Cadburies/SisuAssistant/MarineBoard/PCBWay Requirements.png

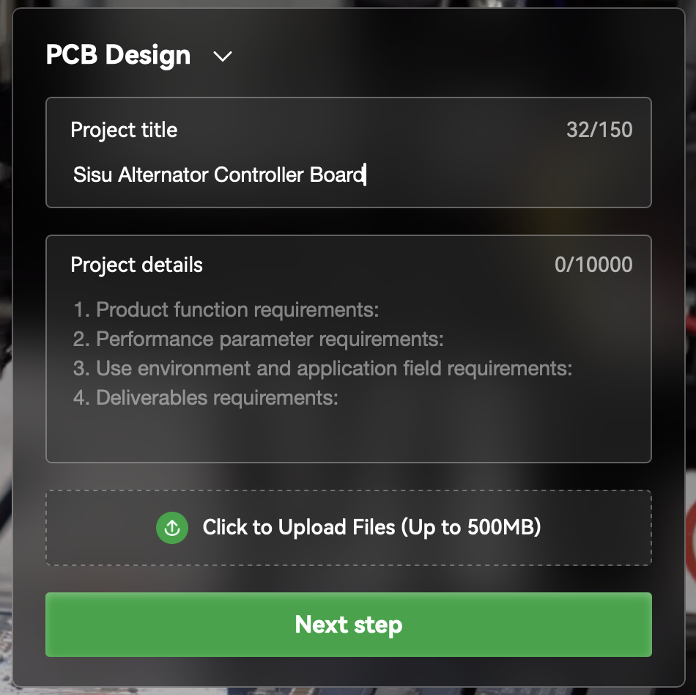
MarineBoard/PCBWay Requirements.png
