Cadburies/SisuAssistant/MarineBoard/Documentation/Freezer/Freezer Model.jpeg

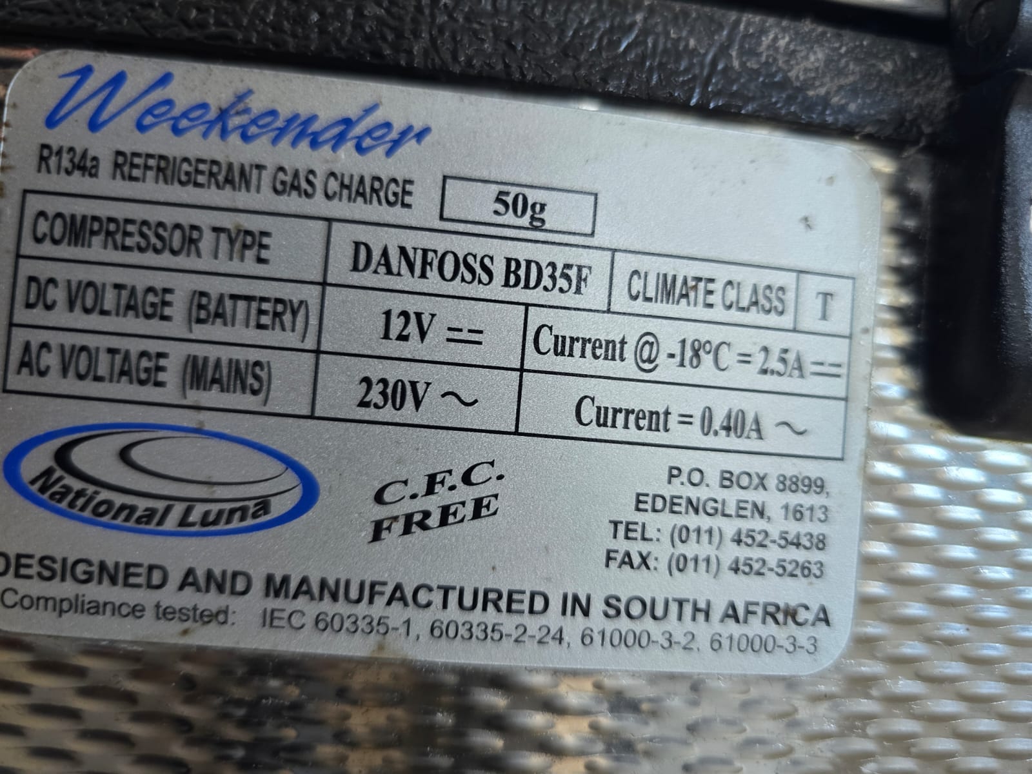
MarineBoard/Documentation/Freezer/Freezer Model.jpeg
