Cadburies/SisuAssistant/sisu-nav/web/src/plugins/ensemble/README.md

# Ensemble plugin — issue #91

ECMWF IFS ENS spaghetti (`ens-ecmwf`) from Open-Meteo Ensemble API, `cell_selection=sea`. Glob-loaded (`slot: panel`). Visibility is the Layers button. Do not edit `App.tsx`.

Clustered default = control + 10 members; Deep = all 51. `ens-aifs` / `ens-gefs` stay grey until #92 / #93.

Internet weather (tier 4), not a twin of instrument TWD.
