Cadburies/SisuAssistant/sisu-nav/web/src/plugins/weather/README.md

# Weather plugin — issue #77

Multi-model Open-Meteo overlay + agreement heatmap. Glob-loaded (`slot: panel`). Visibility is the #85 Layers button (`wx-wind` / `wx-discrepancy` / `wx-particles`). Do not edit `App.tsx`.

Instrument TWD/TWS stay on the windex. This overlay is internet weather (source tier 4).
