Cadburies/SisuAssistant/sisu-nav/web/src/plugins/route/README.md

# Route plugin — issue #78

Isochrone routing with three named modes (ETA / multi-model agreement / ensemble agreement). Glob-loaded (`slot: panel`). Do not edit `App.tsx`.

API: `sisu-nav/api/route`. Polar: `sisu-nav/polar/`. Advisory only.
