Cadburies/SisuAssistant/Technical Specifications.md

# Sisu Marine Automation System — Technical Specifications

**Version:** 2.23  
**Date:** November 2026  
**Status:** Marine Board + HA Green + TerraMaster F8 (live, #6) + Wi‑Fi 7 topology; Sisu Nav at `:8088`, Follow me on `:8443` (#188)  

Vessel **Sisu**: electrical management (dual alternators), tank levels, freezer control, helm N2K instruments, and marine data aggregation via Home Assistant, MQTT, and Signal K.

For fast-changing implementation detail (control-loop constants, current entity list, live setpoints) this file points at the source of truth rather than re-describing it — the source file is authoritative if the two ever disagree.

| Document | Authority |
|---|---|
| **[`NETWORK.md`](NETWORK.md)** | **GL.iNet GL-BE9300** actions, SSIDs, HA Green, F8, routing, secrets, Grafana, helm |
| **[`MarineBoard/`](MarineBoard/)** folder — **[`Technical Specs.md`](MarineBoard/Technical%20Specs.md)** | PCB GPIO, power, connectors; KiCad hardware project |
| **[`MarineBoard/Documentation/Freezer-Replacement-Plan.md`](MarineBoard/Documentation/Freezer-Replacement-Plan.md)** | Weekender freezer: Danfoss 101N0500 stays, Marine Board replaces the failed panel. Firmware #221 is full speed or stop. Eco is later hardware |
| **[`.ai_context/naming.md`](.ai_context/naming.md)** | Entity / SK / N2K naming |
| **[`.ai_context/safety.md`](.ai_context/safety.md)** | Live hard fail-safes, cascaded control loop description, current soft-default table |
| **This file** | System roles, firmware, safety, functional integration |

---

## 1. System Overview

```
Phones on SSID "Sisu" (Wi‑Fi 7)
        │  browser → HA (no need to join Sisu-IoT)
        ▼
┌──────────────────┐   Ethernet    ┌─────────────────────────┐
│ HA Green         │◄─────────────►│ TerraMaster F8 SSD Plus │
│ 192.168.0.20     │               │ 192.168.0.21            │
│ Home Assistant   │               │ Signal K · Grafana      │
│ MQTT kernel      │               │ InfluxDB                │
└────────┬─────────┘               └────────────┬────────────┘
         │ API → 192.168.10.0/24                │ MQTT subscribe
         ▼                                      ▼
┌──────────────────┐                    SK / KIP / trends
│ ESP32 Sisu-IoT   │
│ .41 alt port     │── N2K ──► Raymarine · Veratron OL43 (helm)
│ .42 alt stbd     │
│ .43 levels       │
│ .44 freezer      │
│ .47 freezer disp │
└──────────────────┘
```

F8 commissioned and live (2026-09-16, #6) — Signal K / Grafana / Influx run there (`OPS.md` §7). MQTT kernel stays on HA Green (`core_mosquitto` + `logins:`).

| Function | Hardware | Firmware / notes |
|---|---|---|
| Alternator Port / Starboard | **Sisu Marine Board** (ESP32-S3-WROOM-2-N32R16V) | `alternatorport.yaml` / `alternatorstarboard.yaml` + packages |
| Fresh water levels | **Sisu Marine Board** | `waterlevels.yaml` (INA226 + house VBus) |
| Freezer / fridge | **Marine Board** v1.9.1 (control, pending; manual until fitted) + **LilyGo S3 AMOLED** (display) | `freezer_marineboard.yaml` + `freezer_display.yaml` |
| Home automation + MQTT kernel | **Home Assistant Green** (Ethernet) | HA Core + official `core_mosquitto` (`logins:`) |
| Signal K + graphs | **TerraMaster F8 SSD Plus** (Ethernet, Docker) | See `NETWORK.md` |
| Helm engine/fuel gauges | **Veratron OL43** (or class) on **NMEA 2000** | Not ESP web UI; see `NETWORK.md` §7 |

Marine Board is an **I/O + control node**. Helm glass is **N2K**. Phone UI is **HA on SSID Sisu** with router bridging to Sisu-IoT.

---

## 2. System Requirements

### 2.1 Hardware

#### Microcontrollers / boards

| Role | Platform | Notes |
|---|---|---|
| Alternator + levels | **Sisu Marine Board** — **ESP32-S3-WROOM-2-N32R16V** | 32 MB octal flash, 16 MB octal PSRAM; one board per engine room preferred for alts. Production spin **v1.9.1** (pending); the **v1.00 prototype** was retired after U3 failed — errata (see [MarineBoard/Technical Specs.md](MarineBoard/Technical%20Specs.md) §v1.00 prototype) |
| Freezer / fridge | **Marine Board** (v1.9.1, pending) | DS18B20 on TMP1, compressor on Relay1 NC (full speed or stop, #221), Flash button; screen = LilyGo S3 AMOLED over ESP-NOW |

#### Power and charging plant

- **Victron LiFePO4** 12 V battery bank (BMS NG)
- **Leece-Neville** 12 V ~320 A alternators (Port and Starboard)
- Field excitation driven by Marine Board **PWM1** (GPIO38 → opto → MCP1407 gate driver → MOSFET Q4) — **no MDDS60**

#### Sensors and I/O (Marine Board roles)

| Use | Path on Marine Board |
|-----|---|
| House-bank VBus (every Marine Board node) + alt current | INA226 **U2 @ 0x40** VBus always; **400 A / 75 mV** shunt on alt boards (Kelvin) |
| Tank / level loops (×2) | INA226 **U18 @ 0x41**, **U19 @ 0x45**, 4–20 mA, 3.9 Ω sense, +12 V loop |
| Alternator temperature | DS18B20 on **TMP1 / GPIO15** (1-Wire) |
| Enable (field allow) | Opto **ENBL / GPIO8** |
| RPM (optional) | Opto **RPM / GPIO4** |
| Status | LED **GPIO1**, buzzer **GPIO2** (helpers in `marine_board_base.yaml`) |
| CAN (future N2K / engine) | SN65HVD230, **GPIO43 TX / GPIO44 RX**, 250 kbps |

#### Freezer (Marine Board controller + LilyGo S3 AMOLED display)

- Controller: Marine Board v1.9.1 (pending; the freezer runs on its own thermostat until fitted) — DS18B20 on TMP1, compressor via Relay1, thermostat local (`freezer_marineboard.yaml`)
- Display: LilyGo S3 AMOLED, quad SPI AMOLED + CST816 touch, no I/O (`freezer_display.yaml`)
- Display ↔ controller through the HA API; HA down = display blank, fridge keeps running

#### Communication backbone

Full topology: **`NETWORK.md`**.

- **Sisu-IoT** (2.4 GHz, internet OK): all ESP32s  
- **Sisu** (Wi‑Fi 7 clients): phones/laptops → browser to HA **without** joining IoT SSID (router must route Sisu ↔ LAN ↔ Sisu-IoT)  
- **Sisu-Guest**: isolated  
- HA Green + F8: **Ethernet** to Wi‑Fi 7 router  
- HA API to ESPs; MQTT kernel on HA Green (`core_mosquitto` + `logins:`) → Signal K on F8  
- NMEA 2000 / SeaTalkNG: helm (Veratron), Raymarine; alts/engine gateway paths per `NETWORK.md`

### 2.2 Software

- ESPHome (firmware)
- Home Assistant
- Signal K + plugins (MQTT sensors; optional KIP)
- Official HA Mosquitto add-on (`core_mosquitto` + `logins:` for SK/ingest)
- Docker Compose on F8: Signal K, Influx, Grafana, Sisu Nav (not the kernel broker)
- **Sisu Nav** (`sisu-nav/` `:8088` on F8, Follow me on `:8443`): chart + AIS + windex (#76), weather overlay (#77), isochrone routing (#78), dated tile harvest (#80). Notes = **#79**. Not an HA dashboard and not a Signal K plugin. Live data is browser → SK WebSocket. Own doc set: [`sisu-nav/INSTALLATION.md`](sisu-nav/INSTALLATION.md) / [`USER_GUIDE.md`](sisu-nav/USER_GUIDE.md) / [`DEVELOPER.md`](sisu-nav/DEVELOPER.md) — point there rather than re-describing plugin/API detail here.

---

## 3. Functional Specifications

### 3.1 Alternator control (Marine Board)

**Cascaded control, not one PID loop**: an outer voltage PI (absorption/float target → requested current) feeds an inner current PI (requested current → field PWM), each with conditional-integration + back-calculation anti-windup and field slew-rate limiting. Full logic and current constants: `packages/marine_alternator.yaml` (authoritative); invariants summary: `.ai_context/safety.md`. How to step-test and retune those gains (do not replace the law): [`homeassistant/docs/ALTERNATOR_TUNING.md`](homeassistant/docs/ALTERNATOR_TUNING.md).

- **Charge stages** (VBus = INA226 U2 bus voltage): `bulk` (full current, VBus < float) → `absorption` (linear amp taper toward tail current) → `float` (actively regulates float voltage, does not just terminate) → `off`. Renamed from an earlier `charged` terminal stage — float now actively holds voltage rather than stopping.
- **Hard VBus ceiling**: **14.4 V** (Victron LiFePO4 max) — field off if exceeded, **latched** (see below)
- **Temperature**: DS18B20; continuous linear current-ceiling derate approaching the hard ceiling (not a step); hard trip **&gt; 125 °C**, latched
- **Overcurrent hard trip**: **&gt; 250 A**, checked on both the smoothed value and a fast/near-instant value (sub-second trip path, issue #15) — rated nameplate **320 A** is gauge scale max only, not the clamp
- **Dual-alt shared house current** (issues #16/#62): request clamp so Port+Stbd stay within operator `house_i_budget` (default **300 A** combined → **150 A** per side while the peer board is present). Single-alt (peer offline) uses the full per-alt path. Not a new hard field-cut — policy: `homeassistant/docs/ALTERNATOR_LIMITS.md`
- **RPM / engine-run gate** (issue #13): field forced off with a **non-latching** warning if RPM ≤ setpoint while enabled (belt off / stalled) — self-clears once RPM returns, distinct from the hard faults below
- **Hard faults latch** (issue #14): sensor stale/invalid, or any hard ceiling trip → field stays at 0 even after the condition clears on its own; clears only on an ENBL false→true cycle or the `clear_fault_btn` HA button
- **ENBL gate**: field PWM forced off when enable input is inactive. **Shadow** switch defaults ON and also forces field to 0 (measure-only vs eMax).
- **BMS NG mirror setpoints**: 4 HA numbers (`house_v_charged`, `bms_bank_ah`, `bms_tail_i_pct`, `bms_charged_detect_s`) that must be kept matched to the real Victron BMS NG's own settings — operator-configured, not firmware constants; see `.ai_context/safety.md`
- **Status**: LED patterns + buzzer; warning vs hard-fault use different pitches (`marine_board_base.yaml` helpers). Diagnostics: `fault_trip_count_sensor` / `fault_latched_sensor`
- **Data**: HA entities; HA automation republishes JSON to MQTT for Signal K (port + starboard, MQTT integration wired issue #20)
- **3-layer limits (scale / hard / user SP):** `homeassistant/docs/ALTERNATOR_LIMITS.md`

### 3.2 Hard safety constants (firmware)

Named in `packages/marine_alternator.yaml` control loop — do not raise without electrical review.
**Hard ≠ scale max.** Gauge scale may show 320 A / 14.7 V / 150 °C; clamps use the table below. Full current fail-safe table (NaN, stale sensor, reverse current, RPM gate): `.ai_context/safety.md`.

| Constant | Value | Action |
|---|---|---|
| `CURRENT_HARD_CEILING` / `ALT_I_CEIL` | **250 A** | PWM → 0, latched |
| `TEMP_HARD_CEILING` / `ALT_T_CEIL` | **125 °C** | PWM → 0, latched |
| `VBUS_HARD_CEILING` / `HOUSE_V_CEIL` | **14.4 V** | PWM → 0, latched |

Soft bands: temp hysteresis ±2 °C; voltage band around absorption; stage re-bulk hysteresis below float.

### 3.3 Control algorithm (summary)

| Item | Spec |
|---|---|
| Control structure | Cascaded PI: outer voltage PI → inner current PI, conditional-integration anti-windup, field slew-rate limit |
| Control loop | 1 Hz |
| Field PWM | LEDC **GPIO38**, ~**4 kHz** (opto bandwidth), duty 0–1 |
| LED / status loop | 50 ms |
| Sensor update | ~1–2 s (INA226, DS18B20); fast/near-instant path additionally for overcurrent (#15) |

Exact gains/constants change as the loop is tuned — `packages/marine_alternator.yaml` is authoritative, not this table.

### 3.4 Tank levels (Marine Board)

- Two **4–20 mA** loops (SW-LT100 class or equivalent), +12 V loop supply
- Measurement: INA226 **U18 @ 0x41**, **U19 @ 0x45** → loop mA → tank % (4 mA = 0%, 20 mA = 100%)
- **House Bank Voltage Levels** from **U2 INA226 @ 0x40 VBus** (policy: all Marine Board firmware reports local house voltage for drop diagnostics)
- Firmware: `homeassistant/esphome/waterlevels.yaml`

### 3.5 Freezer / fridge (Marine Board controller + LilyGo display)

- **Controller:** Marine Board v1.9.1 (pending; freezer manual until fitted), `freezer_marineboard.yaml` (device `freezer`, `.44`, same name/IP/entities as the old LilyGo build). Thermostat, probe-missing guard and compressor relay run locally. Flash button: click = COOL/OFF, double-click = freeze/fridge
- **Display:** LilyGo S3 AMOLED, `freezer_display.yaml` (`.47`). Draws temperature, setpoint, mode, compressor, voltage, protection, and the Danfoss fault code from ESP-NOW. Touch sets the setpoint, COOL/OFF, freeze/fridge, and Low/Med/High. If ESP-NOW has been quiet for about 10 seconds and the API is up, the screen uses HA. Otherwise it shows **NO LINK**
- The old combined LilyGo build is retired (`esphome/archive/freezer.yaml`) — never flash it
- Weekender panel replacement (Danfoss BD35F / 101N0500) is **[`MarineBoard/Documentation/Freezer-Replacement-Plan.md`](MarineBoard/Documentation/Freezer-Replacement-Plan.md)**. Firmware #221 matches it for full speed or stop: GPIO7 high opens U12 NC and stops, GPIO7 low runs at 3,500 rpm through 1,523 Ω. Eco is not in this firmware. Wire the Danfoss loop to NC only after this build is flashed. An older image drives the NO contact to run

---

## 4. Software Architecture

### 4.1 ESPHome layout

| File | Role |
|---|---|
| `esphome/packages/marine_board_base.yaml` | Shared Wi‑Fi, I²C, LED, buzzer helpers (`buzz_on` / `sys_buzz`) |
| `esphome/packages/marine_alternator.yaml` | Alternator PID, charge, setpoints |
| `esphome/alternatorport.yaml` / `starboard` | Entrypoints (substitutions + packages) |
| `esphome/waterlevels.yaml` | Levels entrypoint + tank sensors |
| `esphome/freezer_marineboard.yaml` | Freezer controller on Marine Board (`marine_board_base` package) |
| `esphome/freezer_display.yaml` | Freezer display on LilyGo S3 AMOLED (HA mirrors, no I/O) |
| `MarineBoard/Technical Specs.md` | PCB GPIO, power, connectors, CN4 display header, fab |

Alternator base uses **esp-idf**, I²C **GPIO40/41**, INA226 @ **0x40**, one-wire **GPIO15**, PWM **GPIO38**.

### 4.2 Home Assistant

- `configuration.yaml` includes automations / scripts / scenes
- `automations.yaml`: MQTT republish of alternator metrics (port entities → `signalk/electrical/alternators/port`; starboard parity outstanding)
- Secrets: `homeassistant/secrets.yaml` (ESPHome symlink)

### 4.3 Signal K

- Ingest via MQTT topics under `signalk/…` (plugin map in `homeassistant/signalk/plugin-config-data/`)
- Temperature in JSON payload: **Kelvin** (HA/device °C + 273.15 in automation)

### 4.4 Validation

- ESPHome compile / config check per device YAML
- I²C scan: expect **0x40** (battery); **0x41 / 0x45** when levels populated
- Shadow ON until I/V/T check out; then field wire + Shadow OFF (`INSTALLATION.md` §6.4)
- Live: hard cutoffs, ENBL, charge stage, WiFi RSSI diagnostic

---

## 5. Interface Specifications

### 5.1 Alternator MQTT (via HA automation)

**Topics:** `signalk/electrical/alternators/{port|starboard}`  
**Keys (camelCase):** see `.ai_context/naming.md` §10

```json
{
  "current": 0.0,
  "voltage": 0.0,
  "temperature": 0.0,
  "pwmRatio": 0.0,
  "chargeStage": "bulk",
  "currentSetpoint": 150.0,
  "temperatureSetpoint": 0.0,
  "status": "",
  "location": "port"
}
```

`temperature*` in **Kelvin** on the bus.  
House voltage SK: `electrical.batteries.house.voltage.{port|starboard|saloon}`.

### 5.2 Primary HA entities (device-scoped names)

| Type | HA name (on Alternator Port / Starboard device) | ESPHome id |
|---|---|---|
| Sensor | House Voltage | `house_v` |
| Sensor | Alternator Current | `alt_i` |
| Sensor | Alternator Temperature | `alt_t` |
| Sensor | Alternator Field Duty | `alt_field` |
| Sensor | Alternator Charge Stage | `alt_stage` |
| Number | House Float Voltage | `house_v_float` |
| Number | House Absorption Voltage | `house_v_abs` |
| Number | Alternator Current Setpoint | `alt_i_sp` |
| Number | Alternator Temperature Setpoint | `alt_t_sp` |
| Binary | Alternator Enable | `enbl` |
| Text | Alternator Status | `alt_msg` |

Levels device: **House Voltage**, **Fresh Water · Aft**, **Fresh Water · Fwd**.

### 5.3 Marine Board field connectors (summary)

Full table: **MarineBoard** HEADER PINS / Technical Specs.

| Connector | Typical use (alts / levels) |
|---|---|
| CN1 | +12 V battery in |
| CN2 | PWM field / load + +12 V |
| U4 | Shunt sense SH± |
| U5 / U6 | Level loops LVL1 / LVL2 |
| U7 | CAN H/L/GND |
| U13 | ENBL, RPM, TMP1 |
| CN3 | I²C Qwiic expansion |
| CN4 | Optional SPI display header (vertical JST-GH 10P, top side; not base alt firmware) |

---

## 6. Safety and Reliability

### 6.1 Electrical safety (alternator)

- Fail-safe: invalid sensors → field off
- Hard ceilings: current, temp, **VBus 14.4 V** (named constants in firmware)
- Charge regulation never targets above **Absorption** (capped at 14.4 V)
- Opto isolation on ENBL / RPM; ESD on sensor paths
- Test mode simulates current and bypasses ENBL — production must disable

### 6.2 Marine environment

- Engine-room install: metal RF; plan Wi-Fi AP placement or accept local PID with flaky telemetry
- IP65+ enclosures recommended for exposed nodes. The Marine Board has its own printed PA12 box with IP67 panel connectors and a silicone-cord seal: [`MarineBoard/Technical Specs.md`](MarineBoard/Technical%20Specs.md) → *Enclosure*
- Shunt: twisted Kelvin pair only

### 6.3 Software reliability

- Setpoints `restore_value` across reboot
- Fallback Wi-Fi AP per device
- OTA via ESPHome; USB-C on Marine Board for brick recovery

---

## 7. Performance

| Item | Spec |
|---|---|
| Control loop | 1 Hz |
| Field PWM | ~4 kHz, GPIO38 |
| Current (shunt + INA226) | Design for ±1 A class resolution; calibrate on vessel |
| Voltage (VBus) | 0.01 V class display; hard trip 14.4 V |
| Temperature | DS18B20 ~0.1 °C resolution |

---

## 8. Configuration Management

### 8.1 Repository layout (relevant)

```
SisuAssistant/
  Technical Specifications.md          ← this file (system)
  MarineBoard/Technical Specs.md  ← PCB / GPIO
  homeassistant/
    esphome/alternatorport.yaml / alternatorstarboard.yaml
    esphome/packages/marine_*.yaml
    esphome/freezer_marineboard.yaml   ← freezer controller (Marine Board)
    esphome/freezer_display.yaml       ← freezer display (LilyGo AMOLED)
    esphome/waterlevels.yaml           ← legacy; migrate to Marine Board
    automations.yaml
    docker-compose.yml
    secrets.yaml
  sisu-nav/                            ← chart + AIS + windex (#76); :8088
  .ai_context/                         ← agent memory (INDEX, safety, …)
```

### 8.2 Secrets

- Prefer `!secret` / `secrets.yaml`; do not expand new plaintext keys in device YAML

---

## 9. Deployment Roles (summary)

| Location | Hardware | Function |
|---|---|---|
| Nav station / locker (dry) | **HA Green** | Home Assistant |
| Nav station / locker (dry) | **TerraMaster F8 SSD Plus** (`OPS.md` §7) | Signal K, Grafana/Influx, Sisu Nav `:8088`, backups (MQTT kernel stays on Green) |
| Engine Port | Marine Board | Alternator Port PID + charge; N2K later |
| Engine Starboard | Marine Board | Alternator Starboard PID + charge |
| Saloon / tanks | Marine Board | Levels + house voltage sense |
| Aft cockpit | **Marine Board** + LilyGo S3 AMOLED display | Fridge/freezer |
| Helm | **Veratron OL43** (planned) | Daylight N2K gauges (engine, fuel) |

Infrastructure detail: **`NETWORK.md`**.

---

## 10. Compliance and Standards (intent)

- Marine electrical practice: ABYC E-11 / ISO 10133 oriented
- NMEA 2000 / ISO 11898 CAN on Marine Board when gateway enabled
- MQTT 3.x; HA / ESPHome current stable

---

## 11. Reference Documents

| Document | Content |
|---|---|
| **[`MarineBoard/`](MarineBoard/)** folder | KiCad hardware project — schematic, PCB, BOM, backups |
| **[`MarineBoard/Technical Specs.md`](MarineBoard/Technical%20Specs.md)** | PCB power, GPIO map, connectors, CN4 display header, INA addresses, mechanical/fab (83.0 × 67.5 mm, 4-layer, ENIG) |
| **[`MarineBoard/Documentation/`](MarineBoard/Documentation/)** | Schematic-section PNG exports (ESP32, HEADER PINS, CAN, PWM, …) |
| [`homeassistant/esphome/packages/marine_alternator.yaml`](homeassistant/esphome/packages/marine_alternator.yaml) | Live alternator safety + charge logic (authoritative) |
| [`homeassistant/esphome/freezer_marineboard.yaml`](homeassistant/esphome/freezer_marineboard.yaml) | Freezer controller (Marine Board) |
| [`homeassistant/esphome/freezer_display.yaml`](homeassistant/esphome/freezer_display.yaml) | Freezer display (LilyGo) |
| [`homeassistant/automations.yaml`](homeassistant/automations.yaml) | MQTT → Signal K bridge |
| [`.ai_context/safety.md`](.ai_context/safety.md) | Agent-facing hard limits, current cascaded-loop summary |
| [`.ai_context/data_flow.md`](.ai_context/data_flow.md) | Engine N2K data (issue #25), Victron GX MQTT (issue #27) |
| [`OPS.md`](OPS.md) §7 | Interim Mac-hosted Signal K/Grafana/Influx; kernel Mosquitto on Green |
| Victron LiFePO4 / BMS NG docs | Charge voltages, tail current / 100% sync |
| Leece-Neville alternator data | Hardware ratings |

### Explicitly obsolete for alternator path

- LilyGo T7 as primary alternator controller  
- ADS1115 as primary alt current/voltage path  
- Cytron **MDDS60** as field driver  
- Single “voltage setpoint 14.4 only” without float/absorption stages  

---

## 12. Revision History

| Ver | Date | Notes |
|-----|---|---|
| 1.x | 2025 | Initial: LilyGo T7 + ADS1115 + MDDS60 |
| **2.0** | **Jul 2026** | Marine Board for alts + levels; Victron charge stages; freezer LilyGo AMOLED |
| **2.1** | **Jul 2026** | HA Green + F8 topology; Wi‑Fi 7 / Sisu-IoT routing; Veratron helm; Grafana/Influx — see **`NETWORK.md`** |
| **2.2** | **Aug 2026** | Cascaded voltage/current PI control (was single current PID); latched hard faults + RPM/engine-run gate; fast overcurrent trip path; BMS NG mirror setpoints; MQTT integration wired end-to-end; F8 stack interim-hosted on a Mac (`OPS.md` §7) pending hardware; engine N2K data + Victron GX MQTT (issues #25/#27); fixed `MarineBoard/` folder references (were pointing at a nonexistent `MarineBoardSpecs/` path) |
| **2.11** | **Sep 2026** | F8 hardware commissioned and live (#6) — Signal K, Grafana, Influx, Sisu Nav migrated off the interim Mac stack; NMEA confirmed flowing from real YDWG/DataHub gateways |
| **2.12** | **Sep 2026** | Buzzer usage: `buzz_on` / `sys_buzz` in `marine_board_base.yaml`; warning vs hard-fault use different pitches |
| **2.13** | **Sep 2026** | F8 is the live SK/Grafana/Influx/Sisu Nav host (#6); Mac compose is rollback only |
| **2.16** | **Sep 2026** | Freezer role → Marine Board (`freezer_marineboard.yaml`, LilyGo interim); RGB status LED on all Marine Board devices (#180) |
| **2.15** | **Sep 2026** | Marine Board v1.9 spin: RGB status LED (WS2812B-2020 on GPIO1), display header U10 → CN4 vertical JST-GH on the top side, Sisu logo on silk, fab package rebuilt by `MarineBoard/fab_package.py` (#179) — detail in `MarineBoard/Technical Specs.md` v1.9 |
| **2.14** | **Sep 2026** | Marine Board routed for PCBWay: 83.0 × 67.5 mm 4-layer, J3/J2 replaced by U10 SPI display header, F1 2 A / F3 10 A / F4 10 A relay fuse (#178) — detail in `MarineBoard/Technical Specs.md` v1.8 |
| **2.3** | **Aug 2026** | MQTT kernel on HA Green (`core_mosquitto` + `logins:`); F8/Mac keep SK/Grafana/Influx (#51) |
| **2.4** | **Aug 2026** | Dual-alt shared house-current budget (#16) — pointer only; policy in `ALTERNATOR_LIMITS.md` |
| **2.5** | **Aug 2026** | Dual-alt budget default 300 A combined / 150 A per side (#62) |
| **2.6** | **Aug 2026** | Pointer to `docs/ALTERNATOR_TUNING.md` — how to step-test/retune cascaded PI; do not replace the law (#71) |
| **2.7** | **Aug 2026** | Shadow measure-only commission; lab sim/HIL and `test_mode` removed (#73) |
| **2.8** | **Sep 2026** | Sisu Nav planned (`sisu-nav/`, issues #76–#80) |
| **2.9** | **Sep 2026** | Sisu Nav Phase 1 (#76): chart + AIS + windex at `:8088` on the F8/Mac compose |
| **2.10** | **Sep 2026** | Sisu Nav own doc set added — `sisu-nav/INSTALLATION.md` / `USER_GUIDE.md` / `DEVELOPER.md` (#112–#114) |
| **2.17** | **Oct 2026** | Sisu Nav Follow me listens on `:8443` (#188). Detail in `sisu-nav/INSTALLATION.md`. |
| **2.18** | **Oct 2026** | Marine Board enclosure: printed PA12 box, IP67 panel connectors (#194). Detail in `MarineBoard/Technical Specs.md`. |
| **2.19** | **Oct 2026** | Marine Board **v1.00** recorded as the prototype aboard; production spin is v1.9.1 (#216). Errata in `MarineBoard/Technical Specs.md`. |
| **2.20** | **Oct 2026** | Freezer split (#217): Marine Board v1.00 controls (`freezer_marineboard.yaml`), LilyGo S3 AMOLED is display only (`freezer_display.yaml`, `.47`) via HA; combined `freezer.yaml` archived. |
| **2.21** | **Oct 2026** | v1.00 prototype retired after U3 failed (#218). Freezer runs manually until a v1.9.1 Marine Board is fitted; the split stays the target. |
| **2.22** | **Nov 2026** | Weekender freezer plan (#220): `MarineBoard/Documentation/Freezer-Replacement-Plan.md`. Docs point at it. Firmware unchanged (relay still energise-to-run). |
| **2.23** | **Nov 2026** | Freezer firmware #221: full speed or stop. Coil off runs at 3,500 rpm on U12 NC. LilyGo over ESP-NOW. Eco is not in this firmware. |

---

**Sisu Marine Automation — system specification.** Board detail always wins in **[`MarineBoard/Technical Specs.md`](MarineBoard/Technical%20Specs.md)**.
