Cadburies/SisuAssistant/.ai_context/INDEX.md

# INDEX — Sisu AI context

> Only file read in full every session. Keep lean. Non-derivable orientation + router only.
> Runtime contract (issue open → claim → verify → close → push): **`CLAUDE.md`** (also for Grok/Codex).

## NEXT

1. **Open backlog:** `gh issue list --state open` (skip `agent:*`; claim protocol in `CLAUDE.md`). **P1 #175: rotate the shared password + Azure key (human).** Feature Map done + wiki auto-published. Open, all human/vessel-gated: #163 (dashboard ids match area+device+name; confirm when #11/#2/#172 devices register), #165 (Spectra test aboard), #166 (Saloon button intent), #172 (devices offline).
2. **Sisu Nav:** live on F8 `:8088`, Follow me on `https://192.168.0.21:8443` (**#188**). Navionics layers convert in `sisu-nav/api/harvest/navionics.mjs` (**#225**): `lsc/` `.lsd` → Live Sonar PNGs; `T08/` `.nv2`, `T32/` `.s57`, and `MBM/` `.nv2` recorded with no picture. **#187** anchor roses sync as the boat's SisuMate login (no service role, one boat so no `sisu_boat_id`). `GET /api/roses/anchor-spots` status has `boatId`, `lastSyncAt`, `lastSyncError`. SisuMate reads those tables; it does not write them except `wind_rose_uploads`.
3. **Hardware on hand:** saloon display `.45` (live). **No Marine Board aboard:** the v1.00 prototype was retired after U3 burnt (#218). Freezer runs manually. Firmware #221 is full speed or stop (coil off = 3,500 rpm on U12 NC). Eco is later hardware. Do not OTA, and do not flash `archive/freezer.yaml`. NC wiring is for a board flashed with #221. Alt shadow **#11** waits for the v1.9.1 boards. No T8 lab board. GPIO mapping: `bench_marine_board.yaml`. Then **#2** tank cal → **#8** Spectra 95% when a levels board exists.
4. **#6** F8 live — SK/Grafana/Influx/Sisu Nav on `192.168.0.21` (`OPS.md` §7). `docker-compose.mac.yml` is rollback only.
5. Parked / not agent-doable: **#9** Spectra soak, **#19** Alert pin (needs HW rev), **#34** load cell in transit. RPM pulse bench check (from #26) → **#11** commissioning.
6. **#68/#69** still open (Sources split, dep #11). Closed recently: chart coverage **#191**, SK auto-login **#190**, chart bands **#189**, Follow me HTTPS **#188**, zone folders **#186**, chart picker **#185**, Helm ETA **#138**, saloon **#135/#136**, Layers **#87/#92/#93/#119/#120/#121/#125**.

**Rule:** update NEXT before ending a session (≤6 lines). History = `git log` + closed GitHub issues only.

## Product

| Function | Hardware |
|---|---|
| Alternators / levels | **Sisu Marine Board** (ESP32-S3-WROOM-2-N32R16V) on **Sisu-IoT** — production spin v1.9.1 (pending); v1.00 prototype retired (`MarineBoard/v1.00/`) |
| Lab connectivity (optional) | **LilyGo T8-S3** `bench_t8s3` |
| Freezer | Manual until fitted. Control: **Marine Board v1.9.1** (`freezer_marineboard.yaml`, `.44`, full speed or stop, #221); display: **LilyGo S3 AMOLED** (`freezer_display.yaml`, `.47`, ESP-NOW, HA is a client on the boat) |
| Saloon guest display | **Waveshare ESP32-S3-Touch-LCD-4.3B** @ **.45** on **Sisu-IoT** (#63) |
| Watermaker | **Spectra Newport 400c** @ **192.168.0.25** (WS bridge) |
| HA + MQTT kernel (`sisu/v1`) | **HA Green** Ethernet **.20** (`core_mosquitto` + `logins:`) |
| SK / Grafana / Influx | **TerraMaster F8** Ethernet **.21** (live, #6) |
| Helm gauges (planned) | **Veratron OL43** N2K |
| Chart / AIS / windex | **Sisu Nav** Docker on F8 — `sisu-nav/` `:8088` (#76 floor) |

TZ `America/Tortola`. Full network: **`NETWORK.md`**.  
**Limits policy:** `homeassistant/docs/ALTERNATOR_LIMITS.md`.

## Stack

ESP (Sisu-IoT) → HA Green (API + official Mosquitto `sisu/v1`) → Signal K on F8; Influx/Grafana on F8.  
Humans on **Sisu** (Wi‑Fi 7) browse HA without joining IoT SSID (router bridges).  
Spectra is LAN-side on Sisu (`.25`), not IoT ESP.

## Layout map

| Path | Role |
|---|---|
| `homeassistant/configuration.yaml` | HA entry; Lovelace dashboards + `resource_mode: yaml` |
| `homeassistant/ui-lovelace.yaml` | Vessel **Sisu** board (zones + live tiles) |
| `homeassistant/dashboards/*.yaml` | Engine, Alternators, Power, Water, Helm, Weather TWD |
| `homeassistant/automations.yaml` | MQTT republish of alternator metrics |
| `homeassistant/packages/spectra_newport.yaml` | Spectra bridge entities / autorun / auto-stop |
| `homeassistant/python_scripts/spectra_ws.py` | Spectra WebSocket client |
| `homeassistant/packages/source_health.yaml` | Source chips + canonical `sensor.nmea_*` from `sisu/v1` |
| `homeassistant/nmea_wind_daemon/nmea_wind_daemon.py` | Kernel ingest (YDWG+DataHub → `sisu/v1`) |
| `homeassistant/addons/sisu_nmea_ingest/` | Local Supervisor add-on (#57); slug `local_sisu_nmea_ingest` |
| `scripts/ha-kernel-mqtt.sh` | Recreate Green `core_mosquitto` `logins:` + local ingest add-on |
| `homeassistant/python_scripts/nmea_gateways.py` | Shared NMEA 0183 parse (bind-mounted into ingest) |
| `homeassistant/signalk/settings.json` | SK providers incl. YDWG + DataHub TCP |
| `homeassistant/packages/signalk_course.yaml` | Helm route ETA from the Signal K course API (#138) |
| `homeassistant/python_scripts/signalk_course.py` | Poll for that package |
| `homeassistant/docs/ALTERNATOR_LIMITS.md` | **3-layer** scale / hard / user SP (authoritative) |
| `homeassistant/docs/ALTERNATOR_TUNING.md` | How to test/tune cascaded PI (keep the law; #71) |
| `.ai_context/sources.md` | Quantity → source priority + kernel contract (#44) |
| `homeassistant/docs/SpectraControl.md` | Spectra pages, navigation, what each page can return |
| `MarineBoard/Documentation/Spectra-Replacement-Plan.md` | Plan to replace the failing Spectra Connect with a Marine Board + I/O daughter board + own firmware: 400c I/O, limits, sensors, schematic blocks, state machine, phases (#201) |
| `MarineBoard/Documentation/Axiom-Replacement-Plan.md` | Plan for Sisu Nav to take over the Raymarine Axiom: radar via mayara + Signal K Radar API (Freeboard-SK first), 12 V edge box, sonar routes S1 screen capture / S2 own echosounder / S3 decode (#212) |
| `MarineBoard/Documentation/Freezer-Replacement-Plan.md` | Weekender replacement. Firmware #221 is full speed or stop: ESP dead = 3,500 rpm on U12 NC. Eco is later hardware. LilyGo is the only display, over ESP-NOW. HA is a client on the boat |
| `homeassistant/packages/alternator_helpers.yaml` | Combined I/P, board-online, charge summary |
| `homeassistant/packages/trending_influxdb.yaml` | HA → InfluxDB wiring (`influxdb:` integration) |
| `homeassistant/packages/marine_environment.yaml` | Tides (NOAA) + weather/temp fallback (Open-Meteo) — issue #32 |
| `homeassistant/python_scripts/tides_noaa.py` | Nearest NOAA tide station + hilo predictions |
| `homeassistant/packages/sv3c_aft_camera.yaml`, `sv3c_forward_camera.yaml` | SV3C ONVIF cameras (issue #33) — Off/On/Sentry mode, motion → photo-burst; not ESPHome devices |
| `homeassistant/grafana-provisioning/` | Grafana datasource + dashboards (git-tracked, file-provisioned) |
| `homeassistant/influx-tasks/` | Influx Flux tasks: `sisu_raw_mirror`, `sisu_1m` (#47) |
| `homeassistant/esphome/packages/marine_board_base.yaml` | Shared Marine Board package |
| `homeassistant/esphome/packages/marine_alternator.yaml` | Alternator role + hard ceilings |
| `homeassistant/esphome/alternator{port,starboard}.yaml` | Production entrypoints |
| `homeassistant/esphome/waterlevels.yaml` | Levels + house_v |
| `scripts/esphome_web_client.py` | ESPHome web_server REST client |
| `homeassistant/esphome/freezer_marineboard.yaml` | Fridge/freezer controller (Marine Board, full speed or stop) |
| `homeassistant/esphome/freezer_display.yaml` | Fridge/freezer display (LilyGo, ESP-NOW, HA fallback) |
| `homeassistant/esphome/saloon_display.yaml` | Waveshare ESP32-S3-Touch-LCD-4.3B saloon guest display (#63) |
| `scripts/ha-*.sh` / `scripts/scan_secrets.sh` | Agent deploy + secret scan |
| `INSTALLATION.md` | Full install manual |
| `OPS.md` / `NETWORK.md` | Ops + network |
| `CLAUDE.md` | Parallel agents, claim, verify, commit |
| `sisu-nav/` | Chart + AIS + windex cockpit (`:8088`) — issues **#76–#80** |
| `.ai_context/feature_map/` | Feature Map: folder tree = feature tree; one small `<feature>.md` + `<feature>.sh` per feature. Format `DESIGN.md`/`TEMPLATE.md`; grep-only, never session-load (#139 → #140–#160) |

## Read-Next (task → open)

| Task type | Open (≤2) | Source first |
|---|---|---|
| Backlog / pick next work | GitHub Issues only (`gh issue list --state open`) | issue body **Touches** |
| Issue open / claim / close cycle | `skills/do-issue/SKILL.md` + `CLAUDE.md` §Gates | — |
| Parallel agents | `CLAUDE.md` §Parallel agents | — |
| File a new issue | `skills/file-issue/SKILL.md` + `.github/ISSUE_TEMPLATE/task.md` | — |
| Alternator PID / charge / safety | `safety.md`, `risks.md` | `packages/marine_alternator.yaml` + `docs/ALTERNATOR_LIMITS.md` |
| Alternator gauges / setpoints | `safety.md` | `dashboards/alternators.yaml` |
| Levels / tanks | `safety.md` | `esphome/waterlevels.yaml` |
| Spectra / water | `sources.md`, `data_flow.md` | `spectra_ws.py`, `packages/spectra_newport.yaml`, **`docs/SpectraControl.md`** |
| Watermaker controller replacement (Spectra board failing) | **`MarineBoard/Documentation/Spectra-Replacement-Plan.md`** | [MarineBoard/Technical Specs.md](../MarineBoard/Technical%20Specs.md) (board I/O) |
| Weekender freezer panel replacement | **`MarineBoard/Documentation/Freezer-Replacement-Plan.md`** | `esphome/freezer_marineboard.yaml`, `freezer_display.yaml`, [MarineBoard/Technical Specs.md](../MarineBoard/Technical%20Specs.md) (relay, ENBL, TMP1) |
| Radar / sonar / Axiom takeover | **`MarineBoard/Documentation/Axiom-Replacement-Plan.md`** | `homeassistant/signalk/package.json`, `sisu-nav/web/src/plugins/` |
| HA dashboards / Overview | `displays.md` | `configuration.yaml`, `ui-lovelace.yaml` |
| MQTT / Signal K | `data_flow.md`, `risks.md` | `automations.yaml` |
| NMEA / YDWG / DataHub | `sources.md`, `data_flow.md` | `nmea_wind_daemon.py`, `nmea_gateways.py`, `packages/source_health.yaml` |
| New quantity / source / ingest | `sources.md` | do not invent `_live` twins |
| Network / F8 / Grafana | — | `NETWORK.md` |
| Trending / InfluxDB / Grafana dashboards | `data_flow.md` §Trending pipeline | `packages/trending_influxdb.yaml`, `grafana-provisioning/` |
| Agent access / deploy | — | `OPS.md`, `scripts/ha-*.sh` |
| Alternator shadow / PI tune | `safety.md` | `INSTALLATION.md` §6.4, `docs/ALTERNATOR_TUNING.md` |
| Secrets / git hygiene | `secrets.md` | `secrets.yaml.example`, `scripts/scan_secrets.sh` |
| Security / cyber audit (weekly, `--stale`) | **`skills/cyber-check/SKILL.md`** | `scripts/cyber-check.sh` |
| Physical install / wiring | — | **`INSTALLATION.md`** |
| Sisu Nav / weather routing / chart overlays | `displays.md` | `sisu-nav/` + issues **#76–#80** |
| Find / reach / exercise a feature | `grep -ril <word> .ai_context/feature_map` → read that one file | its `<feature>.sh` |
| Bug from backlog | matching issue + `risks.md` | paths in **Touches** |

**Never session-load:** `.ai_context/archive/*`, full long specs, `node_modules`. Open backlog = **GitHub Issues only** — never a markdown backlog under `.ai_context/`.

## Rules (≤5)

1. Session load: INDEX + ≤2 warm files + source. Never auto-load archive/changelog dumps.
2. Alternator hard cutoffs sacred (250 A / 14.4 V / 125 °C); change only with approval + update `ALTERNATOR_LIMITS.md`.
3. Entity/topic renames cascade HA → MQTT → Signal K.
4. Backlog = GitHub Issues only; claim → verify → close cycle in `CLAUDE.md`; delete resolved **risks** rows only.
5. No Tier-C mirrors. Alts+levels+fridge control = Marine Board (fridge display = LilyGo); Spectra = WS bridge. Never commit secrets.

## Warm files

| File | Contents |
|---|---|
| `risks.md` | Open cascade/gotchas only |
| `safety.md` | Electrical invariants + 3-layer limits pointer |
| `data_flow.md` | HA↔MQTT↔SK + Spectra |
| `displays.md` | Tablet paths, dual Overview |
| `secrets.md` | Secret policy (no live values) |
| `naming.md` | ESPHome / HA / SK / N2K naming |
| `sources.md` | Quantity → source priority + kernel (#44) |

Repo runtime contract (issue lifecycle): **`CLAUDE.md`**. Compact hard rules: **`AGENTS.md`**.
