Cadburies/SisuAssistant/.ai_context/data_flow.md

# Data flow synthesis (HA ↔ MQTT ↔ Signal K ↔ Spectra)

Cross-file pipeline only. No full entity inventory — grep source for names.  
**Hosts / SSIDs / F8 / Grafana:** repo root **`NETWORK.md`**.

## Device platforms

| Device | Hardware | Ingress to HA |
|---|---|---|
| Alternator Port/Starboard | **Sisu Marine Board** (prod) | HA API |
| Tank levels | **Sisu Marine Board** | HA: House Voltage + Fresh Water · Aft/Fwd (when online) |
| Freezer / fridge | **Sisu Marine Board** (LilyGo S3 AMOLED = display) | HA: Freezer Temperature / Thermostat |
| Spectra Newport 400c | Spectra controller **192.168.0.25:9000** | HA: `python_scripts/spectra_ws.py` + `packages/spectra_newport.yaml` |
| NMEA 2000 instruments | **YDWG-02** `.10.30` (primary) → **DataHub** `.10.31` (failover) | Kernel ingest → MQTT `sisu/v1`; SK subscribes via `signalk-mqtt-sensors` (#48). SK keeps YDWG TCP for AIS / oil / anything the kernel does not own; DataHub SK pipe is off. |

Naming authority: `.ai_context/naming.md`. Combined helpers: `packages/alternator_helpers.yaml`.

## Primary pipeline (alternators)

```
Marine Board ESPHome (API)
  → Home Assistant entities
  → automation: mqtt.publish JSON   [MQTT integration → HA Green :1883]
  → Mosquitto topic signalk/electrical/alternators/{side}
  → Signal K plugin signalk-mqtt-sensors
  → self.electrical.alternators.* paths
```

| Stage | Authoritative file |
|---|---|
| Device logic & entities | `packages/marine_alternator.yaml` + `alternatorport` / `starboard` |

| Republish trigger & JSON | `homeassistant/automations.yaml` |
| Broker (production) | **HA Green** official `core_mosquitto` + `logins:` (`mqtt_broker` in secrets) |
| Topic → SK path map | `homeassistant/signalk/plugin-config-data/signalk-mqtt-sensors.json` |
| SK server (production) | Docker on **F8**, live; config under `homeassistant/signalk/` |

## MQTT JSON keys (SK-friendly)

`current`, `voltage`, `temperature` (K), `pwmRatio` (0–1), `chargeStage`, `currentSetpoint`, `temperatureSetpoint` (K), `status`, `location`

## Units contract

- Device / HA temperature: **°C**
- MQTT + Signal K temperature: **Kelvin**
- Level HA **%** · SK **0–1** when mapped
- Field duty HA **%** · MQTT **pwmRatio** 0–1

## NMEA 2000 instruments (YDWG primary → DataHub failover)

```
N2K backbone
  → Yacht Devices YDWG-02  192.168.10.30  TCP NMEA0183 :1456   ★ primary
  → PredictWind DataHub    192.168.10.31  TCP NMEA0183 :11102  ★ failover
       │
       ├─ HA Green: kernel ingest (`sisu-nmea-ingest`) → MQTT `sisu/v1`
       │     → `sensor.nmea_*` + `binary_sensor.source_*` (`packages/source_health.yaml`)
       └─ Signal K (Mac / later F8): `signalk-mqtt-sensors` on Green :1883 (`logins:`).
            YDWG TCP kept for AIS/oil; DataHub SK pipe is off.
```

| Stage | Authoritative file |
|---|---|
| Kernel ingest (Green) | local add-on `sisu_nmea_ingest` (`nmea_wind_daemon.py`); recreate `scripts/ha-kernel-mqtt.sh` |
| Parser | `python_scripts/nmea_gateways.py` (bind-mounted into the ingest container) |
| HA entities | `packages/source_health.yaml` (`sensor.nmea_*`, `binary_sensor.source_*`) |
| Helm tiles | `dashboards/helm.yaml` |
| SK MQTT map | `homeassistant/signalk/plugin-config-data/signalk-mqtt-sensors.json` |
| SK leftover TCP | `homeassistant/signalk/settings.json` (`ydwg-nmea0183` on; `datahub-nmea0183` off) |
| Secrets | `mqtt_username` / `mqtt_password`; YDWG/DataHub admin URLs are not used for TCP |

Web admin passwords are **not** used for the NMEA TCP stream.

**Engine data (Yanmar 4JH45 ×2, via YDEG-04 → SeaTalkNG → YDWG-02, confirmed live 2026-08-09, issue #25):** YDWG-02's `$YD…`-wrapped NMEA0183 sentences carry full N2K PGNs (127488/127489/127508), which Signal K's NMEA0183 parser auto-unwraps — no separate raw-N2K plugin needed. Live at `propulsion.{port,starboard}.*`: `revolutions`, `temperature` (K), `oilPressure` (Pa), `alternatorVoltage`, `fuel.rate` (m³/s), `runTime` (s, engine hours), `engineLoad`, `boostPressure`; `electrical.batteries.{0,1}.voltage` (per-engine starter battery); ~24 `notifications.propulsion.{port,starboard}.*` alarm flags each (overTemperature, lowOilPressure, checkEngine, etc).  DataHub does **not** carry any of this (nav/instrument PGNs only) — YDWG-02 is the only source.

**HA-side (issue #25, built):** `signalk-mqtt-bridge` is enabled but publishes in a Victron-VenusOS-style `N/<id>/...` + keepalive protocol that did not yield propulsion data under test (plugin's own topic namespace, separate from the plain-path `signalk-mqtt-sensors` convention) — not pursued further. Went with Signal K's own REST API instead: `python_scripts/signalk_engines.py` logs in fresh each call (`SignalKUser`/`SignalKPwd`, non-expiring token observed but not cached), polls `vessels/self/propulsion` + `electrical/batteries` + `notifications/propulsion`, flattens to display units (RPM, °C, bar, L/h, % , hours). Exposed via `packages/signalk_engines.yaml` (`command_line` JSON sensor + per-field `template` sensors + per-side alarm `binary_sensor`, same pattern as `spectra_status_json`). Dashboard: `dashboards/engine.yaml` "Port Engine"/"Starboard Engine" cards, alarm-first priority order.

**Route ETA (issue #138):** Helm reads the active Signal K course (`navigation.course` + `course-provider` `calcValues`) via `python_scripts/signalk_course.py` and `packages/signalk_course.yaml`. Dashboard: `dashboards/helm.yaml`.
Only **one** logical HA source at a time (`sensor.nmea_active_source`). SK may see both feeds if both online — prefer filtering duplicates in SK UI if needed.

**Policy (issue #44):** quantity priority, kernel target, and “no twin names” live in **`.ai_context/sources.md`**. Liveness = sentences received, not TCP accept (YDWG was SYN-ACK-up and mute; HA then published `unknown` while DataHub was full). HA source chips: `binary_sensor.source_*` from `sisu/v1/meta/<src>/live` (#50, `/lovelace-sources`). One HA name per quantity: `sensor.nmea_*` from `sisu/v1` (#46).

**Pure-sailing polar data logging (issue #132):** `packages/polar_logging.yaml`. Each Yanmar 4JH45 has a YDEG-04 on SeaTalkNG; those go silent when the engine is off. `sensor.sisu_engines_state` is `motoring` if either RPM > 30, `unknown` only if the **YDWG is down** (SeaTalkNG invisible), else `sailing` (including YDEG silent). Polar sensors also require SOG or STW ≥ 1.5 kn so dock/anchor swimming is not logged. Alert on sustained `unknown` (YDWG down), not on silent YDEGs.

## Kernel ingest — YDWG + DataHub → `sisu/v1` (issues #37 / #45 / #49 / #51)

```
YDWG-02 :1456 + DataHub :11102   dual-listen; liveness = sentences, not TCP-open
  → local add-on local_sisu_nmea_ingest on HA Green (host_network, 127.0.0.1:1883, MQTT logins)
      nmea_wind_daemon.py + parse_nmea() from mapped /homeassistant/python_scripts
      per-signal merge (Y if fresh, else D); engines + air temp = YDWG only
  → MQTT sisu/v1/<domain>/<qty>  JSON {value, source, stale_s, value_si}
  → HA mqtt: one sensor.nmea_* + binary_sensor.source_* (source_health.yaml)
  → SK signalk-mqtt-sensors (value_si); Influx via canonical HA names
```

**Why a long-lived daemon** (measured 2026-08-15): the wind instrument is ~2 Hz; a 15 s `command_line` poll that keeps only the last line is blind most of the time and can miss a 1–2 s gust. Ingest samples continuously, tracks gust in memory, publishes ~1 Hz.

**Where it runs:** Supervisor local add-on `local_sisu_nmea_ingest` (`./scripts/ha-kernel-mqtt.sh`). Not a raw `docker run`, not Mac/F8 compose. Green already routes to `192.168.10.30` / `.31`. Recreate/rebuild after changing `nmea_wind_daemon.py` or MQTT secrets.

**Restart:** add-on `boot: auto` + per-socket mute reconnect (`CONNECTION_STALE_SECONDS`) + process exit if both mute (`STALE_RESTART_SECONDS`) + paho reconnect. Logs: Settings → Add-ons → Sisu NMEA ingest → Log (or `ha addons logs local_sisu_nmea_ingest`). Expect `MQTT connected` and `connected to ydwg` / `datahub`.

`expire_after: 30` on the HA mqtt sensors is deliberate: if ingest dies, entities go `unavailable` instead of freezing.

## Trending pipeline (InfluxDB / Grafana)

```
HA entities (canonical names — trending_influxdb.yaml)
  → Influx bucket Sisu          (HA UI entry write target)
  → task sisu_raw_mirror        → Sisu_raw (7d, kernel rate)
  → task sisu_1m                → Sisu_1m
  → Grafana: Sisu_raw ≤30m live; Sisu_1m ≥1h (24h heatmap, 7d roses)
```

**Weather is two dashboards, not one** — `sisu-weather.json` (uid `sisu-weather`, title "WeatherAWA") shows wind relative to the bow (apparent wind angle straight off `sensor.nmea_awa`), meant for underway/sailing use. `sisu-weather-twd.json` (uid `sisu-weather-twd`, title "WeatherTWD") shows true (compass-referenced) wind, for anchor-watch use. Both dashboards otherwise share the same wind-speed/heatmap/atmosphere panels verbatim.

**Correction, 2026-08-15 (self-heal):** WeatherTWD originally computed true wind direction as `(heading_magnetic + awa) mod 360` via a Flux join, believing this boat's NMEA feed had no TWD sentence — wrong. Sampling the raw feed found `$YDMWD` (wind direction True + Magnetic, instrument-computed) already on the wire, plus `$YDHDT` (true heading) and MWV reference "T" (`twa_deg`, true wind angle) already being *parsed* by `nmea_gateways.py` but never exposed as entities. Added parsing for MWD + wired up all three: `sensor.nmea_twd` (True Wind Direction, the one WeatherTWD's panels now query directly, no Flux join), `sensor.nmea_heading_true`, `sensor.nmea_twa`. Cross-checked internally consistent against live values (`twd_true_deg == heading_true_deg + twa_deg` to the decimal; `heading_true_deg == heading_mag_deg - magnetic_variation` from the RMC sentence's own variation field). Real TWD is motion-corrected by the instrument regardless of boat speed — WeatherTWD is no longer anchor-only-accurate, the dashboard split remains a UX choice (bow-relative vs compass-true), not a data-quality one.

**Anchor-spot roses (#187):** `sisu-nav-api` re-reads `Sisu_1m` every 15 min, keeps anchored hours + spots on the F8 (`sisu-nav/state/`, box runtime state), and mirrors them hourly to the **SisuMate** Supabase project (`anchor_rose_hours` / `anchor_spots`, boat-scoped by `accessible_boat_ids()`). Supabase is the share path to SisuMate; Influx stays the only raw source — nothing is written back to Influx.

**Wind rose panels** are Business Charts (`volkovlabs-echarts-panel` 7.2.5, `GF_PLUGINS_PREINSTALL` on the Mac compose file — #35, #36). Grafana 13 core still has no polar panel. Stacked roses join 1-minute means of a direction series + `sensor.nmea_aws_live` (TWS is not used on the rose) via Flux `union`/`pivot` + `|> group()`, then bin in the charts function: 36 petals at 10°, **length = frequency (% of samples)**, **color = kn band** (2–4.9 / 5–6.9 / 7–9.9 / 10–14.9 / 15–19.9 / 20+), `<2 kn` pulled out as center **Calm: X%**. WeatherAWA keeps one AWA+AWS rose (bow-up). WeatherTWD (#36) has four TWD+AWS roses, N-up: last-5 fading trail (petal length = that minute's AWS, newest brightest), last hour, last 24h, last 7 days. The old XY-Chart compass-dot trail is gone (replaced by the last-5 ECharts trail above — the two co-existed only in git history, not live at the same time as either the #37 wind daemon or #40 rewiring below).

Grafana / HA wind panels read canonical `sensor.nmea_*` from `sisu/v1` (#46). Do not reintroduce `*_live` twins (`nmea_wind_live.yaml` is gone).

**24h heatmap / long ranges (#47):** do not query `Sisu_raw` at 1 Hz over ≥1 h — that trips Grafana’s 1000-point cap (~86k points / 24 h). Heatmaps and ≥1 h panels read `Sisu_1m` (2 m window on the heatmap → 720 points). Short live windows stay on `Sisu_raw`.

**XY Chart panels need `"pluginVersion"` set on the panel object, or they silently crash on load** — found live 2026-08-15 debugging exactly this. Grafana's `xyChartMigrationHandler` runs a legacy-schema migration (`migrateOptions()`, reading `panel.options.seriesMapping`/old-shape `series`) whenever `pluginVersion` is missing/empty, *regardless* of whether the panel's `options` are already written in the current schema (`mapping`/`series` as `XYSeriesConfig[]`) — the migration path then does `oldSeries2.map(...)` on a value that's `undefined` in that case, throwing `Cannot read properties of undefined (reading 'map')` and leaving the panel stuck on "Loading plugin panel..." forever. No error is visible anywhere in Grafana's own UI or server logs — only in the browser's JS console (`page.on("pageerror")` via Playwright is how this got caught; there is no image-renderer plugin installed on this instance, so screenshotting requires driving a real browser, not Grafana's own render API). Fix: give every `xychart` panel `"pluginVersion": "13.1.3"` (or whatever `GET /api/health`'s `version` reports) so the handler takes the `return panel.options` branch instead. Source lives inside the running container at `/usr/share/grafana/public/app/plugins/panel/xychart/` (full `.tsx`/`.ts`, not just minified bundles) — `panelcfg.gen.ts` for the real option schema, `migrations.ts` for this exact trap, `utils.ts`/`scatter.ts` for how "auto" series-mapping and rendering actually work. Reading that source (not guessing from memory) is how the schema — `mapping` not `seriesMapping`, `XYSeriesConfig` shaped `{x:{matcher},y:{matcher},...}` — got nailed down correctly.

**XY Chart axis convention is the boring, expected one**: first numeric field in a frame → chart-horizontal, second → chart-vertical (`x`/`y` are just the Flux field names chosen here, not what determines the axis — order does). Confirmed empirically (screenshot + cropped-and-zoomed axis-label read, since uPlot draws axes on `<canvas>`, not as queryable DOM/SVG text) after a false start swapping `sin`/`cos` based on a misread rotated axis-title glyph in a small screenshot — the original formula (`x = r·sin(bearing)` for east/horizontal, `y = r·cos(bearing)` for north/vertical) was correct from the start.

**Grafana's org-wide home dashboard** is WeatherTWD, set two ways that must be kept in sync: `GF_DASHBOARDS_DEFAULT_HOME_DASHBOARD_PATH` in both `docker-compose.mac.yml` and `docker-compose.yml` (the file-provisioned, git-tracked default — survives a container rebuild) and an org preference (`PUT /api/org/preferences {"homeDashboardUID": "sisu-weather-twd"}`, live-only, not git-tracked) which **takes precedence over the env var when both are set** — changing the env var's target dashboard without also re-running the API call leaves the old one showing.

**Multi-measurement Flux joins need an explicit final `|> group()`** before the last `keep`/`sort` — pivoting two unioned streams by `_time` (or any per-row key) leaves the result grouped into one Flux table per row, which the InfluxDB datasource returns as that many separate Grafana frames instead of one. A `timeseries` panel over dozens of 1-row frames technically queries fine but is the wrong shape; caught live 2026-08-15 building the TWD trend panels (57 frames instead of 1) by testing each panel's exact query through Grafana's own `/api/ds/query`, not just raw InfluxDB.

**`include`/`exclude` entity_globs are read once at Core startup, not hot-reloadable** — there's no `influxdb.reload` service (unlike `template:`, which does support `template.reload`). A Core restart is required after editing the include list, same as adding a new package file. Found live 2026-08-15: `sensor.nmea_tws`, `sensor.true_wind_speed_max_6h`, `sensor.sisu_air_temp`, `sensor.sisu_water_temp` were wired in HA but missing from this list since #32 — confirmed absent from the live Influx bucket before the fix, present after + a Core restart.

**New trigger-based `template:` entities can fail to register on the Core restart that should create them, but appear fine after a follow-up `template.reload`** — found live 2026-08-15 (`packages/anchor_watch.yaml`, #53): a fresh package with a `- trigger: ... sensor: ... binary_sensor: ...` block deployed + Core-restarted twice in a row, both times leaving every entity from that block missing (404) while sibling top-level `input_number:`/`input_boolean:` keys in the *same file* loaded fine — no error logged anywhere for the missing block either time. Calling `template.reload` immediately after each restart fixed it completely. Root cause not confirmed (didn't reproduce in isolation — a concurrent package elsewhere had its own real template error at the time, see next paragraph, but the entities came back before that other error was fixed, so it isn't the full explanation). Treat as a standing gotcha: after any Core restart that should create new trigger-based template entities, verify via `/api/states` and follow up with `template.reload` if they're missing, don't assume a clean restart + no error in the log means they registered.

**A dependent trigger-based template reading a sibling's `states()` value can be one firing behind it, not synced** — entities defined in the same `- trigger: ...` block are evaluated from one shared trigger-event snapshot, not chained; a `binary_sensor` template that calls `states('sensor.x')` where `sensor.x` is *also* defined in that same trigger block can read last firing's value, not the value `sensor.x` computes in this same firing (confirmed live, #53: moving `sisu_anchor_distance`'s drop point updated the distance sensor immediately but left `binary_sensor.sisu_anchor_alarm` — which read `states('sensor.sisu_anchor_distance')` — one firing stale, so the alarm never crossed the radius until the *next* unrelated trigger). Fix: compute shared math inline in each dependent entity rather than reading a sibling's state, when both are defined in the same trigger block.

**A `template:` schema error in one package can be silently swallowed rather than surfaced during a restart's own request/response** — `ha core check` (both `scripts/ha-cli.sh core check` and the raw Supervisor API) reported `{"result":"ok","data":{}}` while the *same* restart's container logs showed a real `Invalid config for 'template'` error from another package (`energy_victron_stubs.yaml`, #54 WIP). `ha core check` is not a substitute for reading `docker logs homeassistant` around a restart when a package touches `template:` — it did not catch this.

Single ingress path — do not also enable a Signal K→InfluxDB plugin for the same data (HA already normalizes everything into stable entity_ids). `measurement_attr: entity_id` is set deliberately in the package — HA's influxdb integration defaults that to `unit_of_measurement`, which silently misfiles every unit-bearing sensor into a measurement named after its unit string instead of grouping by entity (see `OPS.md` §7 for the full gotcha writeup). `homeassistant/.env` (generate via `scripts/gen-docker-env.sh` from `secrets.yaml`) feeds the Influx token/org/bucket to both the datasource provisioning YAML and the compose files' Grafana/InfluxDB `environment:` blocks.

**Connection settings live in a UI config entry, not YAML** (HA 2026.9 removed YAML-configured InfluxDB connections) — `trending_influxdb.yaml` only holds `measurement_attr`/`max_retries`/`include`/`exclude` now; host/token/org/bucket were auto-imported on first load, reconfigure via Settings → Devices & services → InfluxDB. See `OPS.md` §7.

## Tides / weather / air+water temp (issue #32)

```
NOAA CO-OPS (api.tidesandcurrents.noaa.gov, free/keyless)
  → python_scripts/tides_noaa.py: nearest-station haversine lookup
    (candidates in USVI/BVI, live GPS from sensor.nmea_latitude/longitude,
    home-position fallback) + hilo predictions in **meters** (units=metric,
    Sisu is a metric boat -- 2026-08-11), 3h on-disk cache
  → sensor.tides_noaa_json → sensor.sisu_tide_station / _next_high / _next_low
    (state is a pre-formatted "HH:MM (in Xh Ym)" string -- 24h local time +
    countdown computed in the template, not a device_class: timestamp;
    height_m kept as an attribute, not a dashboard row)

Open-Meteo Marine API (marine-api.open-meteo.com, free/keyless)
  → python_scripts/weather_openmeteo.py: sea-surface-temp fallback ONLY
    (hourly weather forecast itself is the native weather.forecast_home
    entity, Met.no via default_config: -- already supports forecast_type:
    hourly out of the box, no custom code needed for that part)
  → sensor.weather_open_meteo_json → sensor.sisu_water_temp (NMEA-first)

NMEA 0183 MTA/MTW (nmea_gateways.py parser)
  → sensor.nmea_air_temperature / sensor.nmea_water_temperature (honestly
    `unknown` if the boat's N2K bus doesn't have that sensor fitted --
    water temp confirmed live 2026-08-11, air temp not currently reporting)
  → sensor.sisu_air_temp / sensor.sisu_water_temp prefer these, fall back
    to Met.no / Open-Meteo respectively when unavailable (each exposes a
    `source` attribute saying which it used)
```

All on `ui-lovelace.yaml`'s main "Sisu" board's "Sea & sky" section (depth/temp/wind/tides, all as tile cards — a mixed entities-list card there previously left a visible empty gap next to the tile grids either side of it) + the weather-forecast tile; "Ship zones" nav buttons moved to the bottom of that board (2026-08-11).

**True wind speed** (`sensor.nmea_tws`, MWV sentence with reference "T" — the boat's own instruments compute it, not derived here from AWS+SOG+heading) + a rolling 6h max (`sensor.true_wind_speed_max_6h`, HA's built-in `statistics:` platform, `state_characteristic: value_max`, `max_age: 6h` — reads the source sensor's own recorder history, no extra pipeline). Both confirmed live 2026-08-11 (~9-10kn).

**Barometric pressure + humidity** (`sensor.sisu_barometric_pressure`, `sensor.sisu_humidity`) -- no N2K barometer/hygrometer fitted, so unlike air/water temp there's no NMEA-first fallback pair: both read straight off `weather.forecast_home`'s (Met.no) `pressure`/`humidity` attributes, modeled-only. Confirmed live 2026-08-15 (1016.9 hPa, 82%). If a real barometer ever gets fitted, give it the same NMEA-first pattern as air/water temp above.

No secrets/API keys needed for any of this.

**House bank display bug fixed same pass:** the main board's "House bank" tile/header pointed at `sensor.lab_bench_alts_sim_house_voltage_engine_port` (the alternator sim's local sense point) which reads `unavailable` when the sim isn't running -- displayed as a misleading "0V". Fixed to `sensor.sisu_house_bank` (new, `packages/energy_victron_stubs.yaml`), a combined "13.43 V (92%)" string sourced from the real Victron battery monitor (`sensor.victron_battery_voltage`/`_soc`) -- the actual house bank, not an alternator's sense point. `dashboards/power.yaml` had the same bug, fixed too.

## Spectra pipeline (watermaker)

```
Spectra HTML UI / WS 192.168.0.25:9000  (subprotocol dumb-increment-protocol)
  → spectra_ws.py  status | autorun | stop | cancel_flush
  → command_line sensor.spectra_status_json + shell_command / scripts
  → Water dashboard (/lovelace-water) + optional auto-stop @ 95% (needs tank entities)
```

Operator flow: START → AUTORUN → amount **liters or hours** → OK. Device always FWF after start/stop cycle.

## Other plugins

| Component | State | File |
|---|---|---|
| `signalk-mqtt-sensors` | **enabled** (sample) | `signalk-mqtt-sensors.json` |
| `signalk-mqtt-bridge` | **enabled**, not used for engine data (see engine data note above — REST API used instead) | `signalk-mqtt-bridge.json` |
| Device `mqtt:` on alternator | not used | HA automation bridge only |
| HA MQTT integration | **configured**, interim Mac broker `192.168.0.151:1883` (issue #20, resolved) | `OPS.md` §7 — repoint to F8 `.21` once #6 lands |

Prefer one ingress path to Signal K.

## Non-alternator devices

- **Levels (Marine Board):** HA API; optional MQTT/SK later.  
- **Freezer:** Marine Board controller → HA API (+ local Flash button). LilyGo display ← HA (`platform: homeassistant` mirrors); its taps → HA `climate.*` actions → controller. HA down = display shows NO HA; control unaffected.  
- **Spectra:** WS bridge only — not MQTT.

## When changing the pipeline

1. Change source entity or payload key.  
2. Update `automations.yaml`.  
3. Update `signalk-mqtt-sensors.json` if SK-bound.  
4. Smoke: MQTT Explorer → SK Data Browser.  
5. Spectra: test on device carefully (real pumps).
