Cadburies/SisuAssistant/MarineBoard/Documentation/Axiom-Replacement-Plan.md

# Raymarine Axiom — Sisu Nav takeover plan

**Status:** plan, nothing built. Reviewed 2026-10-19: radar edge box, Freeboard-SK first, and an **MFD-free** principle (sonar F1/D1, Axiom/Garmin phased out). Updated 2026-10-23 with the equipment list from the manuals index. **Date:** 2026-10-19, updated 2026-10-23.
**Why:** Sisu Nav on the F8 already shows Sisu's charts and instruments. To take over from the Raymarine MFD(s) and the Garmin GPSMAP 722xs it needs radar and sonar. Radar can be read with open-source software (mayara). Sisu's sonar imaging is a **Garmin Panoptix PS51-TH on the GPSMAP 722xs**, which is Garmin-locked (§2.4). The manuals index lists **no Raymarine sonar**. So sonar either stays on the Garmin or comes from new, MFD-independent hardware.
**Goal:** make **Sisu Nav the primary chart, instrument, radar and sonar display**, using **mayara-server + the Signal K Radar API + a MapLibre radar layer** for radar, and MFD-independent sonar (§2.4). The Raymarine MFD(s) and the Garmin plotter stay aboard as backups and are **not replaced** when they fail (owner decision 2026-10-19).

**Source:** desk research on 2026-10-19 (links in *Sources*). Nothing has been tested on Sisu yet. **UNVERIFIED** marks anything not confirmed from a primary source or on the boat. **TBD (survey)** marks facts only Sisu's own hardware can answer (§0).

Related: [`NETWORK.md`](../../NETWORK.md) (Sisu LAN, GL-BE9300, F8 at 192.168.0.21), [`sisu-nav/DESIGN.md`](../../sisu-nav/DESIGN.md), [`sisu-nav/web/src/plugins/`](../../sisu-nav/web/src/plugins/) (overlay plugins), [`homeassistant/docker-compose.yml`](../../homeassistant/docker-compose.yml) (Signal K on the F8, `network_mode: host`).

### Review 2026-10-19: what changes

A second research pass changed these points. Details are in the sections named.

1. **Radar on a chart with zero code first.** Freeboard-SK 3.0.1 is already installed on the F8's Signal K and draws the Signal K Radar API (MaYaRa) as an overlay. Use it as the first radar display (new Phase 3b) and build the Sisu Nav layer after that, copying what works (§2.3).
2. **A 12 V radar/sonar edge box instead of a USB NIC on the F8.** A small Linux computer on 12 V with two Ethernet ports sits on RayNet and the Sisu LAN. It runs mayara and the sonar capture and feeds Signal K on the F8. This removes the two biggest unknowns: TOS USB NIC drivers, and radar going dark when the inverter is off (§3.2, §7.4). This is now the recommendation; the F8 USB NIC (option A) stays as the cheaper alternative.
3. **Sonar: MFD-free (owner decision).** The RealVision transducer and the Garmin Panoptix are dead; the depth sounder works. Nothing new may depend on the Axiom or Garmin MFDs, which are phased out as they fail. So (§2.4):
   - **F1, forward-looking:** EchoPilot FLS 3D, whose HDMI output is captured into Sisu Nav.
   - **D1, down/side imaging:** open-data sonar (Cerulean Omniscan 450 SS + S500, or Ping2) drawn by Sisu Nav itself, or skipped. Decision pending.
   - Like-for-like replacements (a RealVision pair, Panoptix) are rejected: they die with their MFD. Capturing the Axiom's sonar page and decoding RayNet sonar are dropped.
   - Radar without an MFD makes the edge box's RayNet DHCP role (Phase 5) a requirement, not an option.
4. **Facts checked on 2026-10-19:**
   - Signal K on the F8 is **2.32.0**, which meets the mayara plugin's ≥ 2.31.0 (§0.6 done).
   - Sisu Nav's MapLibre is now **6.15** (#207). Its worker setup (`setWorkerUrl`) also applies to the radar custom layer (§4.3).
5. **Security from day one (new §8.1):** mayara's GUI (:6502) and go2rtc (:1984) have no login by default. Only the F8 may reach them (admin via SSH tunnel), pin their images by digest, and run cyber-check before going live.

### Update 2026-10-23: equipment from the manuals index

Sisu Engineer read Frik's `5_Inbox/Manuals_index.md`. It changes these points:

1. **No Raymarine sonar is listed.** There is no CP-series module and no Raymarine transducer (RealVision or other). The 2026-10-19 note that "the Axiom's RealVision transducer is dead" conflicts with this. Until Frik confirms, this plan treats **Raymarine sonar as probably not fitted** (§0.4, §6).
2. **Sonar imaging is Garmin:** a **Panoptix PS51-TH** (FrontVü forward-looking, through-hull) on a **GPSMAP 722xs** over the Garmin Marine Network (proprietary Ethernet). The 2026-10-19 note says the Panoptix broke at the last haul-out. §2.4 is rewritten around this.
3. **Depth/speed/temperature come from an Airmar UDST800** (`44-218-1-01`, per the index) NMEA 2000 smart sensor, not from any MFD. It is the working "depth sounder" in §2.4.
4. **So the Raymarine MFD is not the sonar display.** It is needed only as the **RayNet DHCP server and backup radar display**, possibly as the **CAM220IP camera display**, and for Raymarine-only jobs (radar Wi-Fi pairing, software updates). The CAM220IP is an IP camera with documented RTSP, so it can likely be viewed without the MFD (§2.5).
5. **Other listed equipment:** CAM220IP IP camera, Ray60/70 VHF, AIS700 transponder, and **2× Yacht Devices YDEG-04** engine gateways (Yanmar → NMEA 2000). They are added to the roles table (§1.2).
6. **Still unknown:** the Raymarine MFD model (not on file; earlier notes say Axiom and Axiom Pro) and the exact Quantum model.

---

## 0. Do now, before anything else

1. **Read the radar label.** We need the part number. `E70498` / `E70498-B` is the Quantum 2 Doppler Q24D. `T70417` is that radar bundled with 15 m power and data cables. Also record the radar's software version (Axiom: *Settings → Network → Radar*, **UNVERIFIED** menu path).
2. **Identify the chartplotters.** The Raymarine MFD model is **not on file** in the manuals index (earlier notes say Axiom and Axiom Pro). Record the model(s), LightHouse version and how many RayNet ports they have (needed for the radar network until Phase 5). Garmin: **GPSMAP 722xs** (manuals index). Record its software version.
3. **Trace the radar link.** Is the radar wired over RayNet, or linked to the Axiom over Wi-Fi? Photograph the back of the Axiom and every RayNet connector, plus the Quantum's base connector (data and power separate, or through the A80308 Y-adapter).
4. **Confirm the sonar.** The manuals index (2026-10-23) lists **no Raymarine sonar module or transducer**, which conflicts with the 2026-10-19 note of a dead RealVision transducer. Check the hull and the back of the Raymarine MFD for a Raymarine transducer cable. Sonar imaging per the index is the **Garmin Panoptix PS51-TH** on the **GPSMAP 722xs** (reported broken at the last haul-out). Depth/speed/temperature come from the **Airmar UDST800** on NMEA 2000. Record the through-hull positions of every transducer, so dead ones can be removed or blanked at the next haul-out.
5. **List everything else the Raymarine MFD does today:** autopilot control (Evolution?), AIS display (AIS700), DSC/VHF integration (Ray60/70), alarms, the **CAM220IP** camera feed, YachtSense, the Raymarine app. Anything on that list that Sisu Nav does not cover keeps the MFD aboard.
6. ~~Check the Signal K server version on the F8.~~ **Done 2026-10-19:** Signal K **2.32.0** (`GET :3000/signalk`), which meets the plugin's stricter requirement (≥ 2.31.0 on npm, vs ≥ 2.24.0 in its README).
7. **For F1 (EchoPilot):** a bow position for a through-hull, its distance from the depth sounder, and a cable route to the edge box.
8. **For D1 (only if chosen):** the hull at the bilge/keel area: material (solid GRP, cored?), a dry spot inside for a small through-hull or in-hull transducer, and how far that is from the existing depth transducer.

---

## 1. The Axiom setup as built (as far as known)

### 1.1 Today

```
Quantum radome (model TBD) ──RayNet (and/or Wi-Fi)──► Raymarine MFD (model not on file) ◄──RayNet── CAM220IP camera
   │ separate 12 V power                                │
                                                        └──SeaTalkNG / N2K──► backbone ──► YDWG gateway ──► Signal K (F8)
N2K backbone also carries: Airmar UDST800 (depth/speed/temp), AIS700, Ray60/70 VHF (TBD), 2× YDEG-04 (Yanmar engines)
Panoptix PS51-TH ──Garmin Marine Network (proprietary Ethernet)──► Garmin GPSMAP 722xs (also on N2K, TBD)
No Raymarine sonar module or transducer listed (manuals index, 2026-10-23)
Sisu LAN 192.168.0.0/24 (GL-BE9300): F8 192.168.0.21 runs Signal K :3000, Sisu Nav :8088, Grafana, Influx
```

- **RayNet** is 100 Mbit/s Ethernet in a waterproof twist-lock connector. Raymarine runs it as a private network, **198.18.0.0/21** (netmask 255.255.248.0). The Axiom (LightHouse 3/4) acts as DHCP server **and** gives itself an address in **198.18.0.32–198.18.3.255**. Nothing else may take a fixed address in that range. Third-party fixed addresses belong in **198.18.0.2–198.18.0.19**. A third-party DHCP server must hand out **198.18.4.0–198.18.7.254**, and its own address must be exactly 198.18.0.1 (Raymarine 81411; mayara Raymarine guide).
- **Quantum networking:** the Quantum is a DHCP client and stays silent until it gets a lease. Inside the dome, the spinning part talks to the base over 2.4 GHz Wi-Fi even on a wired install, so 2.4 GHz congestion can drop radar image data (mayara guide).
- **Radar traffic is multicast:** discovery on `224.0.0.1:5800` (wired) and `232.1.1.1:5800` (Wi-Fi); reports and image data on `232.1.x.x:2574`. Controls go unicast to the radar's own address. Quantum image data is run-length compressed: **250 spokes per turn, up to 252 samples each, ≈0.06 MB per turn** (mayara networking help; Sailing Exodus measured ~6 kB/s on open water).
- **Sonar:** the manuals index lists **no Raymarine sonar**, so there is probably no Raymarine sonar stream on RayNet (for reference, Sailing Exodus saw Axiom sonar as a proprietary multicast stream, `226.x.x.x:3221`, only while a sonar page was open). Sisu's sonar imaging is the **Garmin Panoptix PS51-TH**: a self-contained multibeam transducer with its own processing that sends its picture to the **GPSMAP 722xs** over the Garmin Marine Network, in Garmin's proprietary format (§2.4).
- **Instruments:** depth, speed through water and water temperature come from the **Airmar UDST800** smart sensor on NMEA 2000. Heading, position, wind, AIS (AIS700) and engine data (2× YDEG-04 from the Yanmars) are on NMEA 2000 → Signal K too, so none of them depend on an MFD.
- **Camera:** the **CAM220IP** is an IP camera (H.264 1080p, RTSP on port 554, DHCP client, 12 V or PoE class 2), on RayNet today (**UNVERIFIED** where it plugs in) (§2.5).

### 1.2 Axiom roles and who takes them over

| MFD role | Sisu Nav replacement | Status | Raymarine MFD still needed? |
|---|---|---|---|
| Charts | Sisu Nav MBTiles (satellite + nautical, 2,215 sets) | **Done** | No |
| Instruments (wind, SOG/COG, heading) | N2K → Signal K → `plugins/instruments` | **Done** | No |
| Depth, speed through water, water temperature | **Airmar UDST800** (N2K smart sensor) → Signal K | **Done** | No |
| Engine data (Yanmar) | **2× Yacht Devices YDEG-04** → N2K → Signal K | Done (engine pages in Sisu Nav **UNVERIFIED**) | No |
| AIS targets | **AIS700** → N2K → Signal K AIS → Sisu Nav (already shown, **UNVERIFIED** for every class) | Mostly done | No |
| AIS700 setup (own-ship data, silent mode) | AIS700's own tools (proAIS-style PC app **UNVERIFIED**) or the MFD | — | Occasionally, **UNVERIFIED** |
| VHF DSC distress / position-poll display | **Ray60/70** on N2K → Signal K (which PGNs it sends is **UNVERIFIED**); the radio itself is the primary DSC interface | TBD | No (the radio works on its own) |
| Camera view | **CAM220IP** RTSP → go2rtc → Sisu Nav panel (§2.5) | Feasible, **UNVERIFIED** on Sisu | No, once viewed directly |
| Radar display + control | mayara-server → Signal K Radar API → `plugins/radar` (new) | **Feasible**, §2.2 | Only if the radar stays on Wi-Fi to the Axiom, or as RayNet DHCP server (§3.2) |
| Doppler colouring, ARPA/MARPA | mayara (Doppler listed for Quantum 24D; ARPA with CPA/TCPA) | Feasible, **UNVERIFIED on Sisu** | No |
| Sonar / fishfinder image | Today: Panoptix PS51-TH on the **Garmin 722xs** (not the Raymarine MFD); no live decoder; Helm mirroring on a phone (§2.4). Future: F1 EchoPilot FLS 3D video · D1 open-data sonar, or skipped | Panoptix reported broken · F1 feasible, new hardware · D1 decision pending | **No** (never was the sonar display, per the manuals index) |
| Autopilot control, alarms | out of scope here | TBD (survey, §0.5) | TBD |
| Radar software updates and Wi-Fi pairing | Raymarine-only | — | **Yes** (occasionally) |

**Honest verdict (updated 2026-10-23):** Sisu Nav can take over **charts, instruments (UDST800, AIS700, YDEG-04 engines) and radar** with existing hardware, and very likely the **CAM220IP camera** over RTSP. The Raymarine MFD is **not the sonar display**: sonar imaging is Garmin (Panoptix on the 722xs), which nothing open can read live. So the Raymarine MFD is needed only as the **RayNet DHCP server and backup radar display** until Phase 5, for the camera until §2.5 is done, and occasionally for Raymarine-only jobs (radar pairing and updates). Once Phase 5 and §2.5 are done, nothing in this plan needs it. **Sonar imaging in Sisu Nav needs new, MFD-independent hardware** (F1, optionally D1). The Garmin stays the sonar display for as long as the Panoptix works.

---

## 2. Each role: how

### 2.1 Charts and instruments
Already live. Nothing to build. One possible extra: Signal K alarms (shallow water, anchor) shown in Sisu Nav, so the Axiom's alarm screens are not the only ones.

### 2.2 Radar: mayara-server (recommended)

- **mayara-server** (Rust, Apache-2.0, by Kees Verruijt, the radar_pi maintainer). Latest is **v3.14.0, 2026-10-09**, and it is under daily development. It turns each brand's proprietary radar protocol into the open **Signal K Radar API**: REST for controls and **WebSocket for spokes (binary protobuf)**. Its built-in GUI runs in a web browser, which shows the stream works in browsers.
- **Raymarine support:** README lists *Quantum, RD series, HD radomes* as "fully supported and tested with real hardware". Its Raymarine guide lists **Quantum 2 Q24D = Doppler: yes**. Since v3.7.0 it wakes a wired Quantum itself, so **no MFD is required on a wired setup, but a DHCP server is**.
- **Wired vs Wi-Fi** (mayara guide):

| Setup | Works | Axiom must stay on |
|---|---|---|
| mayara wired to RayNet, radar wired to RayNet | Yes | No (needs some DHCP server) |
| mayara wired to RayNet, radar on Wi-Fi to the Axiom | Yes, the Axiom bridges it | **Yes** |
| mayara on the Axiom's Wi-Fi (`--allow-wifi`) | Yes | **Yes**. Not recommended: Wi-Fi multicast drops spokes |

- **Deployment:** Docker image `ghcr.io/marineyachtradar/mayara-server` with `--net=host` (needed to receive multicast), or the static `x86_64-unknown-linux-musl` binary. The F8 is an x86_64 Intel i3-N305, so either works. Built-in GUI on port **6502**.
- **OpenCPN radar_pi** is *not* the route. It is a desktop plugin, its last release (v5.5.0-beta) is from March 2023, and in issue #272 (Quantum 2 Q24D + Axiom) the Quantum was only found while the Axiom was on. The same maintainers have moved to mayara.
- **Other decoders:** Sailing Exodus documents the Quantum's spoke format (20-byte header, `0x5c` run-length escape, codec "not fully pinned down"). KAHU `radar_receiver` (Node binding of radar_pi) is dead (radar_pi #278). Neither is needed.

### 2.3 Radar → Signal K → Sisu Nav

- **Signal K Radar API v3.4.0** (in signalk-server). mayara is the reference provider. Endpoints under `/signalk/v2/api/vessels/self/radars`: list, `/{id}/capabilities`, `/{id}/controls/{cid}` GET/PUT, `/{id}/targets`, and **`/{id}/spokes` (WebSocket, binary)**. Control and target updates also arrive on `/signalk/v1/stream`.
- **Plugin:** `@marineyachtradar/signalk-plugin` **v1.8.0 (2026-10-11)**, MIT. It registers mayara as the Radar API provider and forwards spokes through Signal K's `binaryStreamManager`. It can manage the mayara container itself through `signalk-container` (Podman/Docker). On the F8 we would rather run mayara from our own compose file and point the plugin at it. Whether the plugin accepts an external mayara URL is **UNVERIFIED**. Check its config schema.
- **Why go through Signal K and not straight to mayara:** Sisu Nav already authenticates to Signal K (`web/src/app/sk.ts`, `api/signalk-session.mjs`), phones on the Sisu LAN already reach `:3000` through the GL-BE9300 firewall (`NETWORK.md` §4), and Signal K stays the single source. Browsers never talk to mayara directly (§8.1).
- **Existing clients worth copying:** Freeboard-SK (Signal K chart plotter with radar overlay), Binnacle (`NearlCrews/signalk-binnacle`, WebGL Signal K chart plotter with radar), mayara_pi (OpenCPN).
- **Freeboard-SK first (zero code).** Freeboard-SK **3.0.1** is already installed on the F8's Signal K (`homeassistant/signalk/package.json`, served at `http://192.168.0.21:3000/@signalk/freeboard-sk/`). Its help says it "supports the Signal K RADAR API" through MaYaRa, with a radar button that appears once a radar is detected. As soon as mayara and its plugin run (Phase 3), the radar is on a chart in Freeboard-SK, with nothing built. That gives a working display at sea while the Sisu Nav layer is written, plus a reference for how alignment, palettes and controls should behave. Which Freeboard-SK version first added radar is **UNVERIFIED**; its 3.0.1 bundle contains radar code.

### 2.4 Sonar: MFD-free replacement (owner decision 2026-10-19)

**Hardware state (manuals index 2026-10-23, owner notes 2026-10-19):**
- **Raymarine sonar: probably not fitted.** The manuals index lists no Raymarine sonar module or transducer. The owner's 2026-10-19 note of a dead **RealVision** transducer ("left pinging during a haul-out and ran dry") conflicts with that. **Pending Frik's confirmation** (§0.4, §6.4). If there is one, the transducer may have been on the Garmin, not the Raymarine.
- **Garmin sonar: Panoptix PS51-TH** (Garmin 010-01753-00; FrontVü forward view, seabed up to ~90 m ahead, through-hull) on the **GPSMAP 722xs** (7" combo with built-in CHIRP/ClearVü sonar, discontinued). The 722xs is on the PS51-TH compatibility list (Active GPS retailer listing). The owner reports the Panoptix **broken at the last haul-out**. Whether that means the transducer, its cable or the 722xs is **UNVERIFIED**.
- **Depth works: Airmar UDST800** (`44-218-1-01`) NMEA 2000 smart sensor for depth, speed and temperature. Its ~1.1–1.3 m readings since 4 Oct (Influx `sensor.nmea_depth`) are the real depth at the berth. It needs no MFD.

#### Existing Garmin sonar: can Sisu Nav show it?

Researched 2026-10-23. In short: **no live path into Sisu Nav exists. The Garmin stays the Panoptix display.**

| Route | What it gives | Status |
|---|---|---|
| **Decode Garmin Marine Network sonar live** | Panoptix picture in Sisu Nav | **No open decoder found.** mayara lists Garmin *radar* protocols (HD/xHD/Fantom, "awaiting real-hardware validation"), which shows Garmin's network is reversible for radar, but nobody has published Panoptix or Garmin sonar packets. Garmin publishes **no public SDK** for its marine network or sonar (none found; **UNVERIFIED**). |
| **Garmin recordings (.RSD) offline** | Post-processing of recorded sonar | Garmin RSD is documented (Herbert Oppmann's format notes), and the open-source **PINGVerter / PINGMapper** decode Garmin `.RSD` ("Panoptix / LiveScope systems" per PINGMapper). Whether the 722xs records Panoptix to RSD is **UNVERIFIED**. Useful for surveys, not navigation. |
| **ActiveCaptain app "Helm"** | The whole 722xs screen on a phone or tablet over the 722xs's Wi-Fi, with control | The 722xs is listed as "Garmin Helm compatible" (Garmin product page), and Helm was added to the ActiveCaptain app in 722 software 10.00 (Garmin change history). That Helm shows a live **Panoptix page** is **UNVERIFIED**. **Best low-effort option while the Panoptix works**, but outside Sisu Nav. |
| **Garmin OneHelm** | — | Goes the other way: third-party (HTML5) device UIs shown *on* Garmin screens. Not a way to get Garmin sonar out. |
| **NMEA 2000 from the 722xs** | Depth from its sonar as N2K PGNs | Possible on Garmin MFDs, **UNVERIFIED** for the 722xs. Not needed: the UDST800 already gives depth, and two depth sources on N2K need a priority set in Signal K. |
| **Video out / HDMI capture** | 722xs screen as video | The 7" GPSMAP 7x2 has **no video output** that we found (**UNVERIFIED**). So the "capture the MFD's HDMI" idea does not apply. |
| **Repair or replace the Panoptix** (PS51-TH or newer PS22) | Forward view back, on the Garmin | Rejected by the MFD principle (dies with the 722xs), unless Frik wants a cheap interim fix. |

#### Raymarine sonar (if one is found after all)

Decoding RayNet sonar stays unsolved upstream (Sailing Exodus). Capturing an Axiom's sonar page over HDMI only works on an Axiom 2 Pro (micro-HDMI, cable A80723). Both are dropped (see *Dropped*).

**Principle (owner decision):** move away from the Axiom, the Axiom Pro and the Garmin plotter. They stay aboard as backups and are not replaced when they fail. **Nothing new may depend on an MFD.** Every sensor either sends standard data (NMEA 2000 → Signal K) or does its own processing and outputs video or an open data stream that Sisu Nav shows. So the dead units are **not** replaced like for like:
- A RealVision RV-212/RV-220 pair (~$1,500–2,100, retailer listings, e.g. [The GPS Store](https://thegpsstore.com/Marine-Electronics/Transducers/Raymarine-Transducers/Raymarine-RealVision-Transducers)) only works on a RealVision-capable Axiom (and Raymarine sonar is probably not fitted at all).
- A new Panoptix (PS51-TH like for like, or PS22) only works on a Garmin plotter such as the 722xs.

Both would die with their MFD.

#### F1. Forward-looking: EchoPilot FLS 3D (video into Sisu Nav)

- **What:** EchoPilot FLS 3D. A forward-looking sonar built for navigation and obstacle avoidance: 60° horizontal / 90° vertical view, up to 200 m ahead and 100 m depth. A cheaper 30° single-transducer model costs about **£5,000**; the 60° price is **UNVERIFIED**. It has its own processor and an **HDMI/VGA output** to any screen. It also integrates with Raymarine, Simrad, B&G and Lowrance MFDs, so it can show on the Axiom while that still runs.
- **Into Sisu Nav:** HDMI → USB HDMI capture stick (UVC) on the edge box → **go2rtc** turns it into **MSE over WebSocket** (WebRTC media would need UDP/TCP 8555 straight to the browser, which §8.1 blocks) → the Sisu Nav API proxies the WebSocket (new `api/video/` route, authenticated like the rest of `:8088`) → a Sisu Nav panel plugin `plugins/sonar-video/` plays it. Browsers never reach go2rtc directly (§8.1). Latency for a capture stick through go2rtc is **UNVERIFIED**.
- **Control without an MFD:** how range and mode are set when it isn't on a Raymarine/Simrad MFD (own keypad, or a PC app) is **UNVERIFIED**. Confirm with EchoPilot before ordering.
- **Mounting:** a through-hull at the bow, so it needs a haul-out. The installation position follows EchoPilot's guide.
- **Reviews:** EchoPilot "definitely provides the best visuals" but is pricey (Kraken Yachts). In one Practical Boat Owner test, Garmin Panoptix showed a vertical obstacle at 8 m more clearly. Panoptix is ruled out by the MFD principle.
- **FarSounder** (Argos 350/500) has a real SDK, but at $55k+ and aimed at superyachts it's out of scope.

#### Cerulean Omniscan family, evaluated 2026-10-19 (owner likes its detail and range)

| Model | What it measures | As forward-looking (navigation) | As side/down imaging | Price |
|---|---|---|---|---|
| **Omniscan 450 FS** | 450 kHz fan beam, ~0.8° × 50°; range up to 120 m; depth rating 100 m (a 300 m version exists). One channel: each ping is echo strength vs **range only** (`os_mono_profile`) | **Weak:** shows "first echo X m ahead" but not *where* in the 50° fan, so no seabed profile ahead while running straight. **UNVERIFIED**: inferred from the single-channel profile message; ROVs build images by rotating. | Good side-scan-style imaging as the boat moves | **$2,490** (100 m rated) |
| **Omniscan 450 SS** | Same, longer transducer: narrower beam, longer range (~150 m slant per a reseller listing, **UNVERIFIED** with Cerulean) | Same limitation | The classic side-scan picture | ~$5,400 ([RobotShop listing](https://robotshop.com/products/cerulean-omniscan-450-side-scan-sonar-for-marine-exploration-blueboat-bluerov2)) |
| **Omniscan 3D 450 SS** (WetLink penetrator) | **16-channel receive array** that measures the **vertical angle of every echo**: real-time 3D point clouds; one enclosure, one Ethernet | **Possibly strong, UNVERIFIED:** mounted facing forward, the angle per echo would give a true vertical depth profile ahead (like a 2D FLS) as open data, so Sisu Nav could raise **shoal-ahead alarms**. It is sold as side-scan; ask Cerulean whether forward mounting works | 3D seabed and structure maps (anchorage scouting) | **$7,990** |
| **EchoPilot FLS 3D** (for comparison) | 60° × 90° forward volume, 200 m | **Strong, purpose-built** | — | ~£5,000 (30°) |

**Integration (all Omniscan models):** Ethernet, with a **public packet protocol** (Cerulean Ping protocol: `os_ping_params` 2197 starts pinging and sets range and gain; `os_mono_profile` 2198 carries the samples) and a Python library (`ping-python`). Cerulean's **SonarView** runs in Docker on Linux (the edge box), takes **position and heading over NMEA** (Signal K can serve that), and exposes **SonarLink**, an HTTP API for third-party apps. Sisu Nav can either read SonarLink or talk to the sonar itself. The hardware is built for drones and ROVs, so mounting through Sisu's hull is our own engineering (§7).

**Current recommendation:** forward-looking = **EchoPilot FLS 3D** unless Cerulean confirms that the **3D 450 SS** works forward-mounted. If it does, the 3D unit gives open forward data with alarms and could cover F1 on its own. Side and down detail = **Omniscan 3D 450 SS** side-mounted (or 450 SS). Questions for Cerulean are in §6.

#### D1. Down/side imaging: open data, or skip (decision pending)

The depth sounder already covers depth for navigation. Side and down imaging is mostly for seeing the bottom and structure (anchoring, fishing). Two choices:
- **Open data: Cerulean Sonar Omniscan 450 SS (side scan) + S500 (down).** Black boxes with an **open Ethernet interface** (Omniscan: "100Base-T Ethernet with open programming API"; S500: full signal profile for a waterfall). **Sisu Nav draws the picture itself**, so there's no video capture and no MFD.
  - Omniscan 450 SS: 450 kHz, up to 150 m slant range, 10–30 V, **~$5,400**.
  - S500: CHIRP 500 kHz, 5° beam, >100 m; price **UNVERIFIED** ($595 on a 2020 slide).
  - Both are made for survey drones and ROVs, **not proven yacht instruments**. Treat them as an experiment.
- **Cheaper down-only: Blue Robotics Ping2.** 115 kHz, 25° beam, 0.3–100 m, documented open Ping protocol (distance, confidence, ~200-sample profile; Python `brping`).
- **Skip it** for now. Depth plus F1 covers the navigation need.

If D1 goes ahead:
- **Integration:** sensor → small service on the edge box → **Signal K**: depth under its own `$source` with its own transducer offset (the existing N2K depth stays first, `.ai_context/sources.md` rule 11). The image goes as a binary stream to a Sisu Nav **`plugins/sonar/`** panel: a waterfall for down, a scrolling strip for side scan.
- **Mounting:** through-hull fairing blocks (haul-out), or in-hull for the S500/Ping2 on solid laminate (**UNVERIFIED** through Sisu's hull).
- **Interference:** different frequencies from the existing depth sounder; check at the dock with both running.
- **Not a navigation instrument** until its depth has tracked the main sounder for a season.

#### Dropped

- **Capturing the Axiom's sonar page** (earlier draft): the Raymarine MFD probably has no sonar at all (manuals index), and the principle rules out depending on it. The 722xs has no video output we know of. The **video capture pipeline itself is kept for F1.**
- **Decoding Raymarine's RayNet sonar stream:** unsolved upstream, probably no such stream aboard, and pointless once Raymarine is phased out.
- **Decoding the Garmin Panoptix stream:** no open decoder exists, and it would tie Sisu Nav to the 722xs.

#### Haul-out rule (prevents a repeat)

Before every haul-out: **turn off sonar ping** (or the instrument breaker), pull the depth sounder's insert and fit its blanking plug if it has one, and mark the transducer positions for the yard's slings and stands. Proposed for `OPS.md` (owner to confirm). For the UDST800: Airmar's paddlewheel insert can be swapped for its blanking plug (whether Sisu's has one aboard is **UNVERIFIED**).

### 2.5 Camera: CAM220IP (new 2026-10-23)

- **What:** Raymarine CAM220IP, a 1080p H.264/MJPEG IP camera, 12 V DC or PoE (IEEE 802.3af class 2), DHCP client by default. Ports 80 (web UI), **554 (RTSP)**, 2700, 2300 (CAM220IP manual).
- **Viewable without the MFD:** a Raymarine staff answer on their forum gives RTSP paths for third-party players: `rtsp://<camera-ip>:554/h264&basic_auth=<base64 user:password>` (high-res) and `/h264-2` (low-res). It is not ONVIF, so no auto-discovery. Not tested on Sisu (**UNVERIFIED**).
- **Into Sisu Nav:** the same pipeline as F1. **go2rtc** on the edge box pulls the RTSP stream (the edge box is already on RayNet, §3.2 C), and the Sisu Nav API proxies it to a panel (`api/video/` + `plugins/sonar-video/`, which becomes a general `plugins/video/`). No new hardware.
- **Addressing:** the camera gets its address from the RayNet DHCP server (the MFD today, the edge box after Phase 5). Find it in the edge box's ARP/DHCP list.
- **Security:** the default login is **admin / 1234**. Change it before the stream is used, and keep the camera reachable only from the edge box (§8.1).
- If the CAM220IP plugs into the MFD's own port rather than a switch, it moves to the RayNet switch (§7).

---

## 3. Hardware and network

### 3.1 Target architecture

```mermaid
flowchart LR
  subgraph RayNet["RayNet segment 198.18.0.0/21 (own switch, no router)"]
    Q[Quantum, model TBD<br/>DHCP client]
    AX[Raymarine MFD, model TBD<br/>DHCP server + 198.18.0.32-3.255]
    CAM[CAM220IP camera<br/>DHCP client, RTSP :554]
    SW[(Unmanaged switch<br/>12 V)]
    Q -- "A80513 or cut cable" --- SW
    AX -- "A62360 / A80151" --- SW
    CAM -. "location TBD" .- SW
  end
  subgraph F8["TerraMaster F8 (Docker, host network)"]
    NIC2[USB 3 GbE NIC<br/>198.18.0.10/21, no gateway]
    MY[mayara-server :6502]
    SK[Signal K :3000<br/>+ mayara plugin<br/>Radar API v3.4]
    NAV[Sisu Nav API :8088<br/>+ web map]
    ETH0[eth0 10GbE<br/>192.168.0.21/24]
    NIC2 --> MY --> SK --> NAV
    ETH0 --- SK
  end
  SW --- NIC2
  N2K[N2K backbone<br/>UDST800 depth/speed/temp, heading, GPS,<br/>AIS700, Ray60/70, 2x YDEG-04 engines] --> GW[YDWG gateway] --> SK
  PX[Panoptix PS51-TH] -- "Garmin Marine Network<br/>proprietary, not read" --> GM[Garmin GPSMAP 722xs<br/>stays the sonar display]
  ETH0 --- LAN[GL-BE9300 Sisu LAN<br/>192.168.0.0/24]
  LAN --> B[Browsers / phones<br/>Sisu Nav radar layer]
```

With the **edge box (§3.2 option C)**, the `F8` subgraph's NIC2 and `mayara-server` move to the edge box. The edge box's LAN port reaches Signal K on the F8. The F1 capture stick and any D1 sensor plug into the edge box, and its go2rtc also pulls the CAM220IP's RTSP stream from RayNet (§2.5).

### 3.2 Network design

- **Keep RayNet and the Sisu LAN apart.** Plugging RayNet straight into the GL-BE9300 would put two DHCP servers (the Axiom and the router) on one segment, and the radar could end up on the wrong one. RayNet stays its own Layer-2 segment and the F8 joins it through a **second interface**.
- **F8 second interface.** The F8 SSD Plus has **one** RJ-45 10GbE port (eth0, 192.168.0.21/24, checked on the box 2026-10-19) and **three USB 3.2 Gen 2 ports** (2× A, 1× C), with no PCIe slot. Two ways:
  - **A (alternative, cheapest): USB 3 Gigabit Ethernet adapter** dedicated to RayNet. Whether TOS has a driver for common chipsets (RTL8153, AX88179) is **UNVERIFIED**. Test before relying on it. Whether the setting survives TOS updates is **UNVERIFIED**.
  - **B: VLAN** on a managed switch with a tagged sub-interface on eth0. Fewer parts, but IGMP snooping on the managed switch is the most likely cause of "radar found, no image" on 232.x groups, and the GL-BE9300 would need its VLAN set up so it does not route or DHCP that VLAN. Use only if A fails.
  - **C (recommended): a 12 V edge box.** A small Linux computer (Raspberry Pi 5 with a USB 3 GbE adapter, or a fanless N100-class mini PC with two Ethernet ports) on a fused 12 V feed:
    - **NIC 1** on RayNet: 198.18.0.10/21, no gateway, same rules as A.
    - **NIC 2** on the Sisu LAN.
    - It runs **mayara**, **go2rtc** for F1 (the capture stick plugs in here) and the **CAM220IP** stream (§2.5), and the **D1 sonar service** if D1 goes ahead.
    - It feeds Signal K on the F8 over the LAN: the mayara plugin points at the edge box.

    Why it's better than A:
    - no dependency on TOS USB drivers;
    - RayNet multicast never touches the F8;
    - radar and sonar keep running on 12 V with the inverter off (the F8 is AC-powered, §7.4);
    - it can later be the RayNet DHCP server for Phase 5 without touching the NAS.

    Cost: one more box to keep updated (pinned images, cyber-check). Sailing Exodus runs Quantum radar on a ~$150 Raspberry Pi.

    Is a Pi 5's USB NIC fast enough? Quantum is only ~6 kB/s, so yes in principle, but sustained multicast on the Pi's USB NIC is **UNVERIFIED**; the N100 box with two built-in NICs avoids that question.
- **Addressing, with the Axiom staying as DHCP server (recommended):** give the RayNet interface (edge box, or the F8 under option A) a **fixed 198.18.0.10/21** (anything in 198.18.0.2–.19), **no default gateway, no DNS**, so the F8's internet route stays on eth0. Never use 198.18.0.32–198.18.3.255. Pass `-i <raynet-iface>` to mayara so it does not listen on eth0.
- **Addressing, if the radar must work with the Axiom off:** run `dnsmasq` (or isc-dhcp-server) on the RayNet interface of the edge box (option C) or the F8 (option A), server address **198.18.0.1**, pool **198.18.4.0–198.18.7.254**, short lease. **This conflicts with the Axiom's own DHCP server.** Raymarine's options are "Raymarine device as sole DHCP server" or carefully split ranges (81411). Users in radar_pi #272 used short leases and switched their server off before powering the Axiom. Treat this as Phase 5, only after testing at the dock. Turning DHCP off on the Axiom (diagnostics menu) is **UNVERIFIED**.
- **Switch:** a plain unmanaged switch works. The radar_pi maintainer tested a Quantum, an Axiom and a PC on an unmanaged Sitecom switch (radar_pi #272). Unmanaged switches flood multicast, which is harmless at Quantum's ~0.06 MB/turn. Raymarine's own HS5 / RNS-5 switches are **not required**. A switch that runs on 12 V DC is preferred, so it stays up when the inverter is off.
- **Multicast/IGMP:** unmanaged switch, no problem. Managed switch: IGMP snooping must let `224.0.0.1`, `232.1.1.1` and `232.1.x.x` through (source-specific IGMPv3 joins), or turn snooping off on that VLAN.
- **Docker:** mayara needs `network_mode: host`, the same as Signal K on the F8 today.
- **Power-on dependencies:**
  - Radar wired + F8 DHCP: no Axiom needed. Radar wired + Axiom DHCP (recommended start): **Axiom must be on to hand out the lease**. Once the radar has an address it keeps working with the Axiom off until power-cycled or the lease expires (radar_pi #272: the "Axiom may be turned off" observation). The radar sleeps about 12–15 minutes after failing to get an address.
  - Radar on Wi-Fi to the Axiom: Axiom must always be on.

### 3.3 Shopping list

Prices are Raymarine US list prices from raymarine.com, read 2026-10-19. Exact cables depend on §0.3.

| Item | Part | Price | Needed when | Source |
|---|---|---|---|---|
| RayNet (M) → RJ45 (M) adaptor, 100 mm | **A80513** | $22.99 | Fit on the radar data cable's RayNet (F) end where it now plugs into the Axiom, to plug it into the switch | [raymarine.com](https://www.raymarine.com/en-us/our-products/networking-and-accessories/raynet/raynet-to-rj45-male-adaptor-cable) |
| RayNet (F) → RJ45 (M) cable, 1 m | **A62360** | $84.99 | Axiom RayNet port → switch (short run) | [raymarine.com](https://www.raymarine.com/en-us/our-products/networking-and-accessories/raynet/raynet-f-to-rj45-m-cables) |
| RayNet (F) → RJ45 (M) cable, 3 m | **A80151** | $89.99 | Same, longer run | same |
| RayNet (F) → RJ45 (M) cable, 10 m | **A80159** | $144.99 | Same, if the switch is far from the Axiom | same |
| RayNet (F) → RJ45 (M) cable, 30 m | 308-0251-30-00 | $119.99 | Long run (right-angle: 308-0252-30-00, $119.99) | same |
| RayNet (F) → RJ45 (F) adaptor, 100 mm, waterproof gland | A80247 | $84.99 | Probably **not** needed. Joins a plain RJ45 cable onto a RayNet device or switch | [raymarine.com](https://www.raymarine.com/en-us/our-products/networking-and-accessories/raynet/raynet-female-to-rj45-female-adaptor) |
| Unmanaged gigabit switch, 5-port, 12 V DC | any | not priced | Option A or C | — |
| USB 3 gigabit Ethernet adapter | any (RTL8153 / AX88179 class) | not priced | Option A (**UNVERIFIED on TOS**), or option C on a Pi 5 | — |
| Short Cat5e/6 patch cables | — | — | switch ↔ F8 adapter | — |
| 12 V edge box | Raspberry Pi 5 + USB 3 GbE, or fanless N100 mini PC with 2× LAN; 12 V input or a 12 V→5 V/19 V regulated converter | not priced | §3.2 option C | — |
| Forward-looking sonar | **EchoPilot FLS 3D** (30° or 60°) | ~£5,000 (30°); 60° **UNVERIFIED** | F1 | [EchoPilot FLS 3D](https://echopilot.com/products/fls-3d/) |
| USB HDMI capture stick (UVC) | any UVC 1080p class | not priced | F1 | — |
| Down/side imaging (only if D1) | **Cerulean Omniscan 450 SS** + **S500**, or **Ping2** (down only) | Omniscan ~$5,400; S500 $595 (2020 slide, current **UNVERIFIED**); Ping2 not priced | D1 | [Omniscan 450](https://robotshop.com/products/cerulean-omniscan-450-side-scan-sonar-for-marine-exploration-blueboat-bluerov2), [S500](https://www.unmannedsystemstechnology.com/company/cerulean-sonar/sounder-s500/), [Ping2](https://bluerobotics.com/store/sonars/echosounders/ping-sonar-r2-rp/) |
| Through-hull fairing blocks / in-hull tube | to suit the F1/D1 sensors and Sisu's hull | — | F1, D1 | §7 |

Not needed, and listed only to avoid buying the wrong part: **A80229** is a 15 m digital cable for HD/Super HD radars, not the Quantum. The Quantum data cables are A80274/A80275/A80310/A80311 (5/10/15/25 m), its power cables A80309/A80369 (10/15 m), the Y-adapter A80308 and the RayNet joiner A80162 (Raymarine 87342). The radar_pi maintainer says a RayNet cable can be cut and fitted with RJ45 plugs ("only 4 wires are important"). That is cheaper but voids the cable and is **not a Raymarine-approved method**.

---

## 4. Software

### 4.1 mayara on the F8 (or the edge box)
The same service runs on the edge box under option C. Its compose file lives in the repo like the F8's (Mac is the source of truth, rule 12).
- Our own service in `homeassistant/docker-compose.yml` next to Signal K, or a new compose file: `ghcr.io/marineyachtradar/mayara-server:<pinned tag>`, `network_mode: host`, command `mayara-server -i <raynet-iface>`, restart `unless-stopped`. Pin the version. Do not use `:latest` aboard.
- Check it first with mayara's own GUI at `/gui/` on port 6502, through an SSH tunnel (`ssh -L 6502:127.0.0.1:6502 <edge box or F8>`, then `http://localhost:6502/gui/`): radar found, image turning, range/gain controls work, Doppler colours. Port 6502 is not opened on the LAN (§8.1).

### 4.2 Signal K
- Install `@marineyachtradar/signalk-plugin` (Signal K App Store), configured for the external mayara at `http://<edge box LAN IP>:6502` (option C) or `http://127.0.0.1:6502` (option A) (**UNVERIFIED** option name).
- Check `GET /signalk/v2/api/vessels/self/radars` and `/{id}/capabilities` through `:3000`.

### 4.3 Sisu Nav radar layer
The map is MapLibre GL **6.15** + React 18 + Vite (`web/package.json`; upgraded from 5.x in #207, which also set up maplibre's module worker with `setWorkerUrl`; any new web worker, e.g. for spoke or protobuf decoding, needs the same `?url` import so Vite emits it). Plugins are `NavPlugin` objects (`web/src/app/plugin.ts`, slot `map` / `panel`) loaded by `web/src/app/loadPlugins.ts`. The weather plugin already draws its own canvas over the map (`web/src/plugins/weather/particles.ts`).

New files, all in `sisu-nav/web/src/plugins/radar/`:

| File | Does |
|---|---|
| `index.ts` | `NavPlugin` `{ id: 'radar', slot: 'panel' }` |
| `RadarPanel.tsx` | power (standby/transmit), range, gain/sea/rain (auto/manual), Doppler on/off, opacity, guard zone; built from `/capabilities`, not hard-coded |
| `api.ts` | REST to the Signal K Radar API using the existing token from `app/sk.ts` |
| `spokes.ts` | WebSocket `/radars/{id}/spokes`, protobuf decode (mayara `.proto`, path in its repo **UNVERIFIED**; `protobufjs` would be a new dependency), writes each spoke into a polar texture (spokes × samples, R8) |
| `overlay.ts` | MapLibre **custom WebGL layer** (`type: 'custom'`): fragment shader maps each screen pixel to range and bearing from the boat's position (Signal K `navigation.position`), turned by heading (`navigation.headingTrue`), scaled by the current range; Doppler samples coloured from the legend in `/capabilities` |
| `targets.ts` | ARPA targets from `/targets` + `/signalk/v1/stream` as a GeoJSON symbol layer with CPA/TCPA |
| `radar.css`, `README.md` | styles; how the layer works |

Optional: `sisu-nav/api/radar/` + `/api/radar/*` in `api/server.mjs` to proxy the WebSocket, if the browser should only ever talk to `:8088`.

Notes:
- Bandwidth is tiny: Quantum ≈ 0.06 MB per turn. A Wi-Fi browser is fine (unicast WebSocket, not multicast).
- The Signal K spec says a provider may stand the radar down when nobody is subscribed. Keep the WebSocket open only while the layer is on.
- Heading: Quantum's own heading vs Signal K heading is **UNVERIFIED**. Start with Signal K heading and a configurable bearing offset (installation control).

---

## 5. Migration phases

| Phase | What | Exit criterion |
|---|---|---|
| **0 — survey** (can run alongside 1a) | §0: radar label, Axiom model + RayNet ports, radar link (cable/Wi-Fi), dead transducer models and positions, other Axiom roles | §6 questions 1–5 answered, with photos |
| **1a — Wi-Fi proof of concept, no purchase (start now)** | MacBook joins the **Axiom's own Wi-Fi network** (the one the radar paired with); runs the macOS mayara binary (`mayara-server-v3.14.0-universal-apple-darwin`, 16 MB) with `--allow-wifi -i <wifi iface> -vv`; GUI at `http://localhost:6502/gui/` | mayara finds the radar and shows an image; controls work. Expect some missing spokes on Wi-Fi; the Axiom must stay on |
| **1b — wired dock test** | MacBook (USB-C Ethernet) on RayNet with a fixed 198.18.0.10/21 via an RJ45 adapter (A80513) at a RayNet switch or a free Axiom RayNet port; Axiom as DHCP server; mayara `-i <ethernet iface>` | Clean image without missing spokes; Doppler colours seen |
| **2 — hardware + mayara** | Buy §3.3 items; switch on 12 V. **C:** edge box on 12 V, RayNet NIC 198.18.0.10/21, LAN NIC on the Sisu LAN, mayara container. **A:** USB NIC on the F8 at 198.18.0.10/21, mayara container | Radar image in mayara GUI (via SSH tunnel, §8.1) for 4 h, no lost spokes, F8 internet and LAN unaffected, Axiom radar page still normal |
| **3 — Signal K plugin** | Install and configure `@marineyachtradar/signalk-plugin` | `/radars`, `/capabilities`, `/spokes` work through `:3000` |
| **3b — radar in Freeboard-SK** | No code: open Freeboard-SK on `:3000`, turn on the radar overlay | Radar lines up with the chart at the dock; usable at sea while Phase 4 is built |
| **4 — Sisu Nav radar layer** | `web/src/plugins/radar/` (§4.3) | Radar overlay lines up with charts and AIS (check against fixed marks at the dock and a passing boat) |
| **5 — radar without Axiom (required before the Axiom is retired)** | Edge box (option C) or F8 (option A) runs DHCP on RayNet (§3.2), with the Axiom's DHCP handled | Radar comes up from cold with the Axiom off, and the Axiom still works when switched on |
| **5b — CAM220IP in Sisu Nav** | go2rtc on the edge box pulls the camera's RTSP (§2.5); camera password changed; Sisu Nav panel | Camera live in Sisu Nav without the MFD's camera page |
| **6a — F1 forward-looking** | Order EchoPilot FLS 3D (after confirming control without an MFD); bow through-hull at the next haul-out; HDMI → capture stick → go2rtc (MSE) → Sisu Nav API `api/video/` → `plugins/sonar-video/` | Forward view live in Sisu Nav for 4 h without dropping; latency noted; obstacles at known distances seen at the dock |
| **6b — D1 down/side (if chosen)** | Buy and mount Omniscan 450 SS + S500 (or Ping2); service → Signal K depth (own `$source`) + image stream; Sisu Nav `plugins/sonar/` | Its depth tracks the main sounder over a season; waterfall/side-scan show the bottom and anchor-set events |
| **7 — MFDs retired as they fail** | Radar DHCP on the edge box (Phase 5) done first; helm screens are waterproof HDMI touch monitors + small fanless PCs running Sisu Nav; ESP displays for instrument pages | Each failed MFD's role is already covered when it dies |

**Radar transmit safety (Phases 1a, 1b and every dock test):** transmit only with nobody near the radome or at its height (mast, flybridge, a neighbouring boat's deck), keep transmit sessions short at the dock, and return the radar to **standby** when done. Check marina rules on radar transmit.

---

## 6. Open questions (for Frik)

1. **Still unknown (manuals index has only "Quantum"):** exact radar part number (`E70498` / `E70498-B` / bundle `T70417`, or a first-generation Quantum?) and its software version.
2. **Still unknown (not on file in the manuals index):** the Raymarine MFD model(s) (earlier notes: Axiom, Axiom Pro), LightHouse version and number of RayNet ports. Garmin: GPSMAP 722xs (confirmed by the index); its software version?
3. Radar link to the Axiom: RayNet cable, Wi-Fi, or both?
4. **Raymarine sonar:** the manuals index lists none, but the 2026-10-19 note says a RealVision transducer died. Is there a Raymarine transducer aboard at all? Also: is the Panoptix PS51-TH definitely dead (transducer, cable or the 722xs)? Positions of every transducer, for removal or blanking.
5. What else the Raymarine MFD does (autopilot, alarms) that must keep working? Where is the **CAM220IP** shown today, and does it plug into the MFD or a switch? Is the **AIS700** on N2K (and set up from the MFD or its own PC tool)? Which radio is fitted (**Ray60 or Ray70**), and is it on N2K?
6. ~~Is the Axiom staying?~~ **Decided 2026-10-19:** the Raymarine MFD(s) and the Garmin stay only as backups until they fail and are not replaced. (Updated 2026-10-23: the Raymarine MFD is not the sonar display, so after Phase 5 and §2.5 nothing here needs it.)
7. OK to add a USB Ethernet adapter on the F8 (option A), or prefer a VLAN (option B)?
8. Phase 5 (radar with the Axiom off) is now required. **When:** before the Axiom is retired, or sooner?
9. F1: confirm EchoPilot FLS 3D (30° or 60°) and the budget. **How is it controlled without an MFD** (own keypad, PC app)? When is the next haul-out for the bow through-hull?
10. D1: Omniscan 3D 450 SS, 450 SS, Ping2, or skip?
11. **Questions for Cerulean:** can the Omniscan 3D 450 SS be mounted facing forward for a forward depth profile? What is its swath (one or both sides)? Is there a yacht through-hull mounting option? Does SonarView/SonarLink run headless in Docker on an x86 or ARM edge box?
12. Radar proof of concept: which Axiom (Axiom or Axiom Pro) does the radar pair with, and that Axiom's Wi-Fi network name/password (for 1a)? Is the radar's RayNet cable plugged into an Axiom or a RayNet switch (for 1b)?
13. Edge box (§3.2 C) or USB NIC on the F8 (A)?
14. Panoptix: while the 722xs is aboard, is phone mirroring through the ActiveCaptain app (Helm) enough, or is forward-looking sonar in Sisu Nav (F1) wanted?

## 7. For Sisu Engineer (cabling and power)

1. How the RayNet cable runs from the radar to the Axiom, the connector at the Axiom end, and whether the radar data cable can reach a switch location near the F8 (or the switch near the Axiom, with one RJ45 run to the F8).
2. Whether the Quantum's data and power are separate cables or use the A80308 Y-adapter. Radar power is unchanged by this plan.
3. A dry mounting spot for a small unmanaged switch, and **12 V DC power** for it on a fused feed (preferably the nav-electronics breaker, so the radar network is up whenever the radar is).
4. The F8 runs from its own AC adapter (100–240 V AC → 12 V DC barrel jack, 72 W). Radar overlay with the inverter off would need the F8 on 12 V DC (**UNVERIFIED** whether running it directly on boat 12 V is safe; it would need a regulated supply).
5. Whether the Raymarine MFD's RayNet port is free, or already used by the radar or the **CAM220IP**. How the CAM220IP is powered (12 V or PoE) and where its cable runs; it should end up on the RayNet switch.
6. **Sonar mounting:** a bow through-hull position for the EchoPilot (F1) and, if D1 goes ahead, spots for its transducers. Hull material and thickness, distance from the depth transducer, cable routes to the edge box.
7. **Edge box:** a dry spot near the RayNet switch with a fused 12 V feed on the nav-electronics breaker.

## 8. Risks

| Risk | Effect | Mitigation |
|---|---|---|
| Two DHCP servers on RayNet | Radar or Axiom on the wrong address, erratic behaviour that looks like a cable fault | Axiom stays sole DHCP server; F8 fixed at 198.18.0.2–.19 |
| F8 address in 198.18.0.32–3.255 | Clash with the Axiom's self-chosen address | Use 198.18.0.10 only |
| RayNet interface gets a gateway | F8 internet / LAN routing breaks | No gateway, no DNS on that interface |
| TOS lacks USB NIC driver or drops the setting on update (option A only) | No radar on F8 | Use the edge box (§3.2 C), the recommended option; or a VLAN (B) |
| Managed switch IGMP snooping | Radar found, no image | Unmanaged switch |
| Radar on Wi-Fi to the Axiom | Axiom must stay on; 2.4 GHz drops | Wire it (RayNet) |
| mayara is young and fast-moving | Regressions | Pin versions; Axiom stays as backup radar |
| Overlay misalignment (heading, bearing offset) | Wrong target positions on chart | Dock alignment check (Phase 4); configurable offset |
| Relying on Sisu Nav for collision avoidance | Safety | Axiom remains the certified-path radar display until Sisu Nav has a season of use |
| Sonar left pinging during a haul-out | Transducer runs dry and dies (what killed the RealVision) | Haul-out rule in §2.4: ping off, pull inserts, mark positions |
| EchoPilot needs an MFD for control | F1 harder to run MFD-free | Confirm before ordering (§2.4 F1) |
| D1 hardware is drone-grade, not yacht-grade | Reliability unknown | Experiment only; the UDST800 stays the navigation depth source |
| CAM220IP default login (admin / 1234) | Anyone on RayNet (or the LAN, if it leaks) can view or reconfigure the camera | Change the password; reach it only from the edge box (§8.1) |
| Equipment list conflicts (RealVision note vs manuals index) | Plan built on a wrong picture of the sonar | Frik confirms §6.4 before any sonar purchase |

### 8.1 Security (cyber-check)

New services join the boat's attack surface, so they follow the cyber-check rules (`skills/cyber-check/SKILL.md`):
- **mayara** (GUI and control API on `:6502`) and **go2rtc** (`:1984`, RTSP 8554, WebRTC 8555) have **no login by default** (go2rtc can set an API username/password; set it).
- **Who may reach them:**
  - **Option C (edge box):** the edge box's host firewall allows `:6502` **only from the F8 (192.168.0.21)**, for the Signal K plugin. It allows go2rtc's ports only from the F8, for the Sisu Nav API proxy (`api/video/`). Everything else on the LAN is dropped.
  - **Option A (F8):** mayara and go2rtc bind to `127.0.0.1` (plus mayara's RayNet interface for radar traffic). Signal K and the Sisu Nav API reach them locally.
  - **Admin access** to the mayara GUI and the go2rtc UI is only through an SSH tunnel (§4.1), never a LAN or firewall allow.
- **Radar controls** (transmit, range) would otherwise let anyone on the LAN switch the radar to transmit. Control goes only through the authenticated Signal K Radar API.
- **CAM220IP:** change the default password; only the edge box's go2rtc pulls its RTSP stream; the camera's web UI is reached only through an SSH tunnel.
- **D1** (if it goes ahead): its sensors sit on the edge box's own interface only. Their open Ethernet API is never reachable from the LAN (same firewall rule as mayara).
- Pin every image by digest (as in #209). The edge box gets the weekly `cyber-check.sh` sweep like the F8.
- RayNet stays its own segment with no route to the Sisu LAN except through mayara or the edge box.

## Sources

- mayara-server: [repo + README](https://github.com/MarineYachtRadar/mayara-server), [Raymarine setup guide](https://github.com/MarineYachtRadar/mayara-server/blob/main/web/gui/help/raymarine.html), [radar networking](https://github.com/MarineYachtRadar/mayara-server/blob/main/web/gui/help/networking.html), [ENDUSER.md](https://github.com/MarineYachtRadar/mayara-server/blob/main/ENDUSER.md), [DEVELOPER.md](https://github.com/MarineYachtRadar/mayara-server/blob/main/DEVELOPER.md), [releases](https://github.com/MarineYachtRadar/mayara-server/releases) (v3.14.0, 2026-10-09).
- Signal K Radar API v3.4.0: [demo.signalk.org docs](https://demo.signalk.org/documentation/Developing/REST_APIs/Radar_API.html).
- mayara Signal K plugin: [repo](https://github.com/MarineYachtRadar/mayara-server-signalk-plugin), [npm](https://npm.io/package/@marineyachtradar/signalk-plugin) (v1.8.0, 2026-10-11).
- OpenCPN radar_pi: [repo](https://github.com/opencpn-radar-pi/radar_pi), [releases](https://github.com/opencpn-radar-pi/radar_pi/releases), [#272 Quantum 2 Q24D + Axiom](https://github.com/opencpn-radar-pi/radar_pi/issues/272), [#281 Quantum Q24C](https://github.com/opencpn-radar-pi/radar_pi/issues/281), [#278 KAHU / mayara](https://github.com/opencpn-radar-pi/radar_pi/issues/278); [mayara_pi](https://github.com/opencpn-radar-pi/mayara_pi).
- Clients: [Freeboard-SK](https://github.com/SignalK/freeboard-sk), [Binnacle](https://github.com/NearlCrews/signalk-binnacle).
- Raymarine: [Quantum 2 Q24D applicable products (87342)](https://docs.raymarine.com/87342/en-US/latest/ApplicableProducts-3A420983.html), [Quantum accessories (87342)](https://docs.raymarine.com/87342/en-US/latest/QuantumRadarAccessories-D1E52D17.html), [IPv4 networking with third-party products (81411)](https://docs.raymarine.com/81411/en-US/latest/IPNetworkingOfRaymarineDevicesWithT-4639FB01.html), [RayNet (F) → RJ45 (M) cables](https://www.raymarine.com/en-us/our-products/networking-and-accessories/raynet/raynet-f-to-rj45-m-cables), [A80513](https://www.raymarine.com/en-us/our-products/networking-and-accessories/raynet/raynet-to-rj45-male-adaptor-cable), [A80247](https://www.raymarine.com/en-us/our-products/networking-and-accessories/raynet/raynet-female-to-rj45-female-adaptor), [Axiom 2 Pro HDMI (87443)](https://docs.raymarine.com/87443/en-US/latest/ConnectionsOverviewRVMVariantDispla-D4FFB08A.html), [Raymarine app](https://www.raymarine.com/en-us/our-products/apps-integrations/raymarine). Part-number cross-check: [Lusty & Blundell](https://www.lusty-blundell.co.nz/product-group/14842-raymarine-raynet-to-rj45-cable/category/1765-raynet-seatalkhs), [The Boat Warehouse](https://www.theboatwarehouse.com.au/networking-and-adaptor-cables/raymarine-raynet-f-to-rj45-m-cable/), [Citi Marine T70417](https://citimarinestore.com/en/raymarine-radars-pedestals/12876-raymarine-quantum-2-q24d-radar-doppler-w-15m-power-data-cables-t70417.html).
- Reverse engineering, radar + sonar: [Sailing Exodus: open source / decoding radar and sonar](https://sailingexodus.net/open-source), [Raspberry Pi radar video, 2026-10-16](https://www.youtube.com/watch?v=2eYEBF7tb8o).
- Freeboard-SK radar support: [Freeboard-SK help](https://demo.signalk.org/@signalk/freeboard-sk/assets/help/index.html); [MaYaRa](https://github.com/keesverruijt/mayara).
- Forward-looking sonar: [EchoPilot FLS 3D](https://echopilot.com/products/fls-3d/), [PBO test of 5 forward-looking sonars](https://www.pbo.co.uk/gear/5-forward-looking-sonar-tested-29321), [Kraken Yachts on forward-looking sonars](https://krakenyachts.com/forward-looking-sonars/), [FarSounder SDK](https://www.farsounder.com/software-development-kit); streaming [go2rtc](https://github.com/AlexxIT/go2rtc).
- Transducers out of water: [Raymarine forum: cooling and running dry](https://forum.raymarine.com/showthread.php?tid=7672).
- Open side scan: [Cerulean Omniscan 450](https://robotshop.com/products/cerulean-omniscan-450-side-scan-sonar-for-marine-exploration-blueboat-bluerov2), [Omniscan 450 docs](https://docs.ceruleansonar.com/c/omniscan-450), [Omniscan 450 API](https://docs.ceruleansonar.com/c/omniscan-450/application-programming-interface.md), [Omniscan 450 FS](https://ceruleansonar.com/product/omniscan-450fs-100m-rated/), [Omniscan 3D 450 SS](https://ceruleansonar.com/product/omniscan-3d-450-ss-2/), [SonarLink API](https://docs.ceruleansonar.com/c/sonarview/sonarlink.md), [SonarView + NMEA heading/position](https://docs.ceruleansonar.com/c/sonarview/session-configurations/omniscan-+-nmea-heading-position.md).
- mayara: [Raymarine guide](https://github.com/MarineYachtRadar/mayara-server/blob/main/web/gui/help/raymarine.html) (Wi-Fi modes, `--allow-wifi`), [v3.14.0 release](https://github.com/MarineYachtRadar/mayara-server/releases/tag/v3.14.0) (macOS universal, Linux musl x86_64/aarch64, Windows).
- Echosounders: [Cerulean S500](https://www.unmannedsystemstechnology.com/company/cerulean-sonar/sounder-s500/), [Ping2](https://bluerobotics.com/store/sonars/echosounders/ping-sonar-r2-rp/), [Ping1D protocol messages](https://docs.bluerobotics.com/ping-protocol/pingmessage-ping1d/), [brping (PyPI)](https://pypi.org/project/bluerobotics-ping/), [Ping Viewer](https://github.com/bluerobotics/ping-viewer).
- Garmin sonar (added 2026-10-23): [Panoptix PS51-TH compatibility (Active GPS)](https://www.activegps.co.uk/garmin-panoptix-ps51-th-frontvu-transducer.htm), [GPSMAP 722xs product page (Garmin Singapore)](https://www.garmin.com.sg/products/discontinued/gpsmap-722xs/), [GPSMAP 722/922 change history (Helm in ActiveCaptain, v10.00)](https://www8.garmin.com/support/ch.jsp?product=010-01738-00), [ActiveCaptain app](https://apps.apple.com/us/app/activecaptain/id1116089313), [Garmin RSD format (Oppmann)](https://www.memotech.franken.de/FileFormats/Garmin_RSD_Format.pdf), [PINGVerter](https://github.com/CameronBodine/PINGVerter), [PINGMapper](https://cameronbodine.github.io/PINGMapper/docs/gettingstarted/Running.html), [mayara Garmin radar setup](https://github.com/MarineYachtRadar/mayara-server/blob/main/docs/garmin-setup.md).
- CAM220IP (added 2026-10-23): [Raymarine forum: CAM220IP with non-Raymarine MFDs (RTSP URLs)](https://forum.raymarine.com/showthread.php?tid=11432), [CAM220IP installation and operation instructions](https://productimageserver.com/literature/ownersManual/61741OM.pdf).
- Equipment list: Frik's `5_Inbox/Manuals_index.md` (via Sisu Engineer, 2026-10-23): Airmar UDST800 `44-218-1-01`, Garmin GPSMAP 722xs + Panoptix PS51-TH, Raymarine MFD network, Quantum, CAM220IP, Ray60/70, AIS700, 2× Yacht Devices YDEG-04.
- TerraMaster F8 SSD Plus ports: [terra-master.com](https://www.terra-master.com/products/f8-ssd-plus), [TechPowerUp review](https://www.techpowerup.com/review/terramaster-f8-ssd-plus/3.html).
