Cadburies/SisuAssistant/.ai_context/feature_map/ext/sv3c-cameras.md

---
title: SV3C PoE cameras (device)
id: ext/sv3c-cameras
kind: device
tags: sv3c camera poe onvif aft forward device web ui
status: unverified
script: sv3c-cameras.sh
---
Two SV3C PoE cameras (forward `.33`, aft `.34`) controlled by HA over ONVIF. Roles swapped 2026-10-04 (#193): forward is MAC `F0:00:00:40:4E:96`, aft is MAC `F0:00:00:41:BC:CE`.

- **Reach:** Device web UIs `http://192.168.0.33/` (forward) and `http://192.168.0.34/` (aft)
- **Action:** camera settings on the device; modes from HA (Cameras).
- **Needs:** on the boat LAN; PoE switch powered
- **Expect:** Web UI and ONVIF answer. Observed offline 2026-09-26 (#172).
- **Source:** `homeassistant/packages/sv3c_aft_camera.yaml` · `homeassistant/packages/sv3c_forward_camera.yaml`
