Cadburies/SisuAssistant/.ai_context/feature_map/ext/ol43.md

---
title: Veratron OL43 helm display (planned)
id: ext/ol43
kind: device
tags: veratron ol43 helm display gauges nmea 2000 planned
status: planned
script: ol43.sh
---
Planned N2K helm gauge display; primary navigation data stays on N2K.

- **Reach:** At the helm (not yet installed)
- **Action:** none yet.
- **Needs:** N2K backbone; device installed
- **Expect:** Not installed.
- **Source:** `NETWORK.md` (`OL43`)
