Cadburies/SisuAssistant/.ai_context/feature_map/hw/marine-board/field-output.md

---
title: Marine Board › Field PWM output (CN2)
id: hw/marine-board/field-output
kind: hardware
tags: pwm field output cn2 mosfet fuse f3 alternator drive
status: live
script: field-output.sh
image: MarineBoard/Documentation/Schematics/PWM Drivers.png
order: 20
---
Low-side PWM drive for the alternator field on **CN2** (+12V BAT, PWM): MCP1407 gate driver → BUK762R4-60E MOSFET, VS-43CTQ100S freewheel, fused by F3 (10 A), ~10 A continuous (copper-limited).

- **Reach:** Connector **CN2**
- **Action:** wire the field winding between +12V BAT and PWM; add load-side fusing for inductive loads.
- **Needs:** physical access to the board; power off before wiring
- **Expect:** Field duty follows the controller; 0 % in Shadow.
- **Source:** MarineBoard/Technical Specs.md (§PWM output) · `MarineBoard/MarineBoard.kicad_sch`
