Cadburies/SisuAssistant/.ai_context/feature_map/ha/cameras/aft.md

---
title: Cameras › Aft camera (SV3C)
id: ha/cameras/aft
kind: device
tags: aft camera sv3c onvif poe mode off on sentry motion photo burst snapshot reboot reinit
status: live
script: aft.sh
---
SV3C PoE camera (watches the dinghy at the aft cockpit): Off / On / Sentry modes, motion → photo burst, a timed snapshot every 5 min in Sentry, reboot and clock-sync buttons.

- **Reach:** HA → **Sisu** → **Cameras** (mode) or Settings → Devices → **Aft Camera** (reboot / set time) · camera `192.168.0.34` (MAC `F0:00:00:41:BC:CE`, role swapped #193)
- **Action:** choose **Mode**: Off (no stream), On (live stream), Sentry (motion → burst + timed snapshots); **Reinit** after a power cycle reloads ONVIF and sets the clock; **Reboot** restarts the camera; **Set system date and time** syncs its clock.
- **Needs:** camera powered on the PoE switch · on the boat's Sisu Wi-Fi/LAN · HA REST with `ha_token`
- **Expect:** Mode shows the choice; stream live when reachable; last snapshot summary names the trigger and time. While the camera is offline no snapshot is taken and the last-snapshot time does not move. **Reinit** reloads ONVIF, waits until the stream is back, then sets the clock.
- **Source:** `homeassistant/packages/sv3c_aft_camera.yaml` · `homeassistant/ui-lovelace.yaml` (`title: Cameras`)
