Cadburies/SisuAssistant/.ai_context/feature_map/nav/layout/layout-gear.md

---
title: Sisu Nav › Layout gear (panel stack)
id: nav/layout/layout-gear
kind: control
tags: layout gear edit panels order hide show stack right instruments edit mode
status: live
script: layout-gear.sh
order: 20
---
Edit mode for the right-hand panel stack: show/hide and reorder panels; also puts Instruments into drag-and-edit mode.

- **Reach:** Sisu Nav → **Layout** button next to the "Sisu" header (top of the right stack)
- **Action:** tick/untick panels and use ↑/↓ to reorder; click **Layout** again to leave edit mode.
- **Needs:** on the boat's Sisu Wi-Fi/LAN with the F8 running
- **Expect:** Changes apply immediately and are saved per browser/device (phone and laptop can differ).
- **Source:** `sisu-nav/USER_GUIDE.md` (`## Layout gear`) · `sisu-nav/web/src/plugins/layout/`
