Cadburies/SisuAssistant/.ai_context/feature_map/f8/grafana/power-charging.md

---
title: Grafana › Power & Charging
id: f8/grafana/power-charging
kind: dashboard
tags: grafana power & charging trend history chart
status: live
script: power-charging.sh
---
House bank, solar and alternator charging trends (20 panels).

- **Reach:** Grafana → Dashboards → **Power & Charging** · `http://192.168.0.21:3001/d/sisu-power-charging`
- **Action:** pick a time range; hover for values.
- **Needs:** on the boat's Sisu Wi-Fi/LAN; Grafana login
- **Expect:** Panels draw recent data from `Sisu_raw` (short windows) or `Sisu_1m` (≥1 h); gaps or flat lines where the NMEA feed was silent.
- **Source:** `homeassistant/grafana-provisioning/dashboards/``sisu-power-charging.json`
