Cadburies/SisuAssistant/.ai_context/feature_map/ha/alternators/starboard.md

---
title: Alternators › Starboard gauges & setpoints
id: ha/alternators/starboard
kind: control
tags: starboard alternator current voltage temperature gauge setpoint absorption float field duty charge stage enable fault
status: unverified
script: starboard.sh
---
Starboard alternator: current, house voltage and temperature gauges with coloured bands, the user setpoints under each gauge, and a detail list (enable, stage, field duty, power, fault).

- **Reach:** HA → **Alternators** → section **Starboard** · `http://192.168.0.20:8123/lovelace-alternators/overview`
- **Action:** change the number under a gauge (current, absorption/float voltage, temperature) → sends a new **user setpoint** to the Starboard board. It can only lower targets inside the fixed hard limits (250 A / 14.4 V / 125 °C), which no dashboard can change.
- **Needs:** Starboard Marine Board online (#11) · on the boat's Sisu Wi-Fi/LAN · HA REST with `ha_token`
- **Expect:** Gauges fill with live values and band colours; setpoint numbers match the board. Board offline → gauges and numbers `unavailable`; enable/fault rows missing until the board registers them.
- **Source:** `homeassistant/dashboards/alternators.yaml` (`title: Starboard`) · `homeassistant/esphome/packages/marine_alternator.yaml` · `homeassistant/docs/ALTERNATOR_LIMITS.md`
