Cadburies/SisuAssistant/MarineBoard/Documentation/Panasonic OS-CON land pattern.pdf

Conductive Polymer Aluminum Solid Capacitors

### ◇ Recommendable reflow soldering (SMD type)

*1 SXV series：180°C

### ◇ Flow soldering (Radial lead type)

*1：When soldering 2 times, total immersion time should be 10+1 sec. or less.

### ◇ Soldering with a soldering iron

Tip of a soldering iron | ：400 °C±10 °C
Working time | ：5 sec. max.

TL ≥ 230 °C
TL ≥ 220 °C
TL ≥ 217 °C
TL ≥ 200 °C

Reflow soldering

Peak temperature (TP)

1 times | 2 times

Peak temperature 250 °C
lead free soldering profile (SVPG, SVPF, SVF, SVPK, SXV)

Condition A

180 °C

60 seconds max.

ー

50 seconds max.

40 seconds max.

ー

260 °C | 250 °C Peak temperature 250 °C lead free soldering profile

Peak temperature 260 °C
lead free soldering profile

120 seconds max.

150 °C

2 times

30 seconds max.
ー
ー
90 seconds max.

Condition C

250 °C

ー

F12

C6
C65
C8
C10
C10L | 2.1 | 9.1 | 2.5
| | 13.1 | 1.9

6.2
7.4
Time | Flow number
Size code | a | b
10+1 sec. or less | 2 times or less*1 1 time

31-Oct-25

Unit : mm
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
(ambient temperature) Preheating Soldering condition

120 °C or less
260 °C+5 °C or less

Temperature

## Mounting specifications

120 sec. or less

A5
B45

1.0
1.4

## Land Pattern

200 °C*1

Condition B

The cycles of reflow soldering

Preheat
Time (tS) from (Tsmin) to (Tsmax)

Temperature min. (Tsmin)

Temperature max. (Tsmax)

Soldering time (tL)
above
soldering temperature
(TL)

TL ≥ 245 °C

B6 | 1.4 | 7.4

4.3

2.1
2.1
2.1
2.1

4.3

4.3
13.1

13.1

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
11.1
11.1
11.1

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
tS | tL

TP

Tsmax

Tsmin

TL

Time（sec.）

Temperature on the
surface of capacitor
