Cadburies/SisuAssistant/sisu-nav/web/src/plugins/roses/README.md

# Wind roses — issue #86

This boat’s TWD+AWS history from Influx `Sisu_1m`, Grafana WeatherTWD stacked-rose spec. Glob-loaded. Layer id `roses` on the #85 picker. Do not edit `App.tsx`.
