Cadburies/SisuAssistant/OPS.md

# Sisu operations — agent-first HA Green setup

**Audience:** human operator + coding agent (Grok) on this Mac.  
**Goal:** agent does heavy lifting; human only does physical / router / one-time UI steps.

**Source of truth:** this Mac repo, always. Every config/compose/package change is made here first, verified (`§4`), then pushed to HA Green / F8 — never edited live on the box and back-filled later. This keeps the Mac clone a working backup: if Green or F8 is unreachable, the last-known-good config still exists here.

Related: `NETWORK.md`, `AGENTS.md`, **`INSTALLATION.md`** (wiring & commission), `.ai_context/INDEX.md`, `.ai_context/displays.md`.

## Display map (tablets / MFD browsers)

| Screen | Start URL |
|---|---|
| Vessel home (**Sisu** board) | `http://192.168.0.20:8123/lovelace/default_view` |
| Saloon (water) | `…/lovelace-water` |
| Engine room | `…/lovelace-engine` |
| Alternators detail | `…/lovelace-alternators` |
| Power / Victron | `…/lovelace-power` |
| Helm | `…/lovelace-helm` |
| Sisu Nav (chart / AIS / windex) | `http://192.168.0.21:8088` (Follow me: `https://192.168.0.21:8443`) |

Avoid core **Welcome Sisu** Home as tablet start URL (sidebar house Overview).

Use Fully Kiosk / wallpanel **start URL** per display. Veratron OL43 stays on **N2K**, not HA.
---

## 1. Who does what

| Work | Agent (this Mac) | Human (you) |
|---|---|---|
| Edit YAML in repo, deploy to Green | Yes | No |
| SSH to Green, read logs, fix config | Yes | No |
| Install/configure add-ons after Supervisor access | Yes (once unlocked) | One-time unlock (below) |
| Flash ESPHome via USB or OTA | Yes (Mac USB or HA ESPHome) | Plug USB / power boards |
| GL-BE9300 DHCP / firewall | No | Yes — guided checklist |
| Physical Marine Board / engines | No | When hardware ready |
| TNAS F8 Docker (SK/Grafana/Influx) | Partial (compose) | Power + TOS login |
| Create HA long-lived token | No | One UI click |

**No extra Grok “skills” or MCP servers are required** for vessel work. Local tools: SSH key, `scripts/ha-*.sh`, optional ESPHome CLI.

---

## 2. Access model (already set on this Mac)

| Channel | Value |
|---|---|
| HA UI | `http://192.168.0.20:8123` — user **Sisu** |
| SSH | `sisu@192.168.0.20` port **22** (Advanced SSH & Web Terminal) |
| SSH key | `~/.ssh/id_devman` → Green authorized_keys |
| Secrets | `homeassistant/secrets.yaml` (gitignored) |
| Host alias | `ssh HomeAssistant` or `./scripts/ha-ssh.sh` |

Notes:

- Add-on lowercases the SSH username (`Sisu` → **`sisu`**).
- **SFTP is disabled** on the add-on; deploy with `./scripts/ha-deploy-config.sh` (base64 + `sudo`), not plain `scp`.
- `/config` is root-owned; agent deploys use `sudo` on the Green (same password as SSH for now).
- `ha` CLI from SSH returns *unauthorized* until **Protection mode is off** (human step §4).

---

## 3. Repo helpers

```bash
# SSH (key preferred, password fallback)
./scripts/ha-ssh.sh 'ls /config'

# Deploy full vessel HA + ESPHome tree to Green
./scripts/ha-deploy-config.sh

# Deploy one file
./scripts/ha-deploy-config.sh homeassistant/automations.yaml
```

Mac SSH config host: **HomeAssistant** / **ha** → `192.168.0.20`, user `sisu`, port 22.

**This deploy step is mandatory, not optional, whenever a HAOS-side file changes** (`configuration.yaml`, `automations.yaml`, `packages/*`, `python_scripts/*`, `dashboards/*`, etc.) — a git commit only changes this repo, not what Green is actually running. Pass the exact files touched as arguments (the no-arg form only covers a small curated legacy list); follow with `./scripts/ha-cli.sh core check` before telling anyone it's done. `./scripts/verify.sh <files>` prints the exact deploy line (exit 3) when one is owed. Rule: `CLAUDE.md` §Gates; procedure: `skills/do-issue/SKILL.md` step 6.

---

## 4. Human one-time checklist (do these, then agent owns the rest)

### 4.1 Persist SSH public key in the add-on UI (survives restart)

If you **Save** Configuration with `authorized_keys: []`, the Mac key is wiped and only password works until restored.

**Recommended Configuration YAML** (merge with your password):

```yaml
ssh:
  username: Sisu
  password: "CHANGE_ME"   # use ha_ssh_password from secrets.yaml — never commit real password
  authorized_keys:
    - ssh-ed25519 AAAAC3NzaC1lZDI1NTE5AAAAICXjksxgRAeouHhAsez1EYJlueE7DTEAJL4h1uExLyr1 devman_25e392cc
  sftp: false
  compatibility_mode: false
  allow_agent_forwarding: false
  allow_remote_port_forwarding: false
  allow_tcp_forwarding: false
zsh: true
share_sessions: false
packages: []
init_commands: []
```

1. **Settings → Apps → Advanced SSH & Web Terminal → Configuration**
2. Paste the block above (keep your password if different)
3. **Save** → **Restart** add-on  
4. Confirm: `ssh HomeAssistant 'echo OK'`
### 4.2 Turn off Protection mode (enables `ha` CLI + app installs from SSH)

**Not in the Configuration YAML.** It is a switch on the add-on **Info** page:

1. **Settings → Apps → Advanced SSH & Web Terminal**
2. Open the **Info** tab (top of the app page — next to Documentation / Configuration / Log)
3. Scroll to **Protection mode**
4. Turn it **off**
5. Confirm / restart if asked

If you do not see it: some builds hide it until the app is **Running**. Start the app first, then reopen Info.

From Mac after this:

```bash
# Preferred: HA CLI via supervisor container (reliable on Green)
./scripts/ha-cli.sh apps list

# Direct `ha` inside SSH session may still say unauthorized (token not in shell env).
# Use ha-cli.sh or:  sudo docker exec hassio_cli ha apps list
```

If Protection mode is off and Docker works, agent can manage apps without the in-shell `ha` token.### 4.3 Install ESPHome app (or tell agent after §4.2)

**Settings → Apps → Add-on store → ESPHome Device Builder → Install → Start**  
Enable **Start on boot**, **Show in sidebar**.

After §4.2 the agent can install/start this via `ha apps …`.

### 4.4 Long-lived access token (optional but recommended)

The People **profile** screen (name, picture, password) is **not** where tokens live.

1. **Settings → People → Users** (or click your user **Sisu**)
2. Open the **Security** tab / section (not the profile picture area)
3. Scroll to **Long-lived access tokens**
4. **Create token** → name `agent-mac` → **copy immediately** (shown once)
5. Put in `homeassistant/secrets.yaml` as `ha_token: "…"` (never commit)

If there is no Security section: open  
`http://192.168.0.20:8123/profile/security`  
while logged in as Sisu.
### 4.5 GL-BE9300 (router) — required for real ESP devices

Follow **`NETWORK.md` §3–§4**. Minimum:

| Action | Detail |
|---|---|
| Reserve HA | **192.168.0.20** for Green MAC |
| Reserve TNAS | **192.168.0.21** when F8 online |
| SSIDs | **Sisu** = `192.168.0.0/24`; **Sisu-IoT** = `192.168.10.0/24` (2.4 GHz) |
| Firewall | Allow **192.168.0.20 → 192.168.10.0/24** (ESPHome API) |
| Firewall | Allow **192.168.0.0/24 → .20:8123** (phones on Sisu) |
| Production ESPs | `.41`–`.45` as in NETWORK.md |

Without HA→IoT allow, boards can join Wi‑Fi and still show **unavailable** in HA.

---

## 5. Hardware reality (current)

| Role | Production hardware | Now |
|---|---|-----|
| Alternators | **Sisu Marine Board** (ESP32-S3-WROOM-2-N32R16V) | **None on hand:** the v1.00 prototype was retired (#218). Port shadow commission (`INSTALLATION.md` §6.4, #11) waits for the v1.9.1 boards. Stbd not on hand. |
| Levels | **Sisu Marine Board** | Not on hand yet |
| Saloon guest display | Waveshare ESP32-S3-Touch-LCD-4.3B | Live `.45` |
| Freezer | **Marine Board** v1.9.1, pending — manual until fitted (`freezer_marineboard.yaml`, `.44`, full speed or stop, #221) | LilyGo S3 AMOLED is display only in `freezer_display.yaml` (`.47`, ESP-NOW); offline now, still on the combined build; never flash the retired `archive/freezer.yaml` |
| HA | HA Green | Online `.20` |
| MQTT kernel | HA Green `core_mosquitto` | Live `.20:1883` (`logins:`) |
| Signal K / Grafana / Influx | TNAS F8 | Live on F8 `.21` |

Lab GPIO mapping uses **`bench_marine_board.yaml`** on a Marine Board (not a vessel role). Alternator commission is **shadow on the real Marine Board** (`INSTALLATION.md` §6.4).

---

## 6. Agent workflow after human §4 done

**Source of truth = this Mac** (#181, `CLAUDE.md` rule 12). HA Green and the F8 only ever *receive* config: edit here → commit → push → compile/run on the box. Never edit files on a box. If something was changed on a box (HA UI edit to a YAML file, ESPHome add-on / Device Builder, Signal K admin UI), pull it into the Mac, commit, then push. Box runtime state (HA `.storage`/db/logs, camera snapshots, ESPHome builds, Signal K `serverState`/`applicationData`/`appstore-cache`/`security.json`, Influx/Grafana data) stays on the box and is never pushed over.

`./scripts/stack-drift.sh [green|f8|all]` lists what differs (DIFF / MAC-ONLY / BOX-ONLY); exit 0 = in sync. Run it before and after every deploy.

1. Deploy: `./scripts/ha-deploy-config.sh <files you changed>` (HA Green) · `./scripts/f8-deploy.sh` (F8); then `./scripts/stack-drift.sh`
2. Restart Core if needed (UI or `ha core restart`)
3. Ensure ESPHome app running
4. When Marine Boards exist: flash `alternatorport` / `alternatorstarboard` / `waterlevels` in **shadow** first (`INSTALLATION.md` §6.4). Never weaken hard ceilings.
7. When F8 up: SK/Grafana/Influx subscribe to Green `192.168.0.20:1883`; do not move the kernel

---

## 7. Mosquitto / Signal K / Grafana / InfluxDB — live on the F8 (2026-09-16, #6)

**Quick links (F8 `192.168.0.21`, all confirmed live 2026-09-16):**

| Service | URL | Notes |
|---|---|---|
| Signal K (admin + KIP) | http://192.168.0.21:3000 | KIP bundled at `/@mxtommy/kip/`; login required (`allow_readonly: false`) |
| Grafana | http://192.168.0.21:3001 | `GrafanaUser`/`GrafanaPwd` in `secrets.yaml`, forced change on first sign-in if never changed |
| InfluxDB | http://192.168.0.21:8086 | v2 UI; org/bucket/token already provisioned via `.env` |
| MQTT Explorer | http://192.168.0.21:4000 | Point its saved connection at the kernel broker, HA Green `192.168.0.20:1883` |
| Sisu Nav (chart/AIS/windex) | http://192.168.0.21:8088 | Requires Signal K login (#76). Follow me: https://192.168.0.21:8443 |
| tileserver-gl | http://192.168.0.21:8087 | |

**Kernel MQTT + NMEA ingest live on HA Green** (issues **#51** / **#57**). `sisu/v1` is the real-time database; it has to survive the Mac sleeping. Broker is the official Supervisor add-on **`core_mosquitto`**, using its **`logins:`** block for non-HA clients (ingest, Signal K). Ingest is the **local** Supervisor app **`local_sisu_nmea_ingest`** (**Settings → Apps**; HA 2026.2+ renamed Add-ons to Apps), not a raw `docker run`. Credentials: `mqtt_username` / `mqtt_password` in `secrets.yaml`. Apply SK plugin copies with `./scripts/apply-mqtt-creds.sh` (do not commit the password). Recreate Mosquitto options + ingest add-on: `./scripts/ha-kernel-mqtt.sh`.

**F8 now runs Signal K / Grafana / Influx / Sisu Nav** (#6, migrated off the interim Mac stack 2026-09-16). The 2026-08-09 rule “Green stays HA + ESPHome only” applied to a Mosquitto **+ Signal K** experiment that was torn down for headroom; that rule is superseded for the *kernel broker and ingest only*. Do not put SK / Grafana / Influx on Green.

**Issue #6 tracked standing up the real F8 hardware target** — TerraMaster F8 SSD Plus, TOS App Center "Docker Engine" v27.2.1 + "Docker Manager" v2.1.005 (confirmed current; TOS blocks direct `apt`/`git`, so this Mac stays the build/push side via `scripts/f8-deploy.sh`, rsync-only — TOS's sshd `scp`/SFTP subsystem is broken, rsync works). F8 also serves as the vessel's backup file server under `/Volume1/public/` (9.2TB, separately managed by the user) — **never touched by this stack**; the Docker stack lives under `/Volume1/docker/SisuAssistant/`.

**Compose file:** `homeassistant/docker-compose.yml` (F8 SK/Grafana/Influx/Sisu Nav; kernel broker stays on Green's official `core_mosquitto`). Bring up: `./scripts/f8-deploy.sh` (rsync push), then on F8 via `./scripts/f8-ssh.sh`: `cd /Volume1/docker/SisuAssistant/homeassistant && /Volume1/@apps/DockerEngine/dockerd/bin/docker-compose up -d --build` (Docker/Compose binaries aren't on TOS's `$PATH`, use the full path). **SSH:** TOS listens on **9222**; reachable from Sisu LAN (`.0`, e.g. HA Green). TOS does not accept SSH from Sisu-IoT (`.10`) — HTTP on `.21` still works from IoT. `homeassistant/signalk/` is the authoritative Signal K config, real `192.168.10.30`/`.31` IPs (no `host.docker.internal` — that was Mac-only, see historical note below). `homeassistant/{grafana,influxdb,mqtt-explorer}/` are gitignored runtime dirs. The SK MQTT plugins (`signalk-mqtt-bridge`/`signalk-mqtt-sensors`) need the broker password re-injected after a fresh checkout or container rebuild — their git-tracked config is permanently credential-free (`secrets.md` §Signal K plugin-config credentials); run `./scripts/signalk-inject-mqtt-creds.sh` then restart the `signalk` service.

**Four gotchas hit during the F8 bring-up (2026-09-16), all fixed:** Grafana's official image runs as UID 472 internally — `chown -R 472:472 .../grafana` before first start or it crash-loops on `mkdir /var/lib/grafana/plugins: Permission denied`. `sisu-nav-api`'s container runs as non-root (`USER node` in its Dockerfile) and `rsync -a` preserves the source Mac's `600` permission on `secrets.yaml` — `chmod 644` it on F8 or the container crash-loops on `EACCES` opening it. `tileserver-gl` showed Docker `(unhealthy)` — its image's baked-in healthcheck hardcodes `localhost:8080/health`, not this project's `TILESERVER_PORT=8087` — fixed with an explicit `healthcheck:` override in `docker-compose.yml` using node's http module (no curl/wget in the image) against the real port; confirmed `(healthy)` after recreating the container. **Signal K's whole `signalk/` config dir** (not just `secrets.yaml`) was `rsync -a`'d in with Mac UID 501 ownership while `signalk-server`'s container runs as UID 1000 (`node`) — `security.json` was `600`, so the container had zero permission to read *or write* it, silently breaking password changes/new-user creation via the admin UI (also caused KIP's `[SERIES STORAGE] flush failed: attempt to write a readonly database` on unrelated writes under the same tree). Fixed: `chown -R 1000:1000 homeassistant/signalk/` on F8, `chmod 600 security.json` back down after. **When hand-editing `security.json`'s bcrypt hash over SSH, don't interpolate the `$2a$10$...` hash through a shell string** — nested shell layers (local bash → ssh → remote shell) re-interpret `$2a`/`$10`/etc. as positional-parameter expansions and silently corrupt the hash; write the JSON to a local file and `rsync` it across instead. Generate the hash with the container's own `bcryptjs` (`docker exec signalk-server node -e "require('.../bcryptjs').hashSync(pw,10)"`) so the format is guaranteed compatible. `SignalKUser`/`SignalKPwd` in `secrets.yaml` (values in `secrets.yaml`, never in docs) now correctly authenticate (`POST /signalk/v1/auth/login` → 200 + JWT) — confirmed live position/wind reading back with a fresh timestamp from `ydwg-nmea0183.YD`, the definitive proof the F8 NMEA migration (#6) is fully working end-to-end, not just network-reachable.

**Fifth gotcha (2026-09-16, caught by a full post-migration verification sweep): HA's `influxdb:` config entry still pointed at the retired interim Mac (`192.168.0.151:8086`)** — the F8 migration updated Signal K's NMEA hosts but nobody repointed this entry (it's a UI-managed config entry since HA 2026.9, not YAML, so a repo-wide grep for the old IP didn't catch it). State was `setup_retry` / `Host is unreachable`, and the `Sisu` InfluxDB bucket on F8 had **zero measurements** — the entire HA → InfluxDB → Grafana trending pipeline was dead since the migration despite Signal K/NMEA working fine. Fixed by editing `.storage/core.config_entries` directly on HA Green (its `url`/`title` fields only, verified as a 2-field diff against the original) + a Core restart — the supported route is **Settings → Devices & services → InfluxDB → Reconfigure**, but that entry has no REST API equivalent, so a storage-file edit was the practical path. **Note for next time:** HA Green's own sshd also lacks a working SFTP subsystem (same as F8's TOS — `scp` fails with "subsystem request failed"); use `rsync -e ssh` to push files there, same workaround as `scripts/f8-deploy.sh`. Confirmed fixed: config entry `state: loaded`, InfluxDB `schema.measurements()` populated (~50 measurements), a fresh `sensor.nmea_depth` datapoint queryable within 3 minutes of the restart, Grafana's datasource health check green.

**Grafana/InfluxDB wiring is now provisioned, not click-through (2026-08-10):** `homeassistant/grafana-provisioning/` (datasource + 3 dashboards — Power & Charging, Engine & Navigation, Tanks & Watermaker — all file-based, git-tracked, mounted into both compose files' `grafana` service at `/etc/grafana/provisioning`) plus `homeassistant/packages/trending_influxdb.yaml` (HA's `influxdb:` integration, the actual sensor→Influx writer). `homeassistant/.env` (gitignored; template `.env.example`) holds the Influx token/org/bucket + Grafana admin creds the compose files and provisioning YAML need — **generate/refresh it with `./scripts/gen-docker-env.sh`** (reads `secrets.yaml`, the one boat secrets file; never hand-edit `.env`). After changing anything under `grafana-provisioning/` or `.env`, push with `./scripts/f8-deploy.sh` then recreate Grafana on the F8 (`docker compose -f docker-compose.yml up -d grafana`; also `influxdb` if Influx env changed). Provisioning is read at container start, not hot-reloaded. The retired Mac compose (`docker-compose.mac.yml`) is rollback only.

**Gotcha that cost real debugging time — HA's `influxdb:` integration defaults `measurement_attr` to `unit_of_measurement`, not `entity_id`.** Without setting it explicitly, every entity *with* a unit (A, V, W, °C, %, kn…) silently writes into a measurement literally named `"A"`/`"V"`/`"W"`/etc instead of grouping sensibly by entity — only unit-less entities (enum/text sensors, binary_sensors) ever reach `default_measurement`. No error is logged either way (filter mismatch, not an exception) — the only way to catch it is querying InfluxDB directly (`schema.measurements()`) and noticing sensors with units are missing. `trending_influxdb.yaml` sets `measurement_attr: entity_id` deliberately — one InfluxDB measurement per entity_id (e.g. `sensor.victron_solar_power`), field `value`. Keep this if this package is ever rewritten.

**HA 2026.9 removes YAML-configured InfluxDB connections (hit live 2026-08-10, same day as the above).** `trending_influxdb.yaml` no longer sets `api_version`/`host`/`port`/`ssl`/`token`/`organization`/`bucket` — on first load HA auto-imported those into a UI config entry (`Settings → Devices & services → InfluxDB`, reconfigure there, not in YAML) and now warns/errors if any connection key remains in YAML. `measurement_attr`/`max_retries`/`include`/`exclude` stay in YAML per HA's own deprecation notice. **Known loose end:** HA created a `deprecated_yaml` repair-issue registry entry during the restart *before* this fix landed; nothing in the integration's code deletes stale repair entries once the underlying condition clears, so it may still show under Settings → Repairs even though re-triggering it won't happen anymore (confirmed via `.storage/core.config_entries` — the imported entry has the right host/org/bucket/token, and `.storage/repairs.issue_registry` shows the `deprecated_yaml` entry's timestamp unchanged since before the fix, i.e. not re-created). Safe to dismiss by hand in the UI.

**Full module set, on the F8 (`192.168.0.21`) now:**

| Module | Container | Host port | Notes |
|---|---|---|---|
| Mosquitto (kernel) | **core_mosquitto** add-on on HA Green | **192.168.0.20:1883** | official add-on; `logins:` = `mqtt_username` / `mqtt_password` |
| NMEA ingest | **`local_sisu_nmea_ingest`** add-on on **HA Green** | host net | YDWG `.30:1456` + DataHub `.31:11102` → `sisu/v1` |

**Ingest ops:** **Settings → Apps** → Sisu NMEA ingest (or `./scripts/ha-kernel-mqtt.sh` after daemon / MQTT-secret changes). That script copies `nmea_wind_daemon.py` into `/addons/sisu_nmea_ingest`, sets options from secrets, rebuilds/starts the app, and removes any leftover `sisu-nmea-ingest` container. Logs: app Log tab, or `./scripts/ha-cli.sh addons logs local_sisu_nmea_ingest`. Healthy: `MQTT connected to 127.0.0.1:1883` and `connected to ydwg` / `datahub`. Dual-listen / merge / payload: `.ai_context/sources.md`.
| Signal K | `signalk-server` | 3000 | `network_mode: host`; Admin UI + **KIP bundled** at `/@mxtommy/kip/`; piped NMEA providers connect directly to `192.168.10.30`/`.31` (real Linux host, same LAN, no bridge needed) |
| InfluxDB | `influxdb` | 8086 | v2.x |
| Grafana | `grafana` | 3001 | Moved off :3000 since Signal K owns it; provisioned via `grafana-provisioning/` |
| MQTT Explorer | `mqtt-explorer` | 4000 | Debug UI for the Mosquitto broker above |
| Sisu Nav | `sisu-nav-api` | 8088, 8443 | Chart + AIS + windex (#76). SK login required. Follow me is HTTPS `:8443`. tileserver-gl on **8087**. |

**Live NMEA (DataHub/YDWG) → Signal K on F8, direct (no bridge needed).** F8 is a real Linux host with `network_mode: host`, on the same `192.168.0.x` LAN as everything else, and reaches Sisu-IoT (`192.168.10.x`) via the router's `lan⇒iot` forwarding zone — `settings.json`'s two `pipedProviders` entries point straight at `192.168.10.30`/`192.168.10.31`.

**Historical, Mac-only (superseded 2026-09-16, kept for reference in case of a Mac-interim rollback):** `scripts/mac-nmea-relay.sh` was a host-side `socat` relay bridging `192.168.10.x` into Docker Desktop's Mac VM via `host.docker.internal`, since Docker Desktop's Mac VM can't route container traffic into `192.168.10.x` directly (confirmed dead ends: "host networking" beta didn't fix it and once destabilized port publishing; `macvlan` unsupported on Docker Desktop for Mac at all). Not used now that F8 is live — do not resurrect this without also pointing `settings.json` back at `host.docker.internal`.
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
