Cadburies/SisuAssistant/sisu-nav/DEVELOPER.md

# Sisu Nav — Developer Guide

> API routing + plugin architecture, and how to add to either without
> touching `App.tsx`. For deploy, see [INSTALLATION.md](INSTALLATION.md).
> For what the UI does, see [USER_GUIDE.md](USER_GUIDE.md).

## Shape of the app

```
sisu-nav/
  api/            Node API (plain http, no framework) — see §2
    server.mjs    routing + static SPA host
    <feature>/    one dir per API feature (weather, harvest, route, roses, ensemble, marine, ...)
    providers.yaml  tile-harvest provider registry
    Dockerfile
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
