Cadburies/SisuAssistant/.ai_context/feature_map/_img/sisu-nav-app.png

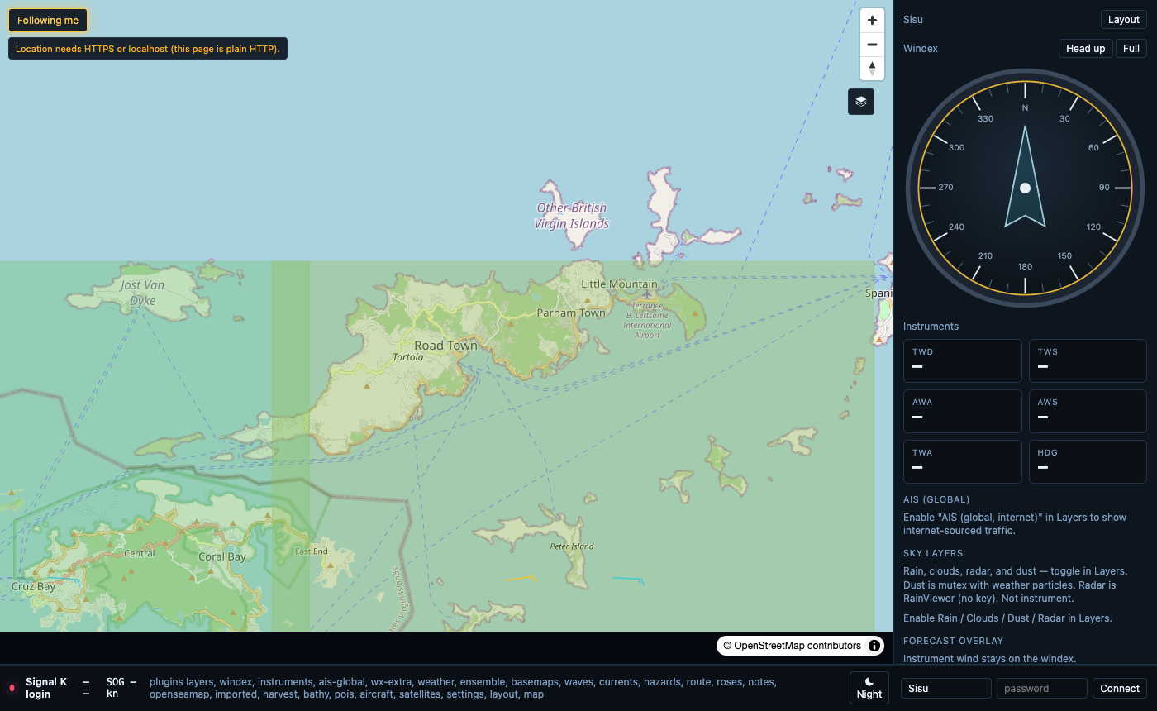
.ai_context/feature_map/_img/sisu-nav-app.png
