Cadburies/SisuAssistant/homeassistant/esphome/images/sisu_guest_wifi.png

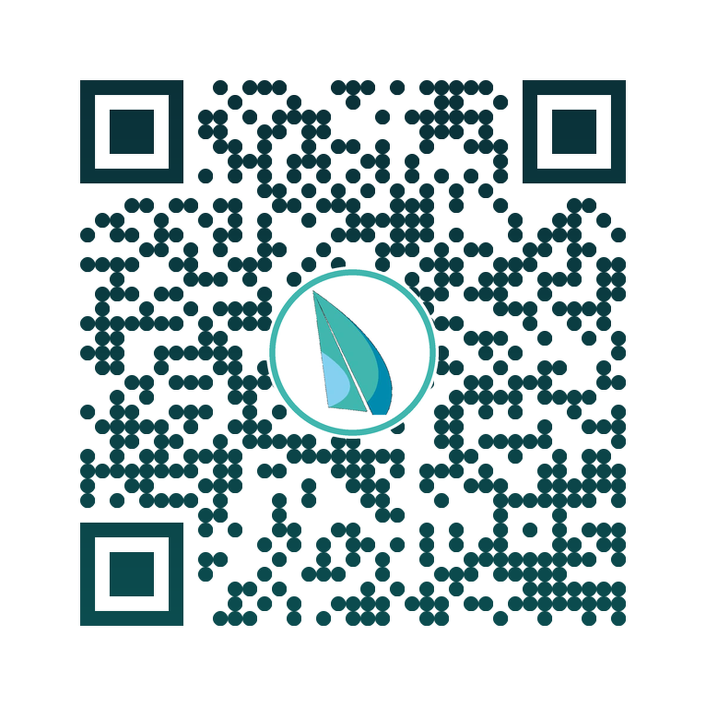
homeassistant/esphome/images/sisu_guest_wifi.png
