Cadburies/SisuAssistant/homeassistant/esphome/images/sisu_sail.png

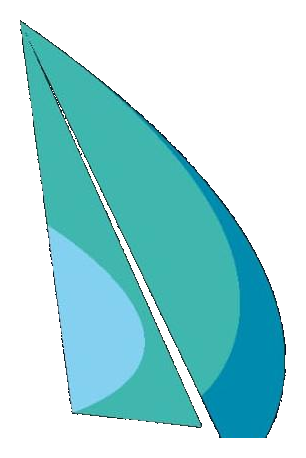
homeassistant/esphome/images/sisu_sail.png
