Cadburies/SisuAssistant/MarineBoard/Documentation/12V BATTERY MONITOR.png

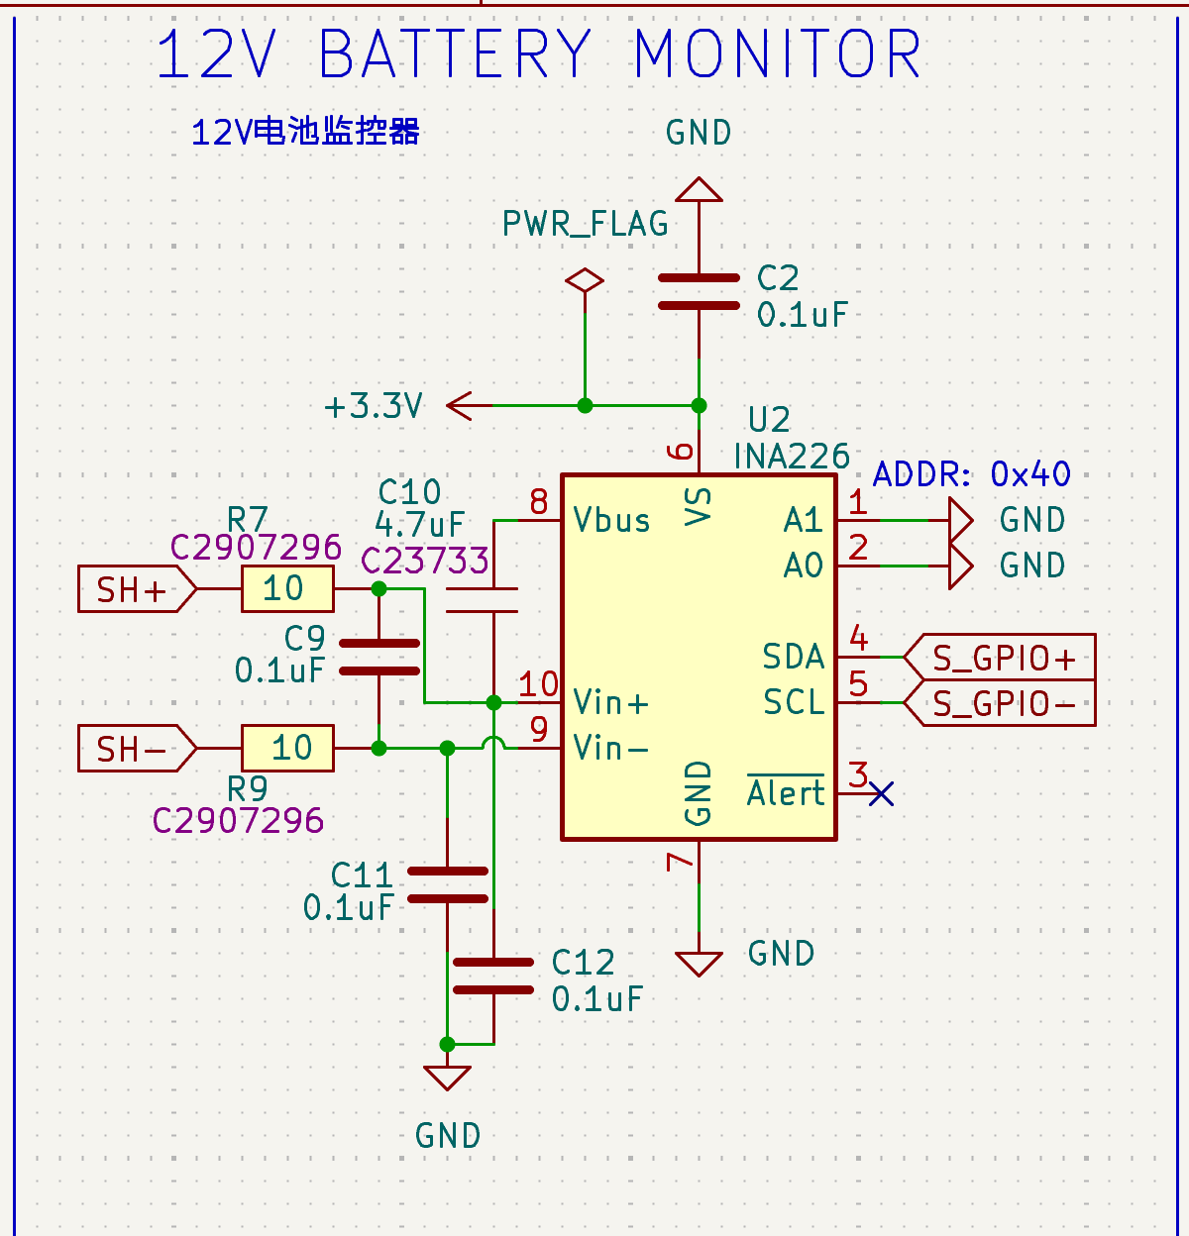
MarineBoard/Documentation/12V BATTERY MONITOR.png
