Cadburies/SisuAssistant/MarineBoard/Documentation/CAN INTERFACE.png

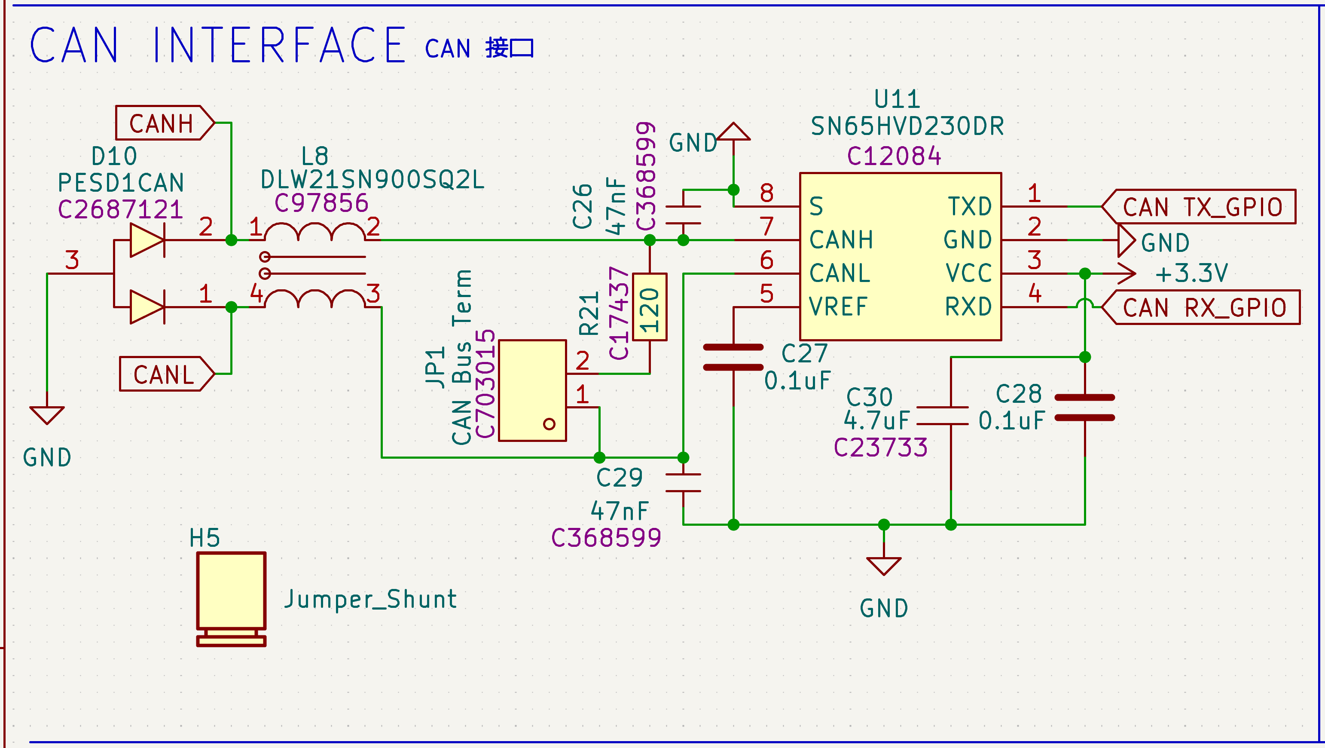
MarineBoard/Documentation/CAN INTERFACE.png
