Cadburies/SisuAssistant/MarineBoard/Documentation/ESP32.png

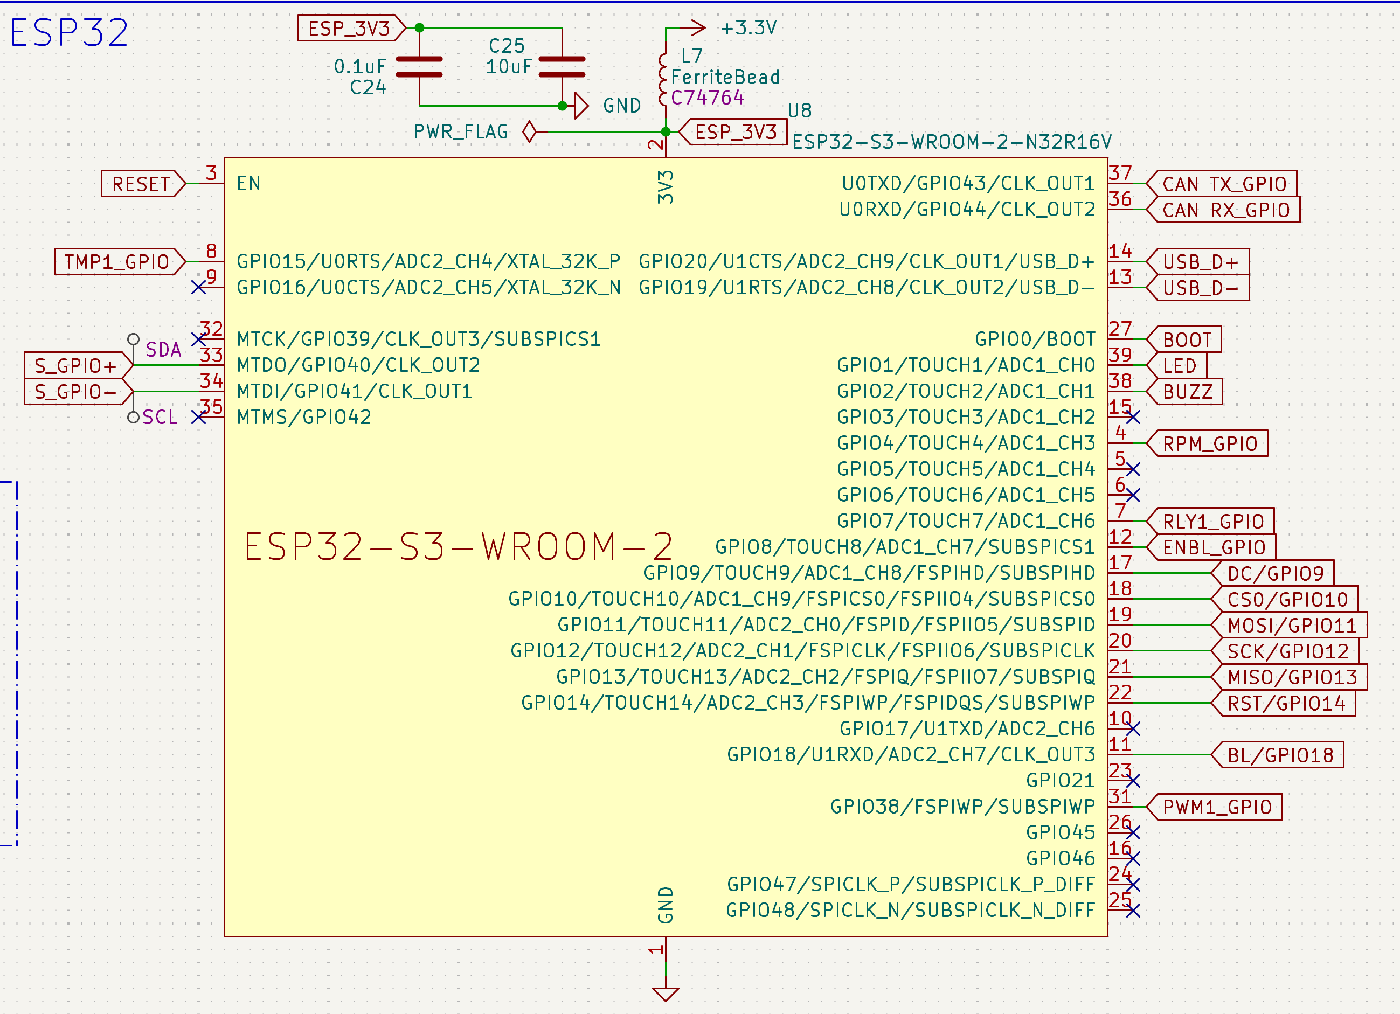
MarineBoard/Documentation/ESP32.png
