Cadburies/SisuAssistant/MarineBoard/Documentation/Freezer/Freezer Controller.jpeg

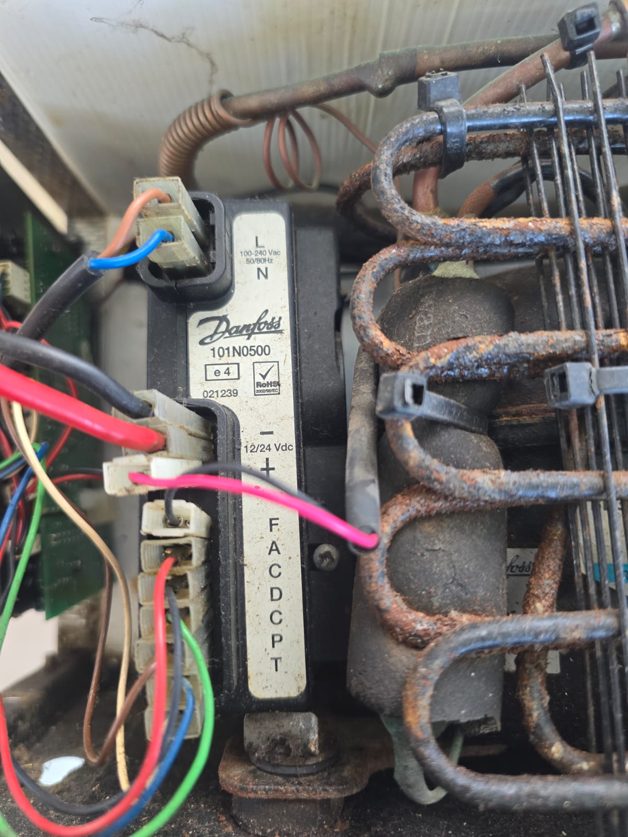
MarineBoard/Documentation/Freezer/Freezer Controller.jpeg
