Cadburies/SisuAssistant/MarineBoard/Documentation/HEADER PINS.png

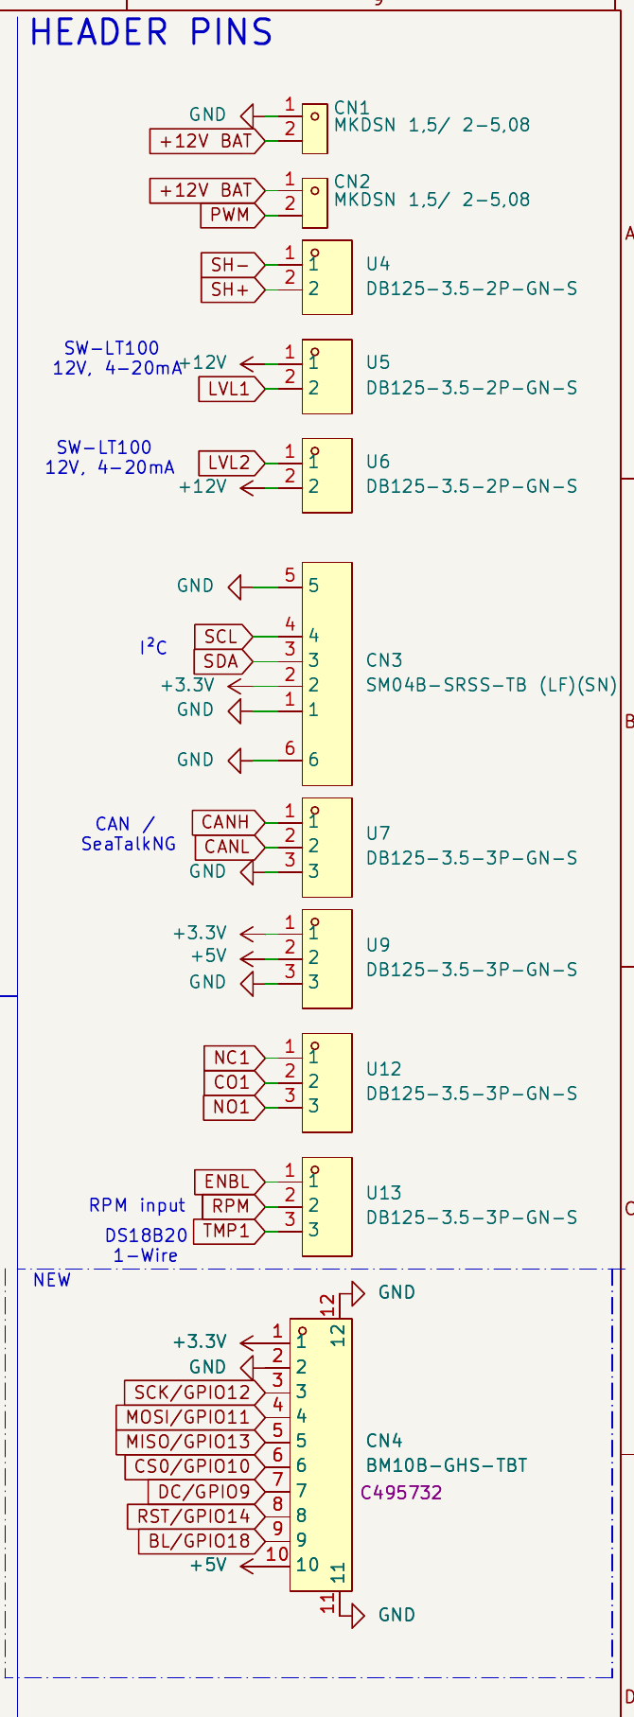
MarineBoard/Documentation/HEADER PINS.png
