Cadburies/SisuAssistant/MarineBoard/Documentation/IO PROTECTION.png

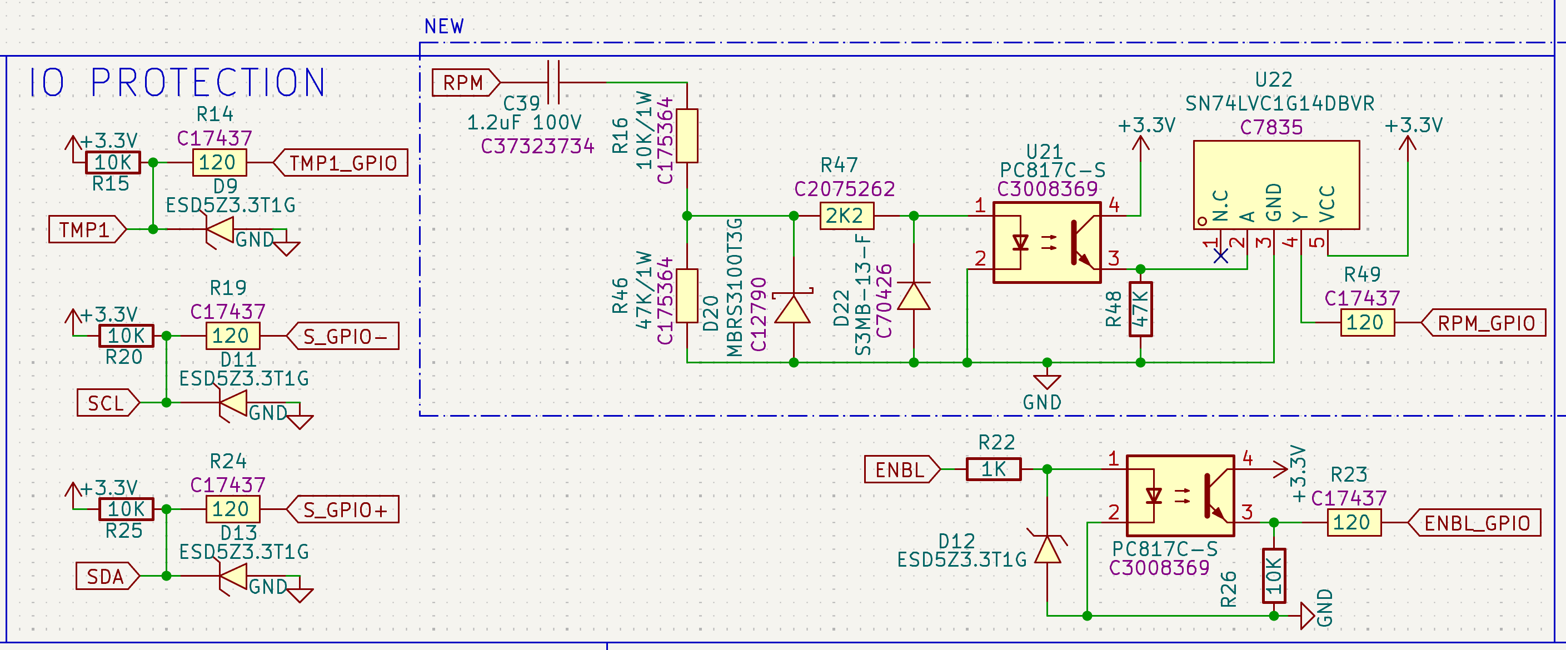
MarineBoard/Documentation/IO PROTECTION.png
