Cadburies/SisuAssistant/MarineBoard/Documentation/LEDS & BUTTONS & BUZZER.png

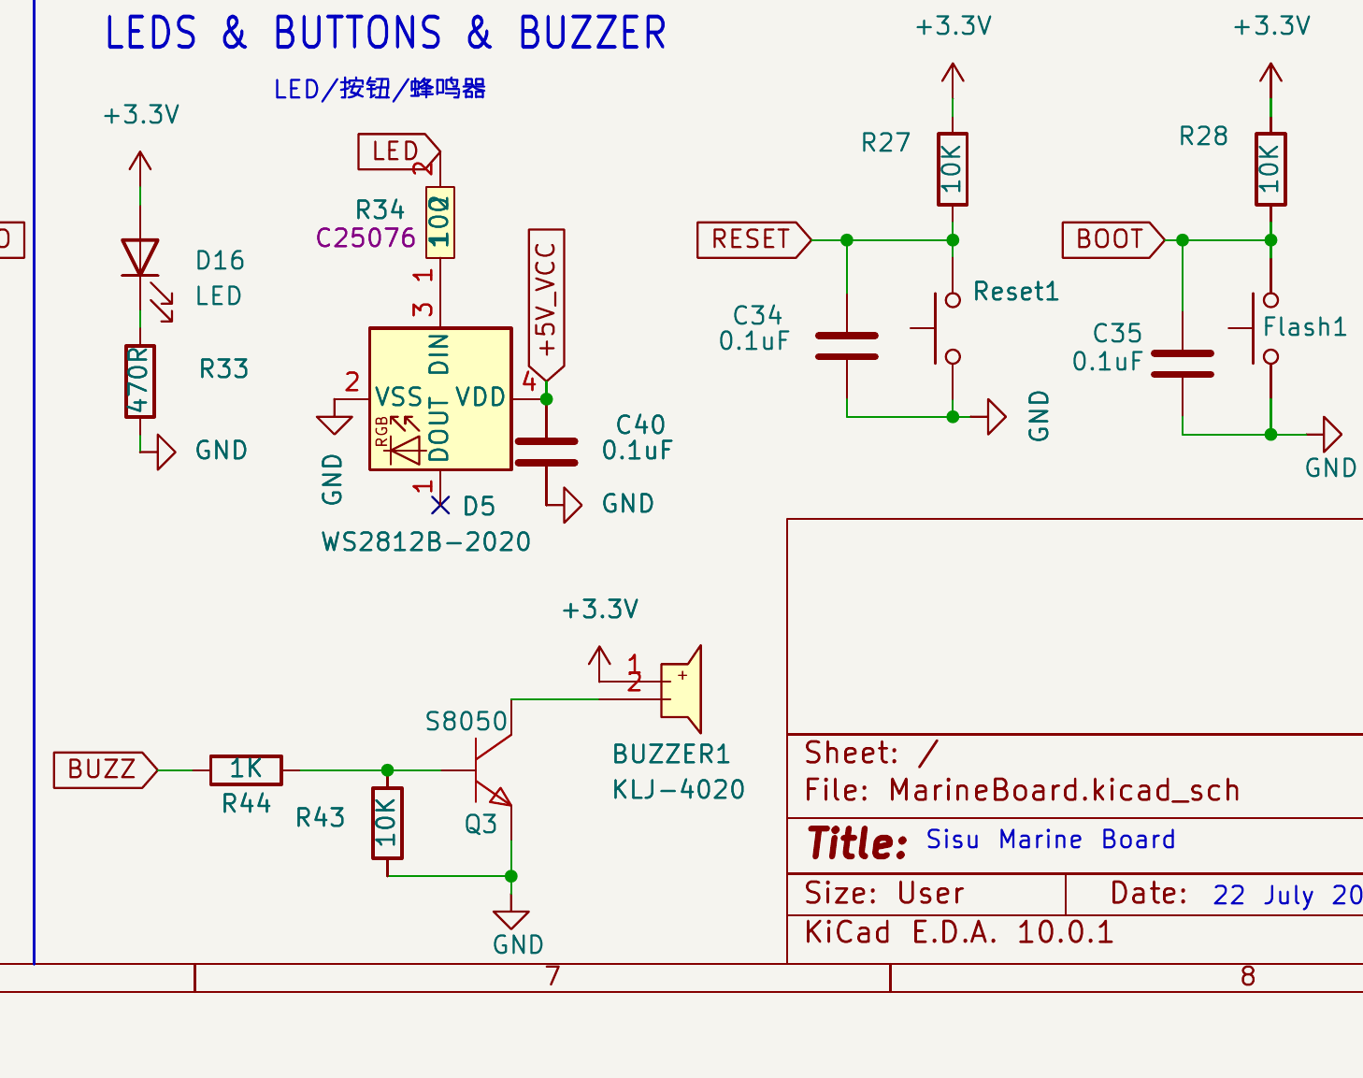
MarineBoard/Documentation/LEDS & BUTTONS & BUZZER.png
