Cadburies/SisuAssistant/MarineBoard/Documentation/LEVELS MONITOR.png

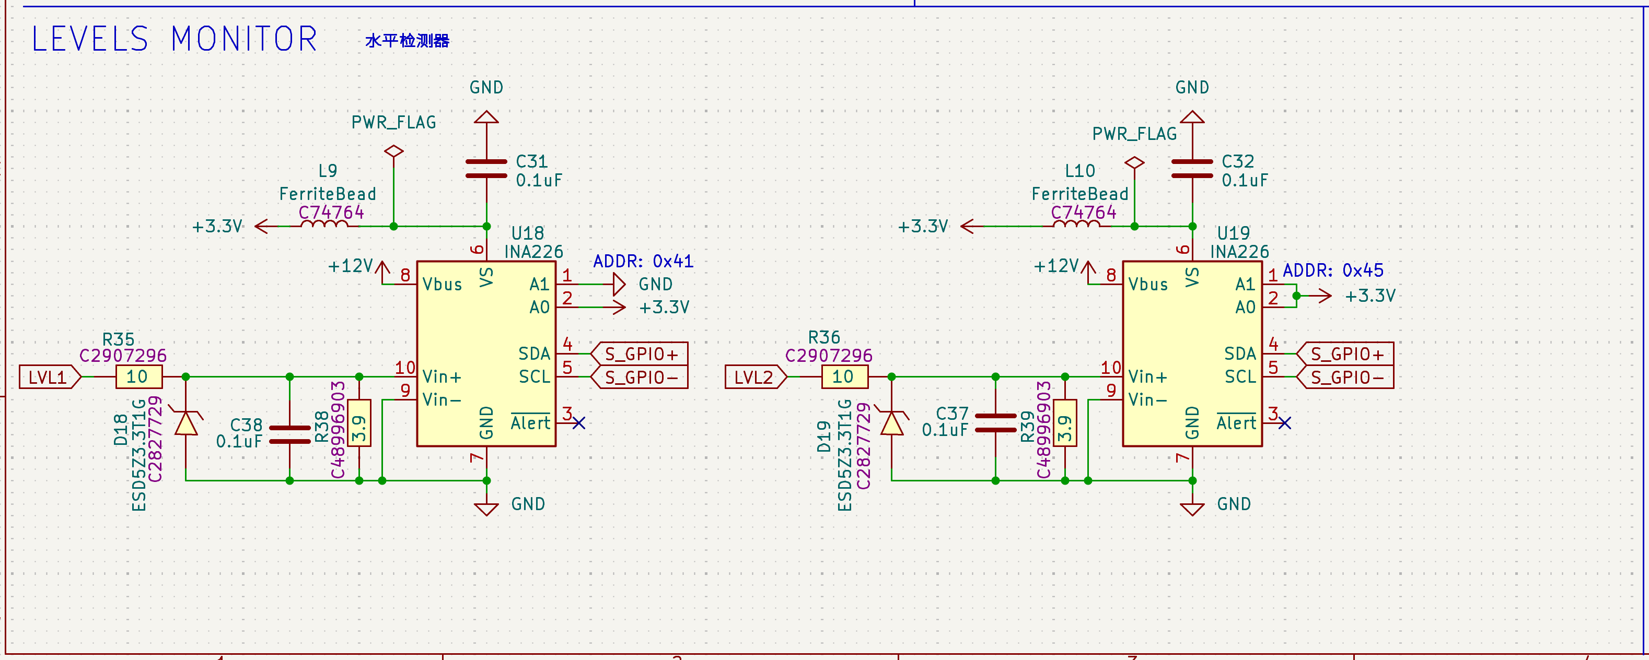
MarineBoard/Documentation/LEVELS MONITOR.png
