Cadburies/SisuAssistant/MarineBoard/Documentation/OUTPUT RELAY.png

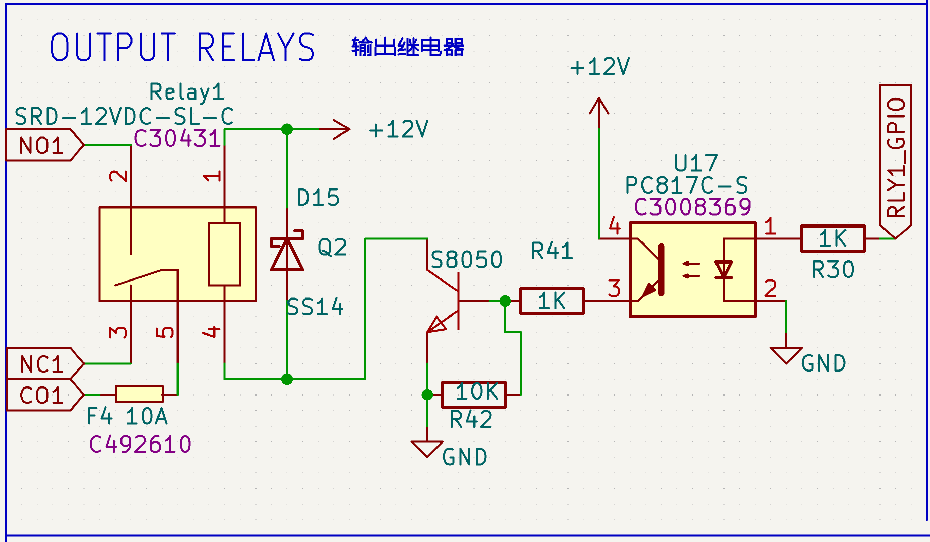
MarineBoard/Documentation/OUTPUT RELAY.png
