Cadburies/SisuAssistant/MarineBoard/Documentation/POWER AND FILTERING 3V3 from 5V merge.png

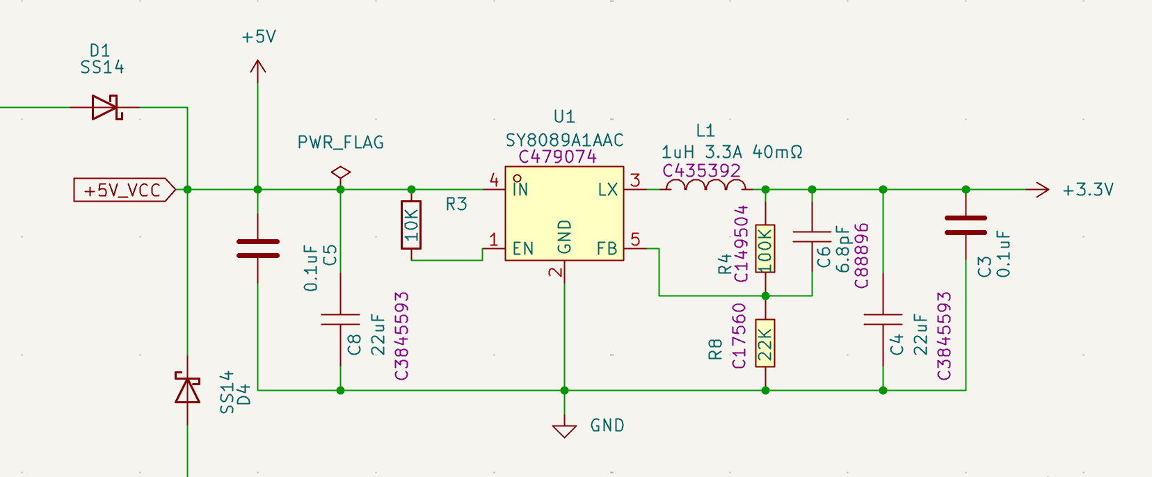
MarineBoard/Documentation/POWER AND FILTERING 3V3 from 5V merge.png
