Cadburies/SisuAssistant/MarineBoard/Documentation/POWER AND FILTERING 12V_5V.png

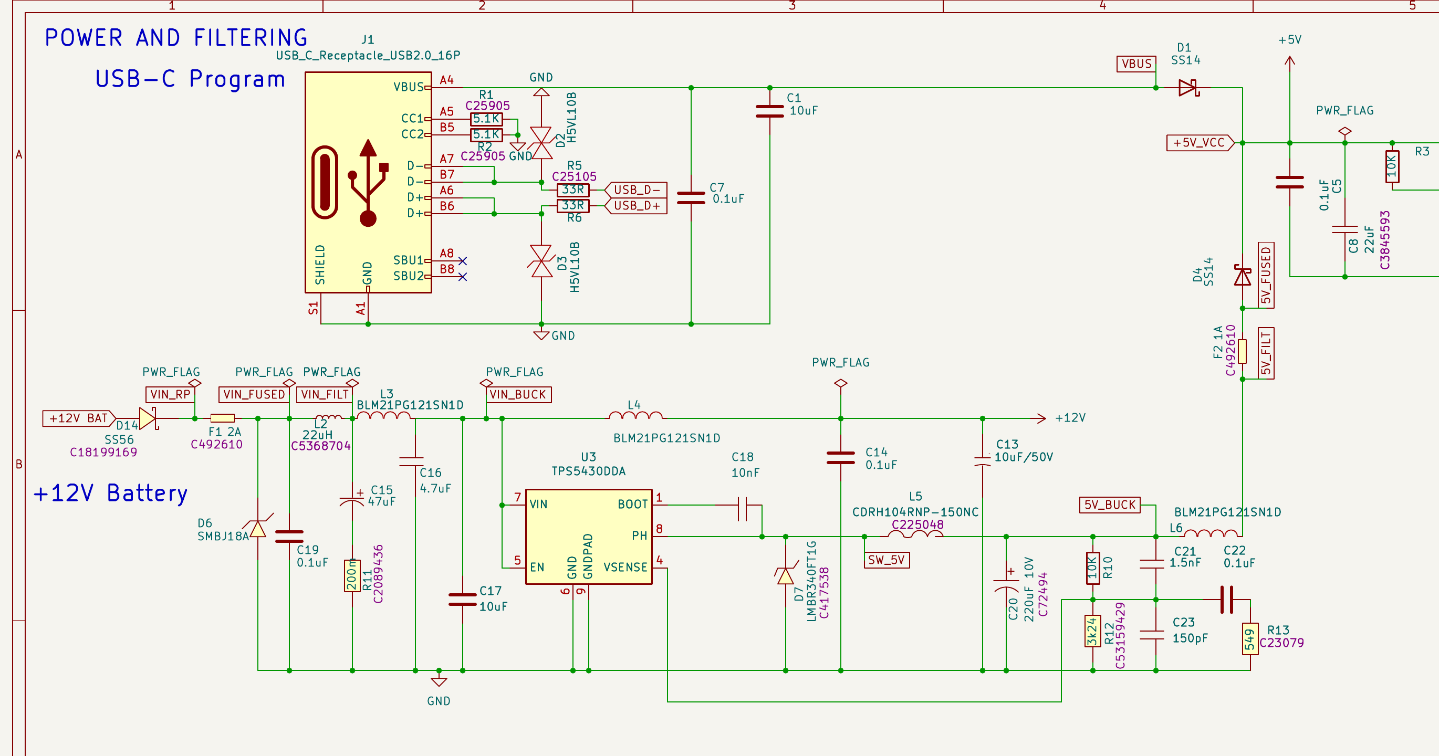
MarineBoard/Documentation/POWER AND FILTERING 12V_5V.png
