Cadburies/SisuAssistant/MarineBoard/Documentation/PWM DRIVERS.png

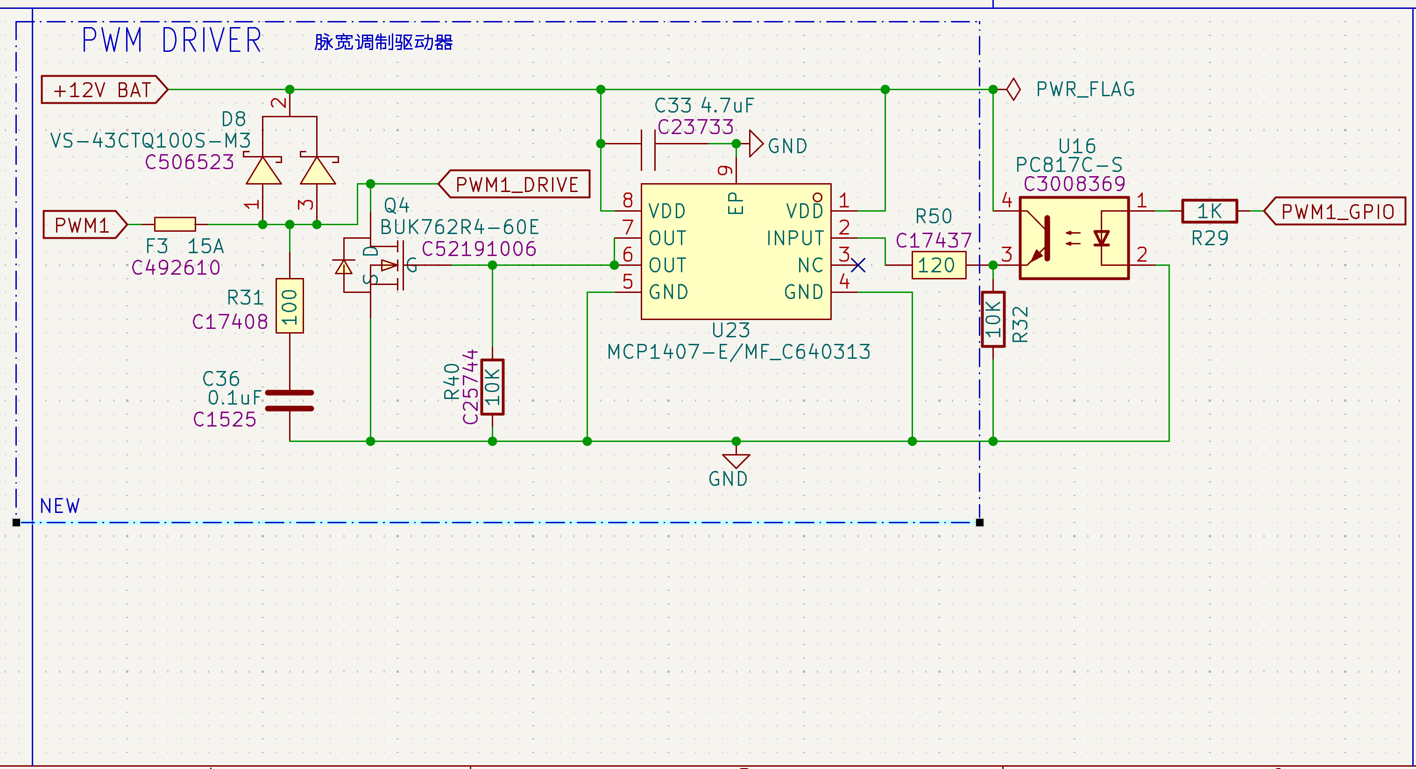
MarineBoard/Documentation/PWM DRIVERS.png
