Cadburies/SisuAssistant/MarineBoard/Documentation/RPM.png

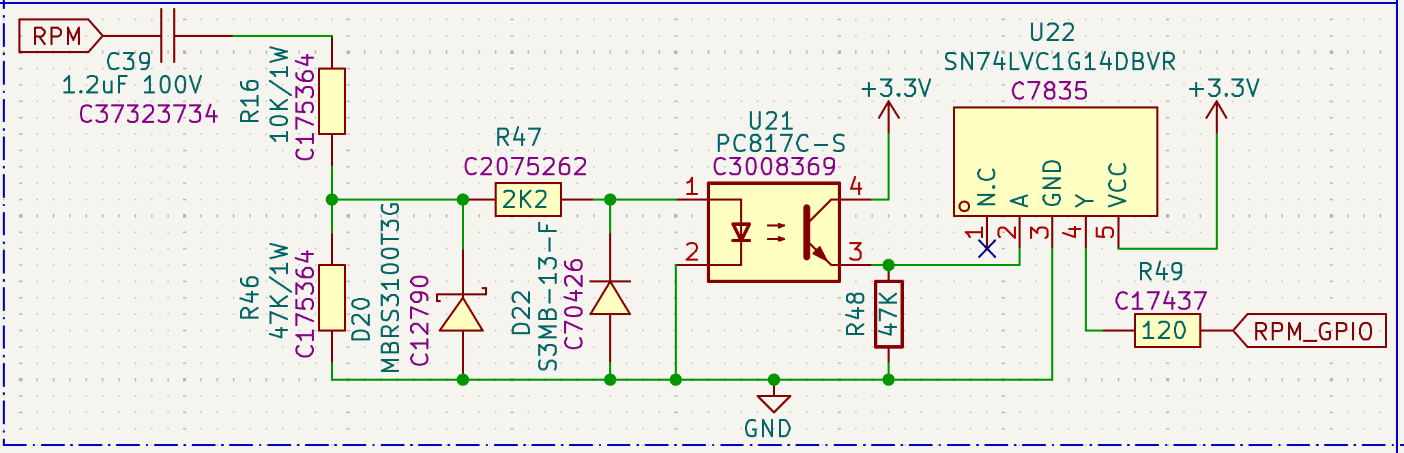
MarineBoard/Documentation/RPM.png
