Cadburies/SisuAssistant/MarineBoard/Documentation/Schematics/12V BATTERY MONITOR.png

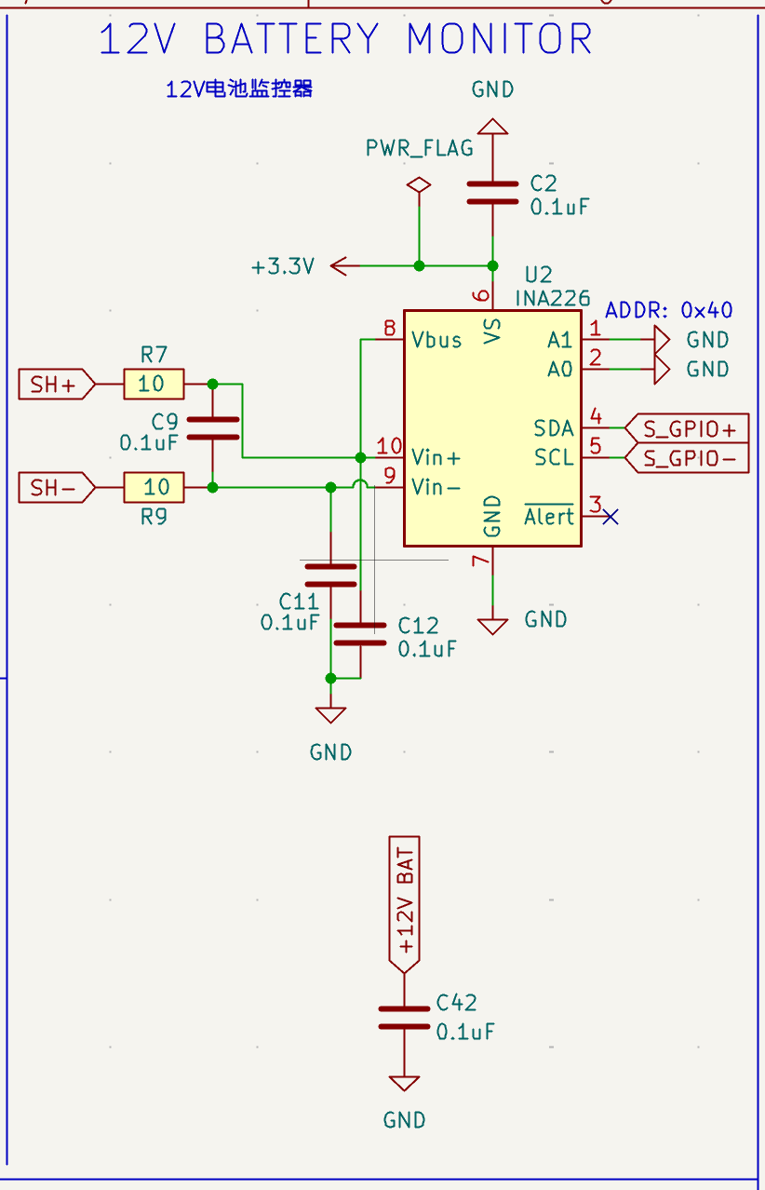
MarineBoard/Documentation/Schematics/12V BATTERY MONITOR.png
