Cadburies/SisuAssistant/MarineBoard/Documentation/Schematics/CAN INTERFACE.png

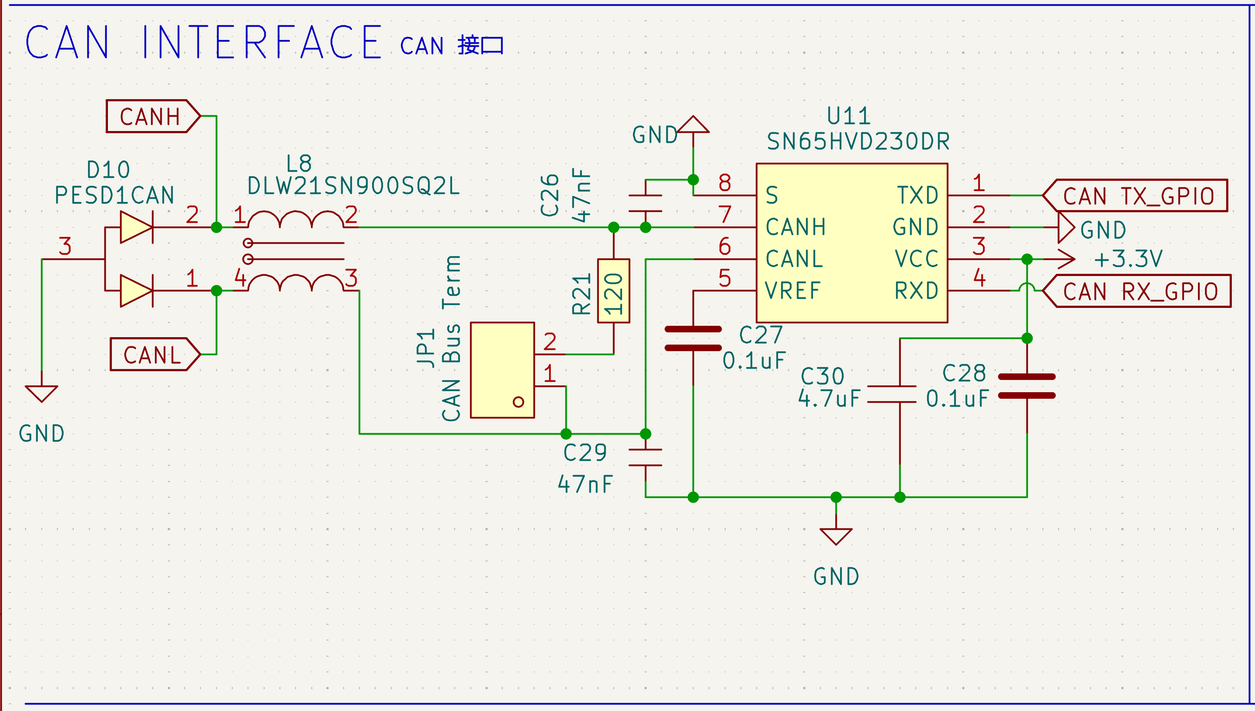
MarineBoard/Documentation/Schematics/CAN INTERFACE.png
