Cadburies/SisuAssistant/MarineBoard/Documentation/Schematics/chrome.png

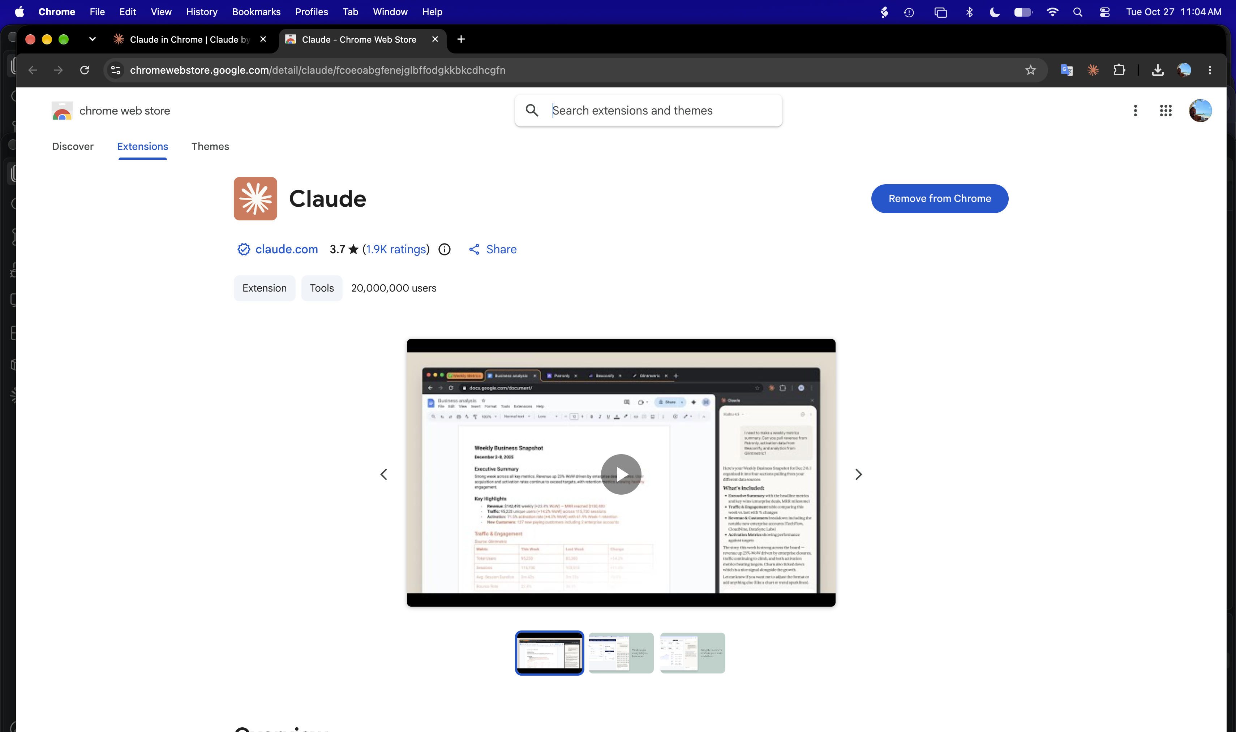
MarineBoard/Documentation/Schematics/chrome.png
