Cadburies/SisuAssistant/MarineBoard/Documentation/Schematics/ESP32.png

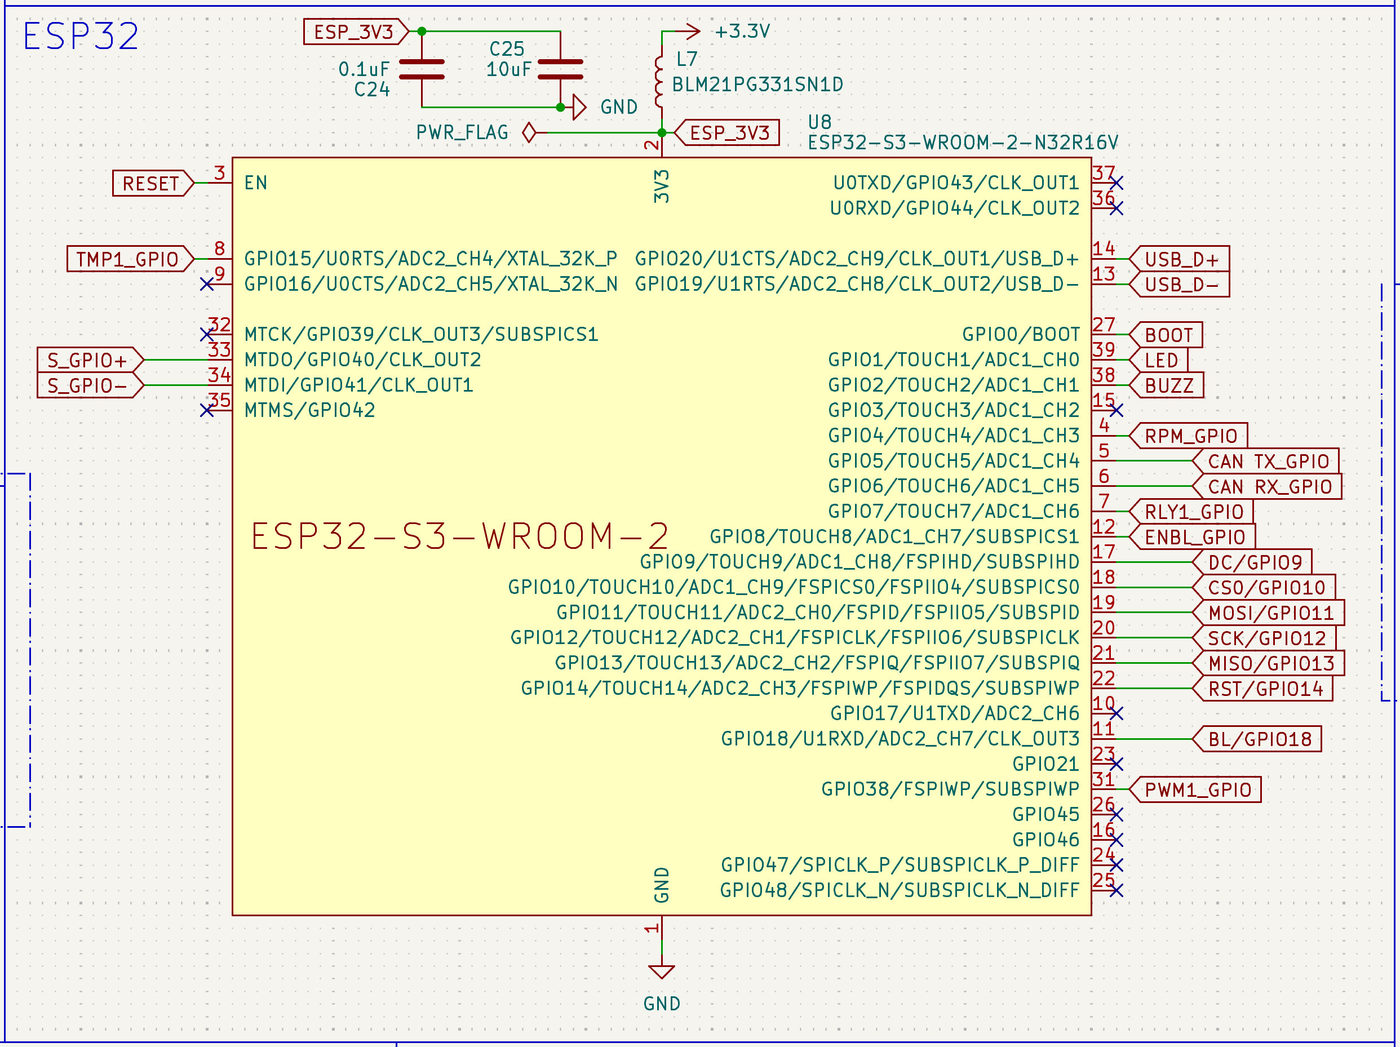
MarineBoard/Documentation/Schematics/ESP32.png
