Cadburies/SisuAssistant/MarineBoard/Documentation/Schematics/HEADER PINS.png

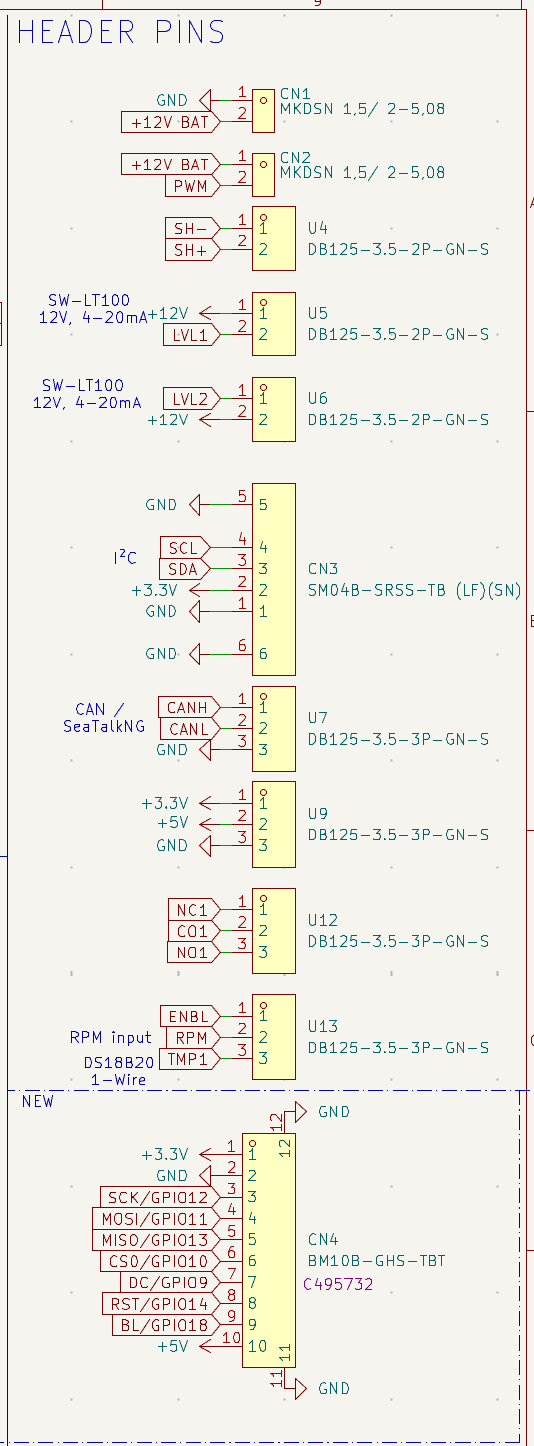
MarineBoard/Documentation/Schematics/HEADER PINS.png
