Cadburies/SisuAssistant/MarineBoard/Documentation/Schematics/IO PROTECTION.png

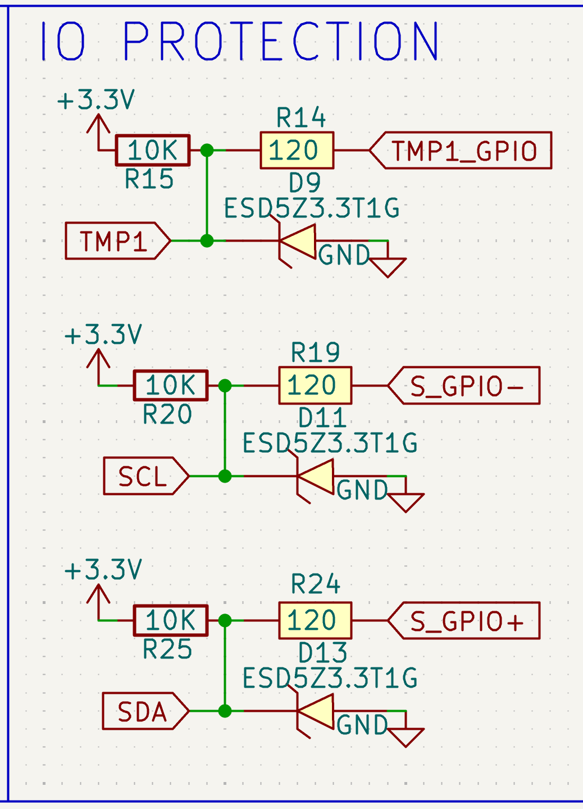
MarineBoard/Documentation/Schematics/IO PROTECTION.png
