Cadburies/SisuAssistant/MarineBoard/Documentation/Schematics/LEDS & BUTTONS & BUZZER.png

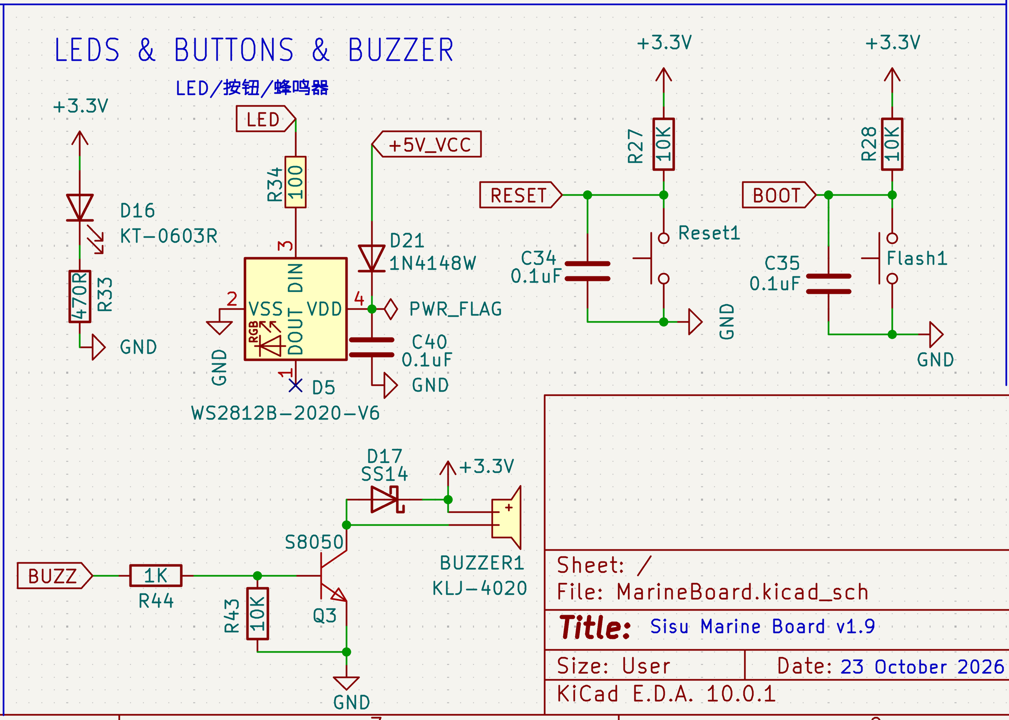
MarineBoard/Documentation/Schematics/LEDS & BUTTONS & BUZZER.png
