Cadburies/SisuAssistant/MarineBoard/Documentation/Schematics/LEVELS MONITOR.png

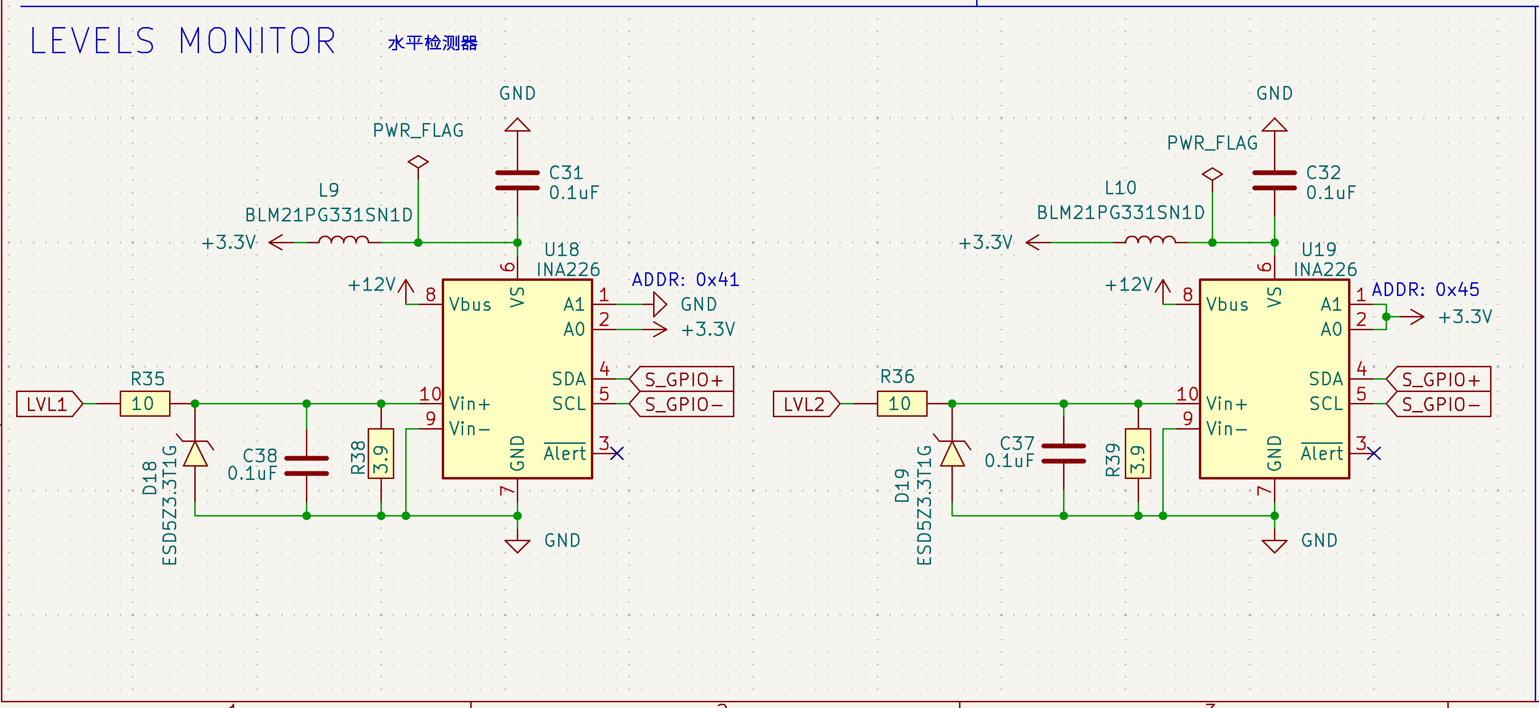
MarineBoard/Documentation/Schematics/LEVELS MONITOR.png
