Cadburies/SisuAssistant/MarineBoard/Documentation/Schematics/OUTPUT RELAY.png

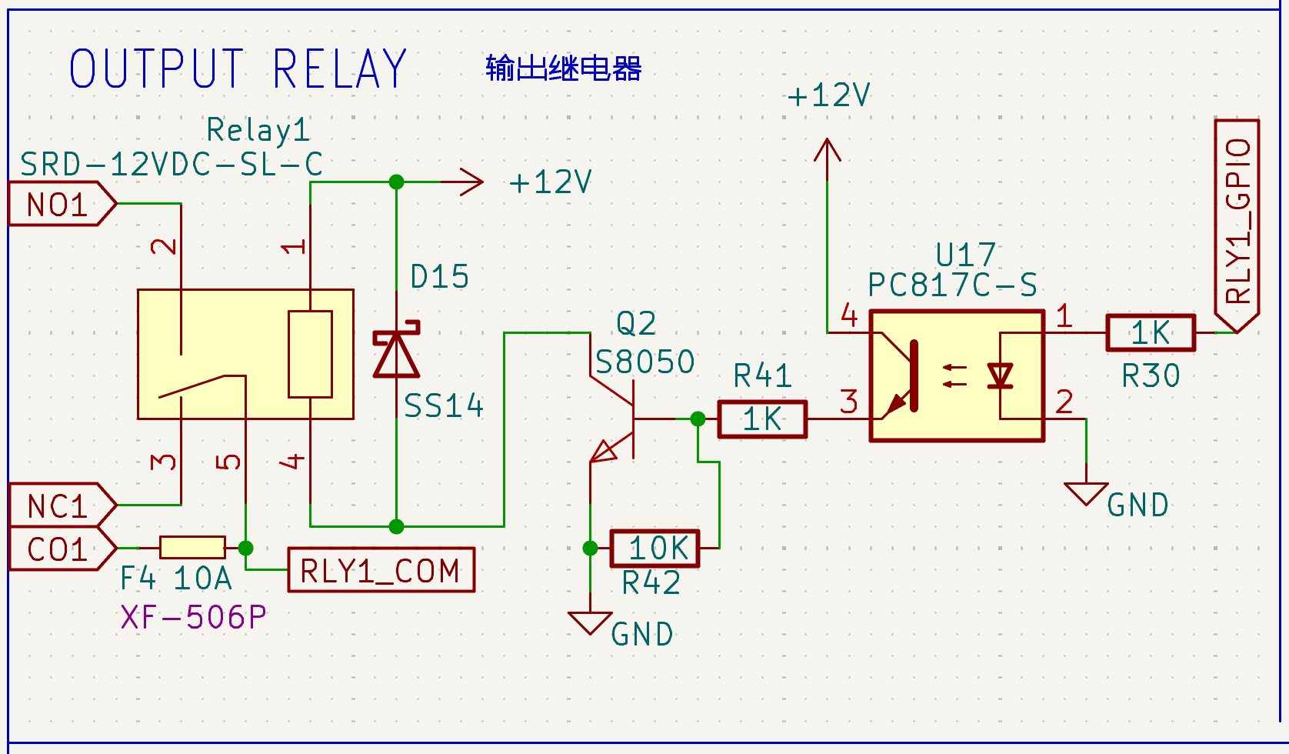
MarineBoard/Documentation/Schematics/OUTPUT RELAY.png
