Cadburies/SisuAssistant/MarineBoard/Documentation/Schematics/POWER AND FILTERING 3V3 from 5V merge.png

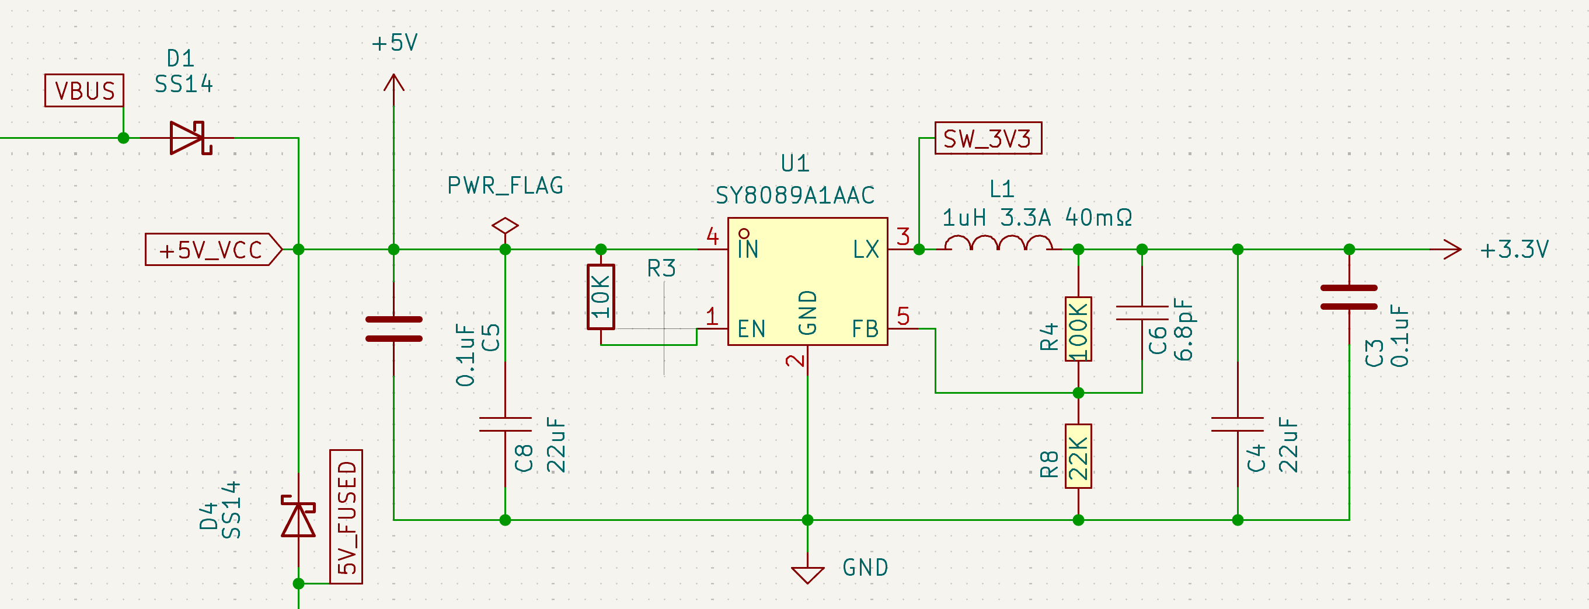
MarineBoard/Documentation/Schematics/POWER AND FILTERING 3V3 from 5V merge.png
