Cadburies/SisuAssistant/MarineBoard/Documentation/Schematics/POWER AND FILTERING 12V_5V.png

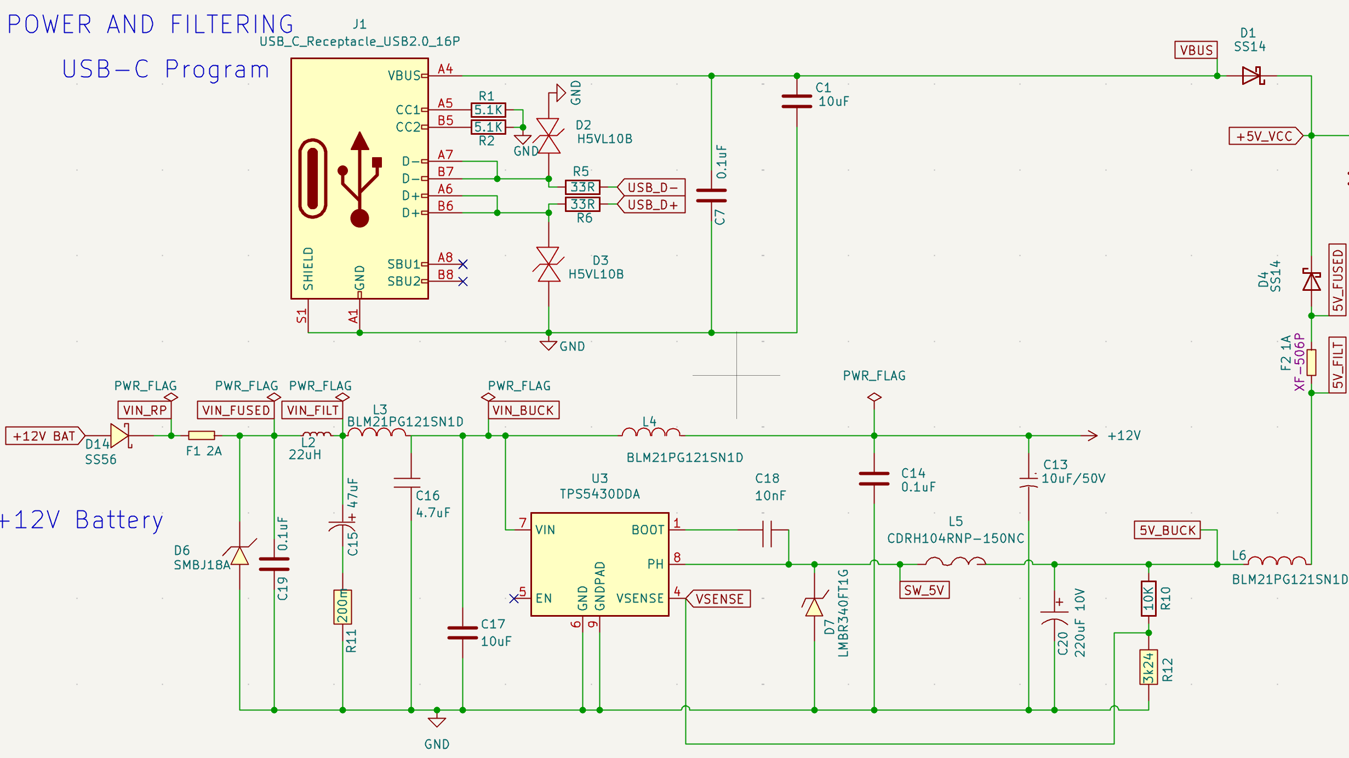
MarineBoard/Documentation/Schematics/POWER AND FILTERING 12V_5V.png
