Cadburies/SisuAssistant/MarineBoard/Documentation/Schematics/PWM Drivers.png

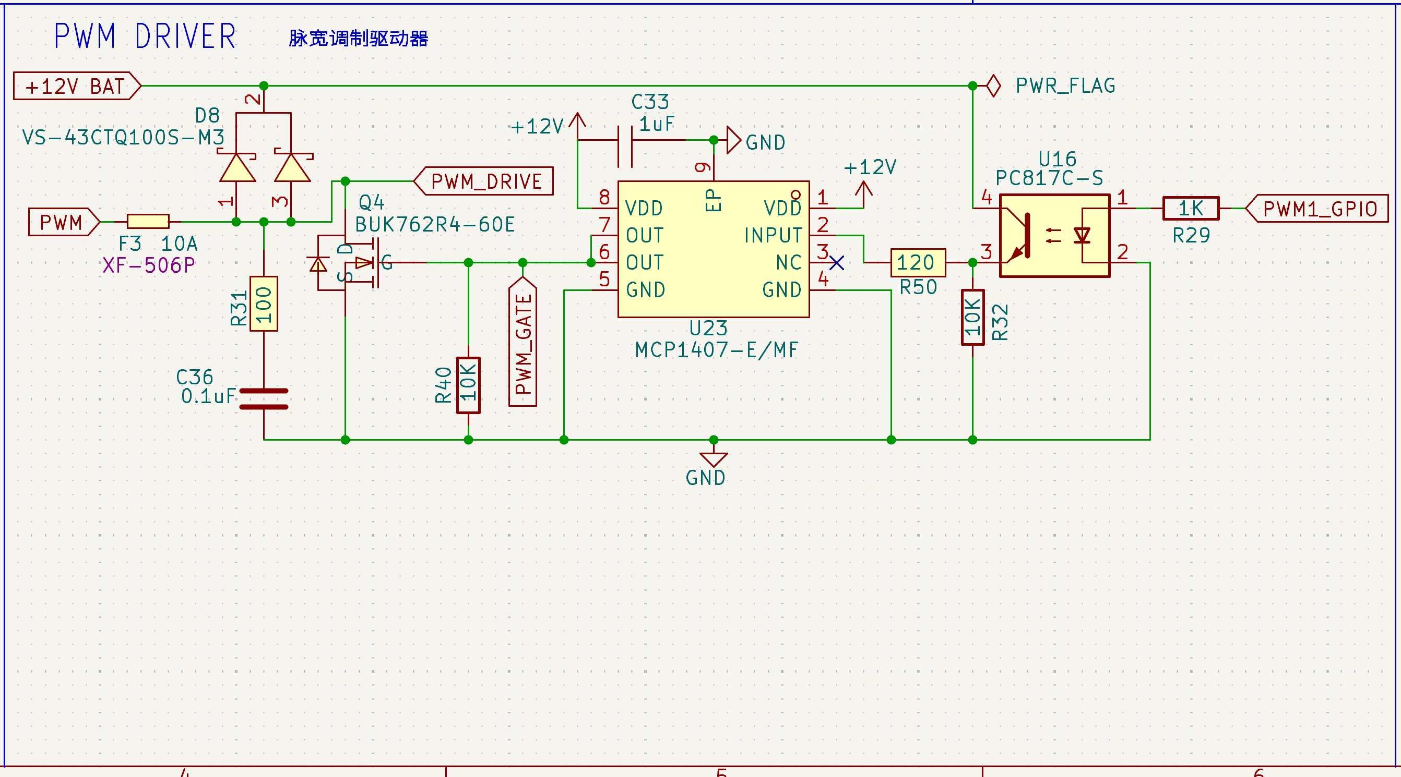
MarineBoard/Documentation/Schematics/PWM Drivers.png
