Cadburies/SisuAssistant/MarineBoard/Documentation/Schematics/RPM.png

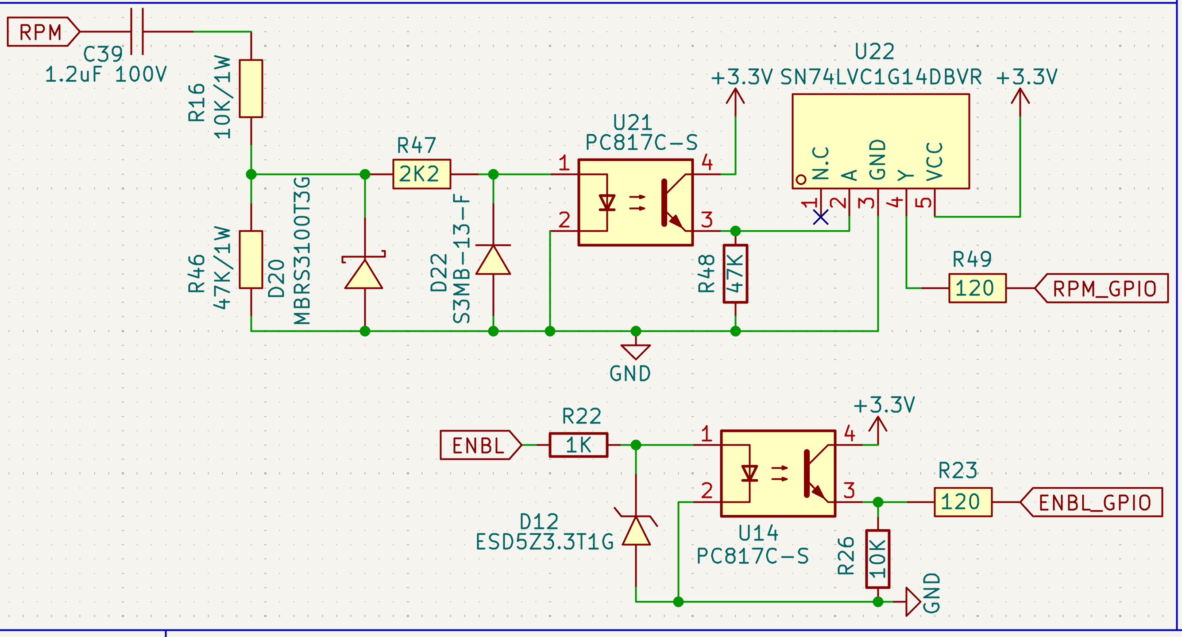
MarineBoard/Documentation/Schematics/RPM.png
