Cadburies/SisuAssistant/MarineBoard/Documentation/TPS5430 PCB.png

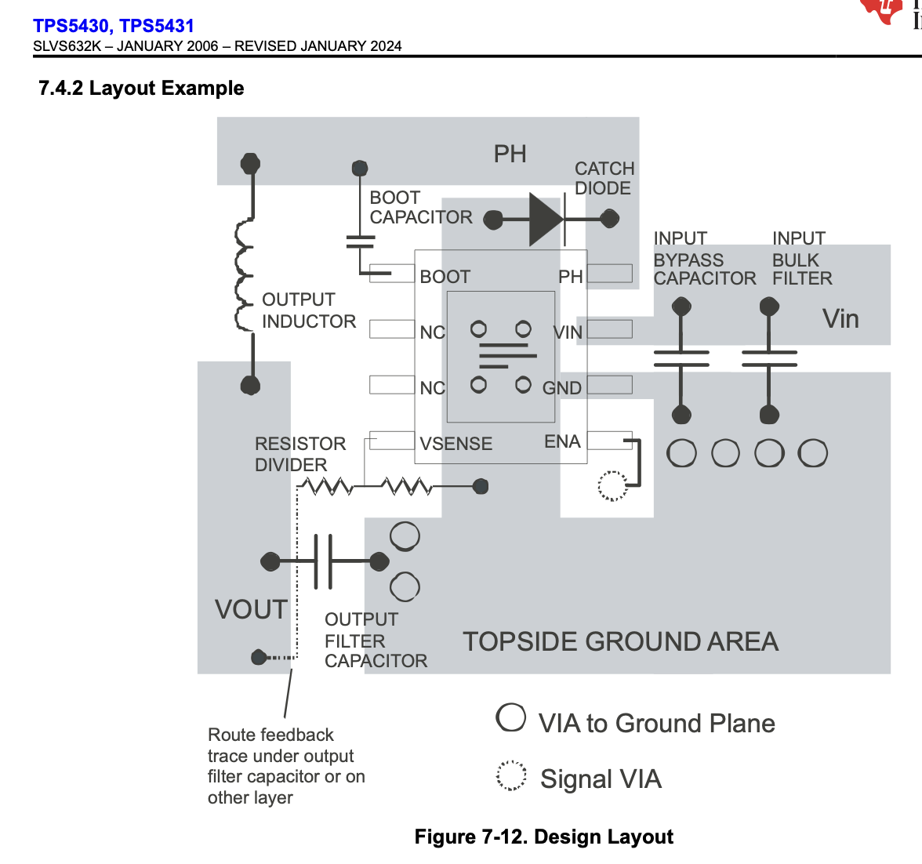
MarineBoard/Documentation/TPS5430 PCB.png
