Cadburies/SisuAssistant/MarineBoard/Documentation/TPS5430 SCH.png

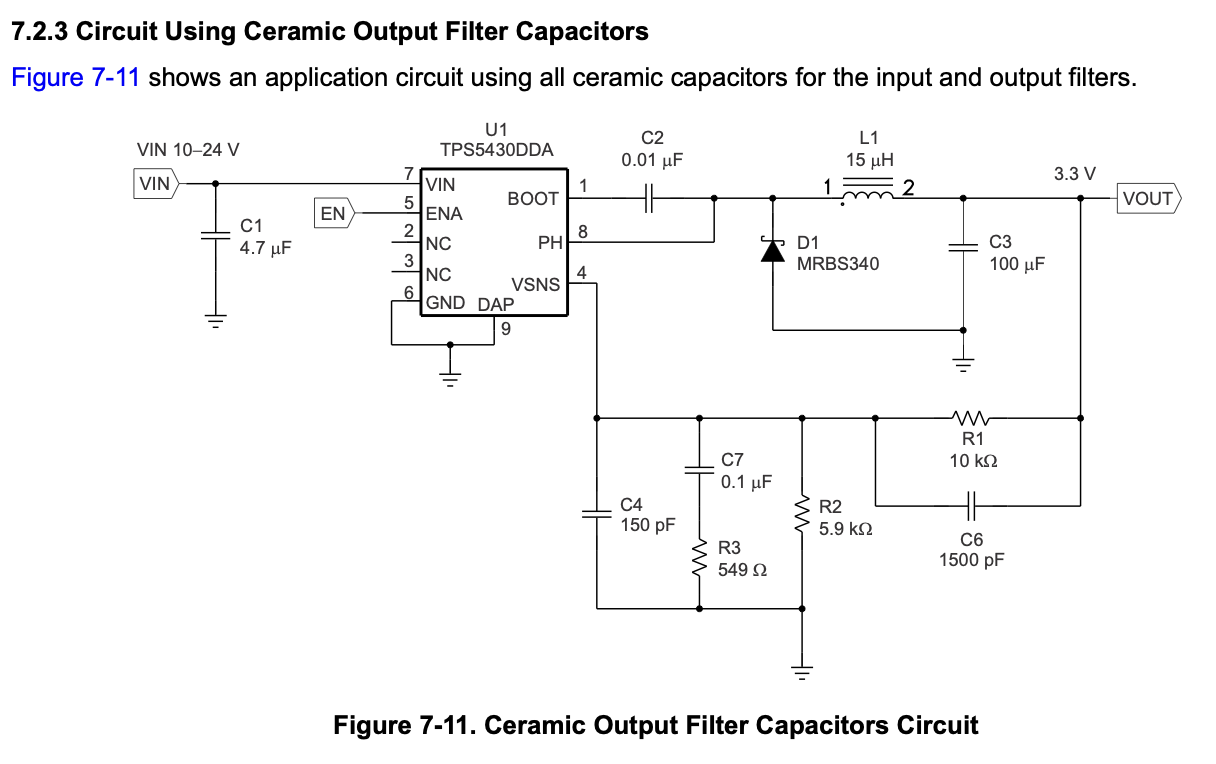
MarineBoard/Documentation/TPS5430 SCH.png
