Cadburies/SisuAssistant/MarineBoard/enclosure/east-wall.png

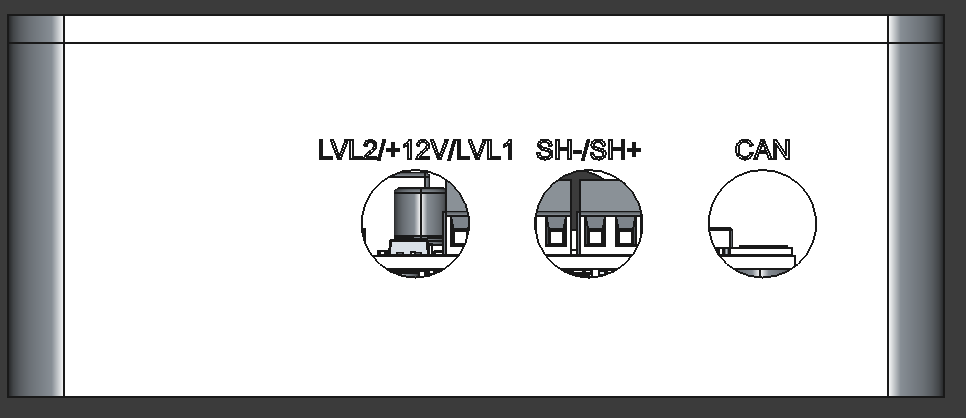
MarineBoard/enclosure/east-wall.png
