Cadburies/SisuAssistant/MarineBoard/enclosure/MarineBoard.png

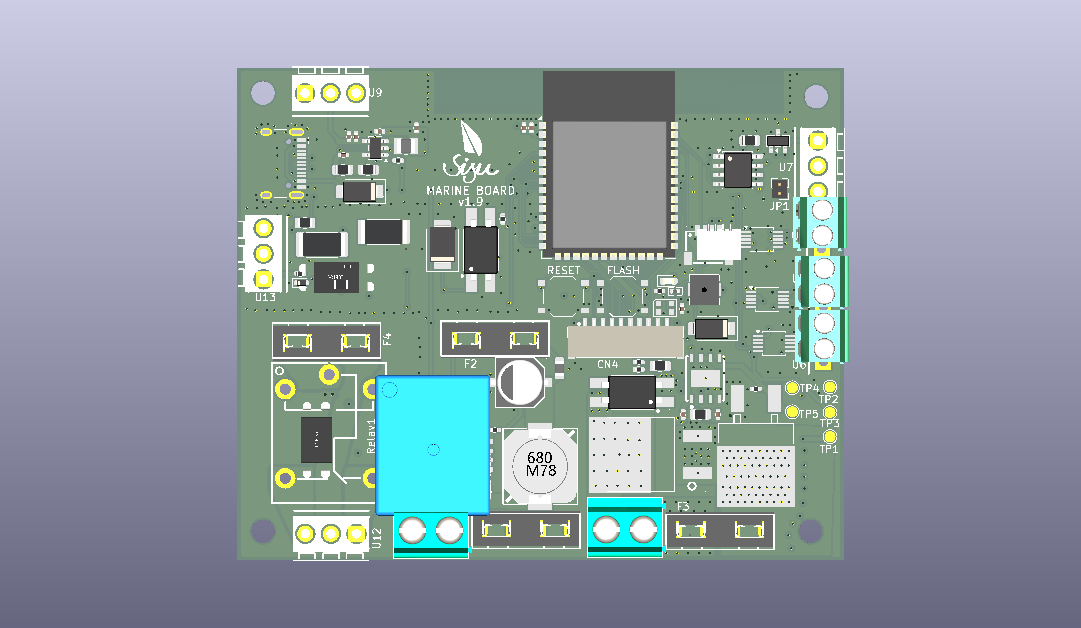
MarineBoard/enclosure/MarineBoard.png
