Cadburies/SisuAssistant/MarineBoard/enclosure/south-wall.png

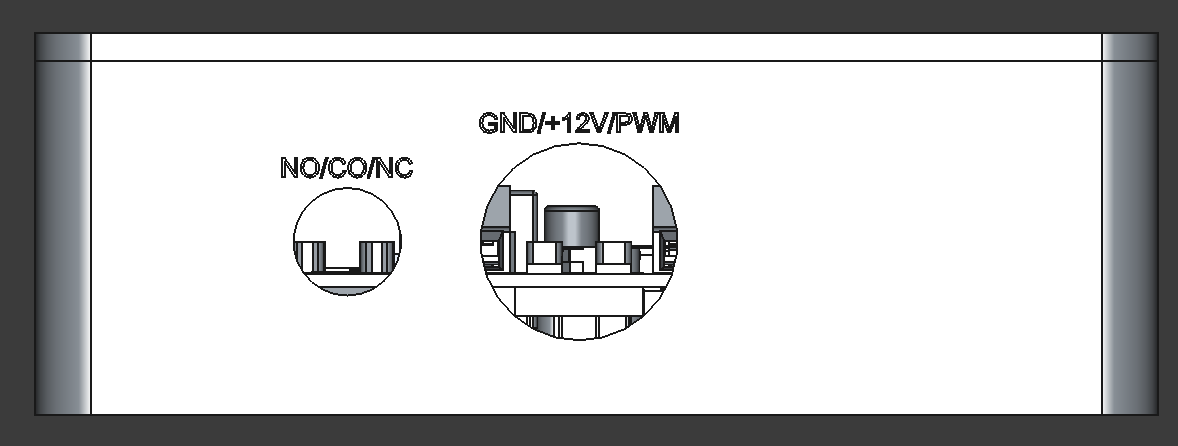
MarineBoard/enclosure/south-wall.png
