Cadburies/SisuAssistant/MarineBoard/enclosure/west-wall.png

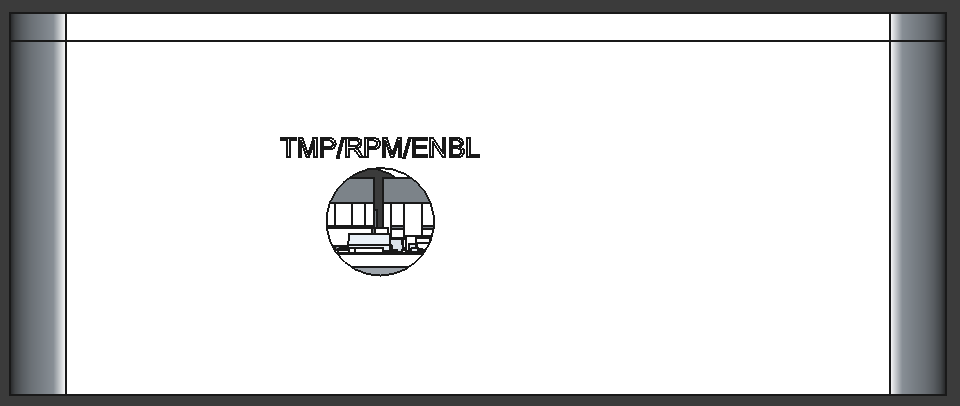
MarineBoard/enclosure/west-wall.png
