Cadburies/SisuAssistant/MarineBoard/PCBWay/T-1P19W831004A-5units-MarineBoard-BOM(2026-10-17).xls

PCBWay Bom Quotation, Product No.:T-1P19W831004A
Item # | *Designator | *Qty | Manufacturer | *Mfg Part # | Description / Value | *Package/Footprint | Mounting Type | Your Instructions / Notes | Assembly requirement | *Unit Price(5 units) | *Total | *Delivery Time | *Actual Purchase Mfg Part # | *PCBWay Note | Customer Reply | PCBWay Update
1 | BUZZER1 | 1 | KELIKING | KLJ-4020 | 2V~4V 100mA 4kHz 73dB SMD,4x4mm『 』KLJ-4020 | BUZ-SMD_L4.0-W4.0-P3.50-L | SMD |  | Top | $2.174 | $10.870
2 | C1,C25 | 2 | Samsung Electro-Mechanics | CL05A106MQ5NUNC | 10uF ±20% 6.3V Ceramic Capacitor X5R 0402『 』10uF | C_0402_1005Metric | SMD |  | Bottom/Top | $0.099 | $0.990
3 | C2,C3,C5,C7,C9,C24,C27,C28,C31,C32,C34,C35,C36,C37,C38,C40 | 16 | Samsung Electro-Mechanics | CL05B104KO5NNNC | 100nF +/-10% 16V Ceramic Capacitor X7R 0402『 』0.1uF | C_0402_1005Metric | SMD |  | Bottom/Top | $0.009 | $0.720
4 | C4,C8 | 2 | muRata | GRM158R61A226ME15D | 22uF +/-20% 10V Ceramic Capacitor X5R 0402『 』22uF | C_0402_1005Metric | SMD |  | Top | $1.029 | $10.290
5 | C6 | 1 | muRata | GJM1555C1H6R8BB01D | 6.8pF 50V Ceramic Capacitor C0G 0402『 』6.8pF | C_0402_1005Metric | SMD |  | Top | $0.266 | $1.330
6 | C11,C12,C14,C19,C42 | 5 | Samsung Electro-Mechanics | CL05B104KB5NNNC | 100nF ±10% 50V Ceramic Capacitor X7R 0402『 』0.1uF | C_0402_1005Metric | SMD |  | Bottom | $0.026 | $0.650
7 | C13 | 1 | muRata | GRM21BR61H106KE43L | 10uF ±10% 50V Ceramic Capacitor X5R 0805『 』10uF/50V | C_0805_2012Metric | SMD |  | Bottom | $0.800 | $4.000
8 | C15 | 1 | muRata | GRM31CR61E476ME44L | 47uF ±20% 25V Ceramic Capacitor X5R 1206『 』47uF | C_1206_3216Metric | SMD |  | Bottom | $1.959 | $9.795
9 | C16 | 1 | Samsung Electro-Mechanics | CL31B475KBHNNNE | 4.7uF +/-10% 50V Ceramic Capacitor X7R 1206『 』4.7uF | C_1206_3216Metric | SMD |  | Top | $0.485 | $2.425
10 | C17 | 1 | Samsung Electro-Mechanics | CL31A106KBHNNNE | 10uF +/-10% 50V Ceramic Capacitor X5R 1206『 』10uF | C_1206_3216Metric | SMD |  | Top | $1.029 | $5.145
11 | C18 | 1 | Samsung Electro-Mechanics | CL05B103KB5NNNC | 10nF ±10% 50V Ceramic Capacitor X7R 0402『 』10nF | C_0402_1005Metric | SMD |  | Top | $0.126 | $0.630
12 | C20 | 1 | Panasonic | 10SVPE220M | 220uF ±20% 10V OS-CON polymer, ESR 20mΩ, SMD D6.3xL5.9mm (TPS5430 internal comp needs ESR <=40mΩ)『 』220uF 10V | CAP-SMD_BD6.3-L6.6-W6.6-FD | SMD |  | Top | $3.893 | $19.465
13 | C26,C29 | 2 | muRata | GCM155R71H473KE02D | 47nF ±10% 50V Ceramic Capacitor X7R 0402『 』47nF | C_0402_1005Metric | SMD |  | Bottom | $0.064 | $0.640
14 | C30 | 1 | Samsung Electro-Mechanics | CL05A475MP5NRNC | 4.7uF ±20% 10V Ceramic Capacitor X5R 0402『 』4.7uF | C_0402_1005Metric | SMD |  | Bottom | $0.107 | $0.535
15 | C33 | 1 | muRata | GRM155R61H105KE05D | 1uF ±10% 50V Ceramic Capacitor X5R 0402『 』1uF | C_0402_1005Metric | SMD |  | Top | $0.219 | $1.095
16 | C39 | 1 | PSA | FS32X125K101EGG | 1.2uF +/-10% 100V Ceramic Capacitor X7R 1210『 』1.2uF 100V | C_1210_3225Metric | SMD |  | Bottom | $1.010 | $5.050
17 | CN1,CN2 | 2 | Phoenix Contact | 1729128 | 1.5 17.5A 400V 1x2P Green 16~26 Through Hole 2 1 5.08mm Through Hole,P=5.08mm Wire to Board RoHS『 』MKDSN 1,5/ 2-5,08 | CONN-TH_2P-P5.08_1729128 | THT |  | Top | $0.509 | $5.090
18 | CN3 | 1 | JST | SM04B-SRSS-TB(LF)(SN) | Connector Header 4 position 1mm Pitch 1A Surface Mount, Right Angle -25℃~+85℃『 』SM04B-SRSS-TB (LF)(SN) | CONN-SMD_4P-P1.00_SM04B-SRSS-TB-LF-SN | SMD |  | Top | $0.712 | $3.560
19 | CN4 | 1 | JST | BM10B-GHS-TBT(LF)(SN) | BM10B-GHS-TBT | CONN-SMD_BM10B-GHS-TBT-LF-SN | SMD |  | Top | $1.570 | $7.850
20 | D1,D4,D15,D17 | 4 | onsemi | SS14 | 40V 1A Schottky diode, SMA (DO-214AC)『 』SS14 | D_SMA | SMD |  | Bottom/Top | $0.250 | $5.000
21 | D2,D3 | 2 | R+O | H5VL10B | 5V bidirectional ESD diode, DFN1006-2L (SOD-882 land)『 』H5VL10B | D_SOD-882 | SMD |  | Bottom | $0.041 | $0.410
22 | D5 | 1 | Worldsemi | WS2812B-2020 | RGB LED with integrated controller, 2.0 x 2.0 mm『 』WS2812B-2020 | LED_WS2812B-2020_PLCC4_2.0x2.0mm | SMD |  | Top | $0.062 | $0.310 |  | WS2812B-2020-V6 | The part we supply is WS2812B-2020-V6 | GOOD
23 | D6 | 1 | Littelfuse | SMBJ18A | 18V TVS diode, SMB (DO-214AA)『 』SMBJ18A | D_SMB | SMD |  | Bottom | $0.993 | $4.965 | 7-10 Workdays
24 | D7 | 1 | LRC | LMBR340FT1G | Schottky diode, SOD-123F『 』LMBR340FT1G | D_SOD-123F | SMD |  | Top | $0.169 | $0.845
25 | D8 | 1 | Vishay | VS-43CTQ100S-M3 | Dual Schottky rectifier, D2PAK『 』VS-43CTQ100S-M3 | D2PAK_L10.0-W9.0-P2.54-LS15.0-TL-1 | SMD |  | Top | $3.623 | $18.115
26 | D9,D11,D12,D13,D18,D19 | 6 | onsemi | ESD5Z3.3T1G | 3.3V ESD protection diode, SOD-523『 』ESD5Z3.3T1G | D_SOD-523 | SMD |  | Bottom/Top | $0.114 | $3.420
27 | D10 | 1 | UMW | PESD1CAN | CAN bus ESD protection, SOT-23『 』PESD1CAN | SOT-23 | SMD |  | Top | $0.145 | $0.725
28 | D14 | 1 | R+O | SS56 | 60V 5A Schottky diode, SMA『 』SS56 | D_SMA | SMD |  | Bottom | $0.081 | $0.405
29 | D16 | 1 | KENTO | KT-0603R | Red LED 0603『 』KT-0603R | LED_0603_1608Metric | SMD |  | Top | $0.072 | $0.360
30 | D20 | 1 | onsemi | MBRS3100T3G | Schottky rectifier, SMC『 』MBRS3100T3G | D_SMC | SMD |  | Bottom | $0.483 | $2.415
31 | D21 | 1 | Diodes Incorporated | 1N4148W-7-F | 75V 150mA switching diode SOD-123; drops D5 VDD ~0.65 V so 3.3 V data meets WS2812B VIH (#183)『 』1N4148W | D_SOD-123 | SMD |  | Bottom | $0.338 | $1.690 | 7-10 Workdays
32 | D22 | 1 | Diodes Inc | S3MB-13-F | 1000V 3A rectifier, SMB『 』S3MB-13-F | D_SMB | SMD |  | Top | $0.483 | $2.415
33 | F1 | 1 | XFCN | XF-506P | XF-506P MINI blade fuse holder『 』2A | FUSE-TH_XF-506P | THT |  | Top | $0.192 | $0.960
34 | F2 | 1 | XFCN | XF-506P | XF-506P MINI blade fuse holder『 』1A | FUSE-TH_XF-506P | THT |  | Top | $0.192 | $0.960
35 | F3,F4 | 2 | XFCN | XF-506P | XF-506P MINI blade fuse holder『 』10A | FUSE-TH_XF-506P | THT |  | Top | $0.144 | $1.440
36 | Flash1 | 1 | XKB | TS-1187A-B-A-B | TS-1187A tactile switch, 2 pin『 』Flash | SW_Push_1P1T_XKB_TS-1187A | SMD |  | Top | $0.072 | $0.360
37 | J1 | 1 | HCTL | HC-TYPE-C-16P-01A | USB 2.0-only 16P Type-C receptacle『 』USB_C_Receptacle_USB2.0_16P | USB_C_Receptacle_HCTL_HC-TYPE-C-16P-01A | SMD |  | Top | $0.242 | $1.210
38 | JP1 | 1 | BOOMELE | 1.27-1*2PPin | 1.27 mm 1x2 vertical pin header. Leave open; shunt is supplied loose.『 』CAN Bus Term | PinHeader_1x02_P1.27mm_Vertical | THT | Plave Item # 80 in JP1 | Top | $0.254 | $1.270 |  | 1.27-1*2P | You noted"Fit BOOMELE shunt MPN 1.27, LCSC C150949, onto these pins." . Should we need to purchase C150949, for JP1 as accessories? | YES, C150949 is item # 80 and place item # 80 on JP1
39 | L1 | 1 | muRata | DFE252012F-1R0M=P2 | 1uH 3.3A shielded inductor, 1008『 』1uH 3.3A 40mΩ | L_1008_2520Metric | SMD |  | Top | $0.242 | $1.210
40 | L2 | 1 | FANGCHENG | FC-DR1207-220MT | 22uH +/-20% shielded inductor, 12.5x12.5 mm, Irms 4A, DCR 40 mohm『 』22uH | IND-SMD_L12.5-W12.5_B82477P4XX | SMD |  | Bottom | $0.390 | $1.950 |  | SMDRI129-220MT |  | GOOD
41 | L3,L4,L6 | 3 | muRata | BLM21PG121SN1D | 120 ohm at 100 MHz ferrite bead, 0805『 』BLM21PG121SN1D | L_0805_2012Metric | SMD |  | Bottom/Top | $0.107 | $1.605
42 | L5 | 1 | Sumida | CDRH104RNP-150NC | 15uH shielded inductor, 10.2 x 10.0 mm『 』CDRH104RNP-150NC | IND-SMD_L10.2-W10.0 | SMD |  | Top | $0.966 | $4.830
43 | L7,L9,L10 | 3 | muRata | BLM21PG331SN1D | 330 ohm at 100 MHz ferrite bead, 0805, 1.5A『 』BLM21PG331SN1D | L_0805_2012Metric | SMD |  | Bottom | $0.161 | $2.415
44 | L8 | 1 | muRata | DLW21SN900SQ2L | 90 ohm common-mode choke, 0805『 』DLW21SN900SQ2L | FILTER-SMD_4P-L2.0-W1.2-BL_DLW21H | SMD |  | Bottom | $0.242 | $1.210
45 | Q2,Q3 | 2 | R+O | S8050 | NPN transistor, 25V, 500mA, SOT-23『 』S8050 | SOT-23 | SMD |  | Bottom | $0.250 | $2.500
46 | Q4 | 1 | VBsemi | BUK762R4-60E,118-VB | N-channel MOSFET, 60V, TO-263『 』BUK762R4-60E | TO-263-2_L10.1-W9.1-P5.08-LS15.2-BR | SMD |  | Top | $2.125 | $10.625 | 7-10 Workdays
47 | R1,R2 | 2 | UNI-ROYAL | 0402WGF5101TCE | 5.1 kohm +/-1% 0402『 』5.1K | R_0402_1005Metric | SMD |  | Bottom | $0.009 | $0.090
48 | R3,R10,R15,R20,R25,R26,R27,R28,R32,R40,R42,R43 | 12 | UNI-ROYAL | 0402WGF1002TCE | 10 kohm +/-1% 0402『 』10K | R_0402_1005Metric | SMD |  | Bottom/Top | $0.007 | $0.420
49 | R4 | 1 | UNI-ROYAL | 0805W8F1003T5E | 100 kohm +/-1% 0805『 』100K | R_0805_2012Metric | SMD |  | Top | $0.038 | $0.190
50 | R5,R6 | 2 | UNI-ROYAL | 0402WGF330JTCE | 33 ohm +/-5% 0402『 』33R | R_0402_1005Metric | SMD |  | Bottom | $0.004 | $0.040
51 | R7,R9,R35,R36 | 4 | FOJAN | FRC0805J100 TS | 10 ohm +/-5% 0805『 』10 | R_0805_2012Metric | SMD |  | Bottom | $0.008 | $0.160
52 | R8 | 1 | UNI-ROYAL | 0805W8F2202T5E | 22 kohm +/-1% 0805『 』22K | R_0805_2012Metric | SMD |  | Top | $0.030 | $0.150
53 | R11 | 1 | Yageo | PE0201FRF7W0R2L | 200 mohm +/-1% 100mW 0201『 』200m | R_0201_0603Metric | SMD |  | Bottom | $1.729 | $8.645 | 7-10 Workdays
54 | R12 | 1 | UNI-ROYAL | 0402WGF3241TCE | 3.24 kohm +/-1% 0402『 』3k24 | R_0402_1005Metric | SMD |  | Top | $0.011 | $0.055
55 | R14,R19,R21,R23,R24,R49,R50 | 7 | UNI-ROYAL | 0805W8F1200T5E | 120 ohm +/-1% 0805『 』120 | R_0805_2012Metric | SMD |  | Bottom/Top | $0.014 | $0.490
56 | R16 | 1 | UNI-ROYAL | 25121WJ0103T4E | 10 kohm +/-5% 1W 2512『 』10K/1W | R_2512_6332Metric | SMD |  | Top | $0.242 | $1.210
57 | R22,R29,R30,R41,R44 | 5 | UNI-ROYAL | 0402WGF1001TCE | 1 kohm +/-1% 0402『 』1K | R_0402_1005Metric | SMD |  | Bottom/Top | $0.008 | $0.200
58 | R31 | 1 | UNI-ROYAL | 0805W8F1000T5E | 100 ohm +/-1% 0805『 』100 | R_0805_2012Metric | SMD |  | Top | $0.027 | $0.135
59 | R33 | 1 | UNI-ROYAL | 0402WGF4700TCE | 470 ohm +/-1% 0402『 』470R | R_0402_1005Metric | SMD |  | Top | $0.017 | $0.085
60 | R34 | 1 | UNI-ROYAL | 0402WGF1000TCE | 100Ω (1000) ±1%『 』100 | R0402 | SMD |  | Top | $0.007 | $0.035
61 | R38,R39 | 2 | Changlong | CL0805FN3R9PS | 3.9 ohm 0805『 』3.9 | R_0805_2012Metric | SMD |  | Bottom | $0.012 | $0.120
62 | R46 | 1 | EVER OHMS | CR2512F47K0E04Z | 47 kohm +/-1% 1W 2512『 』47K/1W | R_2512_6332Metric | SMD |  | Top | $0.379 | $1.895
63 | R47 | 1 | TE Connectivity | CRGP2512F2K2 | 2.2 kohm +/-1% 1W 2512『 』2K2 | R_2512_6332Metric | SMD |  | Bottom | $1.313 | $6.565
64 | R48 | 1 | UNI-ROYAL | 0402WGF4702TCE | 47 kohm +/-1% 0402『 』47K | R_0402_1005Metric | SMD |  | Top | $0.017 | $0.085
65 | Relay1 | 1 | Songle | SRD-12VDC-SL-C | 12V relay, SPDT『 』SRD-12VDC-SL-C | RELAY-TH_SRD-XXVDC-XL-C | THT |  | Top | $0.725 | $3.625
66 | Reset1 | 1 | XKB | TS-1187A-B-A-B | TS-1187A tactile switch, 2 pin『 』Reset | SW_Push_1P1T_XKB_TS-1187A | SMD |  | Top | $0.072 | $0.360
67 | U1 | 1 | Silergy | SY8089A1AAC | SY8089A1AAC buck regulator, TSOT-23-5『 』SY8089A1AAC | TSOT-23-5 | SMD |  | Top | $0.242 | $1.210
68 | U2,U18,U19 | 3 | TI | INA226AQDGSRQ1 | High-Side or Low-Side Measurement, Bi-Directional Current and Power Monitor (0-36V) with I2C Compatible Interface, VSSOP-10『 』INA226 | VSSOP-10_3x3mm_P0.5mm | SMD |  | Top | $5.581 | $83.715
69 | U3 | 1 | TI | TPS5430DDA | TPS5430DDA 3A buck regulator, PowerSO-8『 』TPS5430DDA | TI_SO-PowerPAD-8_ThermalVias | SMD |  | Top | $0.966 | $4.830
70 | U4,U5,U6 | 3 | DORABO | DB125-3.5-2P-GN-S | 3.50 mm 2-pin terminal block『 』DB125-3.5-2P-GN-S | CONN-TH_2P-P3.50_L7.4-W7.0 | THT |  | Top | $0.429 | $6.435
71 | U7,U9,U12,U13 | 4 | DORABO | DB125-3.5-3P-GN-S | 3.50 mm 3-pin terminal block『 』DB125-3.5-3P-GN-S | CONN-TH_3P-P3.50_L7.4-W10.5 | THT |  | Top | $0.423 | $8.460
72 | U8 | 1 | Espressif | ESP32-S3-WROOM-2-N32R16V | ESP32-S3-WROOM-2-N32R16V, 32 MB octal flash, 16 MB octal PSRAM, PCB antenna『 』ESP32-S3-WROOM-2-N32R16V | ESP32-S3-WROOM-2 | SMD |  | Top | $19.980 | $99.900
73 | U11 | 1 | TI | SN65HVD230DR | SN65HVD230DR CAN transceiver, SOIC-8『 』SN65HVD230DR | SOIC-8_3.9x4.9mm_P1.27mm | SMD |  | Top | $0.966 | $4.830
74 | U14,U16,U17,U21 | 4 | UMW | PC817C-S | PC817C-S optocoupler, SOP-4『 』PC817C-S | SOP-4_L6.5-W4.6-P2.54-LS10.3-TL | SMD |  | Bottom/Top | $0.034 | $0.680
75 | U22 | 1 | TI | SN74LVC1G14DBVR | SN74LVC1G14DBVR Schmitt inverter, SOT-23-5『 』SN74LVC1G14DBVR | SOT-23-5 | SMD |  | Bottom | $0.121 | $0.605
76 | U23 | 1 | Microchip | MCP1407-E/MF | MCP1407-E/MF MOSFET driver, DFN-8『 』MCP1407-E/MF | DFN-8_L6.0-W5.0-P1.27-BL-EP4.0 | SMD |  | Top | $1.932 | $9.660
77 | F1-FUSE | 1 | Littelfuse | 0297002.WXNV | LOOSE - MINI blade fuse 2A 32V for holder F1 (XF-506P)『 』2A |  | LOOSE | You should insert blade fuse into F1 holder |  | $0.111 | $0.555
78 | F2-FUSE | 1 | JDTfuse(集电通) | 0297001.WXNV | LOOSE - MINI blade fuse 1A 32V for holder F2 (XF-506P)『 』1A |  | LOOSE | You should insert blade fuse into F2 holder |  | $0.132 | $0.660 |  | 0297001.J | The part we supply is 0297001.J JDTfuse，OK? | GOOD
79 | F3-FUSE,F4-FUSE | 2 | Littelfuse | 0297010.WXNV | LOOSE - MINI blade fuse 10A 32V for holders F3, F4 (XF-506P)『 』10A |  | LOOSE | You should insert blade fuse into F3, F4 holders |  | $0.083 | $0.830
80 | JP1-SHUNT | 1 |  |  | LOOSE - 2-pin 1.27 mm pitch jumper shunt for JP1 (CAN termination; leave JP1 open)『 』Jumper 1.27mm |  | LOOSE | You should insert shunt onto JP1 |  | $0.193 | $0.965 |  | 1.27mm, shunt
 |  |  |  |  |  |  |  |  |  | Component Cost | $411.64 | 82.328
 |  |  |  |  |  |  |  |  |  | Assembly Cost | $164.07 | 32.814
 |  |  |  |  |  |  |  |  |  | PCB Cost | $225.64 | 45.128
 |  |  |  |  |  |  |  |  |  | V3 Member 3% off | -$11.69
 |  |  |  |  |  |  |  |  |  | All Total 5 Units | $789.66 | 157.93174
