Cadburies/SisuAssistant/MarineBoard/Documentation/Enclosure Connector model and purchase link—10.9.xlsx

序号 | 名称 | 规格 | 链接
1 | M22防水连接器M22 Waterproof Connector | EW-LP20型3芯面板正装（锁线）EW-LP20 Type, 3-Pin Front-Mount Panel Connector (Wire Locking) | https://detail.tmall.com/item.htm?id=780681527584
2 | M12航空插头M12 Aviation Connector | 玫红色[板后5芯法兰母座 开孔12]Rose Red [5-Pin Rear-Mount Flange Female Socket, 12 mm Mounting Hole] | https://item.taobao.com/item.htm?id=669405263084
3 | 航空插头插座12G 12G Aviation Connector Socket | IP67级防水12G-3芯母插头+公插座IP67 Waterproof 12G 3-Pin Female Plug + Male Socket | https://item.taobao.com/item.htm?id=612992692304&skuId=4319587693527
4 | 航空插头插座12G 12G Aviation Connector Socket | IP67级防水12G-2芯母插头+公插座 IP67 Waterproof 12G 2-Pin Female Plug + Male Socket | https://item.taobao.com/item.htm?id=612992692304&skuId=4319587693527
