Cadburies/SisuAssistant/MarineBoard/Documentation/MarineBoard-enclosure-PCBWay-BOM.xlsx

Sheet: Order
Marine Board enclosure
Print, seal, and fit the connectors. Pack every female plug loose and unsoldered. Leave the PCB out.
Field | Value | Note
Enclosure quantity | 5 | Edit the yellow cell. Printed parts, connectors, and hardware recalculate.
PCB order | T-1P19W831004A | Five boards. One enclosure per board, unless the quantity above is changed.
Replaces | L-4C13W831004A enclosure | New box. Do not reuse the earlier enclosure STEP.
Closed size | 129.4 × 107.9 × 44.0 mm | Bottom 129.4 × 107.9 × 40.8 mm, about 121 cm³. Lid 3.2 mm, about 46 cm³.
Material | Nylon PA12, SLS or MJF, then a waterproof seal | Impregnation or vapor smoothing. Unsealed SLS is porous. Not FDM. Tough solid-wall SLA resin is acceptable.
Colour | Natural or black | Either is fine. Engraving must stay readable after sealing.
Files to attach
MarineBoard-enclosure-bottom.step | Bottom, geometry reference. Opening faces up.
MarineBoard-enclosure-body.stl | Same bottom, mesh. Print as supplied, opening up.
MarineBoard-enclosure-top.step | Lid, geometry reference. Lip and light-pipe boss face down in this file.
MarineBoard-enclosure-lid.stl | Same lid, already rotated for printing. Lip and boss face up. Do not rotate this STL again.
Fit rules
1 | Fit the male half in the wall. Pack the matching female half loose and unsoldered.
2 | The engraved text above each hole names that hole. Text is upright with the lid at the top and reads left to right in pin order.
3 | Do not install the PCB, and do not solder any wire. Pack the four M3×6 screws loose.
4 | Do not drill a hole that is not in the STEP. The M12 is a round hole only; ask before adding a flange bolt circle.
5 | East holes are 20 mm apart. Ask before enlarging a hole if two nuts would overlap.
6 | The LP20 body extends inward past the south gutter. Leave that hole where it is.
7 | There is no USB hole. The north wall has no connector.
8 | Press the Ø2.0 mm silicone cord into the groove on the top rim of the bottom. Cut about 380 mm from the 500 mm supplied.
9 | Light pipe: Ø5.0 × 25 mm clear rod, outer end flush with the lid, sealed with clear neutral-cure silicone in the Ø10 × 1.4 mm well.
10 | Screw the lid on with four M3×10 stainless self-tapping pan-head screws.

Sheet: Printed parts
Printed parts
One bottom and one lid per enclosure. Qty to order follows the yellow quantity on the Order sheet.
Qty per enclosure | Qty to order | Part | Notes
1 |  | Bottom | STEP MarineBoard-enclosure-bottom.step. STL MarineBoard-enclosure-body.stl. Print opening up. 129.4 × 107.9 × 40.8 mm, about 121 cm³. Four blind M3 bosses, silicone-cord groove on the top rim, six connector holes.
1 |  | Lid | STEP MarineBoard-enclosure-top.step. STL MarineBoard-enclosure-lid.stl is already rotated so the sealing lip and the light-pipe boss face up. Print that STL as supplied. 3.2 mm thick, about 46 cm³. Four countersunk corner holes and one light-pipe bore.

Sheet: Connectors
Connectors
Fit the male half in the engraved hole. Pack the female half loose and unsoldered. Do not wire anything.
Qty per enclosure | Qty to order | Part | Where it goes | Engraving | Link | Note
1 |  | EW-LP20, 3-pin, front-mount panel, wire-locking, male | South wall, the large hole (Ø22.7 mm in the model; datasheet cutout 22.5 mm +0.2). | GND/+12V/PWM | https://detail.tmall.com/item.htm?id=780681527584 | Fit this male half. The body extends inward past the gutter. Do not move the hole.
1 |  | EW-LP20, matching 3-pin female cable plug | Pack loose. Do not solder. | — | https://detail.tmall.com/item.htm?id=780681527584 | One mating plug per fitted LP20.
1 |  | M12, 5-pin, rose red, rear-mount flange, MALE socket, 12 mm hole | East wall, the hole nearest the empty north corner. Model hole Ø12.4 mm. | CAN | https://item.taobao.com/item.htm?id=669405263084 | The link is the female flange. Order the male flange from the same series. The model is a round hole only. Ask before drilling a bolt circle.
1 |  | M12, matching 5-pin female plug | Pack loose. Do not solder. | — | https://item.taobao.com/item.htm?id=669405263084 | One mating plug per fitted male socket.
3 |  | 12G, IP67, 3-pin male panel socket, 12 mm hole | Three holes, all Ø12.4 mm. West wall. South wall, the smaller hole. East wall, the southern hole of the three. | TMP/RPM/ENBL · NO/CO/NC · LVL2/+12V/LVL1 | https://item.taobao.com/item.htm?id=612992692304 | Confirm the 3-pin SKU. The old purchase sheet used the same SKU for the 2-pin and the 3-pin. East holes are 20 mm apart. Ask before enlarging a hole.
3 |  | 12G, IP67, 3-pin female plug | Pack loose. Do not solder. Three plugs per enclosure. | — | https://item.taobao.com/item.htm?id=612992692304 | One female plug for each fitted 3-pin male socket.
1 |  | 12G, IP67, 2-pin male panel socket, 12 mm hole | East wall, the middle of the three Ø12.4 mm holes. | SH-/SH+ | https://item.taobao.com/item.htm?id=612992692304 | Confirm the 2-pin SKU on the same listing.
1 |  | 12G, IP67, 2-pin female plug | Pack loose. Do not solder. | — | https://item.taobao.com/item.htm?id=612992692304 | One mating plug per fitted 2-pin male socket.

Sheet: Hardware
Hardware
Screws, cord, light pipe, and sealant. The lid screws are fitted. The board screws stay in the bag.
Qty per enclosure | Qty to order | Part | Use
4 |  | M3×10 stainless self-tapping pan head | Fit the lid. Four screws. The pilot is Ø2.6 mm and 9 mm deep. A longer screw bottoms out.
4 |  | M3×6 stainless self-tapping pan head | Pack loose for the PCB. Four screws. The boss pilot is Ø2.7 mm and 5 mm deep. Do not fit a board.
500 mm |  | Silicone cord, Ø2.0 mm round, length in millimetres | Press one loop into the groove on the top rim of the bottom. The groove is about 360 mm. Cut about 380 mm from the 500 mm supplied. Do not stretch the cord.
1 |  | Clear acrylic or polycarbonate rod, Ø5.0 mm × 25 mm | Light pipe. Fit from the outside of the lid until the outer end is flush. Bore Ø5.2 mm, glue well Ø10 × 1.4 mm. The 25 mm length stops short of the LED once the board is fitted.
— | 1 tube | Clear neutral-cure silicone, one tube for the whole batch | Seal the light pipe in the glue well. One tube covers this order. This line does not multiply by the enclosure quantity.
