Cadburies/SisuAssistant/MarineBoard/Documentation/PCBWay delivery 2026-08-15/PCB Manufacturing Files/BOM_pcbway design/BOM_PCBWay.xlsx

 |  |  | L-4C13W831004A _ PCS BOM (Sample Bill of Materials)
Item # | *Designator | *Qty | Manufacturer | *Mfg Part # | Description / Value | *Package/Footprint | Type | Your Instructions / Notes
1 | BUZZER1 | 1 | C556936 | KLJ-4020 | KLJ-4020 | EasyEDA:BUZ-SMD_L4.0-W4.0-P3.50-L
2 | C1,C17,C25 | 3 | C15525 | CL05A106MQ5NUNC | 10uF | Capacitor_SMD:C_0402_1005Metric
3 | C2,C3,C5,C7,C9,C11,C12,C14,C19, C22,C24,C27,C28,C31,C32,C34,C35,C36,C37,C38 | 20 | C1525 | CL05B104KO5NNNC | 0.1uF | Capacitor_SMD:C_0402_1005Metric
4 | C4,C8 | 2 | C3845593 | GRM158R61A226ME15D | 22uF | Capacitor_SMD:C_0402_1005Metric
5 | C6 | 1 | C88896 | GJM1555C1H6R8BB01D | 6.8pF | Capacitor_SMD:C_0402_1005Metric
6 | C10,C16,C30 | 3 | C23733 | CL05A475MP5NRNC | 4.7uF | Capacitor_SMD:C_0402_1005Metric
7 | C13 | 1 | C440198 | GRM21BR61H106KE43L | 10uF/50V | Capacitor_SMD:C_0805_2012Metric
8 | C15 | 1 | C403725 | GRM31CR61E476ME44 | 47uF | Capacitor_SMD:C_1206_3216Metric
9 | C18 | 1 | C15195 | CL05B103KB5NNNC | 10nF | Capacitor_SMD:C_01005_0402Metric
10 | C20 | 1 | C970694 | RVT1A221M0605 220UF 10V | 220uF 10V | easyeda2kicad:CAP-SMD_BD6.3-L6.6-W6.6-FD
11 | C21 | 1 | C668348 | GRM1555C1H152JA01D | 1.5nF | Capacitor_SMD:C_01005_0402Metric
12 | C23 | 1 | C76951 | GRM1555C1H151JA01D | 150pF | Capacitor_SMD:C_01005_0402Metric
13 | C26,C29 | 2 | C368599 | GCM155R71H473KE02D | 47nF | Capacitor_SMD:C_01005_0402Metric
14 | CN1,CN2 | 2 | C7509570 | 1729128 | MKDSN 1,5/ 2-5,08 | easyeda2kicad:CONN-TH_2P-P5.08_1729128
15 | CN3 | 1 | C160404 | SM04B-SRSS-TB(LF)(SN) | SM04B-SRSS-TB (LF)(SN) | easyeda2kicad:CONN-SMD_4P-P1.00_SM04B-SRSS-TB-LF-SN
16 | D1,D4,D15 | 3 | C2480 | SS14 | SS14 | Diode_SMD:D_SMA
17 | D2,D3, | 2 | C7420372 | H5VL10B | H5VL10B | DFN1006-2L
18 | D5 | 1 | C72264 | B540C-13-F | B540C-13-F | easyeda2kicad:SMC_L7.1-W6.2-LS8.1-RD
19 | D6 | 1 | C152104 | SMBJ18A | SMBJ18A | EasyEDA:SMB_L4.6-W3.6-LS5.3-RD
20 | D7 | 1 | C417538 | LMBR340FT1G | LMBR340FT1G | EasyEDA:SOD-123FL_L2.7-W1.8-LS3.8-RD
21 | D8,D9,D11,D12,D13,D18,D19 | 7 | C2827729 | ESD5Z3.3T1G | ESD5Z3.3T1G | EasyEDA:SOD-523_L1.2-W0.8-LS1.6-FD
22 | D10 | 1 | C2687121 | PESD1CAN | PESD1CAN | EasyEDA:SOT-23-3_L2.9-W1.3-P1.90-LS2.4-BL-2
23 | D14 | 1 | C49304 | MURS360T3G | MURS360T3G | EasyEDA:SMC_L7.1-W6.2-LS8.1-R-RD
24 | D16,D17 | 2 | C2286 | KT-0603R | LED | LED_SMD:LED_0603_1608Metric
25 | F1,F2,F3 | 3 | C492610 | XF-506P | XF-506P | EasyEDA:FUSE-TH_XF-506P
26 | Flash1,Reset1 | 2 | C318884 | TS-1187A-B-A-B | TS-1187A-B-A-B | Button_Switch_SMD:SW_Push_1P1T_XKB_TS-1187A
27 | J1 | 1 | C19274016 | HC-TYPE-C-16P-3M2S | USB2.0_14P | Connector_USB:USB_C_Receptacle_HCTL_HC-TYPE-C-16P-01A
28 | JP1 | 1 | C703015 | 1.27-1*2P针 | 1.27-1*2P针 | EasyEDA:HDR-TH_2P-P1.27-V-M
29 | JP2 | 1 | C150949 | 1.27短路帽 | 1.27短路帽 | EasyEDA:HDR-TH_2P-P1.27-V-M
30 | L1 | 1 | C435392 | DFE252012F-1R0M=P2 | 1uH 3.3A 40mΩ | easyeda2kicad:L2520
31 | L2 | 1 | C5368704 | FC-DR1207-101MT | FC-DR1207-101MT | EasyEDA:IND-SMD_L12.5-W12.5_B82477P4XX
32 | L5 | 1 | C225048 | CDRH104RNP-150NC | CDRH104RNP-150NC | EasyEDA:IND-SMD_L10.2-W10.0
33 | L7,L9,L10 | 3 | C74764 | BLM21PG331SN1D | BLM21PG331SN1D | EasyEDA:L0805
34 | L8 | 1 | C97856 | DLW21SN900SQ2L | DLW21SN900SQ2L | EasyEDA:FILTER-SMD_4P-L2.0-W1.2-BL_DLW21H
35 | L3.L4.L6 | 3 | C79382 | BLM21PG121SN1D | BLM21PG121SN1D | L0805
36 | Q1 | 1 | C537017 | IPL60R075CFD7 | IPL60R075CFD7 | EasyEDA:VSON-4_L8.1-W8.1-P2.00-BL
37 | Q2.Q3 | 2 | C20069125 | S8050 | S8050 | SOT-23
38 | R1,R2 | 2 | C25905 | 0402WGF5101TCE | 5.1K | Resistor_SMD:R_0402_1005Metric
39 | R3,R10,R15,R18,R20,R25,R26,R27,R28, R32,R40,R42,R43 | 13 | C25744 | 0402WGF1002TCE | 10K | Resistor_SMD:R_0402_1005Metric
40 | R4 | 1 | C149504 | 0805W8F1003T5E | 100K | easyeda2kicad:R0805
41 | R5,R6 | 2 | C25105 | 0402WGF330JTCE | 33R | Resistor_SMD:R_0402_1005Metric
42 | R7,R9,R35,R36 | 4 | C2907296 | FRC0805J100 TS | 10 | EasyEDA:R0805
43 | R8 | 1 | C17560 | 0805W8F2202T5E | 22K | easyeda2kicad:R0805
44 | R11 | 1 | C2089436 | PE0201FRF070R1L | 200m | EasyEDA:R0201
45 | R12 | 1 | C53463851 | RP0402BRB073K24L | 3k24 | EasyEDA:R0402
46 | R13 | 1 | C23079 | 0603WAF5490T5E | 549 | EasyEDA:R0603
47 | R14,R17,R19,R21,R23,R24 | 6 | C17437 | 0805W8F1200T5E | 120 | EasyEDA:R0805
48 | R16,R22,R29,R30,R41,R44 | 6 | C11702 | 0402WGF1001TCE | 1K | Resistor_SMD:R_0402_1005Metric
49 | R31 | 1 | C17408 | 0805W8F1000T5E | 100 | EasyEDA:R0805
50 | R33,R34 | 2 | C25117 | 0402WGF4700TCE | 470R | Resistor_SMD:R_0402_1005Metric
51 | R38,R39 | 2 | C48996903 | CL0805FN3R9PS | 3.9 | EasyEDA:R0805
52 | Relay1 | 1 | C30431 | SRD-12VDC-SL-C | SRD-12VDC-SL-C | EasyEDA:RELAY-TH_SRD-XXVDC-XL-C
53 | U1 | 1 | C479074 | SY8089A1AAC | SY8089A1AAC | easyeda2kicad:TSOT-23-5_L2.9-W1.6-P0.95-LS2.8-BR
54 | U2,U18,U19 | 3 | C2653835 | INA226 | INA226 | Package_SO:VSSOP-10_3x3mm_P0.5mm
55 | U3 | 1 | C502477 | TPS5430DDA | TPS5430DDA | Package_SO:TI_SO-PowerPAD-8_ThermalVias
56 | U4,U5,U6 | 3 | C466970 | DB125-3.5-2P-GN-S | DB125-3.5-2P-GN-S | EasyEDA:CONN-TH_2P-P3.50_L7.4-W7.0
57 | U7,U9,U12,U13 | 4 | C466971 | DB125-3.5-3P-GN-S | DB125-3.5-3P-GN-S | EasyEDA:CONN-TH_3P-P3.50_L7.4-W10.5
58 | U8 | 1 | C42417293 | ESP32-S3-WROOM-2-N32R16V | ESP32-S3-WROOM-2-N32R16V | PCM_Espressif:ESP32-S3-WROOM-2
59 | U10,U14,U16,U17 | 4 | C3008369 | PC817C-S | PC817C-S | EasyEDA:SOP-4_L6.5-W4.6-P2.54-LS10.3-TL
60 | U11 | 1 | C12084 | SN65HVD230DR | SN65HVD230DR | EasyEDA:SOIC-8_L5.0-W4.0-P1.27-LS6.0-BL
61 | U15 | 1 | C52428 | TC4427EPA | TC4427EPA | EasyEDA:DIP-8_L9.4-W6.4-P2.54-LS9.1-BL
 |  | 3 |  | 保险插片 | https://item.taobao.com/item.htm?id=574969378882&skuId=3935274451988&spm=a21m98.27004841
