Cadburies/SisuAssistant/MarineBoard/Documentation/PCBWay delivery 2026-08-15/Design Files/3d_models/CN3.STEP

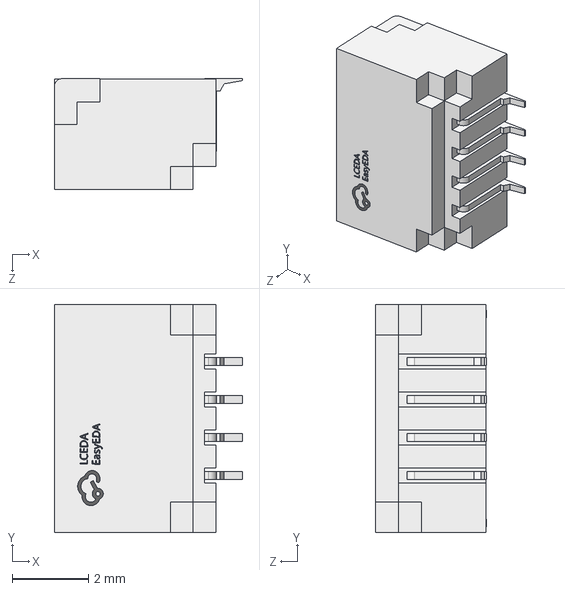
[picture p44: CAD file, 2026-10-09]
MarineBoard/Documentation/PCBWay delivery 2026-08-15/Design Files/3d_models/CN3.STEP
4.95 x 6.00 x 2.91 mm
