Cadburies/SisuAssistant/MarineBoard/enclosure/MarineBoard-enclosure-fit.FCStd

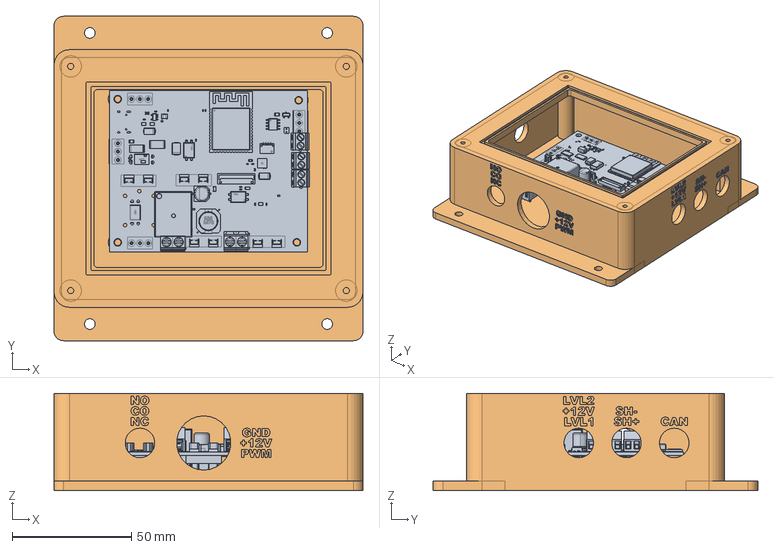
[picture p45: CAD file, 2026-11-06]
MarineBoard/enclosure/MarineBoard-enclosure-fit.FCStd
129.4 x 135.9 x 40.8 mm
KiCad_board
Bottom001
