Cadburies/SisuAssistant/MarineBoard/Documentation/PCBWay delivery 2026-08-15/Design Files/3d_models/TYPE-C.STEP

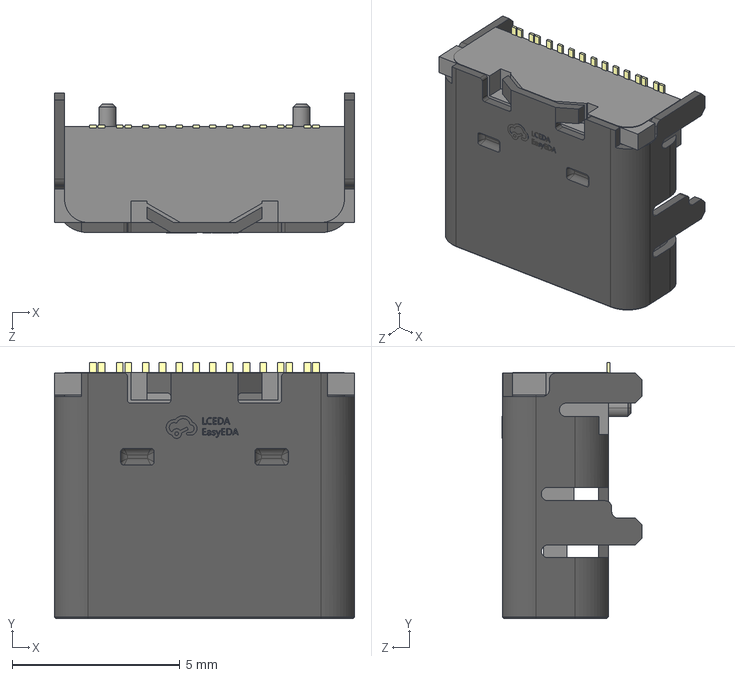
[picture p46: CAD file, 2026-10-09]
MarineBoard/Documentation/PCBWay delivery 2026-08-15/Design Files/3d_models/TYPE-C.STEP
8.95 x 7.65 x 4.17 mm
