Cadburies/SisuAssistant/MarineBoard/enclosure/MarineBoard-enclosure-top.step

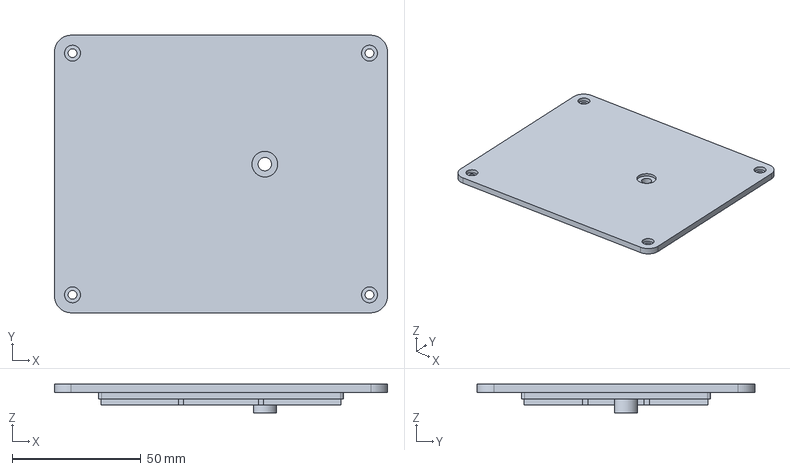
[picture p47: CAD file, 2026-10-14]
MarineBoard/enclosure/MarineBoard-enclosure-top.step
129.4 x 107.9 x 11.2 mm
