Cadburies/SisuAssistant/MarineBoard/Documentation/PCBWay delivery 2026-08-15/Design Files/3d_models/TH_3P.STEP

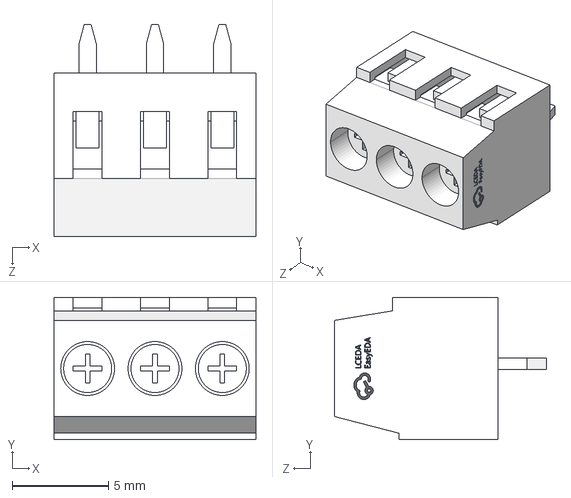
[picture p48: CAD file, 2026-10-09]
MarineBoard/Documentation/PCBWay delivery 2026-08-15/Design Files/3d_models/TH_3P.STEP
10.5 x 7.40 x 11.0 mm
