Cadburies/SisuAssistant/MarineBoard/Documentation/PCBWay delivery 2026-08-15/Design Files/3d_models/TH_2P.STEP

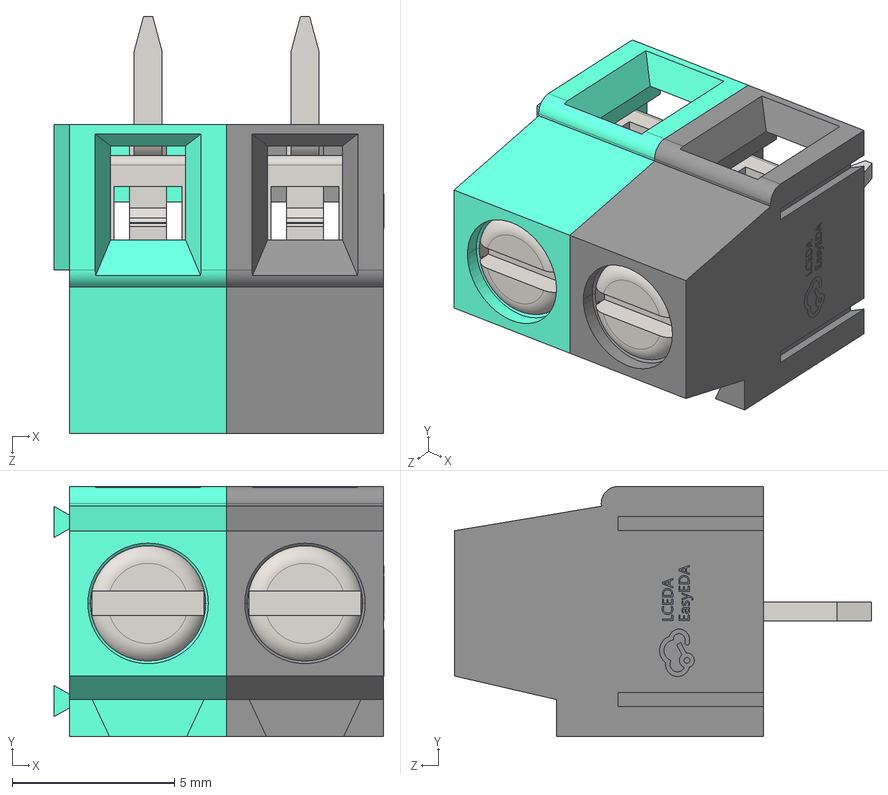
[picture p49: CAD file, 2026-10-09]
MarineBoard/Documentation/PCBWay delivery 2026-08-15/Design Files/3d_models/TH_2P.STEP
10.2 x 7.71 x 12.9 mm
