Cadburies/SisuAssistant/MarineBoard/enclosure/MarineBoard-enclosure.step

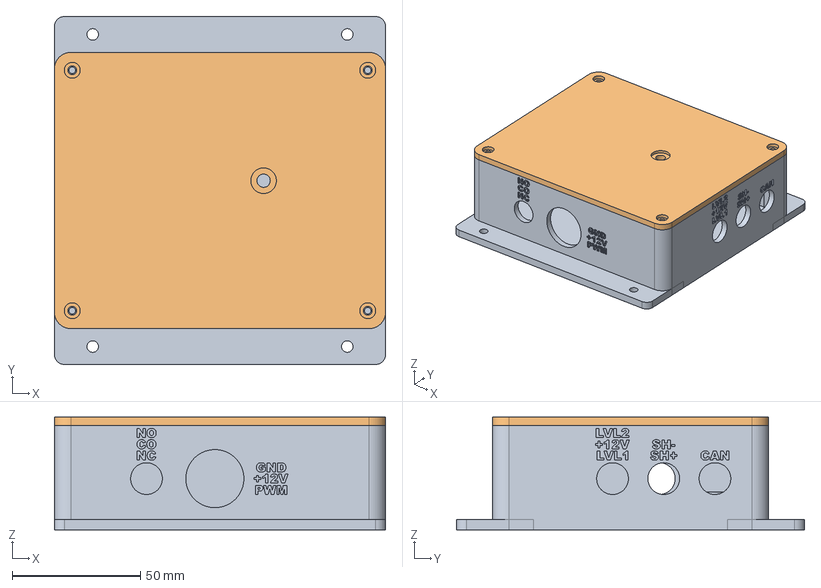
[picture p50: CAD file, 2026-10-14]
MarineBoard/enclosure/MarineBoard-enclosure.step
129.4 x 135.9 x 44.0 mm
Bottom
Lid
