Cadburies/SisuAssistant/MarineBoard/Documentation/PCBWay delivery 2026-08-15/Design Files/3d_models/RELAY-TH.STEP

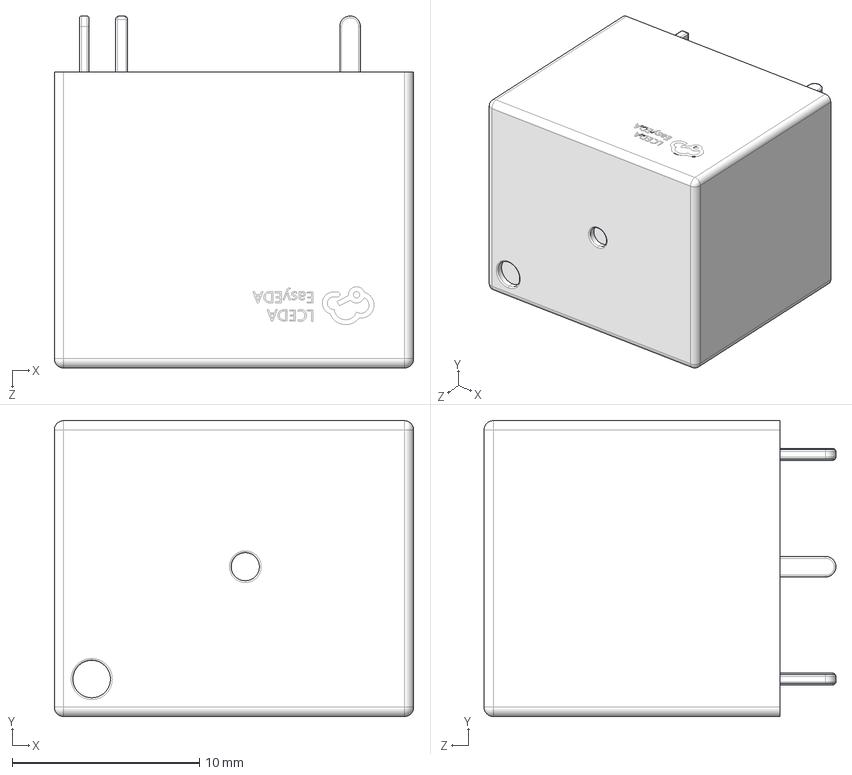
[picture p51: CAD file, 2026-10-09]
MarineBoard/Documentation/PCBWay delivery 2026-08-15/Design Files/3d_models/RELAY-TH.STEP
19.2 x 15.8 x 18.8 mm
