Cadburies/SisuAssistant/MarineBoard/enclosure/MarineBoard-enclosure-body.stl

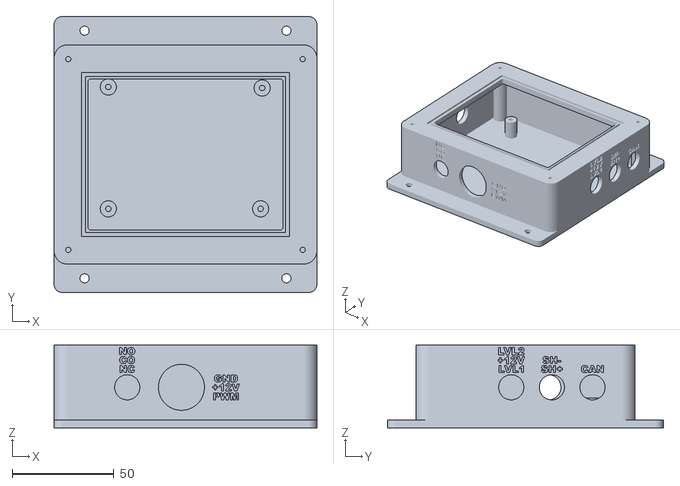
[picture p52: CAD file, 2026-10-14]
MarineBoard/enclosure/MarineBoard-enclosure-body.stl
129.4 x 135.9 x 40.8
