Cadburies/SisuAssistant/MarineBoard/Documentation/PCBWay delivery 2026-08-15/Design Files/3d_models/SMD_L12.5.STEP

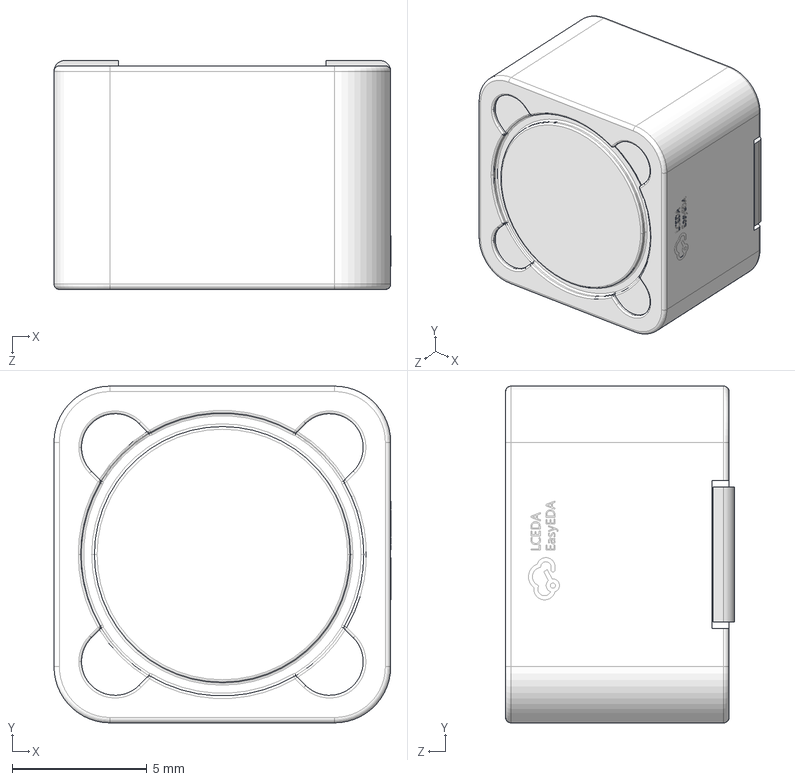
[picture p53: CAD file, 2026-10-09]
MarineBoard/Documentation/PCBWay delivery 2026-08-15/Design Files/3d_models/SMD_L12.5.STEP
12.5 x 12.5 x 8.50 mm
