Cadburies/SisuAssistant/MarineBoard/enclosure/MarineBoard-board.step

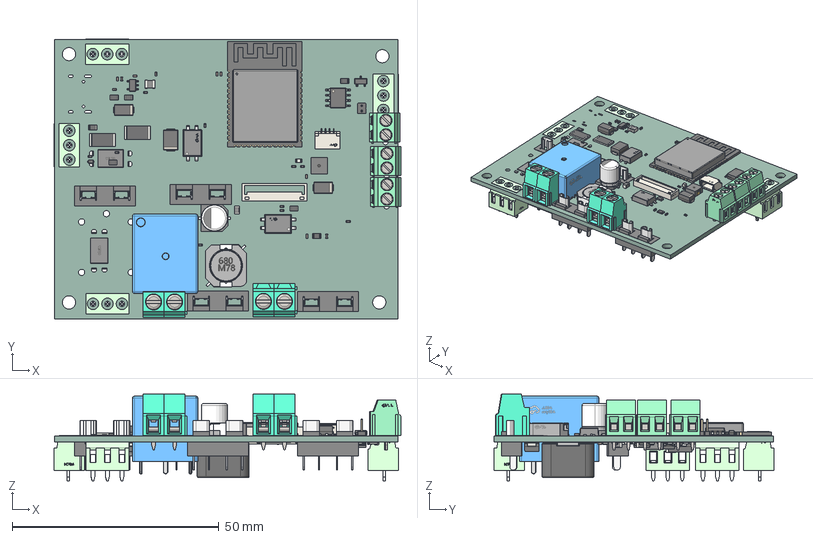
[picture p54: CAD file, 2026-10-09]
MarineBoard/enclosure/MarineBoard-board.step
83.9 x 67.8 x 21.0 mm
R0402_L1.0-W0.5-H0.4
CONN-TH_2P-P3.50_L7.4-W7.0 x 3
SOT-23 x 3
D_SMB x 2
RELAY-TH_L19.2-W15.6-H15.8
FUSE-TH_XF-506P x 4
C_0402_1005Metric x 31
C_1206_3216Metric x 3
R_0402_1005Metric x 24
R_0805_2012Metric x 16
L_1008_2520Metric
D_SMA x 5
CONN-TH_3P-P3.50_L7.4-W10.5 x 4
D_SOD-123F
R_2512_6332Metric x 3
SOIC-8_3.9x4.9mm_P1.27mm
L_0805_2012Metric x 6
BUZ-SMD_2P-L4.0-W4.0-H2.0
TSOT-23-5
SOP-4_L6.5-W4.6-P2.54-LS10.3-TL x 4
LED_0603_1608Metric
D_SOD-523 x 6
CONN-TH_2P-P5.08_1729128 x 2
PinHeader_1x02_P1.27mm_Vertical
CAP-SMD_BD6.3-L6.6-W6.6-FD
CONN-SMD_BM10B-GHS-TBT-LF-SN
IND-SMD_L10.2-W10.0-H3.8
CONN-SMD_SR1.00-WS-4P
ESP32-S3-WROOM-2
IND-SMD_L12.5-W12.5-H8.5_B82477P4XX
C_1210_3225Metric
SOT-23-5
D_SOD-123
SMD-4_L2.0-W1.2-H1.3
D_SOD-882 x 2
C_0805_2012Metric
R_0201_0603Metric
D_SMC
MarineBoard_PCB
