Cadburies/SisuAssistant/MarineBoard/Documentation/PCBWay delivery 2026-08-15/Enclosure Design File (superseded)/Assembly.STEP

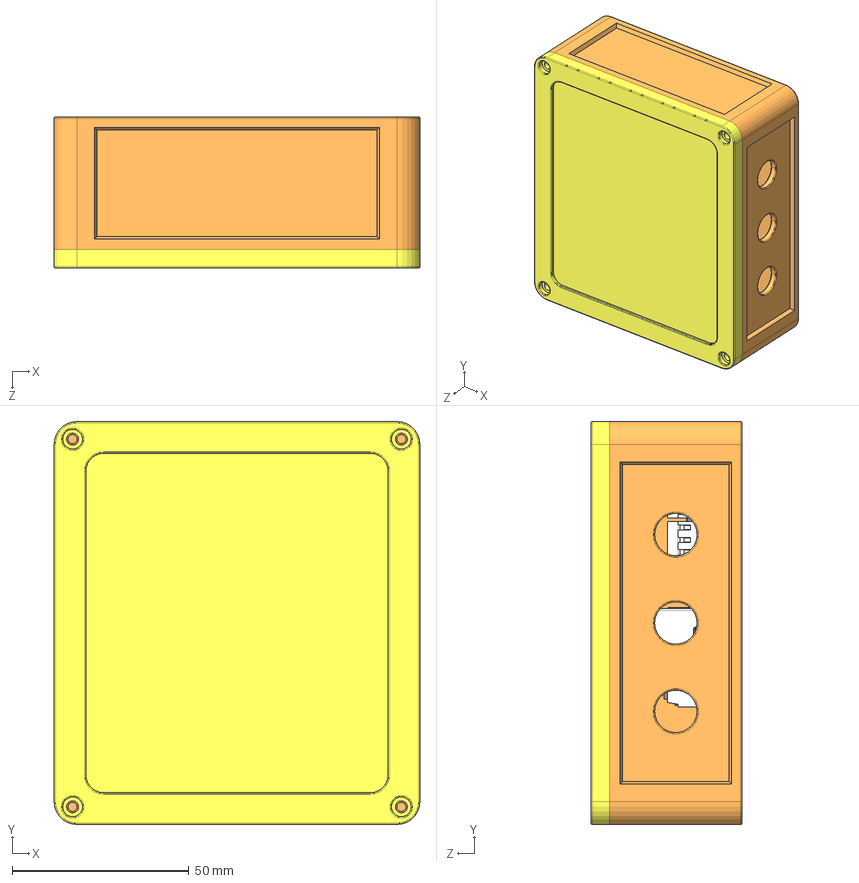
[picture p55: CAD file, 2026-10-09, an earlier design]
MarineBoard/Documentation/PCBWay delivery 2026-08-15/Enclosure Design File (superseded)/Assembly.STEP
103.5 x 114.0 x 42.8 mm
