Cadburies/SisuAssistant/MarineBoard/Documentation/PCBWay delivery 2026-08-15/Enclosure Design File (superseded)/Bottom Housing.STEP

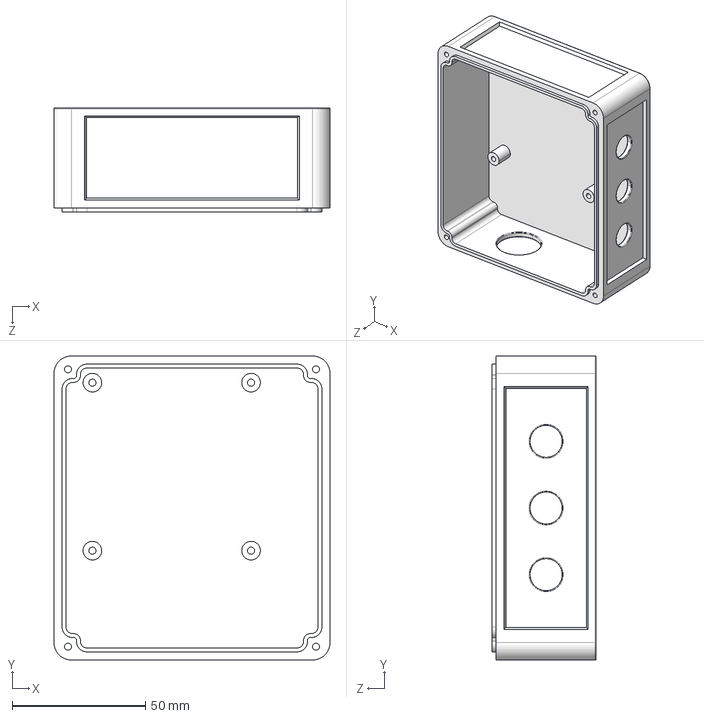
[picture p56: CAD file, 2026-10-09, an earlier design]
MarineBoard/Documentation/PCBWay delivery 2026-08-15/Enclosure Design File (superseded)/Bottom Housing.STEP
103.5 x 114.0 x 39.1 mm
