Cadburies/SisuAssistant/(list of files, cad)

Other CAD files:
MarineBoard/enclosure/MarineBoard-enclosure-lid.stl
MarineBoard/enclosure/MarineBoard-enclosure-bottom.step
MarineBoard/Documentation/PCBWay delivery 2026-08-15/Enclosure Design File (superseded)/Assembly.DXF
MarineBoard/Documentation/PCBWay delivery 2026-08-15/Enclosure Design File (superseded)/Bottom Housing.DXF
MarineBoard/Documentation/PCBWay delivery 2026-08-15/Enclosure Design File (superseded)/Top Housing.DXF
MarineBoard/enclosure/MarineBoard-enclosure.FCStd
