Cadburies/SisuAssistant/MarineBoard/PCB Manufacturing Process Specification.xlsx

PCB Manufacturing Process Specification PCB 加工工艺说明书
File Name： 项目名称 | MarineBoard-PCBWay-Gerbers.zip
1. General Manufacturing Information（基本工艺信息）
Layers 层数 | 4 layer (4层） |  | PCB Material PCB材料 | FR4
Finished Board Thickness(mm) 成品板厚 | 1.6mm |  | Board Thickness Tolerance板厚公差 | ±10%
Finished Board Size(mm) 成品尺寸 | 83.0*67.5mm |  | Dimensional Tolerance 尺寸公差 | ±0.15（常规）
PCB Type 板子类型 | Rigid PCB (刚性板) |  | Paneling Method 拼版方式 | Single Board Delivery（单板交付）
Acceptance Criteria 验收标准 | IPC-6012 II |  | PCB Warpage 翘曲度 | 1.50%
Surface Finish 表面处理 | ENIG (Immersion gold) 沉金 |  | Via Process 过孔方式 | Resin filled + copper capped (POFV), all vias 全部树脂塞孔电镀填平
Soldermask 阻焊颜色 | Green 绿色 |  | Silkscreen 丝印 | White 白色
Special Markings 特殊标记 | None |  | Cycle Identification 周期标识 | No 不加
2. Stackup Information（叠层信息）
TOP | ======================================= |  |  | 1 Oz finished (35um)
 | PP | FR4
GND02 | ======================================= |  |  | 35um（1Oz）
 | Core | FR4
PWR03 | ======================================= |  |  | 35um（1Oz）
 | PP | FR4
BOTTOM | ======================================= |  |  | 1 Oz finished (35um)
3.Impedance Information（阻抗信息）No impedance requirement （无阻抗要求）
Impedance Type 阻抗类型 | Impedance Value 阻抗值 | Control Layer 控制层 |  | Trace Width / Spacing (mil) 线宽/线距 | solder mask on the traces 盖油
单端（Default line） | 50Ω | TOP/BOTTOM |  | 8 | 是/YES
差分（Differential line） | 90Ω | TOP/BOTTOM |  | 5.4/7 | 是/YES
4. Special Instructions（特殊说明）
a. Adjust the layer spacing, trace width, and trace spacing according to actual conditions, but the overall board thickness and impedance requirements must be met.（根据实际情况调整层间距、线宽和线距，但必须满足整体板厚和阻抗要求） b. The dielectric thickness between layers may be adjusted.（层间介质厚度可调整） c. Trace width may be adjusted.（线宽可调整） d.Please compare IPC with short circuit, and if there are any issues, please confirm with EQ.(请ipc开短路比对，如果有问题，请EQ确认。) e. Thermal vias inside SMD pads (Q4, D8, U3, U8, U23): plug/tent from the BOTTOM side only; do not put solder mask on the pad openings.（焊盘内散热过孔仅从底面塞孔/盖油，焊盘开窗不得覆盖阻焊） f. Min finished hole 0.254mm; min track/space 0.127/0.127mm; min annular ring 0.15mm.（最小孔径0.254mm，最小线宽/线距0.127/0.127mm，最小焊环0.15mm）
