Cadburies/SisuAssistant/MarineBoard/Documentation/Design-Rules/6 Hardware Decisions You Should NEVER Trust AI to Make.md

https://youtu.be/MiU6qdGyXCw?si=fZ-mdl0_3yyciO-v

0:00
Someone building his first product asked
0:02
AI to design a small circuit for him.
0:04
The answer came back in seconds with
0:06
every part labeled and every connection
0:09
spelled out and he built it exactly the
0:12
way the AI told him to and it didn't
0:15
work. Now, I use AI every single day.
0:18
And if you're developing a product right
0:19
now, well, then you should be using it
0:21
too, as much as you possibly can. But
0:24
there's one line AI can't cross no
0:27
matter how good the models get. And
0:29
knowing where that line sits is the
0:31
difference between AI saving you weeks
0:33
and AI costing you months. It all comes
0:36
down to the cost of being wrong. In
0:39
software, a wrong answer is cheap since
0:42
you can just patch it and move on. But
0:44
in hardware, a confidently wrong answer
0:47
can mean a board respin, a failed round
0:50
of certification testing, or a
0:52
production order full of faulty units.
0:55
An AI sounds exactly as confident when
0:58
it's wrong as when it's right. So, it
1:01
can never warn you which of its answers
1:03
landed in the small fraction that it
1:05
made up. So, in this video, I'm going to
1:07
walk you through six hardware decisions
1:09
that you should never trust AI to make
1:12
and what to do instead on every one of
1:14
them. Hi, I'm John Thiel. I was a
1:16
microchip design engineer at Texas
1:18
Instruments for over 10 years. Then I
1:21
developed and launched my own product
1:22
into hundreds of retail stores and now I
1:25
help others do the same. Okay, let's get
1:27
started. So the rule I follow is simple.
1:30
Use AI where being wrong is cheap and
1:33
use experienced engineers and product
1:36
experts where being wrong is expensive.
1:38
On the cheap side of that line, AI is
1:40
incredible and I lean on it constantly.
1:43
I use it to explain concepts I'm
1:46
learning, to write first draft code, and
1:48
to summarize a 300page data sheet so I
1:52
know exactly where I need to slow down
1:54
and read more closely. It'll surface
1:56
options fast once I already know the
1:59
question I'm asking. And I even use it
2:01
to pressure test my own reasoning, sort
2:04
of like a colleague I can think out loud
2:06
with. Every one of those uses shares the
2:09
same trait. A wrong answer cost me
2:11
nothing since I'll either catch it or
2:14
just iterate right past it. The six
2:16
decisions coming up are the opposite,
2:18
though. These are the ones where a wrong
2:21
answer gets built into hardware or into
2:23
a purchase order or into a certification
2:26
submission before anybody notices it.
2:29
None of this is me telling you AI is bad
2:31
at engineering because it isn't. It's me
2:33
telling you where the price of a mistake
2:35
changes. Decision number one to never
2:38
trust AI to make is which components go
2:41
into your product. AI is trained on the
2:44
internet and the internet is mostly
2:47
hobbyist content. So when you ask it to
2:49
pick parts for you, it hands you the
2:51
popular hobbyist answer instead of the
2:54
production grade one. That's how an
2:55
Arduino board ends up sitting inside a
2:58
production design. for how a module that
3:01
every blogger loves ends up in a product
3:04
that has to pass certification and ship
3:06
at volume. I've seen designs built
3:08
almost entirely with AI where the
3:10
footprints didn't match the actual parts
3:13
and where several of the components
3:14
couldn't be sourced at production
3:16
quantities at all. One of them had a
3:19
hobbyist module sitting right in the
3:21
middle of what was supposed to be a
3:22
production ready board. Production parts
3:24
get chosen for reasons that never show
3:27
up in a tutorial. You're asking whether
3:29
the manufacturer will still be making
3:31
that part in five years, whether you can
3:33
buy 10,000 of them next quarter, and
3:37
whether there's a pre-certified version
3:39
that saves you an entire round of
3:41
certification testing. A component
3:43
choice is never just a technical
3:45
question. It's a sourcing question, a
3:48
life cycle question, a cost question,
3:50
and a certification question all at the
3:53
same time. and AI has no idea what your
3:56
volumes, your margins, or your target
3:58
countries are going to be. The better
4:00
way to use it here is backwards. Pick
4:02
the part yourself using production
4:05
criteria. Then hand AI the data sheet
4:07
and let it explain the sections that you
4:10
don't understand. Now, almost every
4:11
failure on this list shows up as
4:14
something a second set of eyes would
4:15
have caught. So, I put together a free
4:18
design review checklist bundle that you
4:20
can run your own design against before
4:22
you spend money building anything.
4:24
You'll get separate checklist for your
4:26
schematic, your PCB layout, and your
4:28
enclosure design, which are the three
4:31
places where most of these problems
4:32
hide. The links in the description
4:34
below, or you can scan this QR code
4:36
here. Decision number two to not trust
4:39
AI on is whether a circuit design
4:42
actually works. So, the circuit that I
4:45
opened this video with was a latch. And
4:47
you know, that's just a simple circuit
4:48
that holds a signal on or off until you
4:51
tell it to change. And the guy building
4:53
it was a member of my hardware academy.
4:55
And after days of tweaking values and
4:57
getting nowhere, he went back and asked
4:59
the AI to rework the whole design again.
5:02
And the second answer came back even
5:04
more polished with pin tables and little
5:07
check marks next to every step.
5:10
underneath it was the exact same wrong
5:12
circuit though. So, one of my engineers
5:15
rebuilt the design in a simulator,
5:17
watched it fail there the same way it
5:20
had been failing on the bench, and
5:22
worked out that the product needed a
5:24
completely different type of latch. The
5:26
lesson is that a beautifully formatted
5:29
wrong answer is still wrong, and it'll
5:31
be wrong in exactly the same way the
5:34
second time you ask it. AI doesn't
5:36
notice its own mistakes. No matter how
5:38
nicely you were the follow-up, when you
5:41
ask it to try again, you're not getting
5:43
a review. You're getting a rewrite of
5:45
the same reasoning with better
5:47
presentation. What was missing both
5:49
times was verification, simulating the
5:52
circuit, breadboarding it before you
5:54
commit it to a layout, or putting it in
5:56
front of somebody who will test it and
5:58
then stand behind the result. Get your
6:00
ideas from anywhere you like, including
6:03
AI. But never let an untested idea walk
6:06
straight into your schematic. Decision
6:09
number three to not trust AI on is
6:11
whether your design is actually ready to
6:14
build. Now, plenty of people are
6:16
uploading a schematic or a layout and
6:19
asking AI to review it. And the design
6:21
tools themselves are also shipping AI
6:24
co-pilots that do the same thing. These
6:26
tools do catch real problems, and I'm
6:28
not going to pretend otherwise, but they
6:30
miss far more than they catch. The part
6:33
that should worry you is that they have
6:35
no way of knowing what got missed. An
6:38
experienced reviewer tells you what they
6:40
looked at. So, when they don't flag your
6:42
power supply, that silence actually
6:45
means something to you. With AI, you
6:47
just get a list of findings and no idea
6:50
what was actually covered. Well, that
6:52
means a clean report and a report from a
6:54
tool that just skipped half your board
6:56
look identical to you. Back when I was a
6:58
chip designer at TI, every design I
7:01
worked on had to go through a formal
7:03
review where a room full of engineers
7:06
picked apart it in excruciating detail.
7:09
I was terrified of those meetings for my
7:11
first couple of years. But that process
7:13
existed for a reason. Since designing in
7:16
isolation invites problems no matter how
7:19
experienced you are. That's just as true
7:22
on your hundth design as it is on your
7:24
first. So, the right way to use AI here
7:27
is as a first pass that clears out the
7:29
obvious stuff, like a missing decoupling
7:32
capacitor or an unconnected net before a
7:35
person looks hard at the parts that
7:37
actually cost money to get wrong.
7:40
Decision number four that you should
7:41
avoid using AI on is whether that
7:44
cheaper part is actually cheaper. Cost
7:47
decisions are where AI sounds the most
7:50
reasonable and helps the least since
7:53
it's reasoning from generic knowledge
7:55
instead of your actual numbers. The
7:58
classic version of this is a wireless
8:00
design where the bear chip runs a couple
8:02
of dollars cheaper than a pre-certified
8:05
module. And on a spreadsheet that looks
8:07
like an easy win. What that swap
8:09
actually buys you though is full FCC and
8:12
CE testing on your own design antenna
8:15
tuning. that's now entirely your problem
8:18
and a retest every time your layout or
8:21
your enclosure changes. Ask AI to weigh
8:23
that tradeoff and it'll give you a
8:26
perfectly sensible sounding answer. It
8:28
doesn't know your volume or your
8:30
margins, your target retail price, or
8:32
which countries you're selling into. The
8:34
same thing happens with the part that's
8:36
technically fine but wrecks your margins
8:39
or the cheaper option that sells through
8:41
your design and then fails the safety
8:43
test 6 months later. Certification costs
8:46
also don't scale the way component costs
8:48
do. Saving $2 a unit means nothing at
8:52
all if it triggers another round of lab
8:54
testing that costs more than your entire
8:56
first production run. AI can still help
8:59
you with cost trade-offs, but only if
9:01
you give it your real numbers, your real
9:03
volumes, and your real target markets.
9:06
Just remember that AI doesn't carry your
9:08
full picture from one conversation to
9:10
the next. At least not the way a person
9:13
working with you does. The chat where
9:15
you carefully laid out your volumes and
9:18
profit margins is not the chat where you
9:20
come back to to in two weeks and ask it
9:23
to adjust your design. Unless you
9:25
resupply that entire picture every
9:27
single time, it falls back to generic
9:30
reasoning and it will never tell you
9:32
that's what actually happened. An
9:34
experienced engineer carries your whole
9:36
project around in their head and brings
9:38
it into every conversation you have with
9:40
them. So treat whatever AI hands you as
9:44
a starting point that somebody who's
9:46
been through certification still needs
9:48
to check. Decision number five that you
9:51
should absolutely never trust AI on is
9:54
whether your product idea is any good.
9:57
AI is the most agreeable advisor you
10:00
will ever have and it's biased toward
10:03
telling you yes, but that's the same yes
10:06
you'll get from friends and family who
10:08
want to see you win. and it's worth
10:10
about the same amount. I learned this
10:12
one the expensive way with my own
10:14
product. I treated trade show
10:16
compliments and a single retail store
10:19
test as if they were proof that people
10:21
would actually buy it. Interest isn't
10:23
validation. Enthusiasm isn't either. And
10:27
an AI telling you the market opportunity
10:29
looks promising is worth less than both
10:32
of those. Validation is someone handing
10:35
you money or a store reordering because
10:38
the first batch actually sold through.
10:41
There's no shortcut around that. The
10:43
trap is that a confident yes feels like
10:45
progress. So, you keep building instead
10:48
of going out and finding the one person
10:50
willing to pay you. And if you're going
10:52
to put your idea in front of AI at all,
10:54
flip the prompt around and ask it to
10:57
argue against you. List every reason
10:59
this fails and tell you what would have
11:01
to be true for it to work. Even then,
11:04
treat that output as a list of things to
11:06
go verify with actual customers, not as
11:09
an answer. Hey, and don't forget that
11:10
free design review checklist bundle I
11:12
mentioned earlier. The link is in the
11:14
description below. Decision number six
11:16
that you can't trust AI to make is what
11:19
should you actually be asking in the
11:21
first place? Okay, everything so far has
11:24
been about wrong answers or flattering
11:26
ones. But the biggest failure is a
11:29
different thing entirely because it's
11:31
about the questions that never get asked
11:33
at all. AI is at its best when you
11:36
already know exactly what your problem
11:39
is and it gets much weaker the moment
11:41
you're not sure what the problem even
11:43
is. On its own, it will never raise a
11:46
question you didn't think to ask. I've
11:48
leaned on AI hard in my own business for
11:51
years, and it's given me real help and
11:53
plenty of good suggestions, but not once
11:55
has it surfaced a blind spot I'd been
11:57
operating with for months since I had to
12:00
find the question myself before it could
12:02
help answer it. In hardware, those
12:04
unasked questions get expensive fast,
12:07
like the certification you never knew
12:10
applied to your product or the
12:11
manufacturing constraint you never
12:13
thought to raise with your factory. The
12:15
sneakiest one is the design where every
12:18
individual answer was correct and the
12:20
whole thing still falls apart the moment
12:22
the subsystems have to work together. AI
12:25
answers the prompt in front of it. While
12:27
an experienced reviewer looks at your
12:29
entire project and says, "Wait, this
12:32
probably won't work." So, when you hit
12:34
one of those expensive decisions, the
12:36
ones where you don't know what you don't
12:38
know, you have a few options. You can
12:40
work through it yourself, which is fine
12:43
when you know what to look for, or you
12:45
can hire an independent engineer on an
12:48
hourly basis who has actually taken a
12:50
product through manufacturing and
12:52
certification. Or you can get it in
12:54
front of people who have already made
12:56
the mistake that you're about to make.
12:58
If you want that kind of help with your
13:00
own product, you can get it from me and
13:02
my team of engineers and product experts
13:04
inside my hardware academy. And if you
13:07
found this video helpful, then this
13:08
video right here on the technologies
13:10
that you should avoid in your product is
13:12
a good one to watch next.

In this video, John Teel outlines six critical hardware design decisions where AI should not be trusted because the cost of a mistake is high. While AI is useful for explanations and coding, it lacks the context and accountability needed for these areas:
Selecting components for your product (02:37-04:38): AI often suggests hobbyist-grade components rather than production-grade parts. You must consider long-term sourcing, life cycles, and certification requirements.
Verifying if a circuit works (04:38-06:08): AI can provide polished, confident, yet incorrect designs. Always simulate or breadboard circuits before committing to a final layout.
Determining if a design is ready for production (06:08-07:39): AI-driven design tools often miss subtle errors because they cannot identify what they failed to check. A clean report from an AI does not mean your board is actually ready.
Judging if a part is truly "cheaper" (07:39-09:49): Choosing cheaper components can lead to hidden costs like failed certifications or increased assembly complexity. AI lacks the context of your specific margins and business goals.
Validating a product idea (09:49-11:15): AI is inherently agreeable and will likely tell you your idea is good. True market validation only comes from actual sales or paying customers.
Identifying the right questions to ask (11:15-13:00): AI only answers the prompt provided. It cannot surface blind spots or unasked questions regarding manufacturing constraints or system-level integration issues.

How to use AI effectively for hardware?
Where to find professional design review checklists?
Summarize the video

In this video, John Teel, a former microchip design engineer, explains six critical hardware design decisions where you should never trust AI. He emphasizes that while AI is excellent for coding or summarizing documentation, it lacks the context and accountability necessary for high-stakes hardware development, where errors can be incredibly expensive (0:00-01:38).
The six decisions to avoid trusting AI with include:
Selecting components: AI often suggests hobbyist-grade modules instead of production-ready parts (02:37-04:38).
Verifying circuit functionality: AI may present a polished, incorrect circuit design that fails in real-world application (04:38-06:08).
Confirming if a design is ready: AI tools lack the ability to know what they missed during a review, giving a false sense of security (06:08-07:39).
Judging cost-effectiveness: AI ignores specific business constraints like volume and certification requirements, potentially causing massive hidden costs (07:39-09:49).
Validating product ideas: AI is inherently agreeable and will likely offer false validation rather than critical, market-tested feedback (09:49-11:15).
Identifying the right questions: AI cannot surface blind spots or system-level integration problems you haven't explicitly asked about (11:15-13:00).

Where can I find design checklists?
What are production-grade components?

As discussed in the video (2:37-4:38), production-grade components are those specifically chosen and qualified for mass manufacturing and commercial deployment, distinguishing them from "hobbyist-grade" parts often found in hobbyist modules or breadboard prototypes.
Key characteristics of production-grade components include:
Reliability and Standards: These parts are often qualified to specific industry standards (e.g., AEC-Q100 for automotive or MIL-SPEC for defense) to ensure they can withstand harsh operating environments and maintain consistent performance over long lifecycles.
Supply Chain Stability: A critical aspect of production is whether the component can be sourced in high volumes (e.g., 10,000+ units) consistently over several years. Manufacturers must ensure the part won't go End-of-Life (EOL) shortly after launch.
Manufacturing Optimization: They are designed to be efficiently assembled using automated Pick and Place machines, unlike some hobbyist modules that may have awkward footprints or lack standard industrial packaging.
Certification Readiness: Many production-ready parts are pre-certified (e.g., wireless modules with FCC/CE certifications), which can significantly reduce the time and cost of required regulatory testing for your final product.

Hardware Design for Hobby Projects Versus Commercial Applications

altium.com
 
Professional Electronic Components: Guide to Specs & Selection Blog
lcsc.com
 High Reliability Electronic Components
electronics-sourcing.com
 Industrial Grade Automotive Grade and Consumer Grade Electronic ...
perceptive-ic.com

What is the FCC certification process?
Why choose pre-certified modules?
What are common hardware certification pitfalls?

Hardware certification is a complex and often overlooked stage of product development. Failing these tests can result in costly project delays and redesigns. Here are some of the most common pitfalls hardware teams encounter:
Common Certification Pitfalls:
Misunderstanding Compliance Requirements: A major mistake is assuming CE and FCC standards are interchangeable or optional. They have entirely different testing scopes, processes, and regulatory bodies (07:39-08:26).
Ignoring EMC at the Design Stage: Electromagnetic Compatibility (EMC) issues are a leading cause of failure. Designing an enclosure that leaks emissions or placing RF modules too close to metal components often results in immediate test failure.
Underestimating Timelines and Costs: Many creators severely underestimate the time required for certification, which can be 3x longer than anticipated. Additionally, saving on component costs by using uncertified parts often leads to much higher expenses when full testing becomes mandatory later.
Documentation and Material Issues: Failing to provide updated compliance documentation or using non-compliant materials can cause a product to fail certification checks before it even hits the testing lab.
Poor System-Level Integration: Even if individual components (like a pre-certified module) are compliant, the final assembled product must still pass certification. Improper grounding, poor antenna tuning, or complex interactions between subsystems can cause a finished device to fail compliance despite using "certified" parts (11:15-12:04).

CE vs FCC Certification: A Practical Guide for Electronics Exporters ...

alibaba.com
 
Why Smart Devices Fail CE RED or FCC Testing & How to Prevent It
sofeast.com
 Top 10 Common Reasons for CE/FCC Certification Failures in ...
intechhouse.com
 Top 10 Reasons Electronics Products Fail Compliance - ECQA
ecqa.com
 Why 90% of Hardware Startups Fail? | by Jacky L - Medium
medium.com

How to prepare for EMC testing early?
Why does antenna tuning affect compliance?
Does my product need FCC certification?
How to find reliable component suppliers?

Finding reliable electronic component suppliers is a critical step in transitioning from prototype to mass production. As discussed in the video (2:37-4:38), you must prioritize production-grade components and vendors who can support your manufacturing scale.
Strategies for Finding and Vetting Suppliers

Prioritize Authorized Distributors: Start by sourcing from established, authorized distributors (like DigiKey, Mouser, or Arrow). These sources guarantee component authenticity and provide full product traceability, which is essential to avoid counterfeit or substandard parts.
Evaluate Supplier Credentials: When considering a new supplier, look for industry-standard certifications (e.g., ISO 9001). Verify their quality management processes and their ability to handle documentation, which is vital for regulatory compliance.
Assess Supply Chain Stability: Beyond technical specs, ask if the manufacturer will continue producing the part for your target product lifecycle (e.g., 5+ years). Ensure they can meet your volume requirements consistently without significant lead-time fluctuations.
Conduct Proactive Vetting: If you must use independent distributors or brokers, insist on testing components at certified labs (ideally ISO 17025 accredited) to verify performance and authenticity before committing to a production order.
Build Relationships: Treat procurement as a partnership rather than a one-time transaction. A reliable supplier should offer technical support and visibility into potential supply chain risks, such as End-of-Life (EOL) notifications or long-term availability issues.
Remember, your goal is to mitigate risks that could lead to costly production stops or failed certifications. Always perform a risk assessment on your Bill of Materials (BOM) to identify critical components that require primary and secondary, pre-vetted sources.

masline.com

masline.com
 9 Steps to Find a Reliable Electronic Component Distributor
fusionww.com
 vyrian.com
vyrian.com

What are common component sourcing mistakes?
How to manage long lead times?
When should I use secondary suppliers?
AI hardware design risks

While AI is a powerful assistant for coding or summarizing documentation, John Teel argues it poses significant risks in hardware design because it lacks the context and accountability required for high-stakes projects (0:00-01:38). Key risks include:
Suboptimal Component Selection: AI often suggests hobbyist-grade parts instead of production-grade components, ignoring critical factors like long-term availability, sourcing, and certification requirements (02:37-04:38).
Unverified Circuit Designs: AI may provide confident, polished-looking circuits that fail in reality. It cannot test or simulate its own logic, leading to costly errors if implemented without verification (04:38-06:08).
False Sense of Readiness: AI-driven design reviews often miss hidden flaws because they cannot distinguish between what they checked and what they skipped, resulting in potentially faulty production-ready designs (06:08-07:39).
Hidden Business Costs: AI lacks visibility into your specific margins, volumes, and target markets, which can lead to decisions (like choosing the wrong chip) that drastically increase expenses during certification or assembly (07:39-09:49).
Inability to Identify Blind Spots: AI only answers the specific prompts it is given. It cannot anticipate or surface system-level integration problems or regulatory constraints you haven't explicitly asked about (11:15-13:00).

What are production-grade components?
How to avoid certification pitfalls?
How do I validate a hardware idea?

The speaker advises that you should never trust AI to validate if a product idea is good, as AI is biased toward being overly agreeable. Real validation only occurs when someone actually hands you money for the product or when a store places a reorder because the initial batch sold through (09:51-10:43). To use AI properly, you should flip the prompt to ask it to argue against you by listing every reason the product might fail and identifying what conditions are required for success, then verify those findings with actual customers (10:52-11:10).

What defines a successful product launch?
How to find your first paying customer?
Ways to test hardware prototypes affordably?
Tips for finding reliable suppliers?

The speaker explains that sourcing for production goes beyond simple technical specs and requires evaluating the long-term viability of your supply chain. You should consider the following critical criteria for selecting and vetting parts (03:24-03:43):
Lifecycle Management: Determine if the manufacturer will continue producing the component for the next five years to avoid premature obsolescence.
Scalability: Verify that you can reliably source high volumes, such as 10,000 units, for future production quarters.
Certification Readiness: Look for pre-certified versions of components to potentially eliminate entire rounds of expensive regulatory testing for your final product.
The speaker emphasizes that component choice is never just a technical question; it is a sourcing, cost, and certification decision that must be made based on your specific volumes and margins rather than hobbyist tutorials (03:43-04:00).

How to manage component lifecycle risks?
Explain the costs of certification testing.
Why avoid hobbyist modules for production?

When transitioning from a prototype to mass manufacturing, avoiding hobbyist-grade components is crucial for ensuring the reliability, scalability, and certification compliance of your final product. While hobbyist components are excellent for rapid experimentation and learning, they lack the rigorous standards required for commercial-grade electronics.
Why Production-Grade Components are Essential

Reliability and Testing: Commercial products often require high Mean Time Between Failure (MTBF) ratings to ensure they function correctly in diverse, real-world environments over several years. Production-grade components undergo extensive quality testing that hobbyist modules often skip.
Supply Chain Stability: A critical difference is the product lifecycle. Manufacturers of production-grade parts provide long-term availability guarantees. In contrast, hobbyist modules frequently go End-of-Life (EOL) or become unavailable without notice, which can bring a mass-production line to a complete halt.
Certification Readiness: To sell electronics globally, products must meet strict regulatory standards (such as FCC or CE). Hobbyist modules are rarely pre-certified for integration into other products. Using them often necessitates costly, time-consuming re-certification for the entire system.
Manufacturing Optimization: Production-grade parts are designed for automated Pick and Place assembly processes. Hobbyist modules, often designed for manual breadboarding or hand-soldering, can be difficult or impossible to integrate efficiently into high-volume assembly lines.
Risk Mitigation: The
