Cadburies/SisuAssistant/MarineBoard/Documentation/PCBWay delivery 2026-08-15/Enclosure Design File (superseded)/Enclosure Assembly Instructions.docx

Enclosure Assembly Instructions

1. First, use four M3*5 round head screws to fix the PCB onto the enclosure. Then assemble the waterproof connectors on the enclosure and connect the wires between the PCB and the connectors.

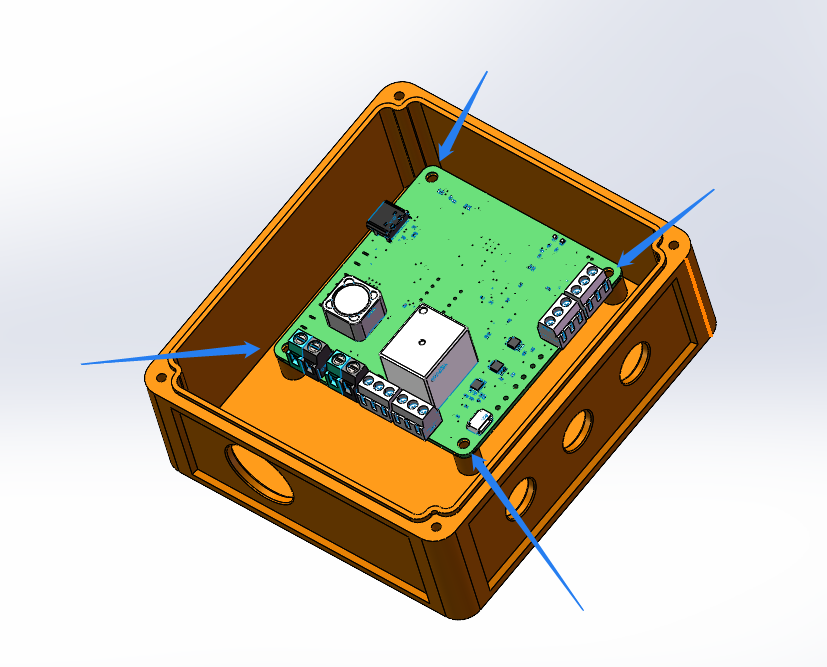
[picture p58: figure]

2. Then use three M3*10 self-tapping screws to secure the upper cover.

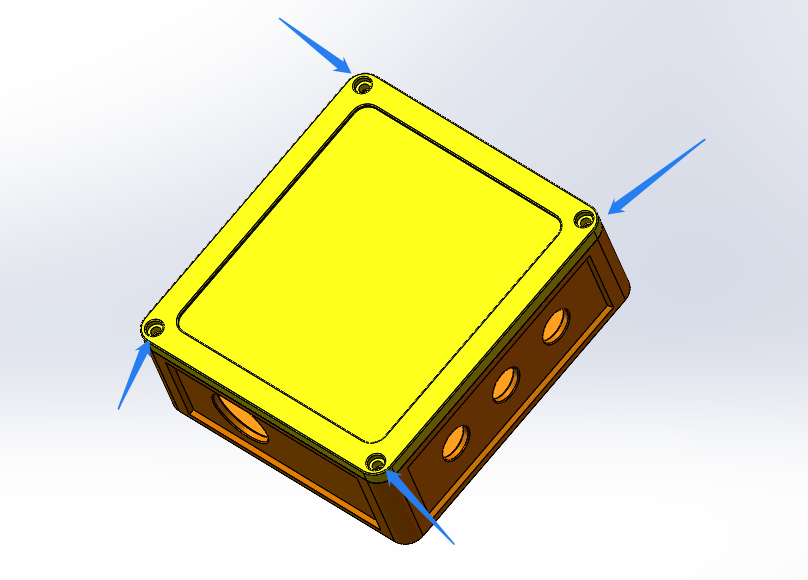
[picture p59: figure]
