Cadburies/SisuAssistant/MarineBoard/Documentation/Schematics/TEST POINTS.png

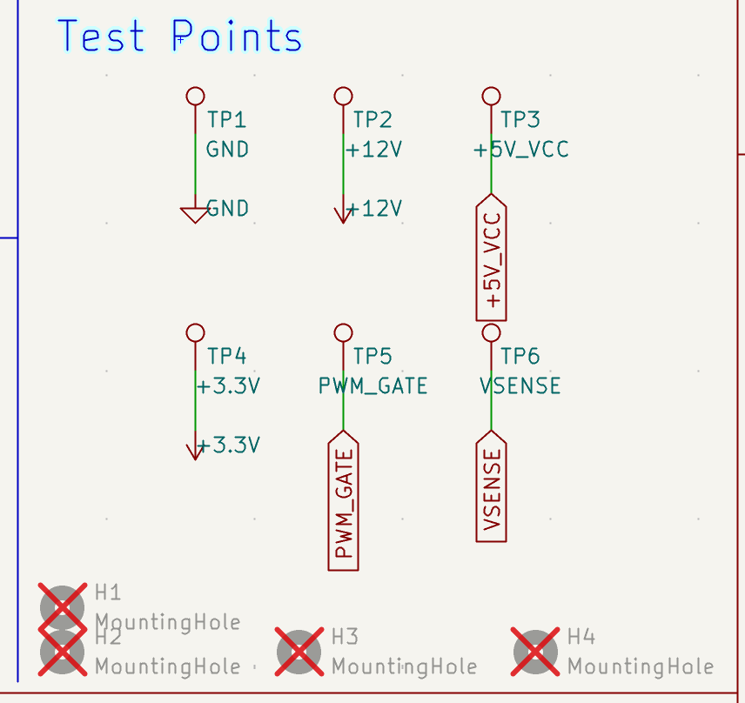
MarineBoard/Documentation/Schematics/TEST POINTS.png
