Cadburies/SisuAssistant/.ai_context/feature_map/nav/hazards/cables.md

---
title: Sisu Nav › Submarine cables
id: nav/hazards/cables
kind: layer
tags: hazards submarine cables telegeography anchoring landing points
status: live
script: cables.sh
order: 86
---
Submarine telecom cables and landing points (TeleGeography) — an anchoring planning aid.

- **Reach:** Sisu Nav → **Layers** (top of map) → **Submarine cables**
- **Action:** toggle; click a cable or landing point for its name.
- **Needs:** on the boat's Sisu Wi-Fi/LAN with the F8 running; internet for forecast/online layers
- **Expect:** Coloured cable lines; dim dots = planned landings; fetched once per session.
- **Source:** `sisu-nav/USER_GUIDE.md` (`## Hazards`) · `sisu-nav/api/hazards/` · `sisu-nav/web/src/plugins/hazards/`
