Cadburies/SisuAssistant/MarineBoard/Documentation/PCBWay delivery 2026-08-15/PCB Manufacturing Files/ASM_pcbway design/MarineBoard-B_Mask.pdf

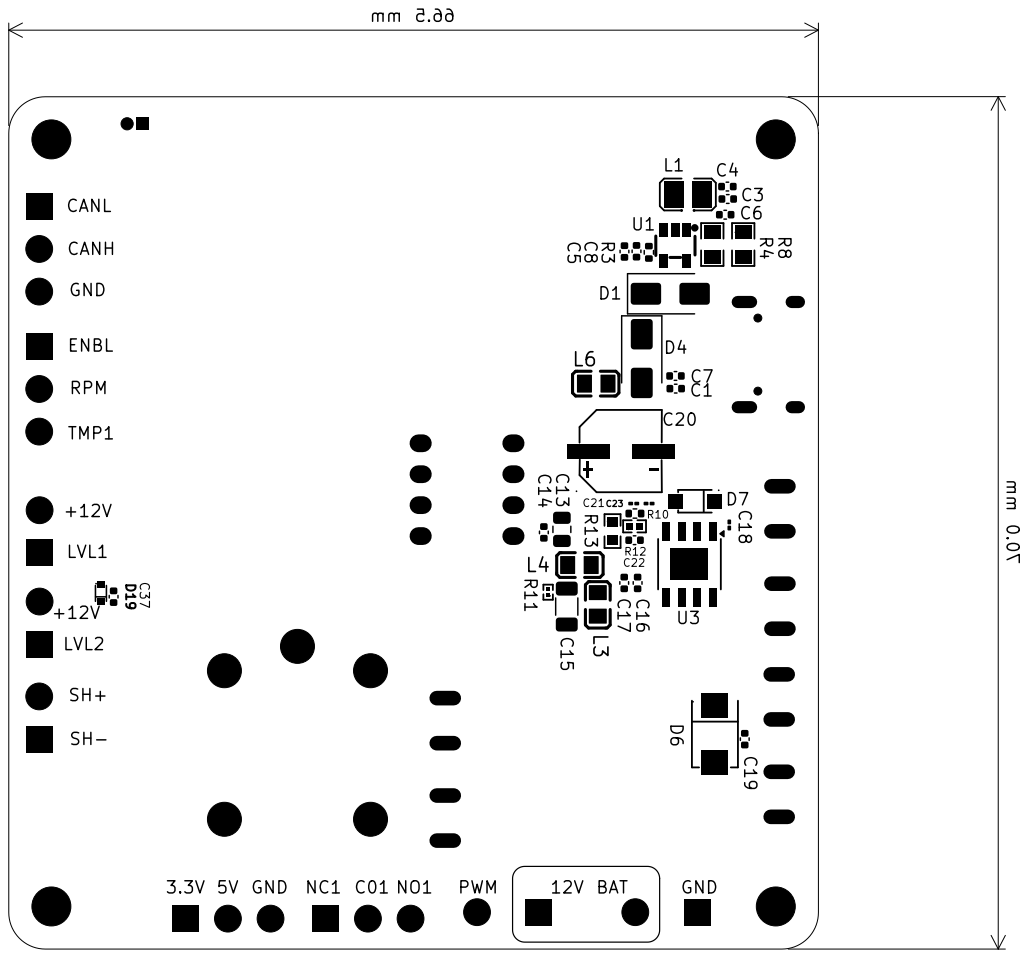
[picture p61: page 1]
