Cadburies/SisuAssistant/MarineBoard/Documentation/PCBWay delivery 2026-08-15/PCB Manufacturing Files/ASM_pcbway design/MarineBoard-F_Mask.pdf

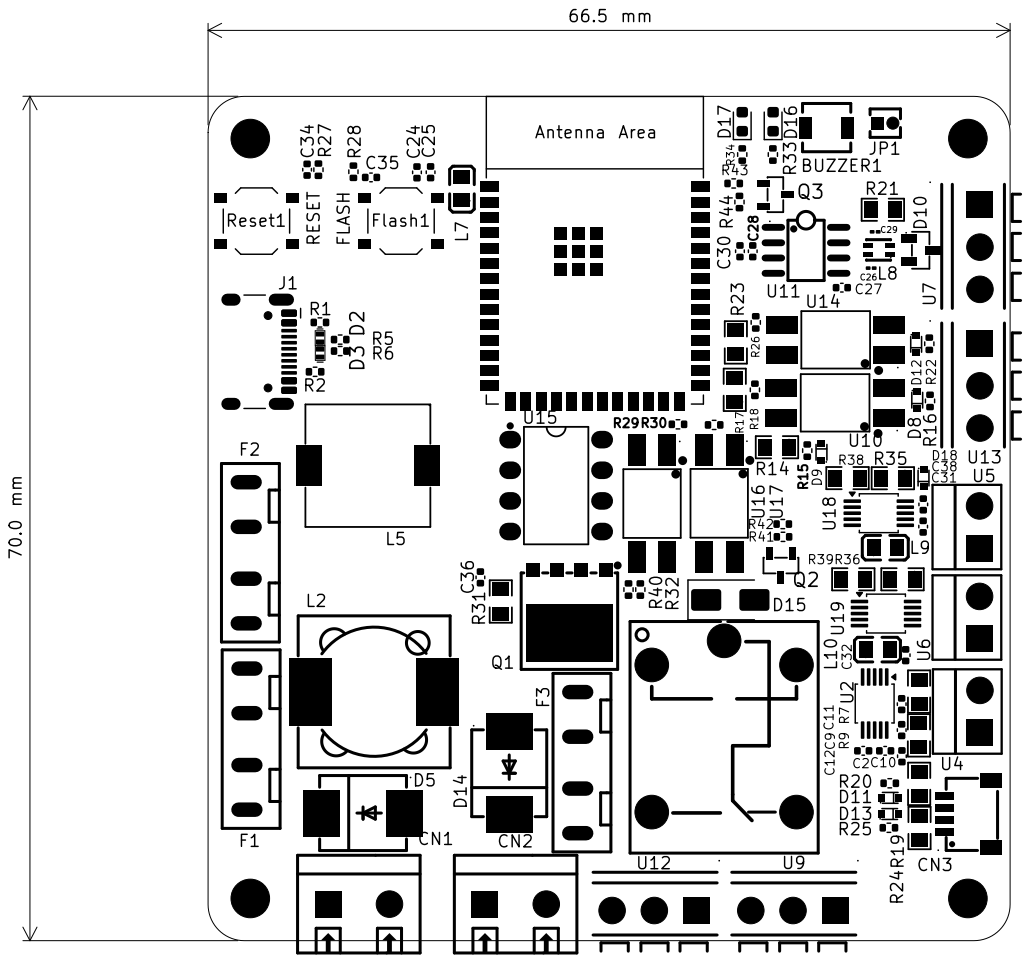
[picture p62: page 1]
