Cadburies/SisuAssistant/(list of files, drawings)

Other design files:
MarineBoard/sch_data.json
