Cadburies/SisuAssistant/(commit log)

2026-08-07 Initial private import: Sisu marine automation stack
    Home Assistant, ESPHome (Marine Board alts/levels, LilyGo freezer),
    Signal K/MQTT config, Marine Board PCB, agent context, and ops scripts.
    Secrets scrubbed (freezer/archive !secret); backlog lives as GitHub Issues;
    CLAUDE.md documents parallel-agent claim/Touches protocol.
    [MarineBoard-BOM.csv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]
2026-08-07 Point INDEX NEXT at GitHub issue numbers
    After migrating outstanding backlog to issues #1–#19, NEXT lists
    concrete issue IDs for F8, lab reflash, board commission, and alt firmware.
2026-08-07 Add NMEA gateway bridge: YDWG primary, DataHub failover
    HA polls TCP NMEA 0183 (YDWG :1456, DataHub :11102), prefers YDWG when
    online, parses RMC/VTG/MWV/DPT/HDG for helm sensors. Signal K settings
    list both providers for F8. Secrets template documents gateway keys/ports.
2026-08-07 Remove migrated http: block from configuration.yaml
    HA now owns HTTP settings in Settings → System → Network; the YAML
    http: server_port entry is ignored and will error from 2027.2.0.
2026-08-09 Rewrite alternator control loop: cascaded voltage/current PI (#22, #13)
    Replaces the single 1 Hz PID (current+voltage+temperature in one loop,
    integral reset on every limiter) with a cascaded architecture matching
    how commercial regulators (Wakespeed WS500, Balmar) are structured:
    - Outer voltage PI (absorption/float target -> requested current) feeds
    an inner current PI (requested current -> field PWM). Each loop has
    conditional-integration + back-calculation anti-windup.
    - Continuous thermal current-ceiling derate (Tsp-5C -> 0A at 125C hard
    ceiling) instead of a binary hysteresis step.
    - Stale-sensor detection (frozen last-good value now fails safe, not
    just NaN) and a negative-cu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
    [marine_alternator.yaml]
2026-08-09 Add lab HIL test rig: real control code + injected values on one T8-S3 (#23)
    New device homeassistant/esphome/test_rig.yaml, separate from
    bench_alts_sim.yaml (which simulates a fake plant with scripted physics,
    not the real controller). This rig runs the ACTUAL control logic against
    manually-injected static values so you can watch it react in real time:
    set house_v low with low current and see field duty rise, set house_v to
    14.3V and see it back off, flip a fail switch and watch the real
    stale-sensor fail-safe trip a few seconds later.
    - Port + Starboard alternator: the exact cascaded PI + charge state
    machine from packages/marine_alternator.yaml, generated via a scripted
    find/replace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
2026-08-09 Codify Mac-as-source-of-truth rule; temporary Mosquitto+SK on Green (#24)
    - OPS.md: explicit rule to always edit/verify on Mac first, push after
    (Mac clone = backup if Green/F8 unreachable)
    - OPS.md §7: interim exception replacing the old blanket "do not install
    on Green" — Mosquitto + Signal K now running there for dashboard/SK
    design work (#24), ahead of the F8 production stack (#6); documents the
    live-probed mechanism (HAOS has no docker-compose on host; Supervisor
    Apps for Mosquitto/Grafana/InfluxDB, plain docker run for Signal K) and
    resource budget
    - docker-compose.yml: header note clarifying it's the F8/legacy target
    shape, not what's deployed on Green today
    Co-Autho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
2026-08-09 Move interim Mosquitto/Signal K stack from Green to Mac (#24)
    Green stays HA + ESPHome only, no exceptions — reverted the same-day
    Supervisor App + docker run install there (torn down, RAM/disk back to
    baseline). Interim stack now runs on this Mac via Docker Desktop:
    - homeassistant/docker-compose.mac.yml (new): mosquitto + signalk,
    published ports instead of network_mode: host (Docker Desktop doesn't
    do Linux host networking). signalk uses network_mode: service:mosquitto
    so the committed signalk-mqtt-sensors.json (mqtt://127.0.0.1:1883, a
    hotspot file) needed no edits.
    - OPS.md §7: rewritten for the Mac-hosted interim, mechanism/gotcha notes,
    reachable at the Mac's LAN IP for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
2026-08-09 Add Grafana/InfluxDB/MQTT Explorer to Mac stack; fix odroid paths (#24)
    - docker-compose.mac.yml: full 5-module interim stack (mosquitto, signalk,
    influxdb, grafana, mqtt-explorer), all live-verified on the Mac —
    ports 1883/3000/8086/3001/4000. KIP confirmed bundled in signalk-server
    (no separate container).
    - docker-compose.yml (F8 target): dropped homeassistant/esphome services
    (never belonged here — Green runs those permanently, no docker-compose
    involved on that host per OPS.md §7); added influxdb/grafana to match
    NETWORK.md §8.5's documented F8 stack; replaced hardcoded
    /home/odroid/homeassistant/... paths (leftover from a pre-HA-Green/F8
    single-SBC layout) with pa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
2026-08-09 Redesign test rig dashboard: one section per device, not scattered lists
    Old layout split each device into separate stacked inject/readback
    sections and dumped all 10 setpoints into one long entities card --
    forced scrolling up/down to correlate what you set with what happened.
    New layout: one grid section per device holding several small
    purpose-grouped cards (Status, Field Duty gauge, Inject, Fail sensors,
    Setpoints, BMS mirror setpoints) that flow side by side instead of
    stacking. Card order is priority-ordered: what's happening now -> the
    gauge -> what you actively move -> what you're testing -> what you
    rarely touch. Setpoints split into primary (4) vs BMS-mirror (6) so
    neither card is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
2026-08-09 Bridge live NMEA (DataHub) into Mac-hosted Signal K via host relay (R34)
    Researched Docker Desktop for Mac's inability to route container traffic
    into 192.168.10.x: macvlan unsupported entirely, host networking beta
    confirmed no help. Working fix: scripts/mac-nmea-relay.sh, a host-side
    socat relay (auto-restarting) forwarding DataHub/YDWG onto local ports
    via host.docker.internal, which Docker Desktop always exposes to
    containers. signalk/settings.json's two pipedProviders now point at
    host.docker.internal instead of the real 192.168.10.x IPs to use it.
    Live-confirmed: position/wind/depth/AIS flowing into Signal K within
    seconds of the relay starting. YDWG still unreachable (device off, not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
2026-08-09 Tighten ENBL/ATC wiring documentation (#12)
    INSTALLATION.md §6.3.5 already covered engine-run + BMS charge-allow
    into ENBL, but as a soft 'typically' recommendation rather than an
    explicit wiring recipe. Made it concrete: AND-gate both conditions
    before the ENBL opto pin (relay coil in series or a 2-input AND
    module), not in software -- there is no second interlock input in
    firmware today, so the hardware AND-gate is what actually keeps the
    vessel safe, not a status-text distinction. Cross-referenced R30 and
    noted what changes once a second input exists on a future board rev.
    No firmware/behavior change -- documentation only.
2026-08-09 Resolve root signalk/ vs homeassistant/signalk/ trees (#4)
    - Removed the 3 tracked files under root signalk/ (.npmrc, package.json,
    plugin-config-data/resources-provider.json) — legacy/incomplete: no
    settings.json (not a functional SK config, just leftover npm installs),
    not mounted by any compose file, not referenced by docs.
    homeassistant/signalk/ is the one authoritative tree (already stated in
    .ai_context/INDEX.md; now actually true on disk).
    - Guarded /signalk/ in .gitignore so it can't be re-tracked by accident.
    Local leftover files there (node_modules, security.json, etc.) are
    untracked/harmless, left alone rather than deleted unprompted.
    - Fixed data_flow.md's danglin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
2026-08-09 Add low-side house V band indicator to Alternators dashboard (#10)
    Stock HA gauge severity is high-side only, so the existing Port/Stbd
    house-voltage gauges can show orange/red approaching 14.3/14.4V but
    never the low-side orange <=12.0V / red <=11.0V policy already
    documented in docs/ALTERNATOR_LIMITS.md. Added a small tile per side,
    driven by the same custom:config-template-card resource the gauges
    already use for dynamic severity (no new dependency) -- this time
    templating the tile's color instead of gauge severity thresholds.
    Replaced the static markdown note on Port with the real indicator;
    added the matching one to Starboard (which didn't have the note).
    No entity/limit changes -- val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
2026-08-09 Wire HA MQTT integration to interim Mac broker; land #4 leftovers (#20)
    Previous #4 commit (90ba6bf) dropped the .gitignore /signalk/ guard and
    the data_flow.md path fix from staging (an earlier git add failed
    atomically on a bad pathspec, and the retry did not re-include them) --
    landing them now, content was already correct in the working tree.
    MQTT integration (#20): configured via HA config-flow API against the
    Mac interim Mosquitto (192.168.0.151:1883), not the UI. Live-confirmed
    end-to-end -- mqtt.publish delivers to the broker, triggering
    automation.sisu_alternator_starboard_mqtt_signal_k actually publishes
    signalk/electrical/alternators/starboard. Resolves R26 (deleted).
    Live HA con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
2026-08-09 Latch hard alternator faults until ENBL cycle or explicit clear (#14)
    Today a hard trip (stale/invalid sensor, current/temp/voltage over the
    hard ceiling) zeroed field for the tripping tick, then silently resumed
    normal control the moment the underlying reading looked okay again --
    e.g. current oscillating around 250 A would just keep re-enabling the
    field on its own every ~250ms. Added a proper latch:
    - New `fault_latched` global, set (with a trip counter and the original
    fault-detail message stashed) the first time either hard-fault branch
    trips. While latched, field stays at 0 regardless of what the sensors
    say, checked before the sensor/hard-limit branches even run.
    - Clears only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
    [marine_alternator.yaml]
2026-08-09 Faster overcurrent trip path: bypass moving-average settling lag (#15)
    The control tick is already 250ms (post-#22), so the hard-safety check
    already re-evaluates well under 1s worst case -- but alt_i's filter
    chain stacks a 5-sample median with a 5-sample moving average, and the
    moving average alone takes up to ~1.25s to fully settle after a genuine
    step change. A real sustained overcurrent event could sit unflagged for
    several ticks while the average caught up.
    Captured the post-median, pre-moving-average value into a new
    `alt_i_fast` global via a lambda filter inserted between the two
    existing filters (no filters removed, no thresholds changed). The
    hard-trip check now compares BOTH the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
2026-08-09 Document: alternator has no internal rectifier, no OEM tach terminal (#13)
    Fixed hardware fact for this install, captured so it doesn't get
    re-asked: the Leece-Neville 320A/12V alternator is a bare 3-phase
    machine -- only phase (stator) outputs, field control, and ground are
    brought out. The alternator's own 12V output terminal exists but is
    NOT connected. Rectification is done entirely by an external 1000A-peak
    bridge rectifier wired to the three phase leads, not anything internal
    to the alternator.
    Consequence for issue #13 (RPM/engine-run field gate): there is no
    manufacturer-provided low-level tach/R/stator terminal on this unit.
    Any RPM sense tap is necessarily a raw, high-current-capa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
2026-08-09 RPM tap: concrete DC-ripple-coupling circuit for U10 (issue #13)
    Operator confirmed the DC bus (post external bridge) is the same node
    the 5x12V/300A Victron LiFePO4 house bank connects to -- battery-
    buffered under normal running, but the fault case that matters is the
    battery disconnecting while the field is still excited (R30), which
    the battery can't clamp at the exact moment it happens.
    Replaced the general 'tap ripple, recommended approach' bullet with a
    concrete circuit: AC-coupling cap (1uF, blocks DC entirely so the opto
    never sees a sustained 13-14.4V) + bias resistor (defines DC reference)
    + series resistor (2.2k, primary current-limiting element, LED
    self-clamps its own forward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
2026-08-09 RPM tap: confirm physical tap point is SH+, not a bare wire (issue #13)
    Operator asked directly whether RPM (IO_PROTECTION.png) just wires to
    SH+ (12V BATTERY MONITOR.png / U2 INA226 shunt circuit). Answer is
    nuanced enough to document precisely: yes, SH+ is the right physical
    node (same house DC bus the INA226 already senses), but it's not a
    bare-wire connection -- C1 (the new AC-coupling cap) goes between SH+
    and the RPM net. Skipping C1 gives a continuously DC-biased, saturated
    LED with no pulses at all, not a fault-current problem -- just a
    non-functional tachometer. Also noted explicitly not to repurpose the
    INA226/U2 itself for this (its averaging + analog filtering exist
    specifically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
2026-08-09 Enable signalk-mqtt-bridge for HA engine data consumption (#25)
    YDWG-02 back online (Corrosion-X + reseated connector) and Signal K now
    decodes full N2K engine telemetry for both engines via its $YD-wrapped
    NMEA0183 sentences (auto-unwrapped, no separate raw-N2K plugin needed):
    RPM, coolant temp, oil pressure, alternator V, fuel rate, engine hours,
    load %, boost pressure, per-engine starter battery voltage, and ~24
    alarm/fault notification flags per engine.
    Enabled signalk-mqtt-bridge, pointed at the interim Mac Mosquitto
    (same broker HA already uses per #20) instead of the stale
    homeassistant.local default. Live-verified: mosquitto_sub against the
    plugin keepalive protocol receives real pr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
2026-08-09 Engine dashboard cards: Port + Starboard side by side via Signal K (#25)
    Claude2 got YDWG-02 back online and wired both Yanmars' full N2K
    telemetry into Signal K (propulsion.{port,starboard}.*, per-engine
    starter battery, ~24 alarm flags each) and handed the HA-side build to
    this session via #25 + a persistent_notification.
    Tried the enabled signalk-mqtt-bridge plugin first -- it publishes in a
    Victron-VenusOS-style N/<id>/... + keepalive protocol that didn't yield
    propulsion data under live test (subscribed + sent the documented
    keepalive, only got the plugin's own heartbeat topics back). Went with
    Signal K's REST API instead, which works cleanly with the existing
    SignalKUser/SignalKPwd cr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
2026-08-09 RPM tap patch: verify real sourced parts against spec (#13, #26)
    Operator found actual Amazon parts. Checked each against the design:
    - P6KE6.8CA 600W DO-15 -- exact match for D_new.
    - 1.2k 2W 1% metal film -- exact match for R_patch, exceeds the >=1W
    requirement.
    - 68k 2W 1% metal film (from a multi-value assortment) -- within the
    47-100k range for R_bias.
    - 1uF 50V electrolytic -- NOT what was specified (film/ceramic), but
    electrically workable: DC bias across it is ~13-14V with SH+ on the
    positive side in steady state (R_bias pulls the far side to ~0V),
    ripple amplitude far too small to swing it toward reverse. Flagged
    as polarity-critical for a hand-bodge: + lead to SH+, - le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
2026-08-09 RPM tap patch: swap C1 to film cap, all 4 parts now confirmed (#13, #26)
    Operator found a proper 1uF 100V metallized polyester film capacitor
    (CL21 series) to replace the electrolytic flagged in the previous
    commit. Exact type match (film, non-polarized -- removes the
    orientation-risk caveat entirely), correct value, more voltage
    headroom than required. All four bodge parts now confirmed sourced
    with no substitutions needed: P6KE6.8CA TVS, 1.2k/68k metal film
    resistors, 1uF/100V film cap.
2026-08-09 Fix engine sensor entity_id mismatch: signalk -> signal_k (#25)
    Root cause of "engine tab shows but no data": the command_line sensor
    named "Signal K Engines JSON" slugifies to entity_id
    sensor.signal_k_engines_json (HA inserts an underscore at the K word
    boundary) -- all 44 state_attr() references across the 20 field
    sensors + 2 alarm binary_sensors were written against
    sensor.signalk_engines_json (no underscore), which never existed.
    The command_line sensor itself was working fine the whole time
    (state: online) -- every downstream sensor was just pointing at a
    name that didn't exist, hence "unavailable" across the board.
    Confirmed via HA's own REST API (GET /api/states, /api/states/<id>)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
2026-08-09 HA Core restart is safe/low-risk here -- clarify in the rules
    User clarification: no HA automation is currently safety-critical.
    Alternator control, hard cutoffs, the fault latch, and every other
    safety-relevant function run entirely locally on their own ESP32
    firmware, independent of HA's uptime -- a HA Green restart does not
    and must not affect them.
    This relaxes the caution added in the previous "HA Green deploy" rule
    (9d9ae16), which said to ask before restarting Core. That caution was
    overly conservative for this project: restarting HA briefly
    interrupts dashboards/history/automations, not vessel safety, so it
    should be a normal closing step, not something to defer or ask
    permission fo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
2026-08-09 Enforce secrets.yaml.example sync as a hard rule, not just policy
    Followers cloning this repo need to know exactly what each secret is and
    where to get/generate it, and the example must never silently drift from
    the real secrets.yaml as keys get added over time (signalk_host,
    GrafanaUser, ColorControlIP, etc. had already crept in undocumented in
    places).
    - secrets.yaml.example: every key now has a one-line comment on what it
    is and where to obtain/generate it (router UI, HA onboarding, ESPHome
    dashboard, openssl/python keygen one-liners, first-run setup wizards,
    device manuals) -- not just CHANGE_ME placeholders.
    - scripts/scan_secrets.sh: new check -- fails the commit if secrets.yaml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
2026-08-09 Wire Victron GX data into Power dashboard + new engine.yaml BMS section (#27)
    - Add python_scripts/victron_gx.py: direct MQTT poll of the GX device
    (192.168.10.32), independent of Signal K. Confirmed devices: BMV-702
    battery monitor (battery/256), MultiPlus 12/3000/120-50 (vebus/257),
    3x solar chargers (solarcharger/288,290,291 - Roof Fwd/Mid + Aft).
    Uses battery/256 (whole-bank shunt) as authoritative for battery
    current/voltage/SoC, not system/0/Dc/Battery, since the two don't
    reconcile (system/0 traces to the MultiPlus's own DC port via
    ActiveBatteryService=vebus/257, not the whole-bank net).
    - Add packages/victron_gx.yaml: command_line sensor polling the script
    every 30s,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
2026-08-10 Fix broken MarineBoard links repo-wide; freshen README/Specs; add self-heal rule (CLAUDE.md)
    - Fixed MarineBoardSpecs/ -> MarineBoard/ (the actual folder name) across
    README.md, Technical Specifications.md, NETWORK.md, INSTALLATION.md,
    .ai_context/safety.md -- 12 broken references, none of them resolved
    to a real path before this. Upgraded the important ones to real
    clickable markdown links (space URL-encoded) instead of bare backtick
    text, and added an explicit link to the MarineBoard/ folder itself
    (KiCad project) and MarineBoard/Documentation/ (schematic PNGs), not
    just the one Technical Specs.md file.
    - README.md: F8-interim-on-Mac note in the stack diagram; Secrets
    secti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
2026-08-10 Enforce at least 1 decimal on all battery/alternator voltage displays
    Victron and marine BMS conventions expect 14.3V, not 14V.
    - python_scripts/signalk_engines.py: port/starboard alternator voltage
    and starter battery voltage were the only two numeric fields in this
    file with no round() call (every sibling field already rounds) -
    add round(..., 1).
    - python_scripts/victron_gx.py: battery_voltage was raw MQTT float
    noise (e.g. 13.789999961853) - round to 2 decimals, matching the
    ESPHome house_v accuracy_decimals: 2 convention (0.01 V is the
    resolution BMS charge-stage thresholds are actually compared
    against). Also round battery_soc (1dp), battery_current (1dp),
    battery_powe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
2026-08-10 Add HIL test client + scenario suite for marine_alternator.yaml, run live (#28)
    - scripts/esphome_web_client.py: generic, dependency-free ESPHome
    web_server: REST client. Reusable against any ESPHome device on this
    project, not just the alternator rig. Protocol reverse-engineered from
    the device's own served JS (public docs describe a different, non-working
    URL shape for this firmware). Talks to the device directly, bypassing
    HA entirely -- see issue #29 (HA's entity registry for this device is
    known-incomplete; the device's own web_server is ground truth).
    - scripts/test_alternator_hil.py: 24-scenario suite (Port full run,
    Starboard 8-scenario confirmation subset) covering nor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
2026-08-10 Dedicate 2nd T8-S3 to bench_alts_sim; add WS2812 status LED (#7, #30)
    - Second physical LilyGo T8-S3 arrived; flashed with current
    bench_alts_sim.yaml (250A/14.4V/125C ceilings confirmed live via
    scripts/esphome_web_client.py) and dedicated to .49, permanently
    resolving R33 (bench_alts_sim.yaml/test_rig.yaml no longer share one
    board). test_rig.yaml @ .48 untouched throughout (identified via serial
    boot banner before flashing either board).
    - Both lab T8-S3 files now drive the onboard WS2812 (GPIO38) as a
    combined Port+Starboard status LED instead of leaving it floating/on:
    red blink = alarm/fault, green = charging, blue = topped up, off = idle.
    Code-only (internal: true, not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
2026-08-10 LED GPIO38->48 retry, SpectraIP secrets parity, #29 root cause (R36)
    - LED: GPIO38 (LilyGo T8-S3 per Zephyr docs / DevKitC-1 v1.1) didn't
    visibly respond on the actual hardware. Switched both lab T8-S3 files to
    GPIO48 (original ESP32-S3-DevKitC-1 RGB LED pin, matching this
    project's `board:` declaration) and reflashed both boards via OTA.
    Pending visual confirmation.
    - secrets.yaml.example: added SpectraIP (user added it live; parity was
    failing scan_secrets). Documentation-only today — spectra_ws.py still
    hardcodes the same 192.168.0.25 default, confirmed correct and live.
    - #29: found the real root cause (not the issue's original theory) via
    direct native-API query bypassin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
2026-08-10 LED pin: GPIO48 -> GPIO21 per actual LilyGo T8-S3 v1.2 hardware (#30)
    User identified exact hardware: LilyGo T8-S3 v1.2 (23/8/24). Per LilyGo's
    own T8-S3 GitHub repo, versions v1.3-v1.7 schematics place the onboard
    WS2812 on GPIO21 (v1.2 isn't separately listed but is presumably the same
    lineage). Both GPIO38 (Zephyr board docs / DevKitC-1 v1.1) and GPIO48
    (DevKitC-1 original) were tried and didn't respond. Reflashed both lab
    T8-S3 boards via OTA; pending visual confirmation.
2026-08-10 Revert T8-S3 status LED (#30) — hardware has no controllable LED
    Board photo (user-provided) confirms exact hardware: LilyGo T8_S3 V1.2
    (23/8/24). LilyGo's own pinout card for this revision doesn't label an
    LED/RGB pin anywhere, and a full visual scan of the component side found
    no WS2812-style package. There is a LiPo JST connector with a small
    diode-marked component next to it — almost certainly the charge-status
    LED (wired to the battery charge IC), unaffected by any of the three GPIO
    candidates tried (GPIO38, GPIO48, GPIO21).
    Reverted the light: component and status-driving lambda code from both
    bench_alts_sim.yaml and test_rig.yaml, reflashed both boards back to the
    LED-free build.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
2026-08-10 Fix watermaker template sensors stuck unavailable (#31)
    Root cause: 13 sensor.spectra_status_json-dependent entities in
    spectra_newport.yaml used plain state-templated availability:/state:
    blocks, which stopped reacting to the source's changes after HA startup
    (confirmed live and changing; survived template.reload, a forced
    homeassistant.update_entity re-poll, and a full Core restart before this
    fix). Rebuilt as a trigger-based template: block (trigger: platform:
    state + homeassistant: event: start), deployed + ha core check + Core
    restart.
    Second bug hit during verification: 3 of 13 (status/running/product_flow)
    landed on _2-suffixed entity_ids — same class as R36 (#29), a stale dead
    ent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
2026-08-10 Remove Test Rig dashboard (board removed); fix bench_alts_sim entity collisions
    Physical Test Rig T8-S3 removed by the user. Per their direction: kept the
    testing code (esphome/test_rig.yaml, scripts/esphome_web_client.py,
    scripts/test_alternator_hil.py, HIL_TEST_PROCEDURE.md,
    ALTERNATOR_HIL_RESULTS docs) and the HIL-found alternator-functionality
    finding tracked on #13 (RPM-gate interlock disarms on stale RPM sensor) —
    none of that references the removed hardware. Removed only the
    now-orphaned HA-side pieces:
    - homeassistant/dashboards/test_rig.yaml (deleted)
    - Its lovelace-test-rig registration in configuration.yaml
    - The live "Test Rig" ESPHome config entry + all 67 entities/device in H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
2026-08-10 NETWORK.md: correct T8-S3 board note (test rig physically removed)
2026-08-10 MarineBoard: update KiCad project + add EasyEDA library assets
    - Update PCB, schematic, project, and library-table files
    - Add EasyEDA symbol/footprint/3D-model assets (C0402, C1210, R2512, SMA)
    - Add new documentation images (ESP32, FSPI, RPM)
    [MarineBoard.kicad_pcb, MarineBoard.kicad_sch]
2026-08-10 Wire HA sensors → InfluxDB → Grafana trending (issue #24 follow-on)
    Adds the actual dashboard content #24 left open, not just the containers:
    - homeassistant/packages/trending_influxdb.yaml — HA `influxdb:` integration,
    curated entity_globs (alternators, engines, NMEA wind/nav, Victron GX
    battery+solar, tanks, watermaker). measurement_attr: entity_id set
    deliberately — HA defaults this to unit_of_measurement, which silently
    misfiles every unit-bearing sensor into a measurement named after its unit
    string ("A"/"V"/"W"/...) instead of grouping by entity; found by querying
    InfluxDB directly after config/restart (no error is ever logged). One
    InfluxDB measurement per entit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
2026-08-10 MarineBoard docs: flag J3 has no hardware I/O protection
    - J3 (FSPI/spare GPIO breakout) wires straight from ESP32-S3 silicon
    to the header with no series resistor, ESD/TVS clamp, or pull
    resistor, unlike base-product I/O (see IO PROTECTION.png). Note
    added to J3 section + Known limitations.
    - Clarify GPIO3 (J3 pin 18): per ESP32-S3-WROOM-2 datasheet §4.4 it
    has no internal pull and is only strapping-active if
    EFUSE_STRAP_JTAG_SEL is burnt (unburnt by default today). Recommend
    external ~10k pull on next revision rather than relying on that.
    - Add J3 pull-up guidance: internal weak pulls in firmware are
    sufficient for the other 15 J3 GPIOs (none are strapping pins).
    - Note new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
2026-08-10 influxdb: drop YAML connection keys, HA 2026.9 deprecates them
    HA repair warning hit live 2026-08-10: YAML-configured InfluxDB connections
    (api_version/host/port/ssl/token/organization/bucket) are removed in
    2026.9.0. HA auto-imported the existing YAML connection into a UI config
    entry on load (confirmed via .storage/core.config_entries — correct
    host/org/bucket/token carried over). trending_influxdb.yaml now only
    declares measurement_attr/max_retries/include/exclude, which HA's own
    notice says stay in YAML for now.
    Verified post-fix: config entry unchanged/correct, HA Green restarted,
    fresh InfluxDB writes still landing in the right per-entity measurements
    (sensor.victron_solar_power etc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
2026-08-10 Surface BMS/pack state on Alternators dashboard (#18)
    Adds a "BMS / Pack" card to the Overview view: BMS state, battery SoC,
    BMS alarm + alarm detail (sensor.victron_bms_state/battery_soc,
    binary_sensor.victron_bms_alarm, sensor.victron_bms_alarm_detail — all
    already live via packages/victron_gx.yaml, issue #27). Power.yaml already
    had a BMS entities card; alternators.yaml had none, so an operator
    watching alt gauges had no pack context without switching dashboards.
    Scoped to the surfacing half of #18's acceptance only — the "optional
    automation to force current SP down if BMS warns" is left for a follow-up
    since it's explicitly optional and a more invasive control-behavior change
    than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
2026-08-10 Fix stale-RPM silently disarming the engine-run field gate (#13, HIL finding #28)
    The RPM gate (field off when RPM <= rpm_gate_sp while enabled) already
    existed. HIL testing on the physical test rig found a real gap in its own
    freshness guard: once RPM data went stale (>RPM_TIMEOUT_MS with no fresh
    pulse_counter publish), the guard that used to gate the whole check made
    it evaluate false -- not because the engine was confirmed running again,
    but because the code could no longer tell either way. Measured on the
    rig: field jumped from 0% (correctly held off, RPM fresh + <= gate) to
    ~70% (fully resumed) purely from the data going stale, engine state
    unchanged.
    Fix: split the check into `rpm_st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
    [marine_alternator.yaml]
2026-08-11 Add NOAA tides, weather, air/water temp, depth to main Sisu board (#32)
    - python_scripts/tides_noaa.py — nearest NOAA CO-OPS harmonic-prediction
    station (haversine against a short USVI/BVI candidate list, live GPS
    from sensor.nmea_latitude/longitude with a home-position fallback),
    next high/low tide predictions. Free, no API key -- NOAA has real
    stations in USVI close enough to be useful for BVI waters (Lameshur
    Bay/St John, ~9nm from Sisu's position, confirmed live). 3h on-disk
    cache since predictions don't need per-minute freshness.
    - python_scripts/weather_openmeteo.py — marine sea-surface-temp fallback
    ONLY. Hourly weather forecast itself uses the native weather.forecas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
    [ui-lovelace.yaml]
2026-08-11 Fix #32 follow-ups: metric tide height, 24h tide time, real house bank, board layout
    Four user-requested fixes to what #32 (and the main board generally) shipped:
    1. Units audit -- Sisu is metric. Wind/boat speed were already knots,
    depth already meters, temps already Celsius (all correct). Tide
    height was the one gap: NOAA fetch used units=english (feet), switched
    to units=metric. Renamed next_high_ft/next_low_ft -> next_high_m/
    next_low_m throughout the pipeline.
    2. "House bank" showed 0V -- it was reading
    sensor.lab_bench_alts_sim_house_voltage_engine_port (the alternator
    sim's local sense point), which is `unavailable` whenever the sim
    isn't running. Added sensor.s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
    [ui-lovelace.yaml]
2026-08-11 Board layout fix + true wind speed / 6h max (issue #32 follow-up)
    - Merged the standalone "Tides" entities-list section into "Sea & sky" as
    tile cards -- the entities-list card sat much shorter than the tile
    grids on either side, leaving a visible empty gap on the main board.
    Tile cards flow evenly with the rest of the grid.
    - Added true wind speed: sensor.nmea_tws, parsed from MWV sentences with
    reference "T" (nmea_gateways.py already computed tws_kn internally,
    just wasn't exposed as an HA entity) -- confirmed live, boat's
    instruments do send true wind (~9-10kn).
    - Added sensor.true_wind_speed_max_6h via HA's built-in `statistics:`
    platform (state_characteristic: value_max, m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
    [ui-lovelace.yaml]
2026-08-12 Add LilyGo T-Camera dinghy security cam bring-up (#33) — deep_sleep blocked
    New hardware: LilyGo "T-Camera V1.6 20221107", confirmed via esptool +
    physical inspection to be ESP32-S3-WROOM-1 (no PSRAM), AXP2101 PMU,
    OV2640, AS312 PIR, 1000mAh LiPo. For dinghy theft/security monitoring,
    aft cockpit.
    Hit and resolved two conflicting pin-source docs before writing any
    config: LilyGo's own `T_CarmerV16.md` (matches this board's silkscreen
    name+date) describes classic-ESP32 pins and says the PIR pin can't wake
    from deep sleep -- but that doc's own repo ships an esphome yaml
    targeting `board: esp32dev` (classic ESP32), while esptool positively
    IDs this chip as S3 and the silkscreen shows S3-styl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
2026-08-12 Add dinghy camera card to main Sisu board (#33)
    Adopted "Sisu Dinghy Camera" into HA via the config-flow API (same
    pattern as the MQTT integration setup elsewhere in this project) --
    camera.aft_cockpit_sisu_dinghy_camera_dinghy_camera and
    binary_sensor...pir both confirmed live, pulled a real JPEG through
    HA's own camera_proxy endpoint end-to-end.
    New "Dinghy camera" section on the main board: picture-entity card +
    PIR tile. Entities are stable regardless of the still-unresolved
    deep_sleep crash (#33) -- whichever firmware ends up running, these
    entity_ids don't change.
    [ui-lovelace.yaml]
2026-08-12 Add anchor tension logging node (issue #34)
    - New homeassistant/esphome/anchortension.yaml: HX711 + spare LilyGo
    T8/T7, drafted ahead of load-cell hardware arrival. Firmware-side
    peak-hold sensor (catches sub-second snatch loads a throttled
    publish rate could miss) + an "Over 80% Capacity" binary sensor for
    an HA abort alarm during the staged engine-reverse test. GPIO pins
    and calibrate_linear values are explicit TODO placeholders, not
    real numbers, pending real hardware.
    - secrets.yaml / secrets.yaml.example: anchor_ota_password,
    anchor_api_encryption_key, esp_ip_anchor (192.168.10.46, reserved).
    - .ai_context/naming.md: new groundTackle domain (no existing domain
    fit for ro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
2026-08-12 Dinghy camera: mic, PIR/sound-triggered photo burst + audio clips (#33)
    Design (owner, 2026-08-12): drop deep_sleep (device now on continuous
    external power, not battery-autonomous -- see prior commit for why
    deep_sleep was abandoned). Always-on instead: watch PIR + mic sound
    level continuously; on either trigger, capture a burst of photos (HA
    side) and a ~5s audio clip (device side); otherwise idle_framerate gives
    a baseline snapshot every ~5s.
    Checked a repo the owner found (Xinyuan-LilyGO/T-Camera, literally named
    "T-Camera") in case it was a better-matching reference -- it's the SAME
    older/wrong hardware generation as the doc that already burned us once:
    XCLK=GPIO4 not 38, OLED I2C on 2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
2026-08-12 Dinghy camera: OLED status display + trigger counters (#33)
    - SSD1306 (0x3C, bus_a, same bus as AXP2101 -- both already confirmed
    present via i2c scan) shows: title, PIR/sound trigger counts, last
    trigger type + relative time since (millis()-based, no time:
    component needed), live "REC 5s clip..." during capture, else
    current sound level dB.
    - New globals: pir_trigger_count/sound_trigger_count (restore_value:
    yes, survive reboot), last_trigger_type, last_trigger_millis,
    is_capturing.
    - PIR and loud_sound on_press handlers now increment their counter
    and record trigger metadata before triggering the audio-clip
    capture script; capture_audio_clip toggles is_capturing so the
    di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
2026-08-12 Dinghy camera: drop OLED/bus_a, document real root cause (#33)
    The OLED work (d28472a) had its own genuine I2C bug on bus_a
    (SSD1306+AXP2101, GPIO7/6) -- confirmed via live serial: "SCL is held
    LOW on the bus", ESP-IDF bus-recovery failing, task watchdog
    crash-loop. Removed that bus/display/font from the firmware entirely
    rather than try to fix it blind -- it was never required for the
    security-camera core function (PIR/camera/mic all live on bus_b).
    While chasing that, found and fixed a separate tooling bug: esphome's
    build cache had gone stale (main.cpp/firmware.bin frozen at an earlier
    point in the session) and `esphome upload` was silently reflashing the
    same old binary on every attempt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
2026-08-12 Dinghy camera: pivot to SV3C IP camera after T-Camera hardware fault (#33)
    The LilyGo T-Camera's camera SCCB bus turned out to be a genuine
    hardware fault (7439365) -- unfixable remotely, survives fresh
    firmware and a full power cycle. Owner had 2x SV3C SV-B01-1080P-POE
    on hand; pivoted to one of them as the dinghy security camera.
    - Camera added to HA via the ONVIF integration (config-flow API),
    kept on the Sisu main LAN (192.168.0.x) rather than Sisu-IoT so HA
    reaches it directly with no extra firewall/routing rules -- avoids
    the whole class of networking issues from the T-Camera saga.
    - Credentials in secrets.yaml (ip_sv3c_dinghy1/sv3c_dinghy1_user/
    sv3c_dinghy1_pass), mirrored t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
    [ui-lovelace.yaml]
2026-08-12 Retire LilyGo T-Camera: remove dead files/entities/automations (#33)
    Full removal now that the SV3C pivot (dca5bfa) is verified working
    end-to-end. The T-Camera itself has a confirmed hardware fault on its
    camera SCCB bus (7439365) -- unfixable remotely, survives fresh
    firmware and a full power cycle -- so there's nothing left to reuse.
    Repo:
    - Deleted esphome/tcamera.yaml, esphome/tcamera_base64.h,
    packages/tcamera_audio.yaml, python_scripts/tcamera_audio_receiver.py
    (git history preserves all of it if the hardware is ever repaired).
    - Removed tcamera_ota_password/tcamera_api_encryption_key/esp_ip_tcamera
    from secrets.yaml + secrets.yaml.example (mirrored, scan_secrets green).
    - Fixe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
    [ui-lovelace.yaml]
2026-08-13 Add second SV3C camera "Forward Camera" (issue #33)
    Owner connected a second SV3C unit (MAC F0:00:00:41:BC:CE) pointed
    forward, and reassigned camera #1 to a fixed 192.168.0.33 (from the
    previous DHCP-assigned .130) -- camera #1 was disconnected to free a
    port while setting up #2, so its HA ONVIF entry couldn't be recreated
    against the new IP yet (needs a live connection to verify); will redo
    once it's reconnected.
    Camera #2 added to HA via ONVIF (config-flow API), confirmed live
    with a real snapshot pull -- already mounted in its final position
    (dinghy/davit area visible in frame). No motion detection enabled on
    this unit yet, so no automation built for it -- picture-only dashboard
    tile fo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
    [ui-lovelace.yaml]
2026-08-13 Debounce flaky ONVIF motion sensor + Forward Camera on-demand toggle (#33)
    Owner reported dinghy1's binary_sensor.dinghy_camera_cell_motion_detection
    permanently showing "motion detected", confirmed it was happening even
    before the camera was physically disconnected -- not a connectivity
    artifact. This matches a documented ONVIF integration quirk (camera
    sends a motion-start event, HA's PullPoint subscription never sees a
    matching stop): https://ipcamtalk.com/threads/camera-onvif-motion-binary-sensor-doesnt-clear.56150/
    Nothing on the HA side can force the raw entity to clear, so it's
    wrapped in a self-clearing input_boolean instead
    (input_boolean.dinghy_camera_motion_active): turns on imme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
2026-08-13 Rename dinghy camera to Aft Camera; add Off/On/Sentry mode system (#33)
    Owner requested: rename "Dinghy Camera" -> "Aft Camera" everywhere
    (Forward Camera keeps its name), and a unified 3-mode control for both
    cameras:
    Off -- dashboard shows only the mode switch. Can't actually power
    off a PoE camera without extra hardware, so this is an
    HA-side "don't show or act on it" state; the camera itself
    keeps running.
    On -- switch + live view. No motion automation runs.
    Sentry -- switch + motion active/not-active + the last snapshot
    (motion-triggered or periodic) with a timestamp, instead
    of continuous live view.
    Renam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
2026-08-13 Fix Sentry photo-burst to trigger per real motion pulse, not per session (#33)
    Owner: "when in Sentry mode, if motion triggers, then a snapshot
    should also be taken" -- exposed a real gap. The photo-burst automation
    was triggering off the debounced input_boolean's "on" transition, but
    that boolean is mode: restart and only flips "on" once per continuous
    motion session (retriggers just restart its 30s countdown without a
    fresh transition). A second genuine motion pulse arriving while the
    window was already active would silently take no snapshot.
    Fixed by triggering the burst directly off the raw ONVIF sensor's own
    "on" transitions instead, decoupled from the debounced boolean (which
    still ex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
    [ui-lovelace.yaml]
2026-08-13 Cameras tab: panel view for maximum screen space (#33)
    Owner: "make the camera views full screen, like filling all visible
    and usable space... the whole idea of the camera only view is to see
    as much camera as possible."
    Switched the Cameras view to panel: true, which drops Lovelace's
    normal max-width and card-gutter constraints and renders its single
    root card edge to edge at full viewport width, instead of confined to
    a masonry column like every other view in this dashboard. Panel mode
    only renders one card, so the toggle row + all four conditional
    single/split/hint layouts now live inside one outer vertical-stack.
    Split (both selected) switched from a grid card to a horizontal-stack,
    whi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
2026-08-13 Cameras tab: fix single-view toggle showing the wrong camera (#33)
    Owner: "the two buttons on the camera only view are swapped. if i
    toggle the left one, then the right camera goes full screen and vice
    versa."
    The two single-camera conditional cards had camera.forward_camera_*
    and camera.aft_camera_* swapped relative to which toggle produces that
    state -- unchecking the left (Forward) toggle left Aft the only one
    "on", which showed Aft; owner wants unchecking one to bring *that*
    camera into focus, not the other. Swapped the two cards' camera
    entities to match.
    [ui-lovelace.yaml]
2026-08-15 Add Grafana Weather dashboard: wind trend, wind rose, barometer (#24)
    New sisu-weather.json (19 panels): apparent/true wind speed + 6h gust max
    stats, wind angle gauge, fixed 1h and 24h wind speed/direction trend rows,
    a 24h wind-speed heatmap, a 16-sector wind-rose bar chart, air/water temp
    trend, and barometric pressure with a 3h rising/falling/steady tendency
    stat + humidity.
    New sensor.sisu_barometric_pressure / sensor.sisu_humidity
    (packages/marine_environment.yaml) -- no boat barometer/hygrometer
    fitted, so unlike air/water temp there's no NMEA-first fallback; both
    read weather.forecast_home (Met.no) attributes directly. Confirmed live
    (1016.9 hPa, 82%).
    Fixed a real gap in packages/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
2026-08-15 Split weather dashboard into WeatherAWA / WeatherTWD; TWD is home (#24)
    Renamed sisu-weather.json's title to "WeatherAWA" (sailing view, unchanged
    panels — wind relative to the bow off sensor.nmea_awa). Duplicated it into
    sisu-weather-twd.json ("WeatherTWD", uid sisu-weather-twd) for anchor-watch
    use: the wind-angle gauge, both direction trend panels, and the wind rose
    now show a computed true wind direction -- (heading_magnetic + awa) mod
    360 via a Flux join, not a new HA entity -- which only equals a real
    compass bearing when SOG ~ 0 (the anchor case this is built for; misleading
    underway, where WeatherAWA is still the right view).
    Set WeatherTWD as Grafana's org-wide home dashboard two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
2026-08-15 WeatherTWD: drop redundant TWS series from Wind Speed — Last Hour (#24)
    TWS is the instrument's own AWS+SOG+heading correction -- a no-op at
    anchor (SOG≈0), so it just retraced AWS on this panel. Left it alone on
    Wind Speed — Last 24 Hours (id 10, same dashboard) since that panel also
    carries the 6h rolling gust-max line, and on WeatherAWA where SOG isn't
    near zero and the AWS/TWS split is actually meaningful.
    Verified: scan_secrets green, JSON valid, panel confirmed provisioned
    with only the AWS target via Grafana API.
2026-08-15 Real TWD sensor (MWD sentence) + wedge wind roses + compass trail (#24)
    Sampling the raw NMEA feed found $YDMWD (instrument-computed true wind
    direction) already on the wire, plus $YDHDT (true heading) and MWV
    reference "T" (true wind angle) already being *parsed* by
    nmea_gateways.py but never exposed as entities. Corrects an earlier wrong
    assumption (this boat's feed "has no TWD sentence") that led WeatherTWD
    to approximate true wind direction via a heading+AWA Flux join, valid
    only at SOG~0.
    Added:
    - nmea_gateways.py: MWD sentence parsing (twd_true_deg, twd_magnetic_deg)
    - nmea_gateways.yaml: sensor.nmea_heading_true, sensor.nmea_twa,
    sensor.nmea_twd -- all three real instrument reading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
2026-08-15 WeatherTWD: last-5 / 1h / 24h / 7d roses, keep % + speed-bin colors (#36)
    Stacked roses stay frequency-% with knots in the color bands. Replace the
    compass and TWD timeseries with TWD+AWS roses; original rose is now 7 days.
    Last-5 is a fading trail (newest brightest). Heatmap kept.
2026-08-15 Persistent NMEA wind listener for real-time gust capture (#37)
    Measured live: the wind instrument transmits a fresh MWV reading every
    ~0.5s (~2Hz), but the existing command_line-polled pipeline
    (nmea_gateways.py, scan_interval 15) opens a fresh TCP connection for a
    ~2s sample once every 15s and keeps only the *last* line seen -- blind
    ~87% of the time, discarding ~75% of what it does see even while
    listening. A short (1-2s) gust had a real chance of being missed
    entirely, not smoothed.
    New: homeassistant/nmea_wind_daemon/ -- a small persistent Docker
    service that stays connected continuously, parses every single NMEA
    line as it arrives (not batch-parsed, specifically so nothing gets
    dict-ov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
2026-08-15 WeatherTWD: color AWS/TWS/6h-max stats with rose kn buckets (#38)
    Same bands as the stacked roses so the top-row numbers match the petals.
2026-08-15 WeatherTWD last-5 rose: kn-bucket rings and colors (#39)
    Concentric rings sit on the same 2/5/7/10/15/20 kn edges as the stacked
    roses, with matching band colors. Petals keep the recency fade in those colors.
2026-08-15 HA: Weather Anchor sidebar dashboard mirroring WeatherTWD (#41)
    Native Lovelace board for at-anchor true wind (live AWS/TWS/TWD, history
    windows, atmosphere, anchor strip). Sidebar + Sisu/Helm links. Roses stay
    on Grafana; no compose/embed change.
2026-08-15 Weather Anchor: north-up TWD compass needle (#42)
    Replace the 0–360 gauge with a N-up compass. Needle points at TWD (wind
    FROM) via config-template-card rotation of mdi:navigation.
2026-08-15 Wind daemon: source TWD/TWA from instrument, rewire Grafana off old entities (#40)
    1. Daemon now parses MWD (true wind direction, instrument-computed) and
    the TWA field of MWV (true wind angle), publishing sisu/nmea/wind/twd
    and /twa alongside the existing aws/tws/awa -- same "check the
    instrument before deriving it yourself" lesson from #37/MWD, now
    codified as CLAUDE.md mandatory rule #11.
    2. New sensor.nmea_twd_live / nmea_twa_live entities (nmea_wind_live.yaml)
    + InfluxDB include-list entries.
    3. Reseeded the two rolling-gust statistics sensors
    (true_wind_speed_max_6h, apparent_wind_speed_max_10m) to read the new
    live entities' recorder history instead of the old 1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
2026-08-15 Weather Anchor TWD compass: stop flicker, longer needle, labels (#43)
    Keep picture-elements as the outer card so 1 Hz TWD no longer remounts
    the ring or reflows the board. Needle is a long SVG almost to the ring;
    N/E/S/W sit outside; 30° numerals; FROM nearer the hub.
2026-08-15 Policy: one data kernel, YDWG-first, no slow/fast twins (#44)
    Add sources.md quantity/priority table and SpectraControl.md page atlas.
    Agents must not invent _live/_slow entities; Grafana gets a downsample
    view. Implementation is #45–#48.
2026-08-15 Wind daemon: real per-connection failover, fix flapping (live incident)
    Live incident: user reported stale wind data, physically confirmed YDWG's
    LEDs weren't flickering. Investigation found YDWG-02 in a "zombie" state --
    TCP port 1456 completes the handshake fine, but the NMEA-serving process
    behind it is dead (reads immediately reset or, per the daemon's own 2h of
    logs, just go silent forever without ever closing the socket). A bare
    connect() succeeding is not proof of a healthy gateway.
    The old code only ever noticed via the 60s stale-restart watchdog, and
    that watchdog does a full *process* restart -- which resets gateway_idx
    back to 0 (primary), so it just kept retrying YDWG forever. C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
2026-08-15 Kernel ingest: dual-listen YDWG+DataHub → MQTT sisu/v1 (#45)
    Stay connected to both gateways and merge per signal (YDWG if the
    field is fresh, else DataHub). Liveness is NMEA received, not SYN-ACK
    — keeps #49's per-socket mute reconnect and does not bring back the
    tcp_open failback flap.
    parse_nmea now extracts XDR/MDA/RPM/HDM/RSA/VHW/ROT/VLW and rejects
    DataHub $IIMWD bearings outside [0,360]. Engines and air temp stay
    YDWG-only. Old sisu/nmea/wind/* aliases remain until #46.
2026-08-15 Source liveness chips: kernel live/age/error → HA Sources screen (#50)
    The ingest daemon already knew which sockets were mute (#45/#49).
    Publish sisu/v1/meta/<src>/{live,age_s,error} from that watchdog and
    wire HA binary_sensors plus a /lovelace-sources row (also on Sisu and
    Helm). Green = sentences/data flowing, not TCP-open.
    [ui-lovelace.yaml]
2026-08-15 HA: one sensor.nmea_* per quantity from sisu/v1 (#46)
    Retire the 15s command_line twins and *_live MQTT sensors. Weather
    Anchor, Helm, Influx include, and Grafana WeatherTWD/AWA all use the
    canonical names. GPS-fix follows latitude liveness, not the old poll.
2026-08-15 Influx Sisu_raw + Sisu_1m views; Grafana ≥1h uses 1m (#47)
    HA still writes the Sisu bucket (UI entry). Tasks mirror that into
    Sisu_raw (7d, kernel rate) and downsample to Sisu_1m. Weather 24h
    heatmap reads Sisu_1m at 2m (~228 points today, 720 at full day) so
    it stays under Grafana's 1000-point cap. No HA _slow twins.
2026-08-15 Signal K: map sisu/v1 wind/nav/engines; drop DataHub TCP (#48)
    Kernel JSON now includes value_si (SI) for signalk-mqtt-sensors.
    SK paths environment.wind.*, navigation.*, propulsion.{port,starboard}.*
    are filled from MQTT. YDWG TCP stays for AIS/oil; DataHub pipe is off
    because the kernel already owns that merge.
2026-08-15 INDEX.md: correct stale engine-unavailable claim, note #33 closed
    sensor.sisu_engine_* confirmed live via direct API check while
    investigating issue #52 (HA Engine tab audit) -- the "unavailable, SK
    bridge not returning data" note predated this and was stale. Also
    noting #33 (dinghy/aft camera) closed fully done, and the new #52-56
    HA dashboard audit issues filed this session.
2026-08-15 Docs: document Green kernel ingest (sisu-nmea-ingest)
    Policy was in sources.md; ops/install only said “+ ingest”. data_flow
    still described the Mac compose _live daemon. Point INSTALLATION/OPS/
    INDEX at ha-kernel-mqtt.sh and drop the stale Mac/F8 ingest story.
2026-08-15 Docs: HA 2026.2+ Settings → Apps, not Add-ons
    Ingest lives under Settings → Apps → Sisu NMEA ingest.
2026-08-15 Water tab: add Autostore tile next to Running, drop misleading product_flow (#55)
    - water.yaml: status strip now shows an Autostore tile alongside Running,
    so an idle-countdown state (page 4, genuinely not pumping) never reads
    as "Spectra is doing nothing" in isolation.
    - spectra_newport.yaml: removed sensor.sisu_watermaker_product_flow -- it
    was unused on any dashboard/automation and mislabeled (its state was
    literally tank_percent, not a flow rate; Newport 400c's WS API has no
    actual flow-rate telemetry).
    - Documented (comment, not fixed -- nothing to fix): feed_pressure,
    boost_pressure, tank_raw, filter_percent, product_ppm genuinely go
    Unavailable on pages with no gauge (co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
2026-08-15 HA Power: 3 Victron MPPTs + instrument yield today (#54)
    GX MQTT already had History/Daily/0/Yield (kWh) per charger. Expose
    Roof Fwd / Roof Mid / Aft from CustomName, drop the 5 location stubs,
    wire yield-today from the instrument (no VRM, no utility_meter).
2026-08-15 HA Alternators: bind Overview to production ESPHome boards (#58)
    Stop using lab_bench_alts_sim_* on the vessel screen. Combined/charging
    come from alternatorport/starboard. Top chips show Port/Stbd board
    online/offline so unavailable gauges have an explanation. Lab tab stays
    bench-only. Add ESPHome status: on marine_board_base for after flash.
2026-08-15 Anchor watch: real GPS distance/bearing/alarm implementation (#53)
    - New packages/anchor_watch.yaml: haversine distance + initial-bearing
    from live sensor.nmea_latitude/longitude to a captured drop point,
    input_number/input_boolean-backed radius + enable + drop-set state
    (the old vessel_placeholders.yaml stubs for number.sisu_anchor_radius
    and switch.sisu_anchor_alarm_enable could never actually be changed --
    their `state:` was a hardcoded literal, set_value/turn_on/turn_off only
    logged to the logbook without persisting anything). Same entity_ids
    reused so helm.yaml/weather_anchor.yaml need no rewiring.
    - button.sisu_anchor_set_here captures real GPS position (guarded on
    GPS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
2026-08-15 Engine tab: rewire Alternators section off T8 bench sim to production IDs (#60)
    Follow-on to #58, which remapped alternators.yaml/ui-lovelace.yaml but
    missed engine.yaml's own Alternators grid (gauges, stage/temp/fault
    tiles, header charge-summary line) -- confirmed still on
    sensor.lab_bench_alts_sim_*.
    - Gauges/tiles now use alternatorport_*/alternatorstarboard_* (real
    Marine Board ESPHome entities), matching alternators.yaml's #58
    precedent exactly.
    - Header line uses sensor.sisu_alternators_charge_summary (production
    alias, #58) instead of the bench-only charge_summary/ETA text; ETA
    dropped -- no production equivalent, per #58's own note, not
    fabricated.
    - Added Port/Starboard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
2026-08-15 HA: show at least one decimal on all Volt entities (#61)
    Power battery gauge used default 0-digit V precision. Customize
    house/bank to 2 decimals and engine/solar volts to 1. Do not set
    suggested_display_precision on template sensors — HA 2026 rejects it
    and unloads the whole package.
2026-08-15 Dual-alt shared house current budget (#16)
    Clamp each side's requested current to house_i_budget/2 while the
    peer Marine Board is present (default 250 A combined, max 300 A).
    Peer explicitly offline uses the full per-alt SP/CEIL path. HA only
    carries peer liveness — the clamp is local; ALT_I_CEIL is unchanged.
    Lab bench sim applies the same 50/50 split. Policy in
    ALTERNATOR_LIMITS.md; R31 removed.
2026-08-15 Dual-alt budget default 300 A combined / 150 A per side (#62)
    Operator-confirmed vessel duty on the 320 A machines and 5×300 Ah
    Victron NG bank. Shared request clamp still 50/50; ALT_I_CEIL stays
    250 A. Follow-up to #16.
2026-08-15 HA: rename Weather Anchor dashboard to Weather TWD, drop Anchor panel (#56)
    - Retitle across nav card, panel registration, dashboard title/view/heading,
    and helm.yaml cross-link.
    - Drop weather_anchor.yaml's trailing Anchor grid (alarm/distance/bearing
    tiles + Helm link) — same placeholder entities as the Helm-tab cleanup
    in #53, permanently unavailable, cosmetic removal only.
    - Deep-link path /lovelace-weather-anchor and filename weather_anchor.yaml
    kept as-is (cosmetic title rename only, no bookmark break).
    - Self-healed .ai_context/displays.md row to match.
2026-08-16 Add saloon guest display (Waveshare ESP32-S3-Touch-LCD-4.3B), #63
    Standalone ESPHome device, 3 swipeable LVGL pages: Home (air/water temp,
    latched depth, AWS max 6h, sunrise/sunset), Wind (AWS trend + current/max),
    WiFi (guest network QR code). All values are read-only imports of existing
    HA entities via the homeassistant: sensor platform - no new HA sensors,
    MQTT topics, or Signal K paths needed.
    Display: mipi_rgb platform with the built-in ESP32-S3-TOUCH-LCD-4.3 preset.
    Touch: gt911. Depth latches its last valid reading (globals + NaN guard)
    since sensor.nmea_depth expires after 30s when instruments are off.
    Verified live: flashed to the physically attached board, paired with HA,
    confirm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
2026-08-16 Saloon display: fix swipe nav, page_wifi layout, add guest WiFi password + Fahrenheit, #63
    Live-iterated on the physical hardware with the user after initial bring-up:
    - Swipe navigation was never wired up (esphome lvgl pages: has no built-in
    swipe-to-navigate) - added on_swipe_left/right -> lvgl.page.next/previous
    on all 3 pages.
    - page_wifi (guest WiFi QR + password) went through several rounds:
    image-left/text-right split, then flex_align_main: start (packs both
    flush left, was drifting toward center under space_evenly/space_between),
    then width: SIZE_CONTENT on the text box (was clipping at LVGL's stock
    default object width regardless of free screen space).
    - Added guest_wif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
    [saloon_display.yaml]
2026-08-16 Saloon display Wind page: HA/MQTT-fed 1h trend + Max(1h), #66
    Corrected design per issue discussion (community reply caught real problems
    with the original http_request:-based plan — python_script/templates can't
    serve HTTP endpoints at all, and raw HA history for a high-rate NMEA sensor
    is the wrong-sized payload):
    - New automation sisu_wind_trend_aws_1h (automations.yaml, every 5 min):
    sensor.nmea_aws already has state_class: measurement, so HA's 5-minute
    long-term stats already exist. Pulls the last hour (12 buckets) via
    recorder.get_statistics, publishes as CSV to sisu/v1/wind/aws_trend.
    - New sensor.nmea_aws_trend_1h (packages/source_health.yaml), same MQTT
    pattern as every o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
    [saloon_display.yaml]
2026-08-16 Saloon display: touch-wake backlight, 60s idle timeout, #65
    mipi_rgb's board preset writes its enable_pin (CH422G EXIO2 - confirmed
    against Waveshare's own docs as the real backlight line) HIGH once at
    boot and never touches it again (checked mipi_rgb.cpp's setup_enables_ -
    enable_pins_ is only ever referenced there). Added a separate output:
    platform: gpio on that same physical pin for ongoing control, safe
    alongside the display component since it never writes to it again
    post-boot.
    - output: backlight_output (ch422g EXIO2, same pin, second owner - fine
    since mipi_rgb's write is one-shot at boot)
    - script: backlight_timeout_script, mode: restart, 60s delay then off -
    restart mode means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
2026-08-16 Grafana WeatherTWD: pin Wind Speed — Last Hour x-axis to 1h, #67
    Dashboard default time is now-24h, so the timeseries panel was drawing
    a 24h axis while Flux only returned the last hour. Panel timeFrom
    now-1h keeps the axis on a rolling hour regardless of the picker.
2026-08-16 Sisu NMEA ingest: working Supervisor watchdog + down alert, #64
    Root cause (confirmed via Supervisor's own logs and validate.py source,
    not assumed): boot: auto only governs start-on-Supervisor-boot, not
    restart-on-crash. Two real fixes were needed, discovered by testing live
    against the actual instance rather than guessing:
    1. watchdog: true is NOT valid syntax for this Supervisor version -
    confirmed via its store validation log ("expected string or buffer for
    dictionary value @ data['watchdog']. Got True") and its own
    apps/validate.py schema (vol.Match on an active tcp://[HOST]:port
    probe string, matching core_mosquitto's real config as a working
    example). Set to tcp://[HOS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
2026-08-16 Fix Source Freezer tile: match real paired entity_id, drop resolved LAN/IoT routing risk
    - freezer.yaml pairs with HA under sensor.aft_cockpit_sisu_freezer_freezer_temperature
    (area+friendly_name prefix), not the guessed sensor.freezer*_temperature names the
    Source Freezer template checked — tile now recognizes the real entity.
    - Deployed + verified live on HA Green (ha-deploy-config.sh, ha core check, template.reload).
    - Delete risks.md R21 (Sisu-IoT isolation / no LAN route): confirmed resolved — ping/TCP
    6053/HTTP all reachable from HA Green to freezer .44, corroborated by saloon display
    already paired live on the same subnet.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
2026-08-16 Add Freezer dashboard (issue-driven, freezer.yaml pairing follow-up)
    New Lovelace dashboard at /lovelace-freezer, registered in configuration.yaml:
    - Status strip: markdown narrative (frost-level emoji ❄️/🔥, compressor,
    battery-low, source-online) mirroring water.yaml's status-strip pattern
    - Temperature: gauge (green deep-freeze / yellow near target / red thawing)
    + thermostat card bound to climate...freezer_thermostat for setpoint control
    - Power & status: local battery-voltage gauge (thresholds match firmware's
    own <11V low-battery logic) + tiles for compressor, battery low, probe
    fail, source online
    - 24h history graph + full entities reference table
    Uses the real paired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
    [freezer.yaml]
2026-08-16 Fix misleading Freezer 'Disconnected' on Sources dashboard: split connectivity vs error
    source_freezer previously checked whether the temperature sensor had a
    valid reading — indistinguishable from the device being offline, when in
    fact the DS18B20 probe just isn't wired yet (ESPHome reports that as
    'unknown', not 'unavailable'). That's the exact ambiguity #50's own header
    comment warns about elsewhere in this file.
    - source_freezer now checks the compressor switch's availability (only
    ever on/off/unavailable — genuine ESPHome API liveness), mirroring the
    same switch/climate-based liveness signal used to confirm the device
    live earlier this session.
    - New source_freezer_error (dev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
2026-08-16 INDEX: note Freezer paired + dashboard + Sources split, file #68/#69 for Alternators/Levels
    Filed follow-up issues to apply the same connectivity/fault split done for
    Freezer's Sources tile to Alternators and Levels once their production
    Marine Boards are commissioned (#11).
2026-08-16 Freezer AMOLED: touch UI, no-probe state, safer compressor defaults, #70
    The glass was display-only. Right strip now +/− setpoint, COOL/OFF and
    freeze/fridge are tappable, missing DS18B20 shows NO PROBE, and a
    floating battery ADC no longer reports 0.4 V as low. Climate will not
    start the compressor without a probe; the HA switch still can for bench
    GPIO tests. AMOLED dims after 60s idle.
    [freezer.yaml]
2026-08-16 Freezer display: drop NO PROBE below the header, #70
    72pt baseline was at y=78, so the text sat on FREEZER/WiFi/COOL.
    Move it to y=120, same line as the live temperature.
2026-08-16 MarineBoard BOM: sync stale C33/R16 entries to schematic, add R37/R45/U20 (#26)
    BOM was out of sync with MarineBoard.kicad_sch's already-edited RPM
    ripple-tap protection circuit:
    - C33 was still grouped as the old 12pF 0402 cap — schematic's actual C33
    is a different part entirely (1.2uF 100V, C_1210_3225Metric)
    - R16 was still listed as 470R 0402 — R16 no longer exists in the
    schematic at all (replaced outright by R45, not repurposed)
    - R37 (100K, bias resistor), R45 (2K2 2W 2512, replaces R16), and U20
    (SMAJ6.8CA, TVS) were entirely missing from the BOM
    All four new rows' Value/Footprint/LCSC# pulled directly from
    MarineBoard.kicad_sch (cross-checked R45's LCSC C2075262 against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
    [MarineBoard.csv]
2026-08-16 INDEX: note #26 BOM/docs synced to schematic, only tool/HW-gated items left
2026-08-16 Anchor watch: real alerting, GPS-lost alert, breach-delay, map, depth radius (#72)
    Compared the HA anchor watch (#53) against dedicated anchor apps (Anchor
    Pro, DragQueen, PredictWind Anchor Alert, signalk-anchoralarm-plugin) and
    closed five gaps:
    - binary_sensor.sisu_anchor_alarm previously drove nothing but a dashboard
    tile. Added automation.anchor_drag_alarm_notification: sticky
    persistent_notification + logbook on trip.
    - Losing GPS fix while armed was indistinguishable from "all clear" (alarm
    template just returns false). Added binary_sensor.sisu_anchor_gps_lost +
    its own notification automation.
    - Alarm tripped on a single GPS reading over radius, no debounce. Added
    number.s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
    [anchor_watch.yaml]
2026-08-16 Retire lab alt sim/HIL + test_mode; add shadow commission (#73)
    - Delete test_rig.yaml, bench_alts_sim.yaml, dashboards/alternators_sim.yaml,
    packages/sim_production_aliases.yaml (renamed -> alternator_helpers.yaml,
    now just the combined I/P + board-online helpers, lab aliasing dropped),
    scripts/test_alternator_hil.py, esphome/docs/{ALTERNATOR_HIL_RESULTS,
    HIL_TEST_PROCEDURE}.md.
    - Remove test_mode_enabled everywhere (firmware, docs, secrets.yaml +
    .example, esp_ip_test_rig) — it faked current and bypassed ENBL.
    - marine_alternator.yaml: add shadow_sw (measure-only) switch, default ON
    (RESTORE_DEFAULT_ON), forces field PWM to 0 while I/V/T publish so an
    existing regulator (eM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
2026-08-16 alternator_helpers.yaml: pick up tightened header comment, #73
    Working-tree edit had landed on top of the staged rename but was never
    re-added before the #73 commit — same file, no content drift otherwise.
2026-08-16 SK plugin-config MQTT creds: never git-tracked, injected locally (#74)
    signalk-mqtt-bridge / signalk-mqtt-sensors have no !secret-style
    indirection (checked both plugins' source: mqttBrokerAddress and
    mqtt_password are literal-value-only fields, no env/file reference
    support) — the SK admin UI writes the real broker password straight
    into these git-tracked JSON files.
    Rather than gitignoring the whole files (would lose git history on
    signalk-mqtt-sensors.json's real, evolving topic->SK-path mapping
    content, the actual valuable part of that file), the committed copies
    of both stay permanently credential-free. New
    scripts/signalk-inject-mqtt-creds.sh reads the broker password already
    in sec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
2026-08-16 INDEX: note #75 closed (C4001 radar — bench-trial verdict, no install yet)
2026-09-07 docs: file Sisu Nav phases #76–#79 and wire context pointers
    Architecture plans at repo root (Grok working plan + Claude long-form).
    INDEX/CLAUDE/AGENTS/README/displays/sources point at sisu-nav/ and the
    sequenced issues. Compose still a Phase 1 (#76) hotspot; later phases
    depend and must not overlap Touches in the same wave.
2026-09-07 INDEX: #76 closed; Sisu Nav next is #77 ∥ #80 ∥ #79
2026-09-07 Sisu Nav Phase 2: multi-model overlay + agreement heatmap (#77)
    Open-Meteo one-call models= + cell_selection=sea, 30 min cache. Sidebar
    picker, GFS/ECMWF barbs, vector-spread heatmap, click-cell table, one-model
    particles. Glob-loaded; App.tsx and compose untouched.
2026-09-07 INDEX: #77 closed; Sisu Nav next is #80 ∥ #79, then #78
2026-09-07 Sisu Nav Phase 5: dated tile harvest — EOX/GIBS/Esri, secret-gated MapTiler/Maxar/Planet (#80)
    - api/providers.yaml: provider registry driving the dropdown. Google/Bing/
    Apple/Mapbox absent on purpose (no official offline SKU / ToS). OpenSeaMap
    present but harvestable:false (already a live #76 overlay).
    - api/harvest/**: job orchestrator (single in-process worker, no new compose
    service), MBTiles writer on node:sqlite (no native/GDAL dep), disk-quota
    guard, and template-based fetchers for EOX/GIBS/Esri — verified live
    against real EOX/GIBS endpoints and end-to-end through a built Docker
    image (health, providers, estimate, job run, /api/tilesets pickup).
    Re-run of a complete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
2026-09-07 INDEX: #80 closed; Sisu Nav next is #79 ∥ #78
2026-09-07 Sisu Nav: auto-harvest the current map view for the selected provider (#82)
    Charts → Download follows the visible bounds at the current zoom after
    pan/zoom (debounce). Provider dropdown selects the source. Esri/quota/
    secret/NOAA-ENC stubs still refuse; auto can be paused.
2026-09-07 INDEX: #82 closed; auto-harvest current map view
2026-09-07 Sisu Nav harvest: skip if source date unchanged; fill missing tiles (#83)
    Compare provider product date (EOX layer year, GIBS day, Esri ETag) before
    fetching. Same sourceDate reuses the MBTiles and only fills holes; a complete
    covering view is skipped. Calendar-day _2 folders are gone for these providers.
    [providers.yaml]
2026-09-07 Sisu Nav: sidebar order windex, weather, harvest (#84)
    Panel plugins sort by NavPlugin.order (10/20/30). App.tsx still only maps
    slot=panel; plugins without order sort last.
2026-09-07 Sisu Nav Phase 3: isochrone routing with three named modes (#78)
    Add glob-loaded route plugin and api/route isochrones. Modes are Minimize
    ETA, multi-model agreement, and ensemble-member agreement (not one blended
    score). Clustered GEFS default; deep GEFS+ECMWF ENS on demand. Polar CSV
    warning is visible. Committed routes go API → Signal K resources/routes.
    Land avoidance is GSHHG-style polygons (no GDAL). Ensemble uses
    cell_selection=sea. Advisory only.
    [generic-cruising.csv]
2026-09-07 INDEX: Sisu Nav layer picker + wind roses issues #85–#88
    Point NEXT at #85 (picker) → #86 (Influx roses) → #88 (community),
    plus #87 forecast stubs and #79 notes.
2026-09-07 Sisu Nav: private anchorage notes (#79)
    Notes plugin: pins on the map (click to place, click marker to select),
    name/description/optional NFL-Navily link, backed by SK resources/notes.
    Direct browser->SK REST (same pattern the live WS already uses; unlike
    route/commit there's nothing server-computed to add, so this stays out
    of sisu-nav/api entirely — keeps it parallel-safe vs #86 editing
    server.mjs/Dockerfile/compose for roses).
    Live-verified PUT/GET/DELETE round-trip against the running SK server
    with a real bearer token before wiring the UI to it.
    Fixes a real TS narrowing bug along the way: `formOpen = !!selected ||
    !!draftPos` let TS's aliased-condition narrowing prove `selected` is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
2026-09-07 Sisu Nav: AIS as a Layers toggle (#89)
    Catalog id `ais` (default on). Unchecking clears AIS targets only; own
    boat and track stay. Existing layer localStorage still gets AIS on via
    a `known` id list so the new row is not treated as user-off.
2026-09-07 INDEX: Sisu Nav overlay queue #91–#95 (ENS, waves, currents)
2026-09-07 MarineBoard: consolidate LCSC libraries into EasyEDA (#96)
    Merge 0623, easyeda2kicad, and root EasyEDA.pretty into Lib/EasyEDA.
    Retarget schematic/PCB nicknames and 3D paths to the project library.
    Import Hirose FH12-18S QSPI symbol and footprint; J3 on the board is unchanged.
    [MarineBoard.kicad_pcb, MarineBoard.kicad_sch]
2026-09-08 INDEX: Sisu Nav bathymetry harvest queue #97–#101
    Floor + BlueTopo / GEBCO / Seascape providers + coverage-aware source.
2026-09-08 INDEX: harvest keys #102 and extra bathy sources #103–#107
2026-09-08 Sisu Nav roses: plot at sample centroid, not geohash cell centre (#90)
    Each rose cell now accumulates lat/lon sums as points are joined and
    emits the mean of the samples in that geohash-5 cell instead of
    geohashCenter(hash). A mooring-ball cluster now renders on itself
    (GPS scatter, ~5m) instead of at the geometric centre of the ~4.9km
    geohash-5 square, which could be up to ~2.6nm away.
    Verified with a simulated 20-sample mooring cluster: previous
    behaviour placed the icon ~2.2km from the cluster; fixed behaviour
    places it ~0.3m from the cluster mean.
2026-09-08 Sisu Nav: customizable right-hand bar and instruments grid (#109)
    Layout gear shows/hides/reorders aside plugins (persisted). New Instruments
    panel is a row/column metric grid with + and drag; windex keeps the rose only.
    Layers stays map chrome so hiding the stack does not remove the map button.
2026-09-08 Sisu Nav harvest: don't let one bad tile abort the whole batch (#110)
    Root cause: runTemplateHarvest (shared by EOX/GIBS/Esri) looped every
    tile in a single try/finally with no per-tile catch. fetchBuffer
    throws after retries on any non-2xx (a 404 for no-coverage-at-that-
    zoom, a persistent rate limit, etc), which aborted the entire
    remaining loop — tiles after the failure in iteration order never
    even got attempted. Since successful tiles before the failure are
    already committed to the mbtiles file, every retry (a fresh
    'harvest this view' job or the Resume button) hit the same failing
    tile first and aborted at the same spot again, so the job could
    never make forward progress past it. Mat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
2026-09-08 Sisu Nav harvest panel: don't blank Jobs on a bad response; sort newest-first (#111)
    Root cause of the Jobs list flashing empty and 'recovering' shortly
    after: api.ts's asJson() did res.json().catch(() => ({})) — a 2xx
    response with a truncated or unparseable body (network/proxy blip,
    or just a fetch racing heavy CPU from panning) silently resolved to
    {} instead of rejecting. fetchJobs() then read j.jobs ?? [], so a
    genuinely bad response was indistinguishable from 'zero jobs exist',
    and the 4s polling tick() happily overwrote a populated job list
    with an empty one — recovering only on the next successful poll.
    Panning itself doesn't refetch jobs, so the 'came back after a pan'
    was almos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
2026-09-08 Sisu Nav layer: ensemble wind ECMWF IFS ENS (#91)
    Map overlay for the Open-Meteo Ensemble API, model ecmwf_ifs025
    (51 members), cell_selection=sea. Clustered (control + 10) by
    default, deep opt-in fetches all 51. Un-greys ens-ecmwf in the
    Layers catalog via registerLayer(); ens-aifs/ens-gefs stay stub
    for #92/#93. Mutex group "ensembles" (one spaghetti set at a
    time) was already wired in layers.ts from the #97 floor commit.
    Completes grok's staged-but-uncommitted work; verified tsc
    --noEmit, node --check on api/ensemble + server.mjs, and
    scan_secrets.sh green.
2026-09-08 Sisu Nav: installation, user, and developer docs (#112, #113, #114)
    Adds the three-doc set for sisu-nav/:
    - INSTALLATION.md: build/deploy (Mac interim + F8), env vars/secrets,
    tiles, Signal K auth, verify steps.
    - USER_GUIDE.md: the cockpit UI — Layers/mutex groups, Windex,
    Instruments, Weather, Ensemble wind, Route, Wind roses, Notes,
    Charts/Bathymetry harvest, Layout gear.
    - DEVELOPER.md: api/server.mjs routing + feature modules, the
    NavPlugin/loadPlugins glob contract, layers.ts/registry.ts,
    side.ts stack ordering, and a worked add-a-plugin recipe.
    sisu-nav/README.md trimmed to an index that links out to these
    instead of duplicating deploy detail (its own self-heal risk).
    Co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
2026-09-09 MarineBoard: schematic library/component update
    [MarineBoard.kicad_sch]
2026-09-09 Sisu Nav: allow Mapbox/Google/Bing/Apple tile providers (personal-use ToS accepted)
    Sisu Assist is personal-use, non-commercial, and the maintainer has
    knowingly accepted the ToS exposure these four providers carry for
    tile caching/offline storage (confirmed against their actual terms,
    not assumed) - repo visibility (public/private) has no bearing on
    this either way. Replaces the blanket ban in providers.yaml's header
    (the authoritative source) and every doc that repeated it. Also
    fixes a dangling "see the provider table in CLAUDE.md" cross-reference
    in INSTALLATION.md/DEVELOPER.md/USER_GUIDE.md - that table never
    existed in CLAUDE.md; the policy has only ever lived in providers.yaml.
    Adds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
    [providers.yaml]
2026-09-09 Sisu Nav harvest: Mapbox Satellite tile provider (#117)
    Adds Mapbox as a real (non-stub) harvestable provider: raw Raster
    Tiles API v4, {z}/{x}/{y} template + access token, via the existing
    runTemplateHarvest pipeline (mapbox.mjs fetcher, MAPBOX_ACCESS_TOKEN
    secretEnv). Chosen as the first of the four newly-allowed providers
    because it's the least ToS-restrictive of Google/Bing/Apple/Mapbox
    per the maintainer's own call (see providers.yaml's header).
    sourceDate.mjs's HEAD-probe sample-tile builder now also substitutes
    a {token} placeholder from provider.secretEnv, needed for any future
    secret-gated template provider's http-head sourceDate check to
    actually authenticate.
    Wires MAPBOX_ACCESS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
2026-09-09 Sisu Nav: futuristic UI theme + day-mode toggle (#122)
    New design-token palette in App.css (neon amber/cyan accents,
    --glow-* box-shadow tokens) plus a data-theme="light" day-mode
    override — high-contrast, same color identity, glow bloom dialed
    back for daylight legibility. Night stays the :root default (the
    app's only look until now), day is an explicit opt-in toggle, not
    prefers-color-scheme-driven.
    New app/theme.ts (persisted per-browser, same shape as side.ts/
    layers.ts) wired into a status-bar toggle in App.tsx.
    Swept every plugin CSS file: hardcoded --well-equivalent hex values
    (#0b1016 etc.) replaced with tokens, and every existing hover/active/
    primary/danger color rule gets a ma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
2026-09-09 Sisu Nav ais-global: fix Blob message parsing (real bug, #115)
    Node's native WebSocket (undici) delivers MessageEvent.data as a
    Blob for text frames, not a string/Buffer like the `ws` npm package
    would give. raw.toString() on a Blob returns the literal string
    "[object Blob]", which silently failed JSON.parse on every single
    AISStream message (swallowed by the catch block) — the endpoint
    correctly reported connected:true but never actually held any
    vessel data.
    Caught via a live smoke test against the real API after deploy
    (connected:true, vessel count stuck at 0 despite the bounding box
    covering a genuinely busy shipping area) rather than trusting the
    connection-status field alone. Fixed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
2026-09-09 Sisu Nav layer: anchoring hazards - submarine cables (#118)
    New hazards layer/plugin: submarine telecom cables + landing points,
    fetched live from TeleGeography's own public API (not a bundled
    snapshot, so it doesn't go stale) and cached server-side for 30 days
    with stale-serve-on-failure. Framed as a "hazards" plugin, not just
    "cables", so other anchoring obstructions (wrecks, pipelines) can be
    added as additional sub-layers later without restructuring.
    Cables render with TeleGeography's own per-cable color (their GeoJSON
    already carries a `color` property, used directly via a data-driven
    MapLibre paint expression); landing points render as dots, dimmed for
    planned-but-not-yet-laid ones (`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
2026-09-09 INDEX: hazards/cables (#118) landed
2026-09-09 Sisu Nav: live basemap toggles - Esri/OSM/Mapbox (#116)
    New basemaps plugin: live, un-cached basemap toggles distinct from
    the harvest/offline path (#117) - fetched fresh every time, no disk
    persistence. Esri World Imagery and OpenStreetMap need no key,
    ready immediately; Mapbox Satellite gates on MAPBOX_ACCESS_TOKEN.
    Google/Bing left as stub rows - Google's Map Tiles API needs a
    session-token flow and Bing needs its own imagery-metadata
    resolution, both meaningfully more work than a plain {z}/{x}/{y}
    template; landing them properly is a follow-up, not squeezed into
    this pass. Mutex group basemap-live: one live basemap visible at a
    time.
    No new api/ module - reuses /api/config's existing co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
2026-09-09 Sisu Nav: finish live basemaps (#116) and harvest fill landing
    Wire Google/Bing into /api/config, compose, and the image (session +
    quadkey). Live tile 403/404s surface in the Basemap panel instead of a
    blank map.
    Harvest "filled N" now counts image bytes actually inserted. In-place
    fills bump tileserver (mtime fingerprint, no 404 cache) and MapLibre
    (source re-add with ?v=mtime) so the chart shows the new tiles.
2026-09-09 Sisu Nav: make the Layers picker scroll to the bottom rows
    The overlay list outgrew the map: MapLibre clips overflow, so live
    basemaps (Azure etc.) sat off-screen with no way to reach them. Cap the
    menu to the remaining map height above the attribution bar and scroll
    the list; stop wheel/touch from zooming the chart instead.
2026-09-09 Sisu Nav: currents overlay from Open-Meteo Marine SMOC (#95)
    Layers toggle draws Meteo-France SMOC velocity+direction (knots, towards)
    on the chart. Open-Meteo was usable in BVI/Grenada so Copernicus is not
    wired. Arrows combine with wind particles; no App.tsx.
2026-09-09 Sisu Nav: harvest NOAA BlueTopo WMTS bathymetry (#98)
    US-waters relief/hillshade as kind:bathymetry. Empty 1-bit ocean tiles
    are not stored. Overlay is 512px, Layers-toggled, does not replace the
    satellite base. Out-of-coverage views refuse with "no BlueTopo in this
    view". No GDAL.
    [providers.yaml]
2026-09-09 Sisu Nav: harvest EMODnet world bathymetry WMTS (#103)
    Global EBWBL 2020 XYZ (Europe DTM + GEBCO elsewhere). Free, no key.
    BVI is GEBCO-class from this layer — not Caribbean high-res.
2026-09-10 Sisu Nav: USB/Finder drop-in charts with folder + file pick (#108)
    Operator copies .mbtiles/.pmtiles/XYZ they already have into a mounted
    inbox, then picks the folder and which files. Mac warns above ~32 GB so
    a circumnavigation dump stays an F8 job; a small subset is enough to test.
    Imports land in tiles/manual/<slug>/ with meta.json, never auto-paint, and
    toggle from Imported / Charts / Bathymetry plus Layers. No Navionics decoder.
2026-09-10 Sisu Nav: Charts dropdown is the basemap; Layers are overlays (#127)
    One Charts selection is the map (live, harvested provider, or imported
    chart). Layers no longer lists Esri/OSM/Mapbox/Google/Azure or imported
    charts — only wind, AIS, bathy, currents, cables, and the other overlays.
    Harvested tiles no longer stack every provider; only the selected one paints.
2026-09-10 Sisu Nav: OpenSeaMap seamarks as a Layers overlay (#125)
    Live buoys/lights/day-marks from t1.openseamap.org on top of the Charts
    basemap. No API key, not harvested, not a chart replacement. Toggle
    OpenSeaMap marks in Layers (off by default).
    [providers.yaml]
2026-09-10 Sisu Nav: local-time sliders and Follow me (#130, #131)
    Forecast time sliders show the device timezone, not UTC. Follow me pans
    to browser geolocation (dot marker), not AIS/Signal K Sisu. Gold boat
    stays the instrument position. Geolocation needs HTTPS or localhost.
2026-09-10 Sisu Nav: remaining Layers overlays (#87, #92, #93, #119, #120, #121)
    Rain/clouds/dust (Open-Meteo) and RainViewer radar; AIFS and GEFS
    ensemble spaghetti (mutex with IFS); viewport Overpass POIs; adsb.lol
    aircraft; CelesTrak satellite ground tracks in view. No App.tsx.
2026-09-16 Ops: F8/TNAS SSH access (bench bring-up, memory-swap verification)
    First-ever SSH access to the TerraMaster F8 (#6, not commissioned)
    - confirmed reachable after an internal memory swap, SSH enabled on
    a non-default port during bring-up. Added scripts/f8-ssh.sh
    mirroring ha-ssh.sh's key-then-sshpass pattern, wired to new
    f8_ssh_host/port/user/password keys in secrets.yaml (real values,
    gitignored) and secrets.yaml.example (CHANGE_ME placeholders).
    Registered in CLAUDE.md's Agent deploy helpers table.
    Live diagnostics this session (not committed, for the record):
    free -h / /proc/meminfo report the full ~46.8GB RAM recognized,
    dmesg boot log is clean (no MCE/EDAC/hardware-error entries),
    stor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
2026-09-16 Lab: Marine Board USB GPIO bring-up firmware (ESPHome web UI)
    Flash-mode OPI/octal for WROOM-2-N32R16V (DIO images stay in download
    mode). Web UI for LED/buzzer/relay/PWM ident; PWM defaults off.
    [bench_marine_board.yaml]
2026-09-16 F8 migration: point signalk settings.json at real NMEA IPs, retire Mac-interim docs (#6)
    Signal K's pipedProviders (ydwg-nmea0183, datahub-nmea0183) now point at the
    real 192.168.10.30/.31 gateways instead of the Mac-only host.docker.internal
    bridge - F8 has network_mode: host on the same LAN, no relay needed.
    Verified before this change: clean bidirectional pings F8<->HA Green,
    F8<->IoT gateway, F8<->YDWG, F8<->DataHub (0% loss, down from EHOSTUNREACH);
    signalk-server container's /proc/net/route confirmed identical to the F8
    host's own (network_mode: host genuinely shares the host netns, ruling out
    a Docker-level networking gap); a 90s clean Signal K log window showed zero
    connection error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
2026-09-16 Lab: lengthen Marine Board bench buzzer beep to 1 s
    [bench_marine_board.yaml]
2026-09-17 Lab: drive Marine Board buzzer as 4 kHz square (KLJ-4020)
    DC GPIO high is silent on this magnetic buzzer; factory firmware PWM'd it.
    [bench_marine_board.yaml]
2026-09-17 Docs+firmware: how to use the Marine Board buzzer (tones per alert)
    GPIO2 is PWM-driven via marine_board_base helpers (buzz_on / sys_buzz).
    Warning vs hard-fault use different pitches. Bench UI has warn/fault demos.
    [bench_marine_board.yaml, marine_alternator.yaml, marine_board_base.yaml]
2026-09-17 Fix HA's InfluxDB integration still pointing at the retired interim Mac
    Found during a full post-#6 verification sweep: HA's influxdb config entry
    (UI-managed since HA 2026.9, not YAML - a repo grep for the old IP never
    would have caught it) still pointed at 192.168.0.151:8086, unreachable
    since the Mac stack was retired. State was setup_retry, and F8's InfluxDB
    Sisu bucket had zero measurements - the whole HA -> InfluxDB -> Grafana
    trending pipeline was dead since the F8 migration despite Signal K/NMEA
    working fine.
    Fixed by editing HA Green's .storage/core.config_entries directly (url/
    title fields only, verified as an exact 2-field diff) + a Core restart.
    Confirmed: config entry state no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
2026-09-17 Polar log: YDEG silent = engines off; require SOG/STW above anchor swimming
    YDEG-04 on each 4JH45 goes quiet when the engine is off. Treat that as
    sailing when the YDWG is live; unknown only if the YDWG is down. Polar
    samples also need SOG or STW ≥ 1.5 kn. Point signalk_engines at F8.
2026-09-19 Saloon display: teal gradient theme + tide/moon fields (#136)
    page_home/page_wind/page_wifi were plain black-on-white LVGL default
    styling. Add a two-layer teal gradient (dark page background, lighter
    "pop" tiles per field) using LVGL's native bg_grad_color/bg_grad_dir —
    colors sampled from the Sisu Good Life Logo, darkened until white text
    clears WCAG AAA (7:1) against the lightest gradient stop; the logo's
    own lighter teal/sky-blue measured too low (2.46:1/1.71:1) to use
    directly behind text.
    page_home also gets the tide (sensor.sisu_tide_next_high/low) and moon
    (sensor.sisu_moonrise/set) rows that already existed as HA entities but
    were never wired into this device. 5 rows no longer fi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
    [saloon_display.yaml]
2026-09-19 Redo saloon display QR and teal theme (#135, #136)
    Replace the portrait 1350x1600 QR (squashed by ESPHome's 480x480
    resize, generic wifi glyph) with a square circular-module code that
    embeds the Sisu sail. Module stops stay ≥7:1 on white and decode at
    the 400x400 deploy size.
    Restyle page_home as a 5x2 caption+value tile grid (air/water, depth/AWS
    max, sunrise/sunset, tides, moon) on a near-black page with teal-rimmed
    tiles so the two-column layout actually fits the long countdown strings
    from Info.jpeg. Guard AWS max against HA's unavailable/nan. Same
    background on page_wind and page_wifi. OTA'd to 192.168.10.45.
    [saloon_display.yaml]
2026-09-19 Sisu Nav: coverage-aware bathymetry default (#101)
    Probe one BlueTopo tile at the view centre instead of trusting the huge
    Atlantic WMTS bbox. USVI/Chesapeake suggest BlueTopo; BVI/open ocean
    suggest Seascape. The Bathymetry dropdown follows that hint until Pin
    source is on; panning does not yank a pinned pick. Empty BlueTopo tiles
    now fail estimate/createJob coverage so auto-harvest will not store
    256-byte ocean cells.
    [providers.yaml]
2026-09-19 Sisu Nav: NOAA ENC harvest, Google/Azure tiles, community roses (#107, #117, #88)
    NOAA Chart Display WMTS (kind nautical) replaces the GDAL stub. ArcGIS
    default028mm uses OSM x/y at TileMatrix z-2; empty/HTML tiles are skipped.
    USVI sample harvest stores a PNG MBTiles; Virgin Gorda/Anegada probe empty.
    Google Map Tiles createSession harvest and Azure Maps microsoft.imagery
    finish #117 (Mapbox already landed). Apple Maps and retired Bing Aerial
    are harvestable:false.
    Community roses (#88) use the existing Sisu Mate Supabase project: PostGIS
    tables + RLS (public read only when boat_count >= 3). Share is opt-in and
    aggregated only; the browser never holds the service role.
    [providers.yaml]
2026-09-20 ESPHome: UART off, runtime debug 0–3, WDT + brownout reason (#134, #133)
    Production/vessel loggers use baud_rate 0 so the physical UART is silent;
    API/web logs remain. A diagnostic select (0 NONE … 3 INFO) changes
    logger level at runtime without a reflash. Marine Board IDF builds enable
    the 8 s task watchdog with panic reset and keep the brownout detector;
    reset_reason is an HA text sensor. Field PWM is still forced off on boot,
    so a WDT/brownout reset returns to field=0. Bench YAMLs keep UART.
    Not OTA’d to production boards (shadow until #11).
    [freezer.yaml, marine_board_base.yaml]
2026-09-20 Retire T8 lab bench; OPI flash on Marine Board production YAML (#11)
    Hardware on hand is the saloon display and one Marine Board prototype.
    Remove the LilyGo T8-S3 connectivity bench from agent/onboarding context
    (archive bench_t8s3.yaml). Production Port/Stbd/Levels entrypoints now
    use octal 32 MB flash + PSRAM like the real WROOM-2-N32R16V — DIO images
    do not boot this chip. Shadow remains default ON. Prototype is not on
    USB/Wi-Fi yet, so #11 stays open.
2026-09-20 HA home: Sisu Nav shortcut tile on Ship zones
    Open the F8 chart cockpit (http://192.168.0.21:8088) from the Sisu
    dashboard instead of typing the URL. Nav is not an HA view.
    [ui-lovelace.yaml]
2026-09-20 Sisu Nav: fix harvest EACCES mkdir on F8 tiles volume (#137)
    TOS bind-mounts /data/tiles as root:root 755, so USER node could not
    create bathymetry snapshot dirs. Entrypoint starts as root, chmod a+rwX
    the tiles/keys trees, then su-exec node. f8-deploy.sh pre-creates
    bathymetry/satellite/nautical and applies the same chmod.
2026-09-25 Helm: show the active route ETA (#138)
    Read Signal K course and course-provider calcValues onto the Helm page: ETA, time to go, and distance remaining. A cleared or switched course drops the previous ETA instead of keeping it.
2026-09-25 MarineBoard: new from-scratch layout; Quilter-compatible footprints
    - LCSC: nickname on all EasyEDA footprint lib IDs (board + schematic)
    - EasyEDA.pretty upgraded to current KiCad format; 3D models moved to Lib/Models
    - U10 FPC mounting tabs numbered 21/22 to match symbol
    - L2 silkscreen arcs replaced with line segments (Quilter parser rejects fp_arc)
    [MarineBoard.kicad_pcb, MarineBoard.kicad_sch]
2026-09-25 MarineBoard: min track width 0 -> 0.127 mm (Quilter rejects zero)
2026-09-25 MarineBoard: fix decoupling and capacitor ratings/footprints
    - ESP32: add C40 10uF + C41 0.1uF on new ESP_3V3 net (U8 side of ferrite L7,
    which previously had no local decoupling)
    - U23 gate driver: add C42 0.1uF/50V at VDD
    - C16/C17 on 12V buck input: 10V/6.3V 0402 parts -> 50V 1206
    (CL31B475KBHNNNE, CL31A106KBHNNNE)
    - C18/C21/C23/C26/C29: 01005 footprint -> 0402 to match their 0402 MPNs
    - C20: part fields aligned with 6.3mm footprint (RVT1A221M0605, 220uF 10V)
    Board needs Update PCB from Schematic (F8) to pick up footprint changes.
    [MarineBoard.kicad_sch]
2026-09-25 MarineBoard: ESP32 decoupling on correct side of ferrite L7
    C24/C25 were drawn as the ESP32 decoupling but wired to the +3.3V side of
    ferrite bead L7, leaving U8's 3V3 pin with no local capacitance. Rewire them
    onto ESP_3V3 (U8 side of L7) and drop the interim C40/C41 duplicates.
    C42 (U23 VDD) stays.
    Board: saved after Update PCB from Schematic (cap footprint fixes applied);
    needs one more F8 to drop C40/C41 and move C24/C25 to ESP_3V3.
    [MarineBoard.kicad_pcb, MarineBoard.kicad_sch]
2026-09-25 MarineBoard: board synced to schematic (C24/C25 on ESP_3V3, C40/C41 removed)
    DRC schematic parity now 0 issues.
    [MarineBoard.kicad_pcb]
2026-09-26 Feature Map foundation: lint.sh, check.sh, _lib.sh helpers, CLAUDE.md policy (#140)
    - lint.sh: front matter (6 keys, id == path), one sentence + Reach/Action/
    Needs/Expect/Source in order, <=25 lines, script beside + executable +
    FM_ID match, FM_MODE gate required, hard-ceiling names only in read
    scripts, orphan scripts.
    - check.sh: runs every feature script in read mode, tabulates JSON results.
    - _lib.sh: sk_get (SK login inside python, no password in argv), nav_get,
    esp_get (HA Green hop; stages the client over ssh stdin because
    ha-scp.sh breaks on macOS bash 3.2 -> #161), mqtt_peek (creds via ssh
    stdin into a 0600 options file). All live-verified.
    - CLAUDE.md: Feature Map is T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
2026-09-26 Feature Map batch 1: Home Assistant dashboards (#142–#147)
    58 feature files (md + read-only sh) across ha/{sisu,alternators,power,
    engine,water,freezer,helm,weather-twd,sources,kernel}, each verified live
    against HA Green: 53 ok, 2 skip (alternator boards offline, #11), 3 broken
    (dashboard references to non-existent entities, #163).
    Bugs found and filed: #162 (P1 stale NMEA kernel), #163, #164, #165, #166.
    wiki.py labels use index titles; lint accepts kind: service.
2026-09-26 Feature Map batch 2: network, HA cameras/trending, F8 services (#141 #148 #149 #150)
    24 feature files: net/ (networks, router, HA Green, F8, IoT hop, guest),
    ha/cameras + ha/trending, f8/signalk (server, KIP, Freeboard, REST, MQTT
    bridge, course), f8/grafana (home + 5 dashboards), f8/influx, f8/mqtt-explorer.
    All 24 scripts ok live 2026-09-26. Found: #167 (camera Sentry snapshot while
    offline). lint accepts kind: network.
2026-09-26 Feature Map batch 3: Sisu Nav (#151 #152 #153)
    27 feature files under nav/ (app, status bar, layout gear, follow me, layers,
    settings, charts basemap/harvest/imported, bathymetry, OpenSeaMap, weather,
    sky, ensemble, waves, currents, windex, roses, instruments, AIS, aircraft,
    satellites, cables, POI, route, notes, backend API). Live: 25 ok, roses 502
    and AIS disconnected recorded as broken.
    Found: #168 (Azure key in /api/config), #169 (Influx Sisu_1m missing),
    #170 (AISStream not connecting), #171 (/api fallthrough to HTML).
    f8/influx + grafana Expect lines note #169.
2026-09-26 Feature Map batch 4: ESPHome devices, third-party devices, Marine Board hardware (#154–#158)
    32 feature files: esp/alt-port + alt-stbd (index, Shadow, setpoints, fault
    clear, LED/buzzer/diagnostics — all safety-critical controls documented,
    scripts read-only), commissioning flow, bench, levels, freezer, anchor,
    saloon display (device + Home/Wind/Wi-Fi pages); ext/ (Spectra, YDWG,
    DataHub, Victron GX, SV3C cameras, OL43); hw/marine-board (overview, power,
    field output, inputs, loops/shunt, CAN/relay/I2C, USB/buttons) — docs only,
    MarineBoard/ read-only.
    Live: 17 ok, 15 skip (devices offline/not fitted). Found #172 (devices
    offline), #173 (spec lists old field-drive parts); #162 root cau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
2026-09-26 Feature Map batch 5: consistency.py + manual.py (#159 #160)
    consistency.py checks source <-> map: every HA dashboard, Sisu Nav plugin,
    /api family and ESPHome device documented; no dead navigation_path;
    dashboard entities exist in HA (live). First run fixed 15 missing plugin/API
    pointers in nav/ Source lines; remaining 17 unknown entities are #163 / #11.
    manual.py renders one branch as a crew manual (shares wiki.py's parser);
    polish follow-up #174. INDEX NEXT updated.
2026-09-26 NMEA kernel: stale values go unavailable in HA; wind path 'none' when stale (#162)
    The kernel deliberately republishes the last value with a growing stale_s
    when no source is fresh, so HA's expire_after never fired and a ~16 h old
    YDWG depth/wind/heading was shown as live (YDWG accepted TCP but sent no
    NMEA from 2026-09-25 22:40 until ~2026-09-26 14:00).
    - source_health.yaml: availability on the 17 sisu/v1 value sensors —
    offline once stale_s > 30 s (same topic, value_template on stale_s).
    - nmea_wind_daemon.py: gateway_active = source only while the AWS pick is
    fresh (<= FIELD_FRESH_SECONDS), else "none".
    - Feature Map: Expect lines updated to the new behaviour (15 files).
    Verified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
2026-09-26 Sources: freezer tile no longer stuck online (#164)
    source_freezer ORed in states('switch.freezer_compressor'), an id that does
    not exist — states() returned 'unknown', so the tile was always on. Use the
    real compressor switch only (unavailable/unknown = offline).
    Verified live: controller .44 offline → binary_sensor.source_freezer off.
    Feature Map Expect lines updated.
2026-09-26 Dashboards: fix diagnostics entity ids (#163, partial)
    HA has no text_sensor domain — ESPHome text sensors register as sensor.*.
    Reset-reason rows now sensor.<device>_reset_reason (engine, water, freezer);
    freezer debug-level/reset-reason use the device's registered prefix
    aft_cockpit_sisu_freezer_. Alternator enable/fault/debug/loop ids already
    match current firmware; they appear once the boards register (#11).
    Feature Map diagnostics files: corrected ids, SKIP while device offline.
    [freezer.yaml]
2026-09-26 SEC: remove a real shared password from OPS.md + ha-*.sh; value-based secret scan
    A single 8-char word password (reused by 12 secrets.yaml keys: Sisu/HA/AP
    Wi-Fi, HA SSH/sudo, ESPHome OTA, Signal K, InfluxDB, Grafana, cameras) was
    committed in plain text: OPS.md (Signal K login note) and as a hard-coded
    fallback in scripts/ha-cli.sh, ha-deploy-config.sh, ha-kernel-mqtt.sh.
    Pattern-based scans (gitleaks, scan_secrets.sh) missed it.
    - Scripts now fail with a clear message if ha_ssh_password is missing
    instead of falling back to a literal password.
    - OPS.md points at secrets.yaml instead of quoting the credential.
    - scan_secrets.sh: new value-based check — every secrets.yaml value (8+
    ch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
2026-09-26 Cameras: no snapshot bookkeeping while the camera is offline (#167)
    HA silently skips camera.snapshot on an unavailable camera, so the Sentry
    timed/motion automations still moved last-snapshot time and reason. Both
    automations on both cameras now require camera.<x>_mainstream available.
    Verified live: aft camera offline in Sentry — the 19:45 UTC tick left the
    last snapshot at 19:40 and did not trigger.
2026-09-26 Influx: create Sisu_raw/Sisu_1m + downsample tasks on the F8 (#169)
    influx-sisu-views.sh still targeted the retired Mac container, so after the
    F8 move (#6) the buckets and tasks were never created — Sisu Nav wind roses
    502'd and Grafana >=1 h panels were empty. Script now defaults to the F8
    influxdb container (uses its built-in operator config; no token leaves the
    Mac), --org only where accepted; Mac mode kept for rollback. Run on F8:
    buckets created, sisu_1m + sisu_raw_mirror active and succeeding every
    minute, /api/roses 200. Feature Map roses back to live.
2026-09-26 License: add Apache-2.0 LICENSE (confirmed by Frik); README scopes third-party libs (#176)
    LICENSE is GitHub's canonical Apache-2.0 text (unmodified, so GitHub
    detects it). README states vendored KiCad/EasyEDA/JLCPCB/Espressif
    libraries and npm deps keep their own licenses.
2026-09-26 Docs: field-drive parts match the schematic — MCP1407 + BUK762R4-60E (#173)
    Technical Specs.md (GPIO map row + PWM output table), INSTALLATION.md and
    Technical Specifications.md named the old TC4427 / IPL60R075CFD7 path.
    Parts taken from the schematic netlist: R29 → U16 PC817 → U23 MCP1407 →
    Q4 BUK762R4-60E, R40 gate pull-down, D8 VS-43CTQ100S freewheel, R31/C36
    snubber, F3 15 A. MarineBoard/production/ exports (BOM, positions, ERC)
    are from the previous revision and are left for the next KiCad release.
2026-09-26 INDEX: #137–#176 batch done; remaining issues human/vessel-gated
2026-09-27 Wiki: Marine Board schematic images on the hw/ pages
    image: now takes repo-relative paths (pointer to MarineBoard/Documentation/
    exports, not copies) and comma-separated lists; lint checks each file, the
    wiki copies them under URL-safe names. Each export was checked against the
    current schematic netlist; only matching ones are used (PWM, RPM, ESP32,
    FSPI, CAN, relays, levels, battery monitor, 3V3, LEDs/buttons). New page
    hw/marine-board/display-headers (J2 QSPI display, H6/H7). Stale exports and
    the Technical Specs display/J3 mismatch filed as #177.
2026-09-29 MarineBoard: routed 4-layer board, PCBWay fab package, spec v1.8 (#178)
    Board
    - Fuses sized to copper: F1 2 A, F3 10 A, new F4 10 A on relay common
    - CN2 label fixed (PWM1 vs PWM split left the field open)
    - Power nets named; net classes <ROLE>_<V>_<A>; MarineBoard.kicad_dru
    current-width rules + PCBWay-only limits; board rules = stricter of
    project vs PCBWay (clearance 0.127, ring 0.15, hole-to-hole 0.28 ...)
    - Edge.Cuts 83.0 x 67.5 mm; duplicate vias removed; GND stitching,
    Q4-source and D8 thermal via arrays; vias moved out of small pads
    - U10 (SM10B-GHS-TB) consolidated into Lib/EasyEDA (LCSC lib); stray
    root EasyEDA library removed
    Fab / docs
    - production/: 4-layer Gerbers + dr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
    [MarineBoard-BOM.csv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]
2026-09-29 MarineBoard: RPM input sized for phase-lead tap (#26)
    R16 47k -> 10k 1W (25121WF1002T4E), R48 10k -> 47k (C25792); same
    footprints, Gerbers unchanged. With the 47k/47k divider the PC817 got
    ~0.1 mA from a +/-7.5 V AC-coupled phase signal - no reliable pulses.
    Now ~0.5 mA, U22 saturates; 100 V fault ~4 mA LED / 0.15 W in R16.
    BOM + positions regenerated. INSTALLATION 6.3.7 (v1.10): rev 2 taps a
    phase lead, as-built circuit table; Technical Specs RPM row.
    [MarineBoard-BOM.csv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]
2026-09-29 MarineBoard: R16 part = C25718 (10k 1W 200V 2512) (#26)
    [MarineBoard-BOM.csv, MarineBoard.kicad_pcb, MarineBoard.kicad_sch]
2026-09-29 MarineBoard BOM: loose MINI blade fuses (2A/1A/2x10A) + JP1 shunt for PCBWay assembly
    [MarineBoard-BOM.csv]
2026-09-29 MarineBoard: fill missing MPNs (J1, R6, C16, C17 + SUPPLIERPART copies for Q2/Q3, D2/D3, L3/L4/L6)
    [MarineBoard-BOM.csv, MarineBoard.kicad_pcb, MarineBoard.kicad_sch]
2026-09-29 MarineBoard: PCBWay assembly uploads as xlsx (BOM with SMD/THT/LOOSE type, centroid)
    [MarineBoard-BOM.xlsx, MarineBoard-positions.xlsx]
2026-09-29 MarineBoard: U10 display/spare-GPIO guidance, re-export power sheet (#177)
    Technical Specs v1.9: board is not a display host, but U10 (JST-GH
    SM10B-GHS-TB) takes a small SPI display or serves as spare GPIO;
    pins are unprotected straight-from-ESP32 with no pulls, 3.3 V max.
    POWER AND FILTERING 12V_5V.png re-exported from the current schematic
    (D14 SS56, F2 after L6); changed components.png WIP screenshot removed.
2026-09-29 MarineBoard v1.9: RGB status LED, vertical CN4 display header, logo, fab package (#179)
    - D17 plain LED -> D5 WS2812B-2020-V6 (C52917434) on GPIO1, VDD +5V_VCC,
    C40 decoupling, R34 100R on DIN
    - U10 right-angle GH on the bottom -> CN4 vertical BM10B-GHS-TBT on top
    (pinout unchanged); all fuses/connectors on top; GND stitching reworked
    - Sisu logo + "MARINE BOARD v1.9" silk (LOGO1), RESET/FLASH labels
    - Libraries consolidated back into Lib/ (root EasyEDA.* retired), CN4
    courtyard now covers its leads, L2 footprint attr THT -> SMD
    - fab_package.py rebuilds production/ (DRC gate, gerbers/drill/IPC zip,
    BOM + centroid CSV/XLSX with LOOSE rows); stale production files removed
    - Technical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
    [MarineBoard-BOM.csv, MarineBoard-BOM.xlsx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]
2026-09-29 ESPHome: RGB status LED on all Marine Boards; freezer moves to Marine Board (#180)
    - marine_board_base: GPIO1 is now the WS2812B-2020 (D5) via
    esp32_rmt_led_strip with explicit timings for D5's window; the HA
    "Status LED" switch is kept (drives the RGB in id(sys_led_color)), new
    "Status LED brightness" number; default heartbeat for boards whose role
    does not own the LED (levels): green OK / blue API down / red error
    - marine_alternator: colour per existing led_mode (blue idle, green
    charging, amber warning, red fault, purple shadow); blink patterns and
    buzzer unchanged
    - New freezer_marineboard.yaml: same name/IP/API key/entities as the
    LilyGo build; DS18B20 on TMP1, compressor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
    [freezer_marineboard.yaml, marine_alternator.yaml, marine_board_base.yaml]
2026-09-29 Mac = single source of truth for HA Green + F8; drift check + reconcile (#181)
    - CLAUDE.md rule 12 / AGENTS.md / OPS.md §6: all stack files start on the
    Mac -> commit -> push; never edit on a box; box-side edits are pulled
    into the Mac first; box runtime state is never pushed over
    - scripts/stack-drift.sh: Mac vs HA Green (sha256) and F8 (rsync dry run)
    report, ignoring runtime state; wired into the deploy steps + checklist
    - f8-deploy.sh: stop pushing over Signal K runtime state (serverState,
    applicationData, appstore-cache, security.json)
    - Pulled from HA Green: ESPHome Device Builder .gitignore, HA stock
    inverted_binary_sensor blueprint; mosquitto.conf final newline
    - Reconcile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
2026-09-29 README: 'What runs where' overview — Mac, HA Green, F8, Marine Boards, other devices (#182)
2026-09-29 Secret guards on every public surface: hooks, agent hook, public audit (#175)
    - scripts/secret_values.py: one collector for all local secret stores
    (secrets.yaml x2, .env, Signal K security.json, HA credentials), read
    from the main checkout so git worktrees are covered; index/msg/range/
    text scan modes that print key names only
    - .githooks/: pre-commit (scan_secrets.sh), commit-msg, pre-push over every
    outgoing commit's message + diff; scan_secrets.sh now fails if
    core.hooksPath is not .githooks on a checkout that holds secrets
    - scripts/claude_hook_no_secrets.py + .claude/settings.json PreToolUse:
    blocks a command or posted --body-file containing a real value
    (issue/PR text ha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
2026-09-30 risks: R7b accepted risk — cached pre-purge commits, conditions to keep it safe (#175)
2026-09-30 MarineBoard spec: vias resin-filled + copper-capped (POFV) per PCBWay order
    PCBWay flagged via-in-pad on the thermal arrays; chose fill + cap on all vias
    (same fee as pads-only) instead of rerouting.
2026-09-30 MarineBoard order sheet: via process = resin filled + copper capped (POFV)
    Matches the PCBWay reply and Technical Specs vias row (d1acd5c).
    [PCB Manufacturing Process Specification.xlsx]
2026-10-01 MarineBoard v1.9.1 pre-fab fixes: U3 ENA float, 50V caps, polymer C20 (#183)
    - U3 TPS5430 ENA (pin 5) disconnected from VIN_BUCK (7 V abs max) and left
    floating per TI; schematic wires + PCB stub removed, no-connect added.
    - C11/C12/C14/C19/C42 -> CL05B104KB5NNNC (50 V; were 16 V on 12 V/bus nets),
    C33 -> 1 uF 50 V GRM155R61H105KE05D (was 4.7 uF 10 V on +12V BAT).
    - C20 -> Panasonic 10SVPE220M 20 mOhm polymer: 15 uH + 220 uF <=40 mOhm is
    TI's internal-compensation reference; the copied ceramic-cap network
    C21/C22/R13/C23 (TI Fig 7-11, 3.3 V/100 uF design) is now DNP.
    - Order sheet File Name -> MarineBoard-PCBWay-Gerbers.zip.
    - Fab package rebuilt; DRC (schematic parity) and ERC uncha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
    [MarineBoard-BOM.csv, MarineBoard-BOM.xlsx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]
2026-10-02 MarineBoard 1.9.1 schematic: U23 on +12V, D5 via D21, test pads, CAN GPIO5/6 (#183)
    Human edits (KiCad): buck add-on network removed, U2 VBUS tied to Vin+
    (high-side shunt) with series C10 removed, D17 SS14 buzzer flyback,
    CAN moved to GPIO5 TX / GPIO6 RX.
    Agent edits:
    - U23 MCP1407: pin 8 had been moved to +5V_VCC while pin 1 stayed on
    +12V BAT (both are VDD -> rail short; and 5 V gate drive is too low for
    standard-level Q4). Both VDD pins + C33 now on protected +12V.
    - D5 WS2812B VDD fed through D21 1N4148W (~4.35 V) so 3.3 V data meets VIH;
    PWR_FLAG on the new VDD node.
    - TP1-TP6 bare 1.5 mm pads (no BOM/pos): GND, +12V, +5V_VCC, +3.3V,
    PWM_GATE, VSENSE; U3 feedback node labelled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
    [MarineBoard.kicad_sch]
2026-10-02 MarineBoard 1.9.1: routed PCB + fab package rebuilt (#183)
    PCB updated from the d7f7e75 schematic and routed (human): D17 buzzer
    flyback, D21 D5 VDD diode (bottom), TP1-TP6 test pads, U23 VDD on +12V,
    U2 VBUS=Vin+, CAN on GPIO5/6; removed C10/C21-C23/R13.
    fab_package.py green: DRC errors 0, unconnected 0, schematic parity 0
    (8 silkscreen warnings only). BOM/positions: D17/D21 in, TPs and removed
    parts out. Ready for PCBWay re-upload.
    [MarineBoard-BOM.csv, MarineBoard-BOM.xlsx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]
2026-10-02 Sisu board: Shortcuts panel for all F8 web UIs; Sisu Nav moved there (#184)
    New Shortcuts section on the main view (Sisu Nav, Signal K, KIP, Grafana,
    InfluxDB, MQTT Explorer, tileserver-gl), url tap_actions, F8 URLs kept in
    this one section. Feature map: new ha/sisu/shortcuts pair; Ship zones updated.
    [ui-lovelace.yaml]
2026-10-03 Group sailor zone folders by the product in the name (#186)
    Keep tiles/manual/<place>-<product>-<date>/. Bing joins Azure, ArcGIS joins Esri, and Google satellite joins Google. Navionics sonar stays its own row. Import all reads the kind from the name.
2026-10-03 Sisu Nav: Follow me on the boat LAN uses HTTPS :8443 (#188)
    Browsers only share this device's GPS on a secure page. HTTP :8088 stays as it is and links to the self-signed listener, which proxies Signal K and the tile server on the same origin.
2026-10-03 Back out #189 doc hunks swept into 940e819
    940e819 (#187) staged whole USER_GUIDE.md / DEVELOPER.md while another
    agent had uncommitted #189 (charts bands) edits in them. Restores those
    hunks to their pre-940e819 text in git; the #189 working-tree edits are
    untouched for that agent to commit with its code.
2026-10-03 Sisu Nav: hide saved-chart boxes until Layers is on (#191)
    The gold rectangles are the footprints of the saved chart files.
    They now draw only when Saved chart coverage is switched on.
2026-10-04 HA: Reinit buttons for the SV3C cameras after a power cycle (#192)
    Power-cycling a camera leaves ONVIF in setup_retry, and HA can keep
    the stream entity idle after the camera is already unplugged. The
    button reloads that camera's config entry until the stream is back,
    then sets the clock.
2026-10-04 HA: the connected SV3C is now the forward camera (#193)
    The unit at 192.168.0.33 (MAC F0:00:00:40:4E:96) was Aft. It is now
    Forward, and the other unit at 192.168.0.34 is Aft. Entity ids stay
    the same; the ONVIF entries follow the MAC.
2026-10-06 Spectra: Autostore on page 10 is not "running" (#165)
    Page 10 is both the SYSTEM STARTING countdown and the idle AUTOSTORE MODE
    screen. is_running(), normalize() and the HA template fallback all listed
    page 10 as running, so the Sisu/Water boards showed the watermaker running
    for days in storage. Page 10 now counts as running only when it isn't the
    Autostore screen.
    go_home() and the autorun navigation keep leaving that screen alone, as
    before: how to leave Autostore for a run (MENU? CANCEL?) is not confirmed
    on the real unit, so no new button presses are sent from it.
2026-10-06 Dashboards: use HA area+device names for board diagnostics (#163)
    Live HA builds ESPHome entity ids from area, device friendly name, and
    entity name. The freezer temperature entity already shows that. Alternator
    and levels diagnostic rows, plus the fault-latched rows, still used the
    ESPHome node name, so they would never resolve. Freezer diagnostic ids
    were already right. Confirm when the boards and freezer are online.
2026-10-07 Sisu Nav: Supabase at user level — sign in as the boat, no service role (#187)
    Sisu Nav now uses the SisuMate project the way the app does: it signs in as
    the boat's own Supabase user (supabase_email / supabase_password + the
    publishable key), resolves the boat via accessible_boat_ids(), and every
    read/write goes through RLS. The service-role key is gone — the box can
    only touch boats that login owns or crews on.
    - 002: anchor_spots / anchor_rose_hours get crew read+write (not read-only).
    - 003: community roses user-level. Each boat upserts its own
    wind_rose_uploads rows (boat_id = boats."supabaseId", RLS per boat); a
    security-definer trigger merges all uploads of a cell into the pu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
2026-10-09 MarineBoard: enclosure, PCBWay delivery, 5-unit BOM (#194)
    Enclosure: printed PA12 box 129.4 x 107.9 x 44 mm, built by a parametric
    FreeCAD script (enclosure/make_enclosure.py; fit_board.py checks the KiCad
    board STEP against it). IP67 panel connectors with engraved legends
    (EW-LP20 power/PWM, M12-5 CAN, 12G for TMP/RPM/ENBL, relay, shunt,
    levels), 2 mm silicone-cord seal, D5 light pipe, 4 x M3x6 board and
    4 x M3x10 lid screws, no USB opening (flash before boxing, then OTA).
    STEP + STL exports, FreeCAD docs, render, and the PCBWay print/parts
    order sheet. Documented in Technical Specs -> Enclosure; README,
    INSTALLATION section 8.3 and Technical Specifications point to it.
    Also: PCBWay's 15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
    [Assembly.DXF, Assembly.STEP, BOM_PCBWay.xlsx, Bottom Housing.DXF, Bottom Housing.STEP, CN3.STEP, Enclosure Connector model and purchase link—10.9.xlsx, MarineBoard-BOM-5units-2026-10-09.xls]
2026-10-12 Factory: verify/claim gates as scripts, independent reviewer, skills (#195)
    The task loop in CLAUDE.md was 400 lines of prose that every agent ran from
    memory. The checks are now scripts, the procedure is in skills, and CLAUDE.md
    keeps the rules (181 lines).
    - scripts/verify.sh: changed paths -> checks (secrets, esphome config for every
    entry that includes a changed package, compose, HA YAML, Sisu Nav tsc/node,
    feature-map lint), Touches drift, live probes. Exit 3 = green but an HA
    Green/F8 deploy is still owed.
    - scripts/next-issue.sh, claim.sh, release.sh (_issue_lib.py): claim refuses
    Touches overlap, an owned hotspot or a bad pair; the tables are data there.
    - .githooks/commit-m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
2026-10-14 MarineBoard enclosure: printable connector legends (#197)
    PCBWay would not print the old legends: 2.2 mm Arial was 0.25 mm per
    stroke and 0.55 mm deep, under their 0.7 mm minimum for both.
    Legends are now one pin name per line, first pin on top, in Arial Black
    at a 3.5 mm cap height, cut 0.8 mm deep. The LP20 legend goes to the
    right of its hole because the wall above it is only 7.3 mm. The build
    now checks legend-vs-legend and legend-vs-hole clearance as rectangles.
2026-10-14 MarineBoard enclosure: lid ribs and mounting flanges (#198)
    PCBWay warned that the flat 3.2 mm lid will deform in printing and
    shipping, and it has to press evenly on a cord seal that stands 0.7 mm
    proud. The lid now has a 2 x 2 grid of 2 mm ribs, 5 mm deep, inside the
    locating lip. The ribs stop at z 35.8, above the tallest board part at
    z 26.4.
    The bottom gets a 4 mm flange along the north and south walls, 14 mm
    out, with four 4.5 mm holes (M4 or #8) placed 15 mm from the ends so
    they stay clear of the south-wall plugs. Footprint is now 129.4 x 135.9.
2026-10-15 Answer PCBWay's T-1P19 questions and fit the fuses and shunt
    PCBWay inserts the MINI fuses into F1-F4 and fits the 1.27 mm shunt on JP1. F2 is Eaton ATM-1 because Littelfuse 0297001.WXNV is not a real part. Descriptions for D2/D3, D5, D21, R5/R6 and R47 match the replies.
    #199
2026-10-15 Use Eaton ATM fuses for F1 through F4
    F1 is ATM-2, F2 stays ATM-1, and F3 and F4 are ATM-10. Littelfuse MINI starts at 2 A, so the PCBWay reply now asks for one brand. Ratings stay 2 A, 1 A, and 10 A.
    #200
2026-10-18 Watermaker: plan to replace the Spectra Connect controller (#201)
    The Spectra board's flush relay has failed. The plan covers the Newport
    400c I/O read from the manual and wiring drawing WS4, the nominal ranges
    and fault logic, which sensors to swap for off-the-shelf parts, the
    daughter-board blocks and BOM, the firmware state machine and limits, and
    a phased migration. INDEX.md links it for every agent. Phase issues:
    #202, #203, #204.
2026-10-18 MarineBoard: PCBWay BOM reply, enclosure fit model and wall views, US supplier notes (#194)
    The latest PCBWay assembly BOM exchange (15 and 17 Oct), the updated
    enclosure fit model with its three wall views, and a short list of
    US-based alternatives to PCBWay for the board and the alternator
    brackets.
2026-10-19 Supply chain: pin Actions to SHAs, lock Signal K plugins, record vendored card (#211)
    - GitHub Actions pinned to commit SHAs (checkout v4.4.0, setup-python
    v5.6.0, setup-node v4.4.0).
    - homeassistant/signalk/package-lock.json matches the installed plugins;
    all packages come from registry.npmjs.org with integrity hashes.
    - homeassistant/www/community/README.md records config-template-card 1.3.6
    (byte-identical to the upstream release) and why its eval is accepted.
    - cyber-check: dependency advisories the owner accepts (private file)
    report as LOW; an unaccepted or non-GHSA advisory stays HIGH.
2026-10-19 F8: pin container images by digest, run Signal K unprivileged (#209)
    Every compose image is pinned to the digest the F8 was running (Signal K
    2.32.0, Grafana 13.2.2, InfluxDB 2.9.1, tileserver-gl 5.6.0,
    mqtt-explorer), so an upstream push can no longer change the boat's stack
    on a restart. Dockerfile bases are pinned the same way. Signal K drops
    privileged: it maps no devices and its providers are TCP only. Deployed;
    all services healthy.
2026-10-19 Marine Boards: per-board API encryption keys and web login (#208)
    The production Marine Boards ran the ESPHome API unencrypted and their web
    pages without a login. Each board (alternator port/starboard, levels) now
    has its own API key, and every Marine Board web page asks for user sisu /
    marine_board_web_password. esphome_web_client.py sends the login and the
    feature-map hop re-stages it on Green each call. OTA and hotspot passwords
    are unchanged (owner decision). Boards are flashed when they are back on
    the LAN; production OTA after human review.
2026-10-19 Axiom takeover plan: Freeboard-SK radar first, 12 V edge box, sonar routes (#212)
    Second research pass on the Raymarine Axiom plan:
    - Radar appears in Freeboard-SK (already on the F8's Signal K) as soon as
    mayara runs, before any Sisu Nav code.
    - A 12 V edge box on RayNet + LAN is the recommended host; it avoids TOS
    USB NIC drivers and keeps radar up with the inverter off.
    - Sonar: S1 captures the Axiom's own sonar page into a Sisu Nav panel
    (Miracast or HDMI → capture stick → go2rtc MSE → authenticated proxy);
    S2 adds an own echosounder (Cerulean S500 or Ping2) with a waterfall
    and a second depth source; S3, decoding RayNet sonar, stays unsolved.
    - New services stay off the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
2026-10-19 Axiom plan: MFD-free sonar, phase out Axiom and Garmin (#213)
    Owner decision 2026-10-19: move away from the Axiom, Axiom Pro and Garmin
    plotter; they stay as backups until they fail and nothing new may depend
    on an MFD. The RealVision transducer (ran dry at a haul-out) and Garmin
    Panoptix are dead; the depth sounder works.
    Sonar becomes F1, EchoPilot FLS 3D forward-looking with its HDMI captured
    into Sisu Nav, and optional D1, open-data down/side sonar drawn by Sisu
    Nav. Radar DHCP without the Axiom (Phase 5) is now required; Phase 7
    retires MFDs as they fail. Adds a haul-out rule: sonar ping off before
    lifting.
2026-10-19 Axiom plan: Omniscan evaluation and a Wi-Fi radar proof of concept (#214)
    Evaluates Cerulean Omniscan 450 FS, 450 SS and 3D 450 SS against the
    EchoPilot FLS 3D. All Omniscans have a public protocol and SonarView/
    SonarLink. The single-channel 450 FS looks weak as a forward-looking
    navigation sonar (inferred); whether the 16-channel 3D unit works
    forward-mounted is a question for Cerulean. Adds Phase 1a, a no-purchase
    radar proof of concept with mayara on the MacBook over the Axiom's Wi-Fi
    (#215), and a dock transmit-safety note.
2026-10-20 Marine Board v1.00: record the prototype aboard and its errata (#216)
    The first build (PCBWay delivery 2026-08-15) is aboard and becomes the
    freezer controller. Its KiCad files go in MarineBoard/v1.00/, identical
    to the delivery copy. The spec lists its errata against v1.9.1: INA226
    VBUS behind C10 (bridge it), U3 EN tied to 12 V, plain LED on GPIO1,
    CAN on GPIO43/44, U15 gate driver on raw +12V BAT. Alternator
    commissioning (#11) now waits for v1.9.1 boards.
2026-10-20 Freezer split: Marine Board v1.00 controls, LilyGo only displays (#217)
    The v1.00 prototype runs freezer_marineboard.yaml (probe, thermostat,
    compressor relay) as device "freezer" at .44, so HA keeps its entities.
    The LilyGo S3 AMOLED gets freezer_display.yaml at .47: the same screen
    and touch UI, no I/O. It mirrors the controller through HA and sends
    taps as climate.* actions; it shows NO HA or CTRL OFF when a link is
    down, and the fridge keeps running. The combined freezer.yaml moves to
    archive/. New display secrets are mirrored in secrets.yaml.example.
    Docs, rules and the feature map describe controller + display.
2026-10-20 Marine Board v1.00 prototype retired after U3 failure (#218)
    U3, the 5 V TPS5430 buck, burnt during freezer bring-up on 2026-10-20.
    That matches the EN-over-abs-max erratum; the root cause is not
    confirmed. With no Marine Board aboard, the freezer runs manually on
    its own thermostat until a v1.9.1 board is fitted. The #217 split stays
    the target, without the C10 rework step. Risk R37 is removed; R13 now
    covers the offline LilyGo that still holds the combined build.
2026-11-02 Document the Weekender freezer replacement plan (#220)
    The National Luna display board is holding the Danfoss 101N0500 thermostat loop closed. The plan records the Marine Board wiring, full speed on the relay NC contact if the ESP is dead, why the PWM MOSFET cannot switch that loop, and an ESP-NOW link so the LilyGo works with no Home Assistant. The firmware is unchanged and still energises the relay to run.
2026-11-02 Weekender freezer runs at full speed or stops (#221)
    GPIO7 high opens the U12 NC contact and stops the Danfoss 101N0500. GPIO7 low leaves that contact closed through 1,523 ohm, so a dead ESP runs at 3,500 rpm. Eco is not in this firmware.
    The LilyGo reads the controller over encrypted ESP-NOW and uses HA after that link has been quiet for about 10 seconds. A firmware battery cut-out stops at once, including a sag under 9.5 V, and the three-minute minimum off still applies before the next start. The Freezer Compressor switch reports that run state and does not drive the relay.
    Not flashed. The v1.9.1 boards are not fitted. Wire the thermostat loop to NC only after this image is on the board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
2026-11-05 Rotate the shared ESPHome OTA password (#223)
    ota_password had the same value as the published boat password in R7b.
    On the owner's decision of 2026-11-05 it now has its own random value on
    the Mac and HA Green. The other R7b keys are unchanged. secrets.md now
    lists the boards that actually use this key.
2026-11-06 Save the Marine Board design-rule pass
    Sheet screenshots now live in Documentation/Schematics, with the design-rule notes, component datasheets, and the 24 October findings report. The schematic, BOM, and enclosure saves from that pass are included. The Axiom plan follows the manuals index: Garmin Panoptix PS51-TH, no Raymarine sonar listed, CAM220IP on RTSP.
    plan.md drops the area count on the Navionics chart row. The import docs no longer mention a chart-cache decoder.
2026-11-06 Convert Navionics folders into one set per chart layer (#225)
    T08 .nv2, T32 .s57, MBM .nv2, and lsc .lsd land in navionics-sonarchart, navionics-s57, navionics-nautical, and navionics-live-sonar for the month. Live Sonar files become zoom-15 PNGs. The other three are recorded and not drawn.
