Cadburies/SisuAssistant/(notices)

Notices in the files:
MarineBoard/README.md:
License: MIT
sisu-nav/DEVELOPER.md:
`hazards/` | `GET /cables` | Anchoring hazards — submarine cable + landing-point GeoJSON, fetched live (not bundled), 30-day in-process cache with stale-serve-on-failure | TeleGeography's public API (keyless; CC BY-NC-SA 3.0)
